AlfonsusGiovanni/Welding-Arm-Manipulator/Dokumen Perancangan/Perancangan Case Teach Pendant.docx

PERANCANGAN CASE TEACH PENDANT

ROBOT WELDING ARM MANIPULATOR 6-DOF


Dirancang Oleh :

Alfonsus Giovanni Mahendra Putra / Teknik Listrik Industri / 40040621650042

DEPARTEMEN TEKNOLOGI INDUSTRI

FAKULTAS SEKOLAH VOKASI

UNIVERSITAS DIPONEGORO

2024

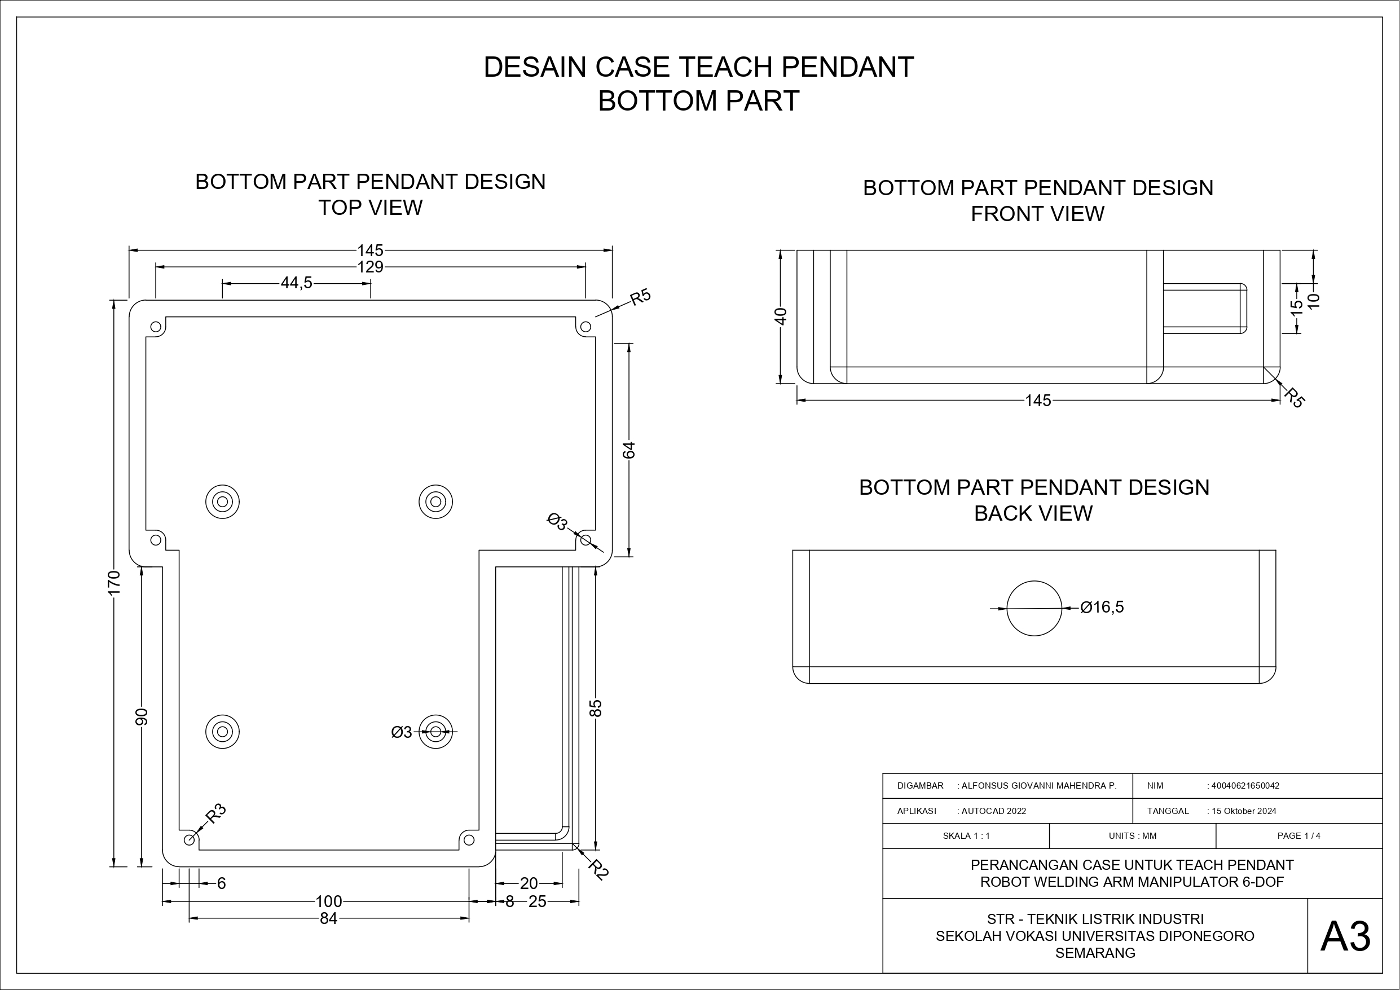
[picture p14: figure]
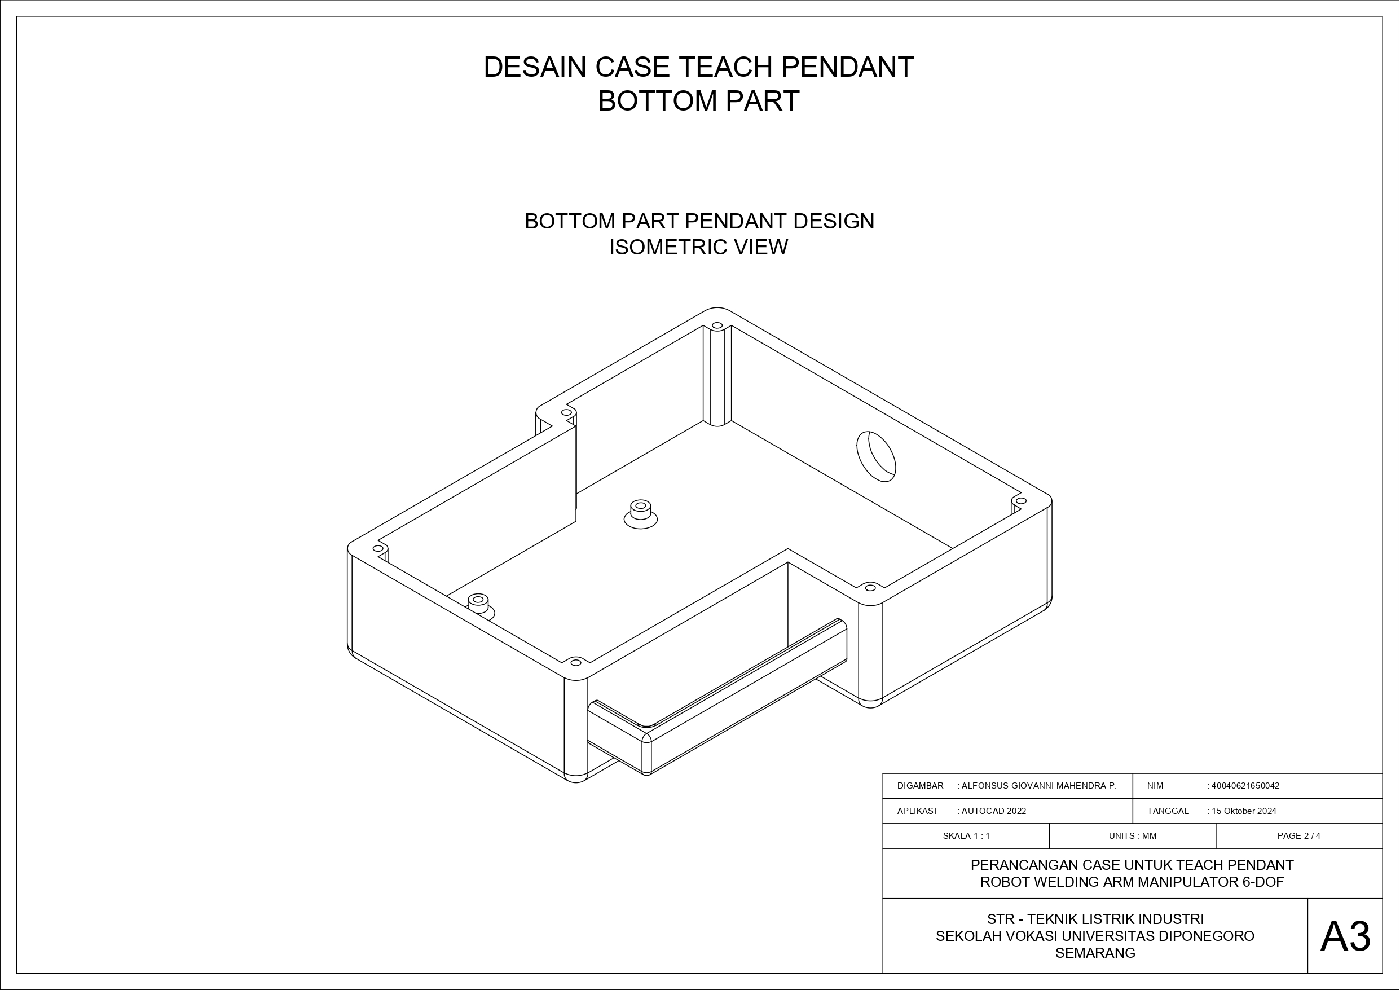
[picture p15: figure]
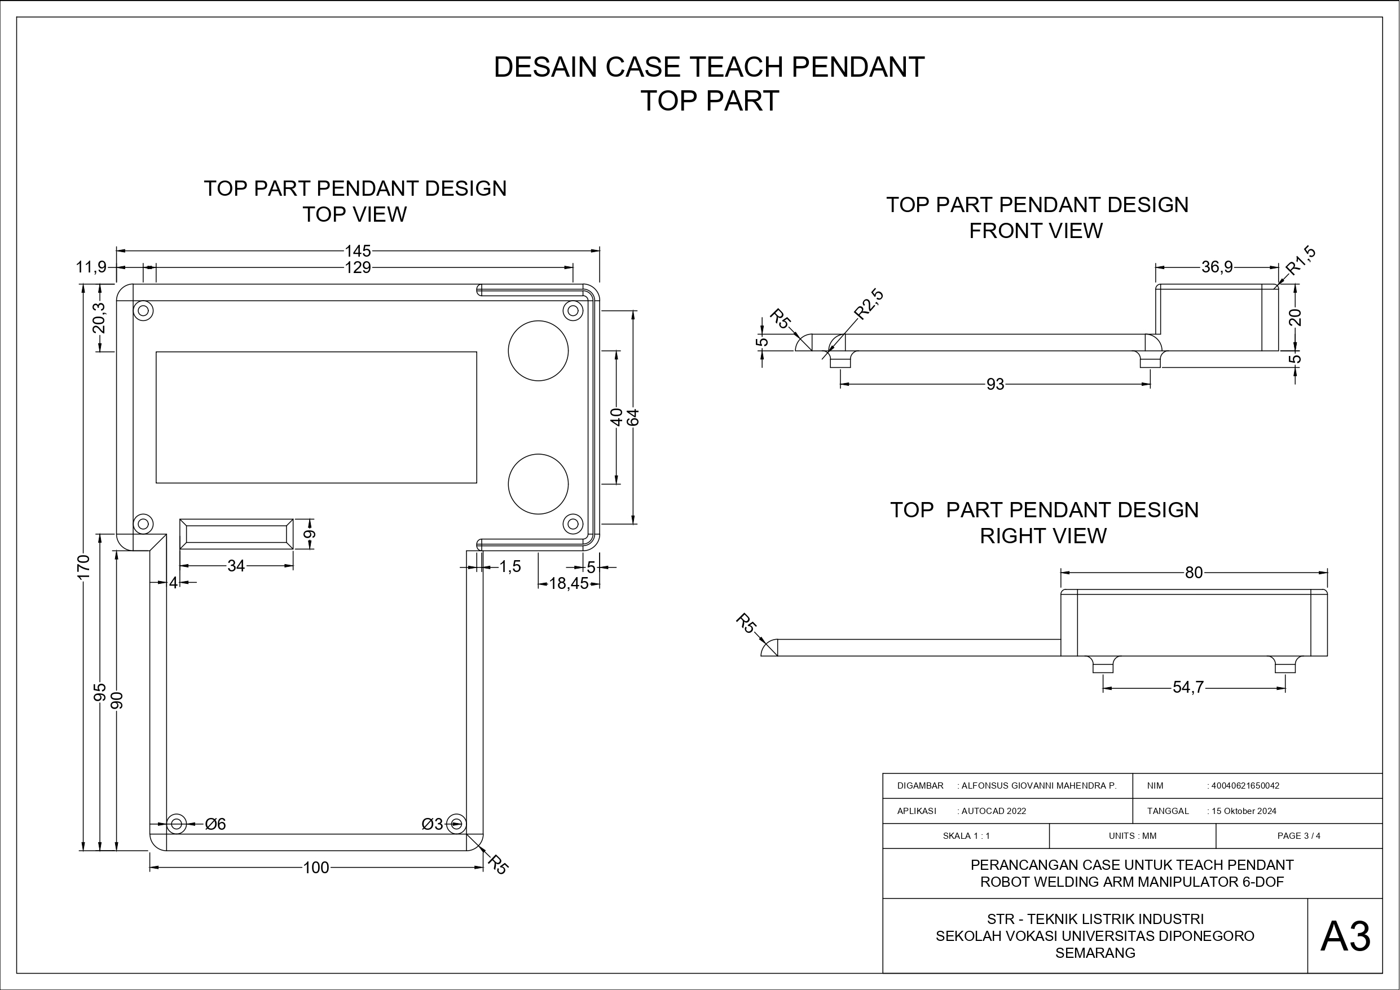
[picture p16: figure]
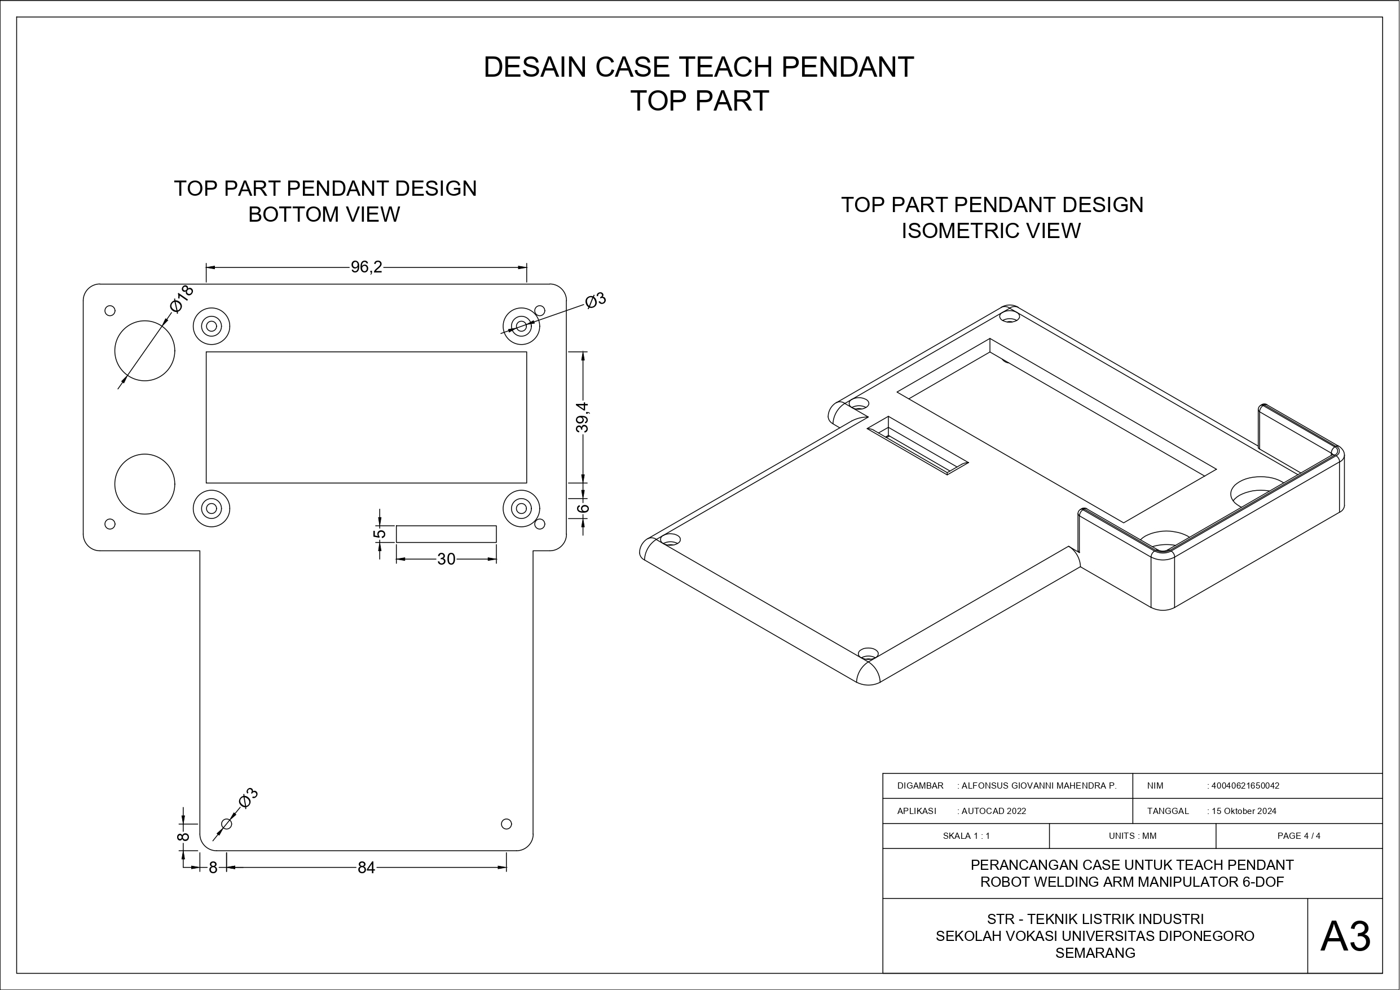
[picture p17: figure]
