AlfonsusGiovanni/Welding-Arm-Manipulator/Dokumen Perancangan/Perancangan PCB.docx

PERANCANGAN PCB

ROBOT WELDING ARM MANIPULATOR 6-DOF


Dirancang Oleh :

Alfonsus Giovanni Mahendra Putra / Teknik Listrik Industri / 40040621650042

DEPARTEMEN TEKNOLOGI INDUSTRI

FAKULTAS SEKOLAH VOKASI

UNIVERSITAS DIPONEGORO

2024

PCB KONTROLER UTAMA

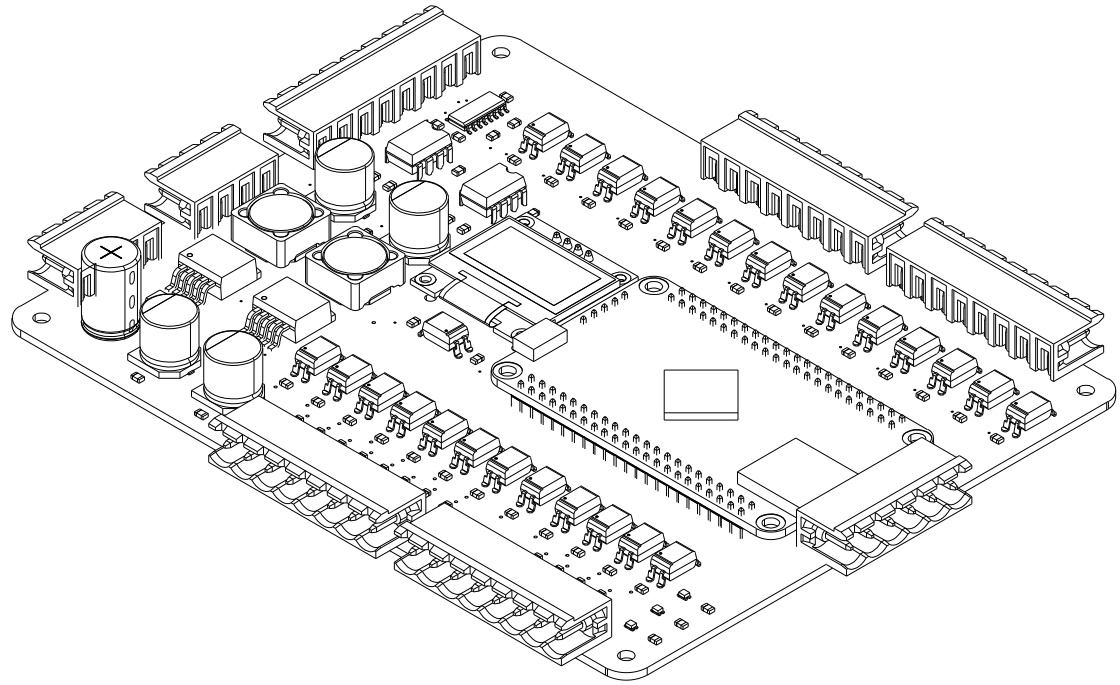
[picture p18: figure]

Spesifikasi:

2. Microcontroller STM32H743VIT6
3. 24VDC Supply
4. 5VDC and 3,3VDC Output
5. Dual Emergency Stop
6. 18 Channels Digital Input
7. 12 Channels Digital Output
8. RS-232 Communication
9. OLED LCD Interface

SCHEMATIC DIAGRAM PCB KONTROLER UTAMA

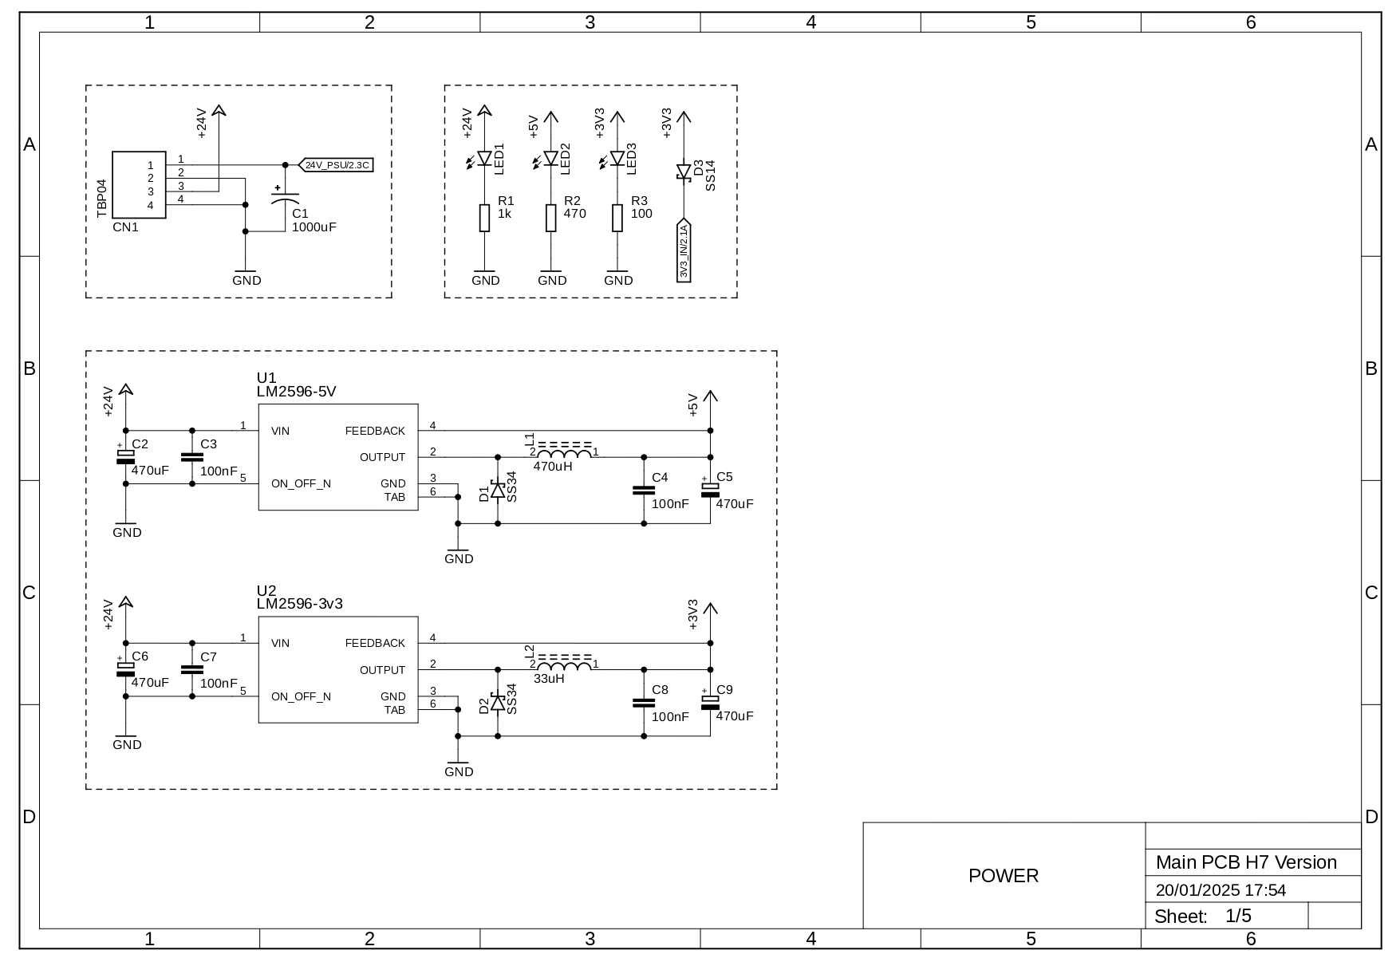
[picture p19: figure]

SCHEMATIC DIAGRAM PCB KONTROLER UTAMA

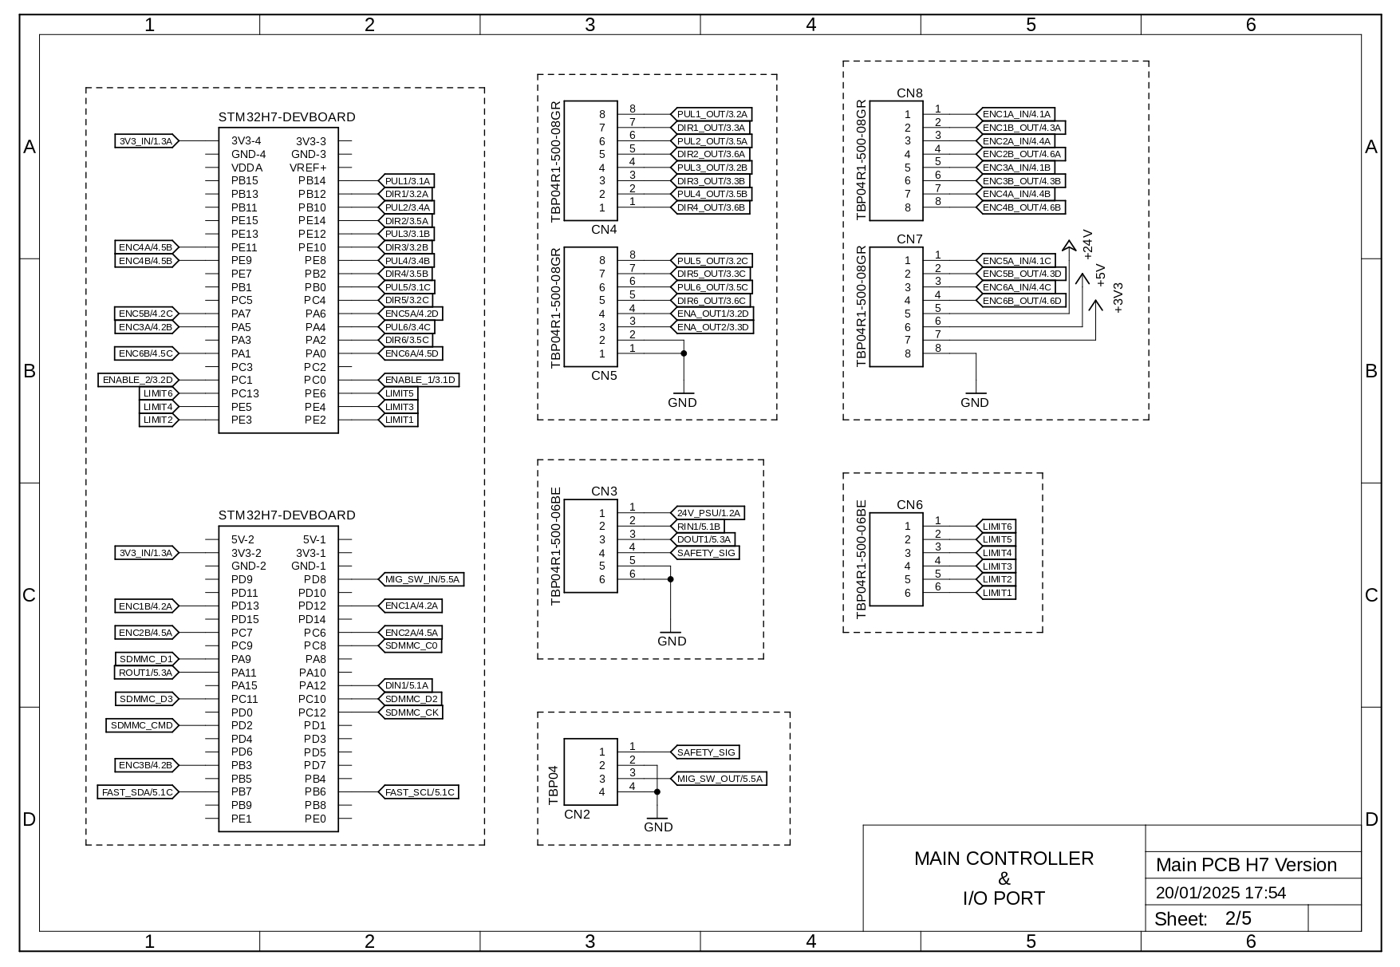
[picture p20: figure]

SCHEMATIC DIAGRAM PCB KONTROLER UTAMA

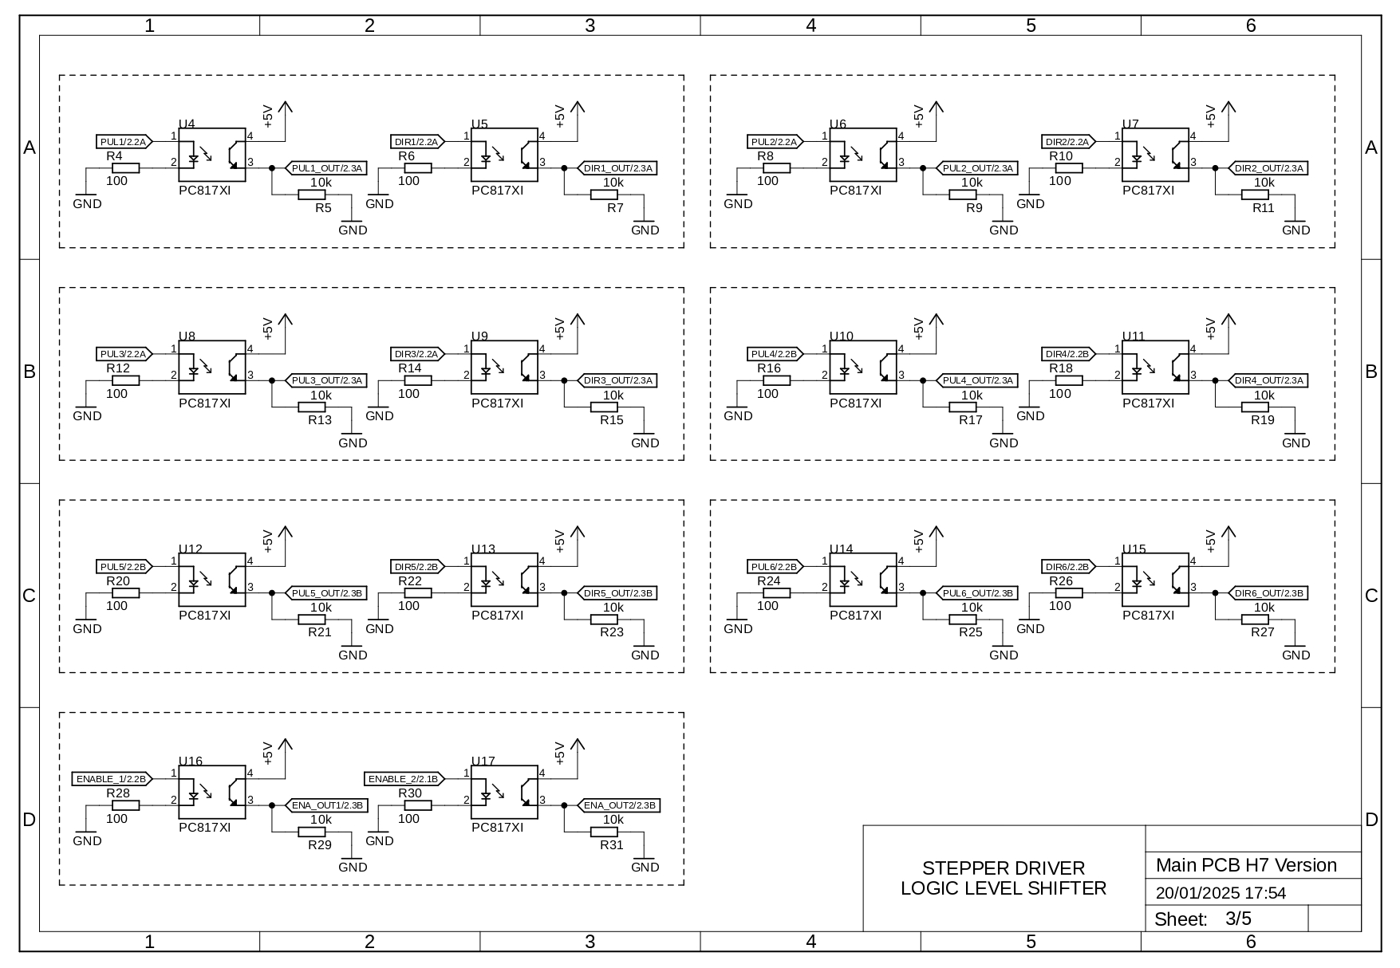
[picture p21: figure]

SCHEMATIC DIAGRAM PCB KONTROLER UTAMA

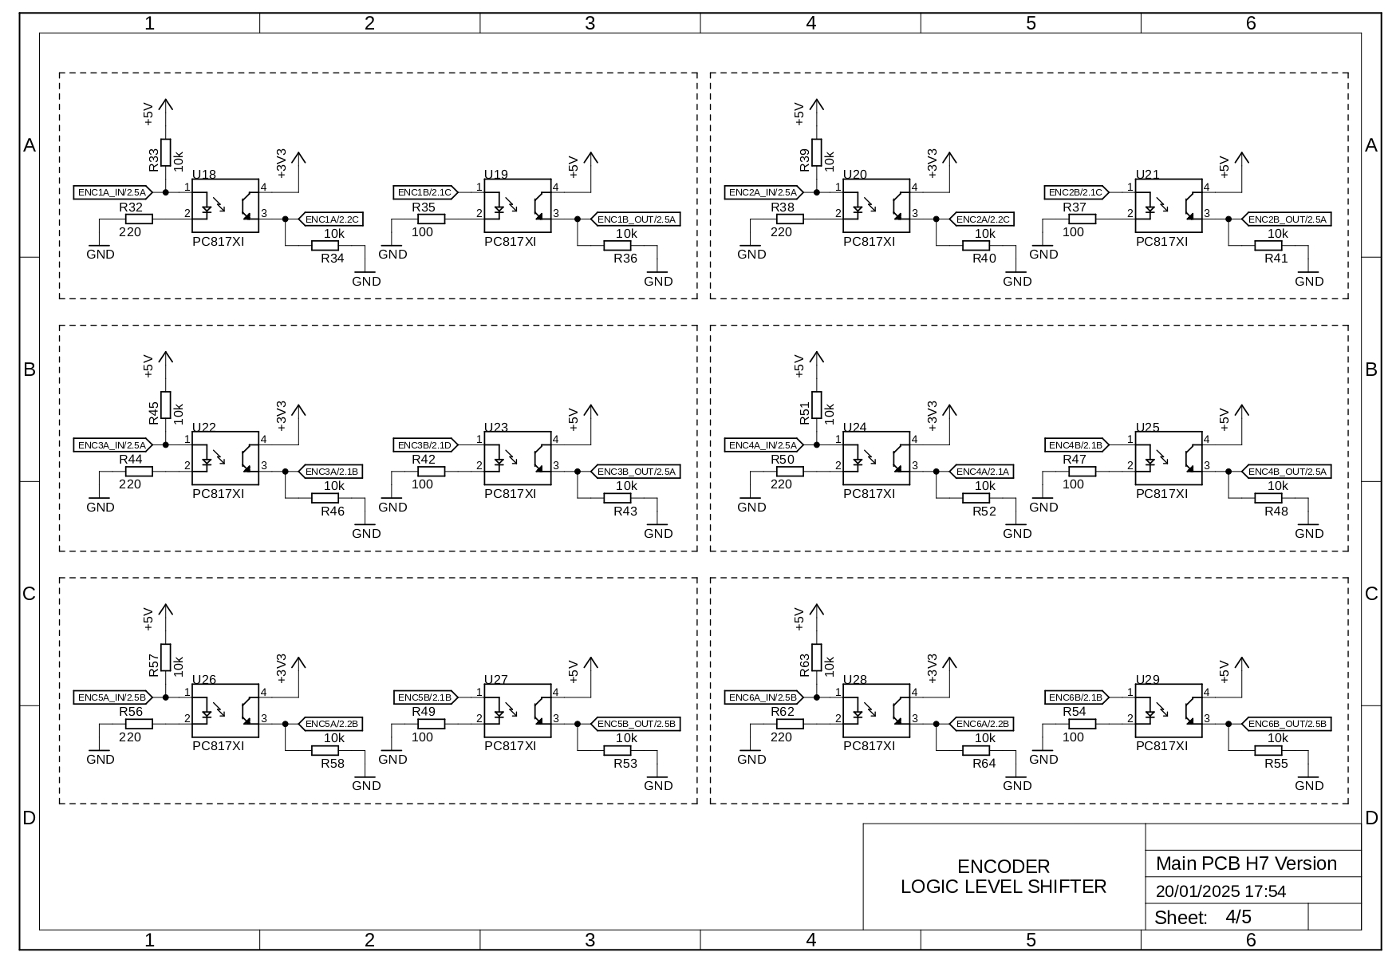
[picture p22: figure]

SCHEMATIC DIAGRAM PCB KONTROLER UTAMA

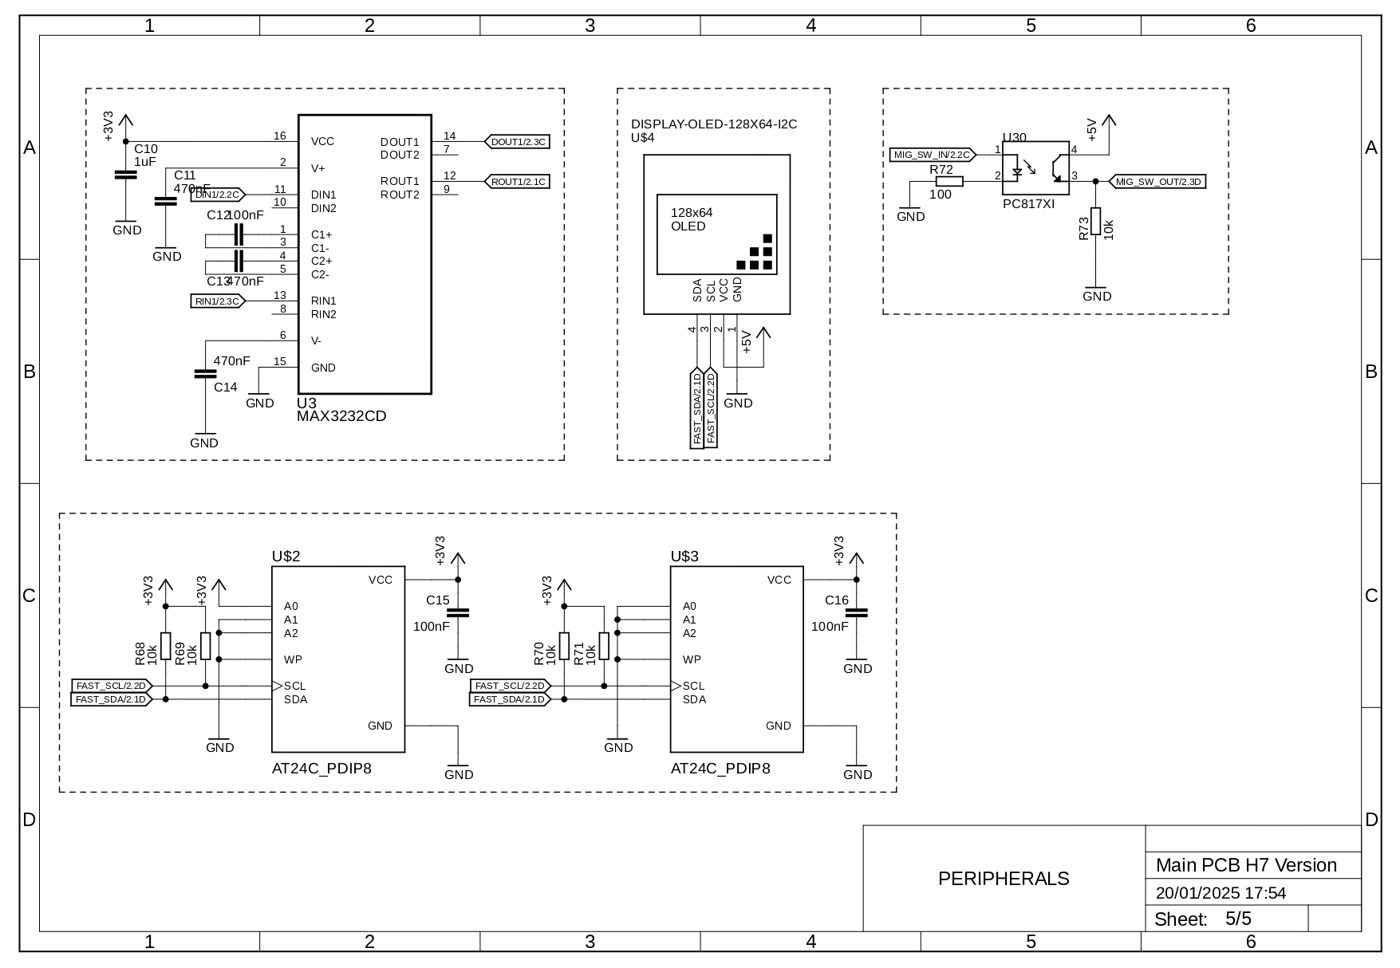
[picture p23: figure]

PCB TEACH PENDANT

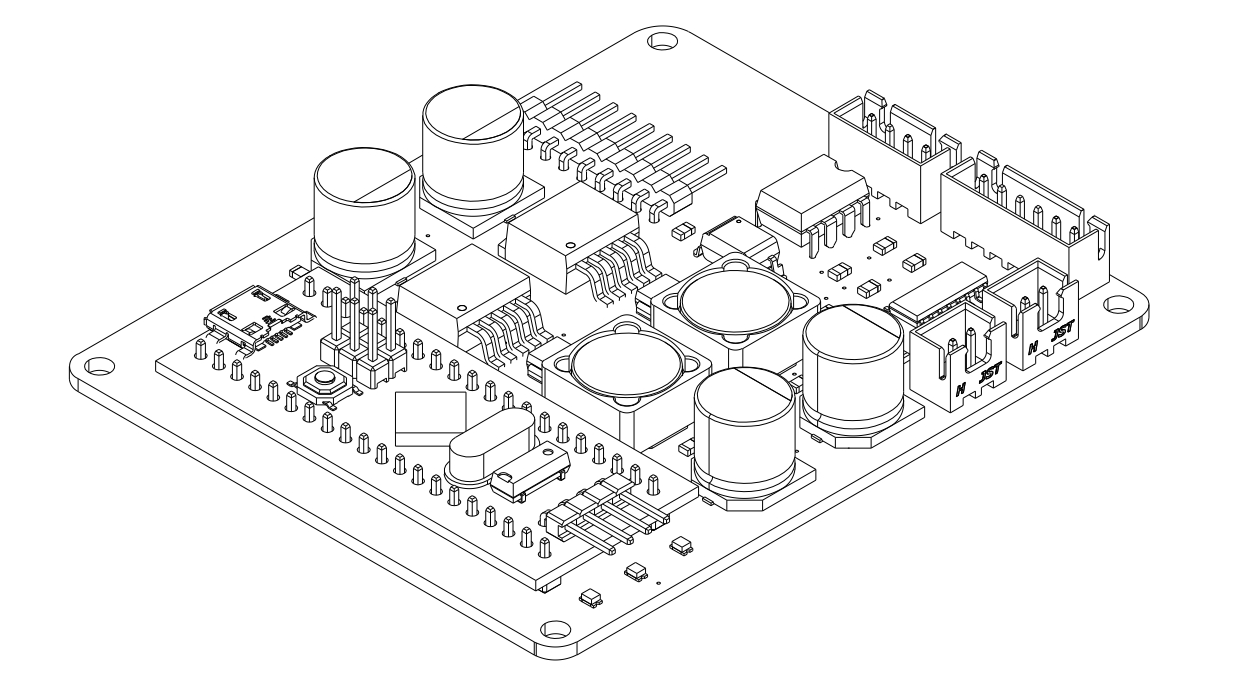
[picture p24: figure]

Spesifikasi:

1. Mikrokontroler STM32F103C8T6
2. 24VDC Supply
3. On/Off Selector Switch
4. Interface LCD 20x4
5. Keypad Matrix 5x4
6. Emergency Stop

SCHEMATIC DIAGRAM PCB TEACH PENDANT

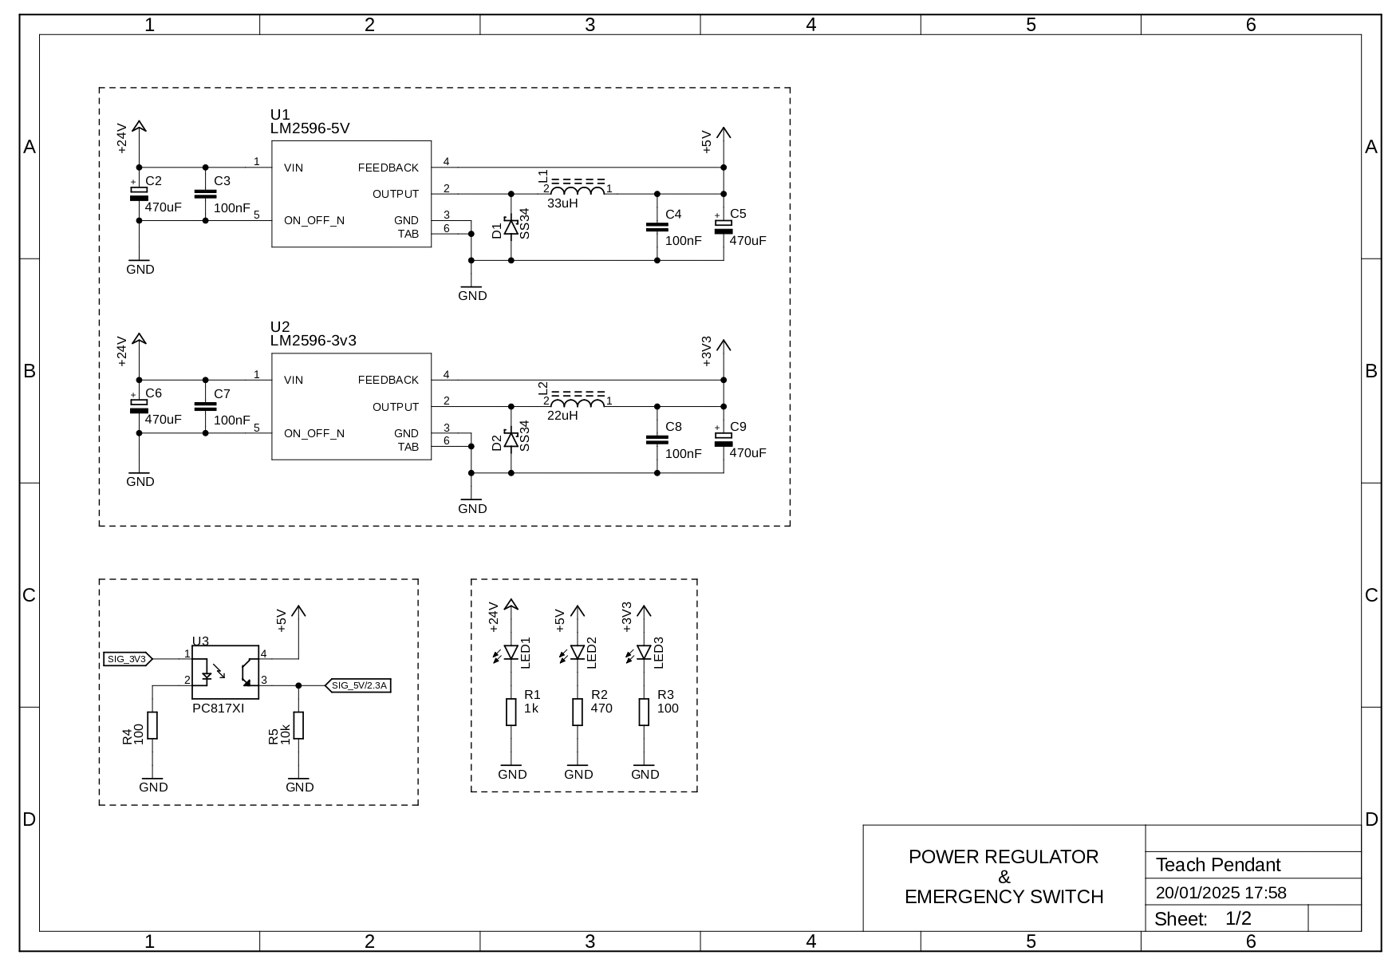
[picture p25: figure]

SCHEMATIC DIAGRAM PCB TEACH PENDANT

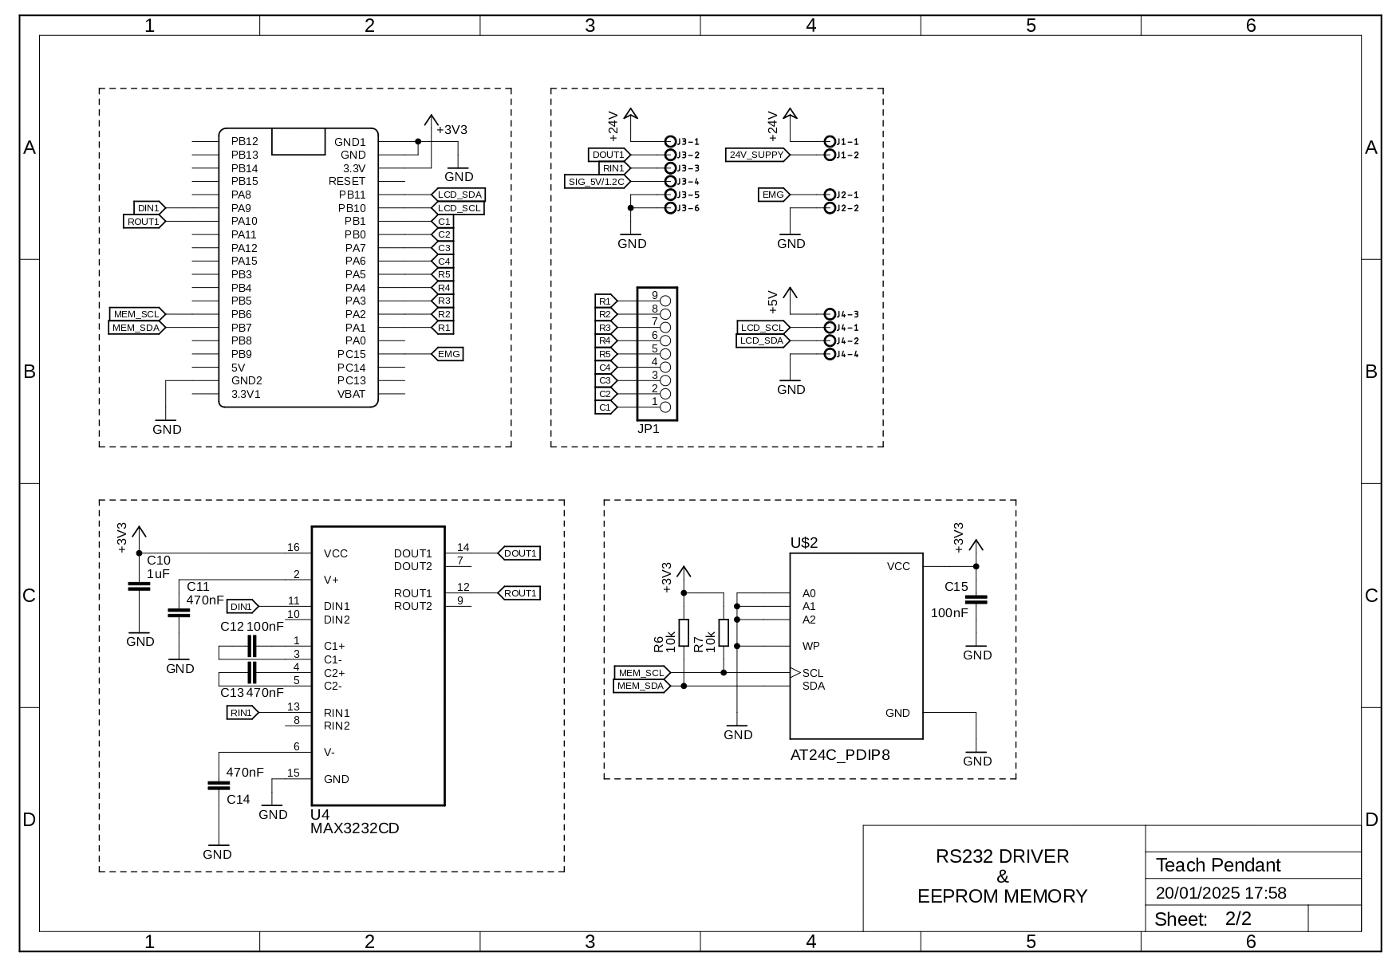
[picture p26: figure]
