AlfonsusGiovanni/Welding-Arm-Manipulator/Breakdown/Draft Perancangan/Draft Breakdown Perancangan Update.docx

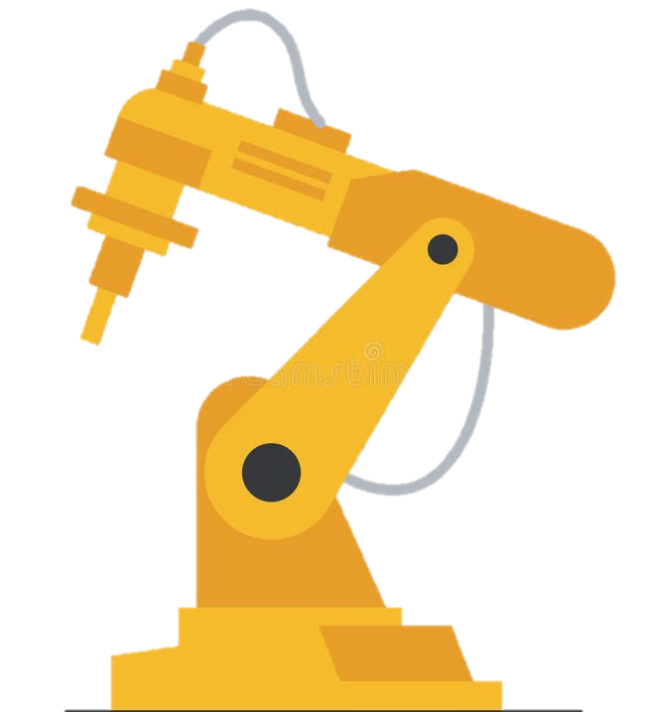
[picture p37: figure]

GENERAL DESIGN

6-DOF WELDING ARM MANIPULATOR

GENERAL DESIGN

A. Sistem Keseluruhan

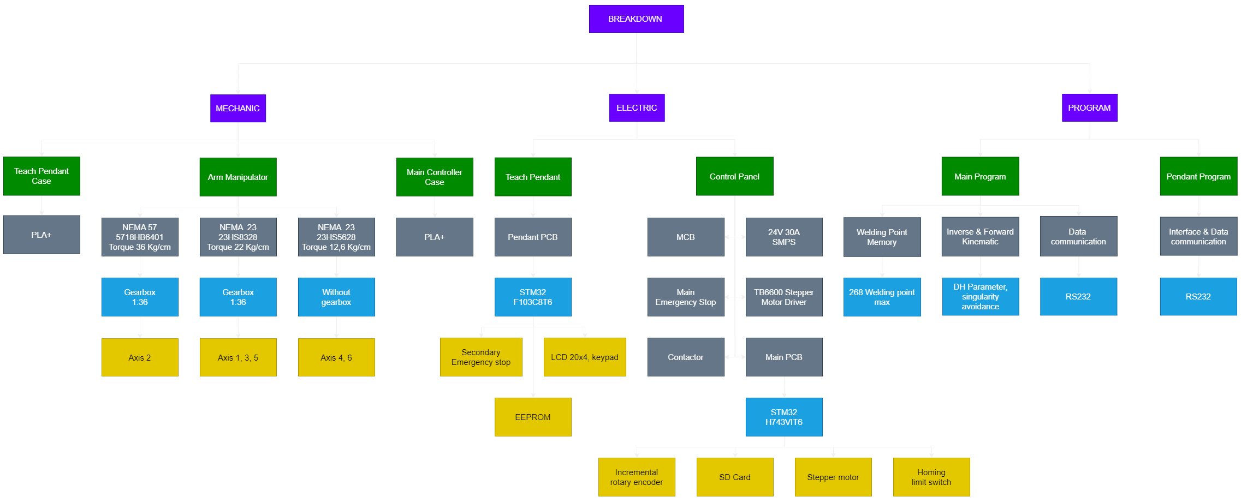
[picture p38: figure]

Welding Arm Manipulator

GENERAL DESIGN

B. Deskripsi

Robot las berbasis manipulator lengan yang memiliki 6 Degree of Freedom (DoF). Menggunakan aktuator jenis motor stepper open loop yang dikendalikan oleh motor driver TB6600. Untuk kontroler utama pada robot ini ditenagai oleh mikrokontroler STM32H743VIT6. Selain itu untuk melakukan proses pengelasan, robot ini menggunakan algoritma Point to Point mapping yang dapat dikendalikan atau dipetakan dengan menggunakan bantuan teach pendant. Robot las ini menggunakan mesin las berjenis MIG atau metal inert gas yang dapat menghasilkan pengelasan yang baik. Memiliki jarak jangkaian pengelasan maksimal hingga 1,2m.

C. Tujuan

Pembuatan robot las berbasis manipulator lengan ini memiliki tujuan antara lain:

1. Melakukan pengelasan pada base plate bak motor viar dengan jumlah titik pengelasan sebanyak 268 titik.
2. Meningkatkan efisiensi pengelasan bak motor viar
D. Spesifikasi
1. Kontroler Utama
  a. Mikrokontroler : STM32H743VIT6
  b. Aktuator : Nema motor stepper
  c. Supply power : @720Watt x 2 robot = 1,44 kW
2. Teach Pendant
  a. Mikrokontroler : STM32F103C8T6
  b. User Interface : LCD 20x4, 4x5 keypad
  c. Mapping point : 268 maks

Welding Arm Manipulator

ELECTRICAL POWER SUPPLY DESIGN

6-DOF WELDING ARM MANIPULATOR

ELECTRICAL POWER SUPPY DESIGN

A. General power supply circuit

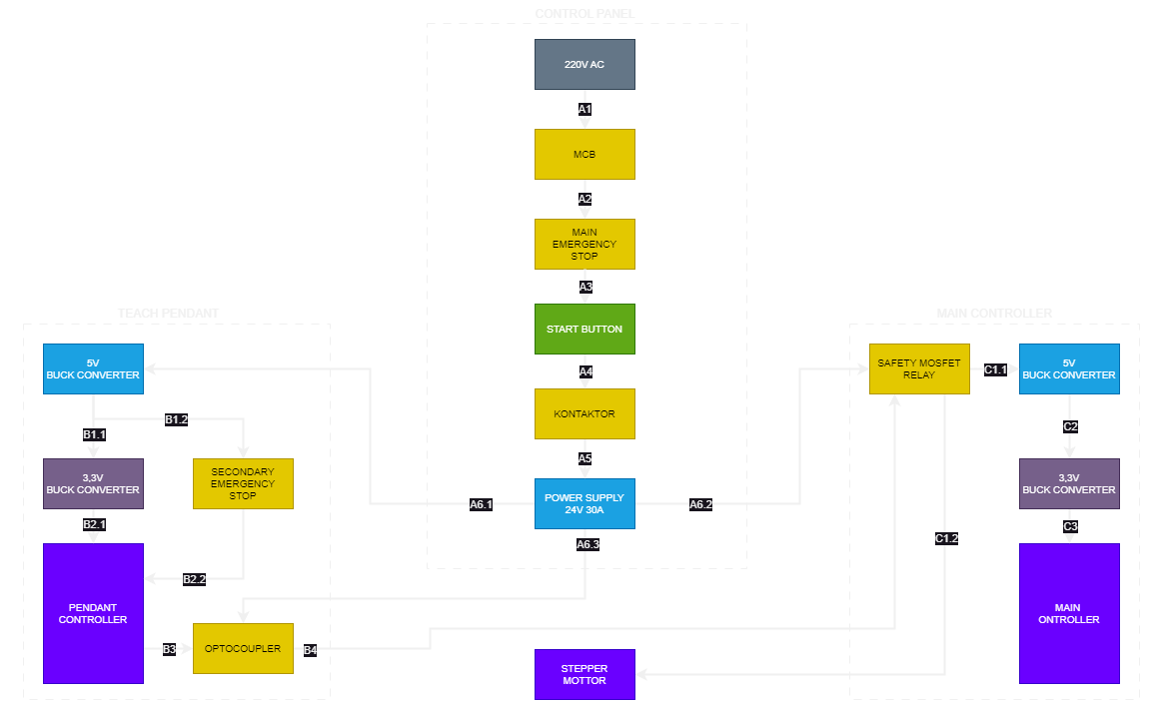
[picture p39: figure]

Welding Arm Manipulator

ELECTRICAL POWER SUPPY DESIGN

B. Control panel power supply circuit

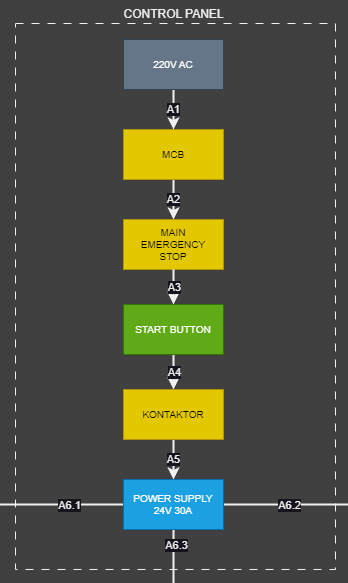
[picture p40: figure]

Keterangan

- A1 : Catu daya utama (fasa dan netral), menghubungkan listrik 220VAC ke MCB 2 Pole
- A2 : Keluaran catu daya dari MCB ke tombol emergency stop
- A3 : Keluaran catu daya dari tombol emergency stop ke tombol start
- A4 : Rangkaian DoL antara tombol mulai dengan kontaktor
- A5 : Catu daya dari kontaktor ke power supply SMPS 24V 30A
- A6.1 : Keluaran power supply 24V ke teach pendant
- A6.2 : Keluaran power supply 24V ke kontroler utama
- A6.3 : Keluaran power supply 24V ke optocoupler teach pendant

Welding Arm Manipulator

ELECTRICAL POWER SUPPY DESIGN

C. Teach pendant power supply circuit

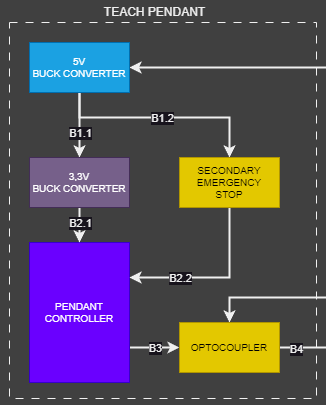
[picture p41: figure]

Keterangan

- B1.1 : Keluaran buck converter 5V ke masukan buck converter 3,3V
- B1.2 : Keluaran buck converter 5V ke tombol emergency stop pada teach pendant
- B2.1 : Keluaran buck converter 3,3V ke Vin controller teach pendant
- B2.2 : Keluaran emergency stop ke controller teach pendant sebagai signal
- B3 : Sinyal 5V ke optocoupler
- B4 : Output 24V dari optocoupler ke kontroler utama

Welding Arm Manipulator

ELECTRICAL POWER SUPPY DESIGN

D. Main controller power supply circuit

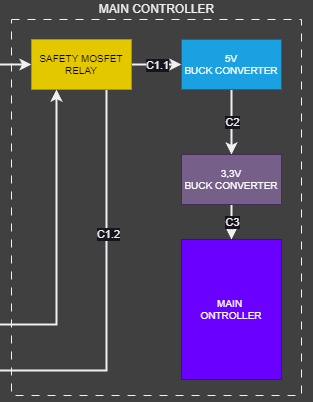
[picture p42: figure]

Keterangan

- C1.1 : Keluaran power supply 24V dari safety mosfet relay ke buck converter 5V
- C1.2 : Keluaran power supply 24V dari safety mosfet relay ke motor stepper
- C2 : Keluaran buck converter 5V ke masukan buck converter 3,3V
- C3 : Keluaran buck converter 3,3V ke Vin kontroler utama

Welding Arm Manipulator

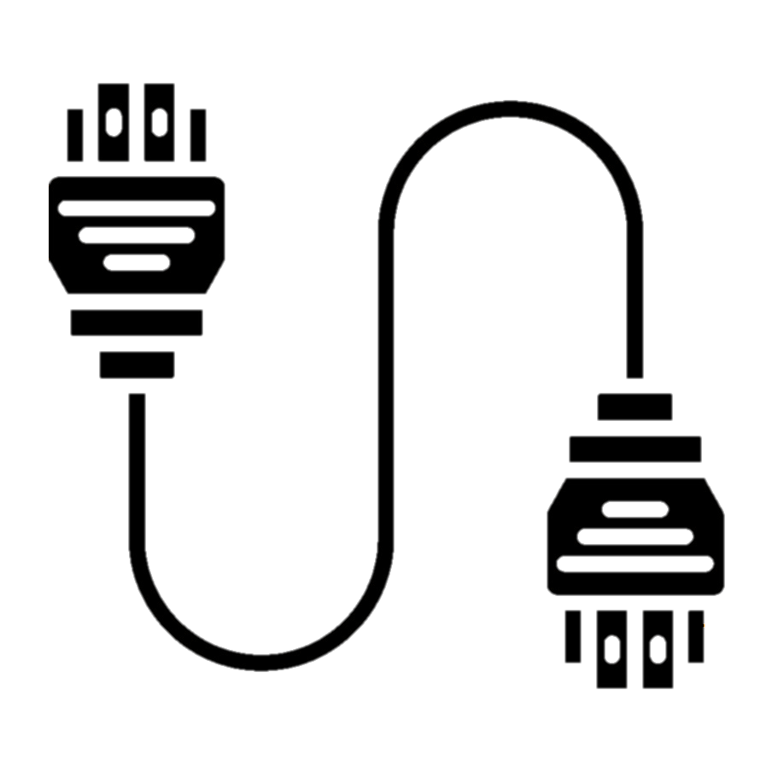
[picture p43: figure]
Cable Connector vector icon 21711818 Vector Art at Vecteezy

CABLE CONNECTOR

6-DOF WELDING ARM MANIPULATOR

CABLE CONNECTOR

A. Teach pendant - kontroler utama

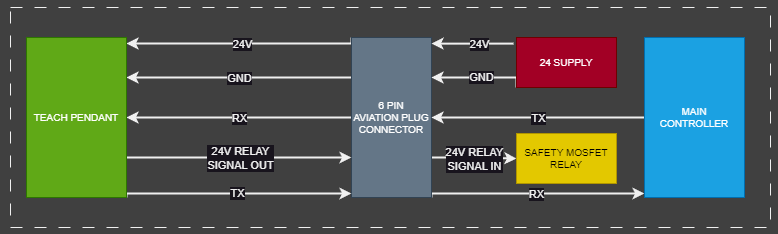
[picture p44: figure]

Keterangan

B. Limit switch – kontroler utama

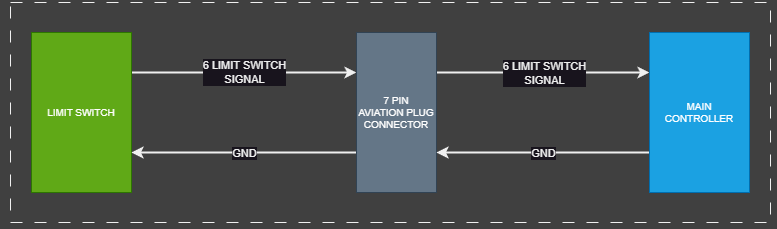
[picture p45: figure]

Keterangan

Welding Arm Manipulator

C. Stepper motor driver – stepper motor

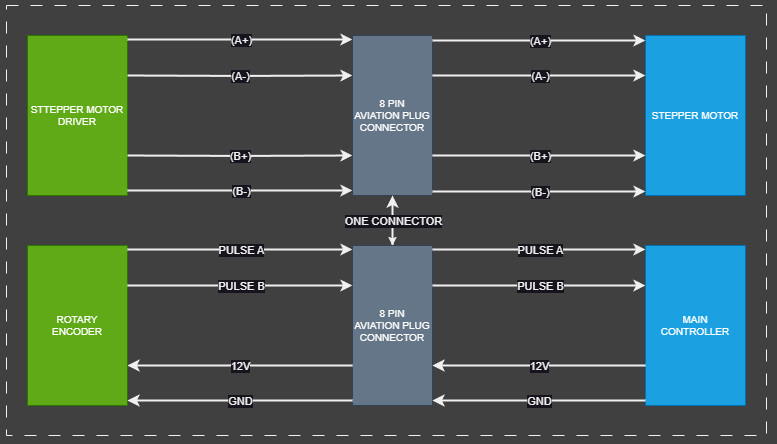
[picture p46: figure]
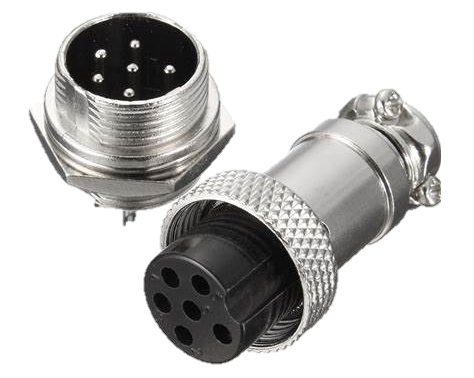
[picture p47: figure]
10 Sets GX16-6 16mm 6 Pin Male & Female Wire Panel Connector Aviation ...

Welding Arm Manipulator
