AlfonsusGiovanni/Welding-Arm-Manipulator/Overview Penelitian SCARA.pdf

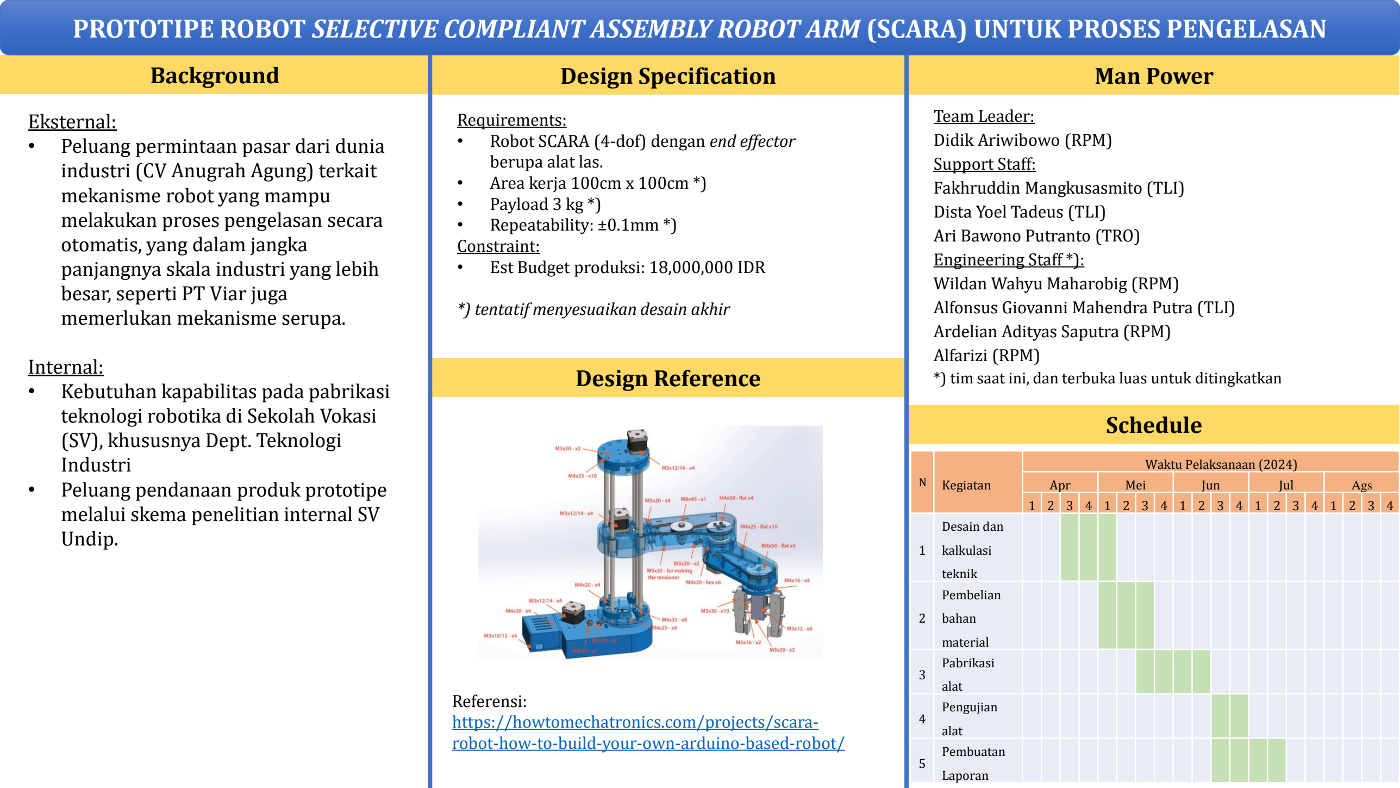
[picture p48: figure]
Design Reference; Background; Design Specification; Eksternal: • Peluang permintaan pasar dari dunia industri (CV Anugrah Agung) terkait mekanisme robot yang mampu melakukan proses pengelasan secara otomatis, yang dalam jangka panjangnya skala industri yang lebih besar, seperti PT Viar juga memerlukan mekanisme serupa.; Internal: • Kebutuhan kapabilitas pada pabrikasi teknologi robotika di Sekolah Vokasi (SV), khususnya Dept. Teknologi Industri • Peluang pendanaan produk prototipe melalui skema penelitian internal SV Undip.; Requirements:; berupa alat las. • Area kerja 100cm x 100cm *) • Payload 3 kg *) • Repeatability: ±0.1mm *) Constraint: • Est Budget produksi: 18,000,000 IDR; *) tentatif menyesuaikan desain akhir; Referensi: https://howtomechatronics.com/projects/scara- robot-how-to-build-your-own-arduino-based-robot/; Man Power; Team Leader: Didik Ariwibowo (RPM) Support Staff: Fakhruddin Mangkusasmito (TLI) Dista Yoel Tadeus (TLI) Ari Bawono Putranto (TRO) Engineering Staff *): Wildan Wahyu Maharobig (RPM) Alfonsus Giovanni Mahendra Putra (TLI) Ardelian Adityas Saputra (RPM) Alfarizi (RPM); Kegiatan; Waktu Pelaksanaan (2024); Apr; Mei; Jun; Jul; Ags; Desain dan kalkulasi teknik; Pembelian bahan material; Pabrikasi alat; Pengujian alat; Pembuatan Laporan; Schedule

## PROTOTIPE ROBOT SELECTIVE COMPLIANT ASSEMBLY ROBOT ARM (SCARA) UNTUK PROSES PENGELASAN

- Robot SCARA (4-dof) dengan end effector

*) tim saat ini, dan terbuka luas untuk ditingkatkan
