AlfonsusGiovanni/Welding-Arm-Manipulator/3D Design/Main PCB/Main Controller 3D - Isometric.pdf

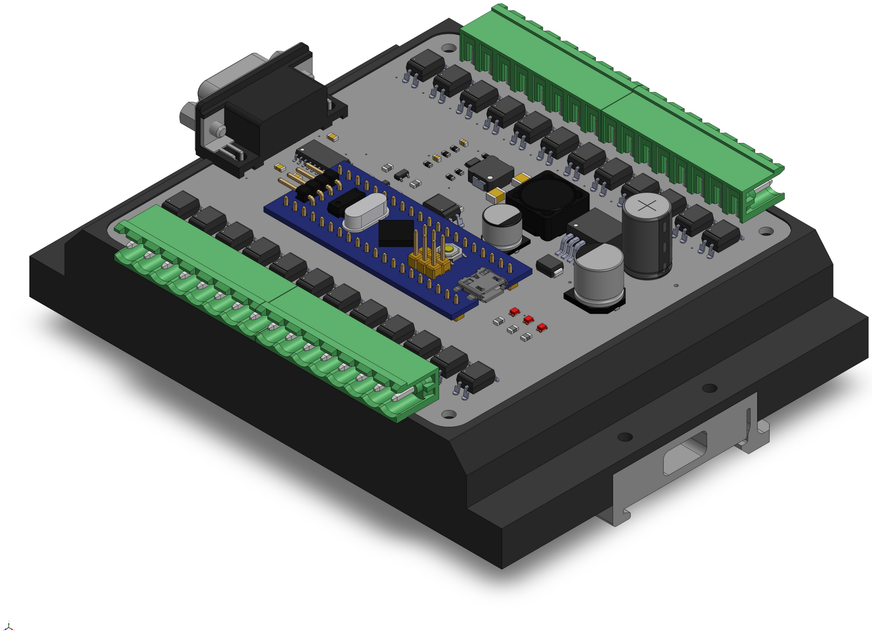
[picture p49: page 1]
