AlfonsusGiovanni/Welding-Arm-Manipulator/3D Design/Secondary PCB/Extender Port 3D - Isometric.pdf

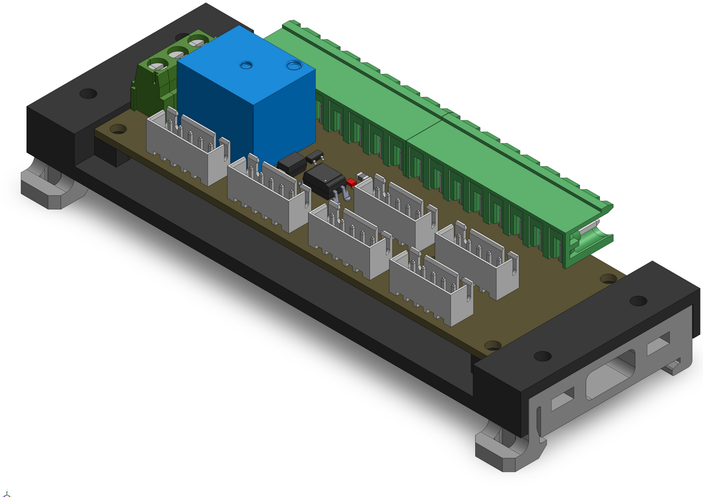
[picture p50: page 1]
