AlfonsusGiovanni/Welding-Arm-Manipulator/Schematic & PCB Design/Secondary PCB/Secondary PCB - Isometric View.pdf

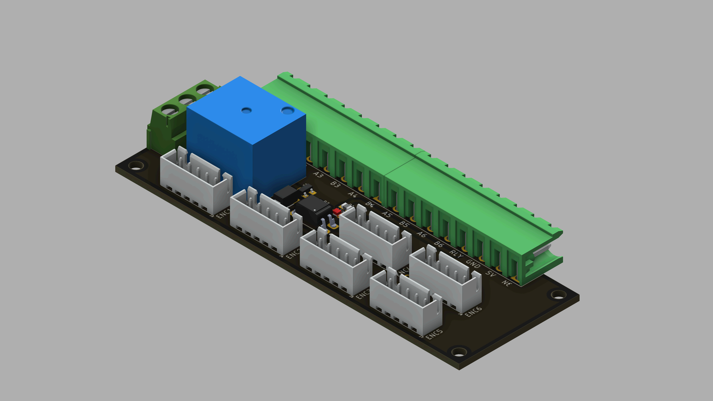
[picture p51: page 1]
