AlfonsusGiovanni/Welding-Arm-Manipulator/Schematic & PCB Design/Secondary PCB/Secondary PCB - Top View.pdf

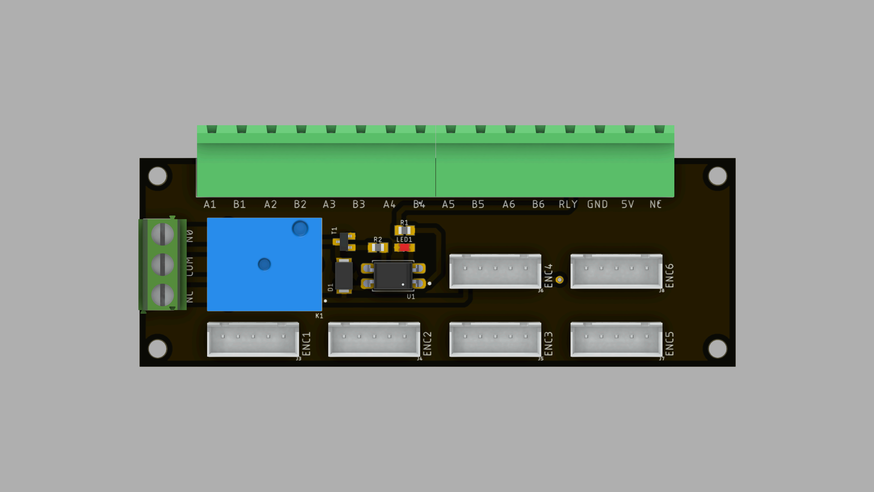
[picture p52: page 1]
