AlfonsusGiovanni/Welding-Arm-Manipulator/Referensi/AR4 6DOF Manipulator/AR4-MK3 kinematic model (standard DH).xlsm

Sheet: Sheet1
FORWARD KINAMATICS |  |  |  |  |  |  |  |  |  | INVERSE KINAMATICS
 | IN |  |  | OUT |  |  |  |  |  |  |  | IN |  | OUT
 | degrees | radians |  | degrees | radians | * excell uses wrong order for atan2 - note the order is (y,x) instead of the correct formula (x.y)
J1 * ( -170 / 170 ) | 0.000 | 0.000 | X | 327.830 |  |  |  |  |  |  | X | 327.830 | J1 | -5.062234991e-16
J2 * ( -42 / 90 ) | 0.000 | 0.000 | Y | -2.534219579e-15 |  |  |  |  |  |  | Y | -2.534219579e-15 | J2 | 1.421085472e-14
J3 * ( -89 / 52 ) | 0.000 | 0.000 | Z | 474.770 |  |  |  |  |  |  | Z | 474.770 | J3 | 0.000
J4 * ( -165 / 165 ) | 0.000 | 0.000 | Rz | 45.000 | 0.785 |  |  |  |  |  | Rz | 45.000 | J4 | 14.405
J5 * ( -105 / 105 ) | 0.000 | 0.000 | Ry | 90.000 | 1.571 |  |  |  |  |  | Ry | 90.000 | J5 | 0.000
J6 * ( -155 / 155 ) | 0.000 | 0.000 | Rx | 45.000 | 0.785 |  |  |  |  |  | Rx | 45.000 | J6 | -14.405
DH params
joint | Θ | α | d | a |  |  |  |  | TOOL FRAME |  | CALC WRIST CENTER - FIND J1 ANGLE |  |  |  | R0-5 @ J1 ZERO |  | USE J1,J2,J3 ANGLES TO FIND J3 ORENTATION
1.000 | 0.000 | -1.571 | 169.770 | 64.200 |  |  |  | X | 0.000 |  | R 0-6(T) reverse kin ZYX |  |  |  | X | Y | J1
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
