AlfonsusGiovanni/Welding-Arm-Manipulator/2D Design/Box Panel Kontrol/JPEG/Box Panel TA-Overview_page-0001.jpg

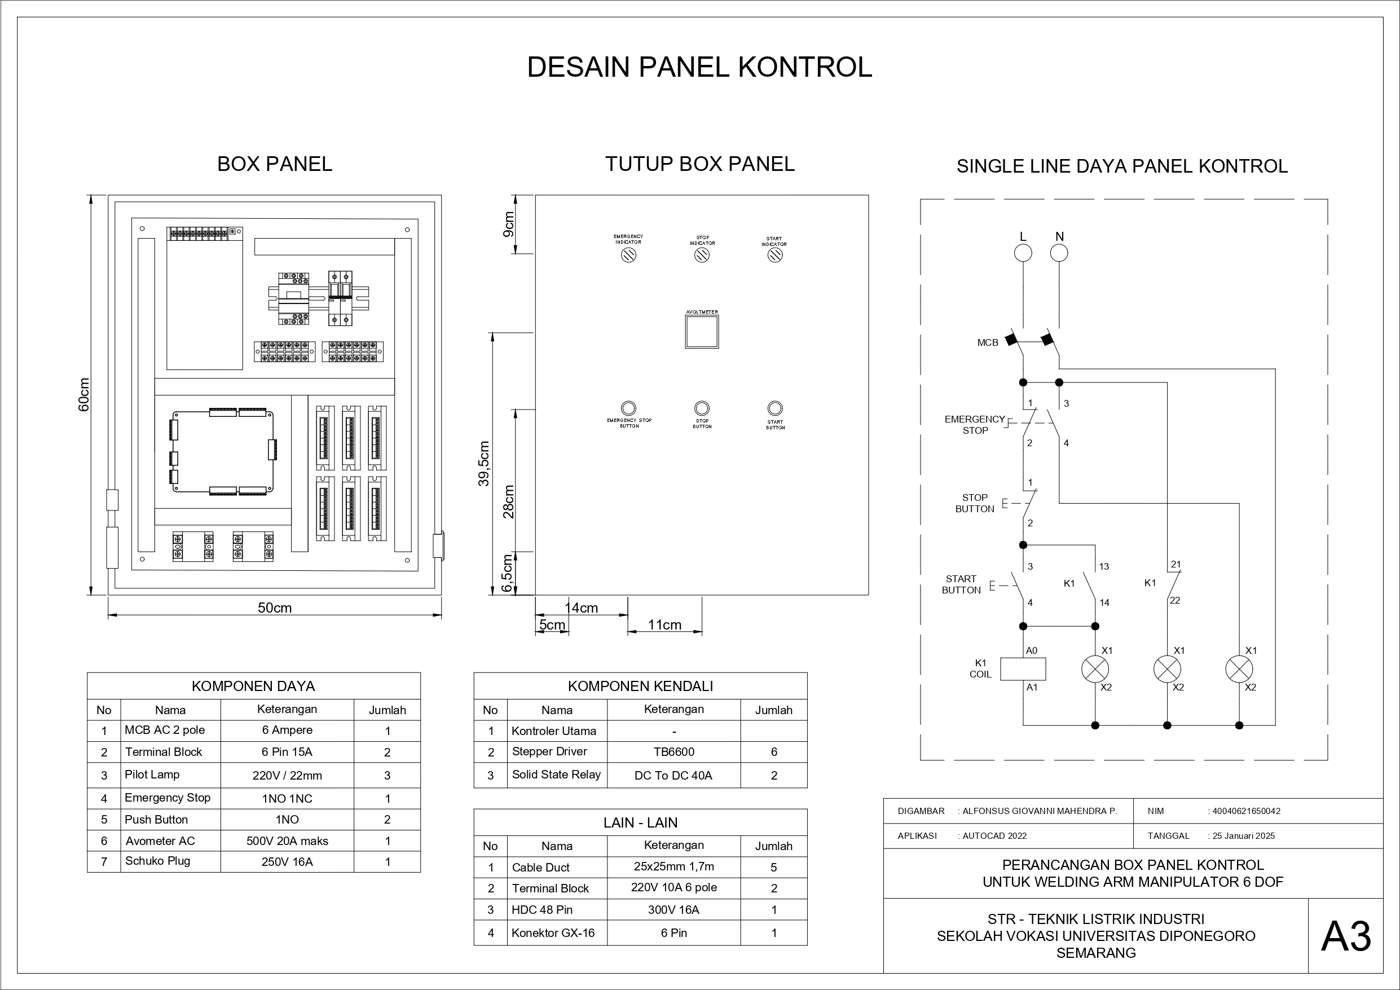
2D Design/Box Panel Kontrol/JPEG/Box Panel TA-Overview_page-0001.jpg
