AlfonsusGiovanni/Welding-Arm-Manipulator/2D Design/Main PCB/JPEG/Main PCB Connectors Names.jpg

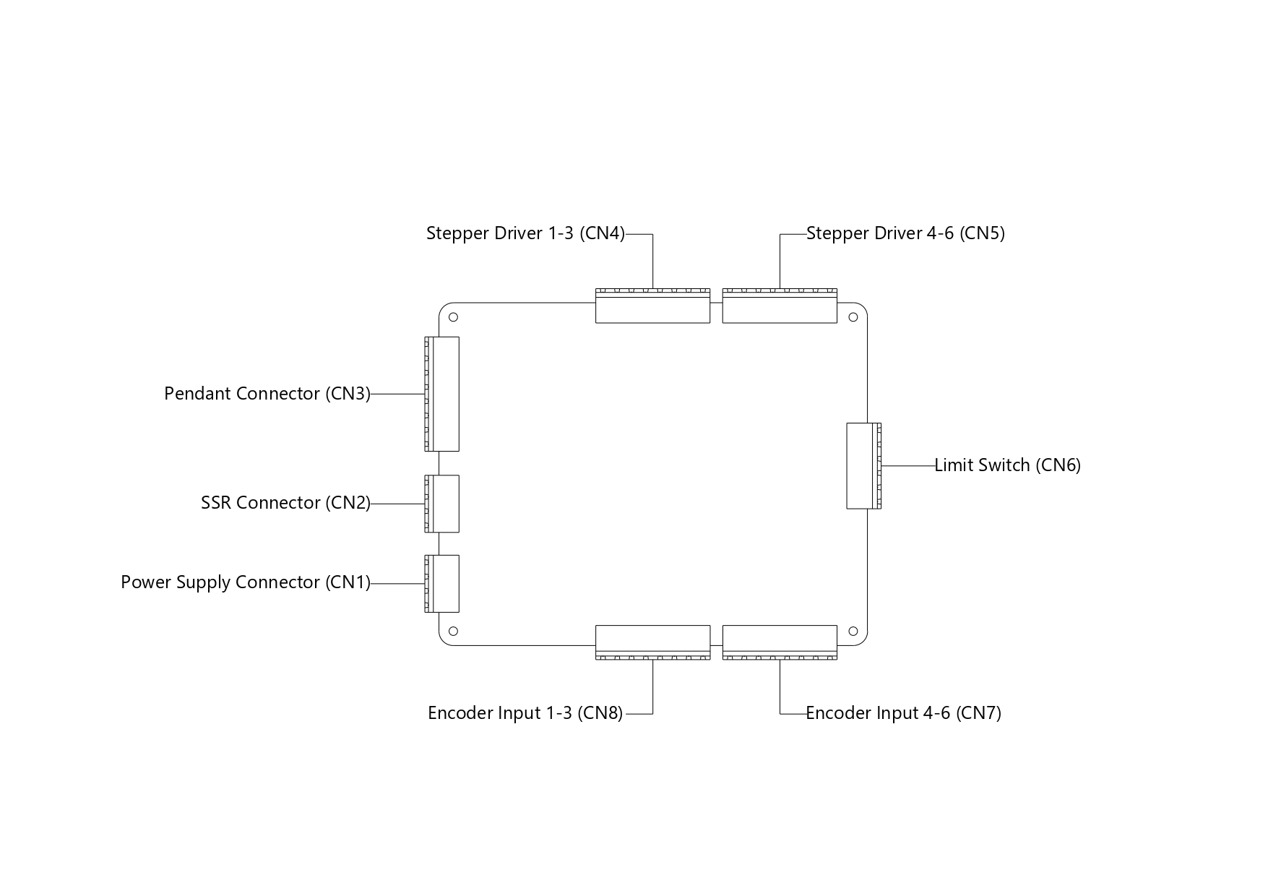
2D Design/Main PCB/JPEG/Main PCB Connectors Names.jpg
