AlfonsusGiovanni/Welding-Arm-Manipulator/2D Design/Main PCB/JPEG/Main PCB Isometric Preview.jpg

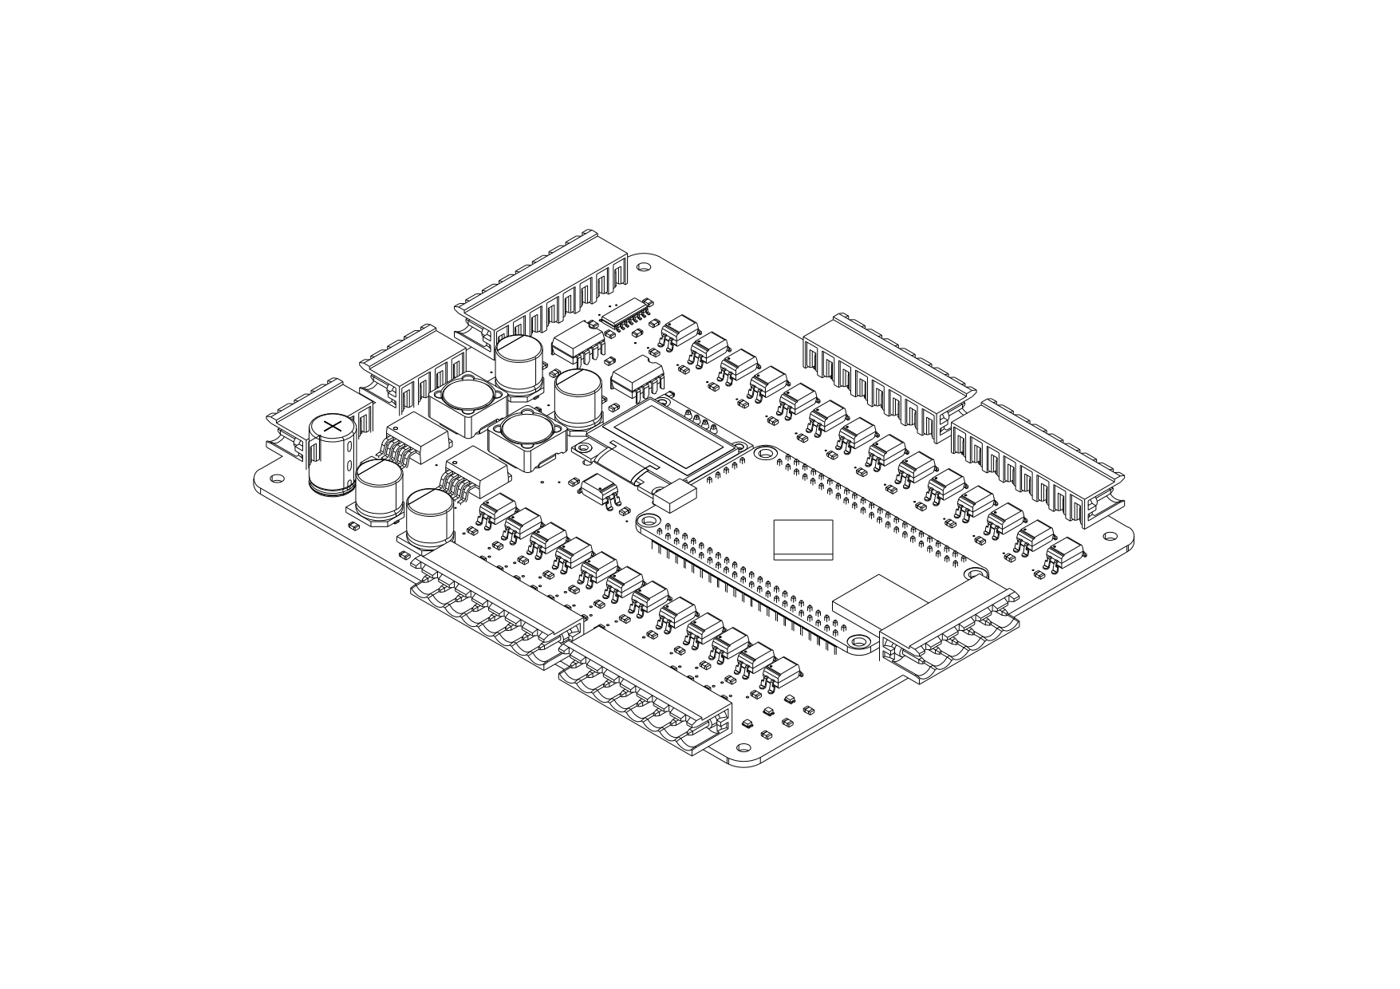
2D Design/Main PCB/JPEG/Main PCB Isometric Preview.jpg
