AlfonsusGiovanni/Welding-Arm-Manipulator/2D Design/Pendant PCB/JPEG/Pendant PCB Connectors Names.jpg

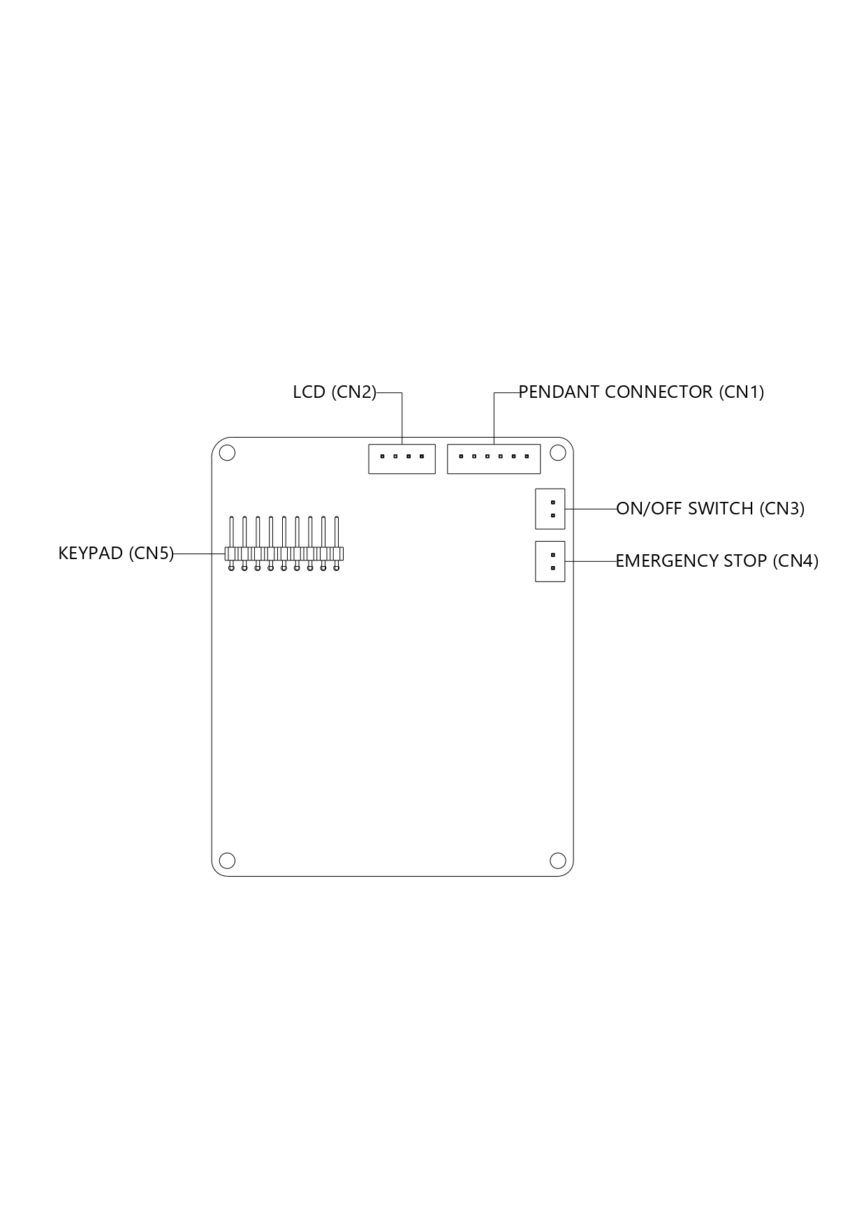
2D Design/Pendant PCB/JPEG/Pendant PCB Connectors Names.jpg
