AlfonsusGiovanni/Welding-Arm-Manipulator/2D Design/Pendant PCB/JPEG/Pendant PCB Isometric Preview.jpg

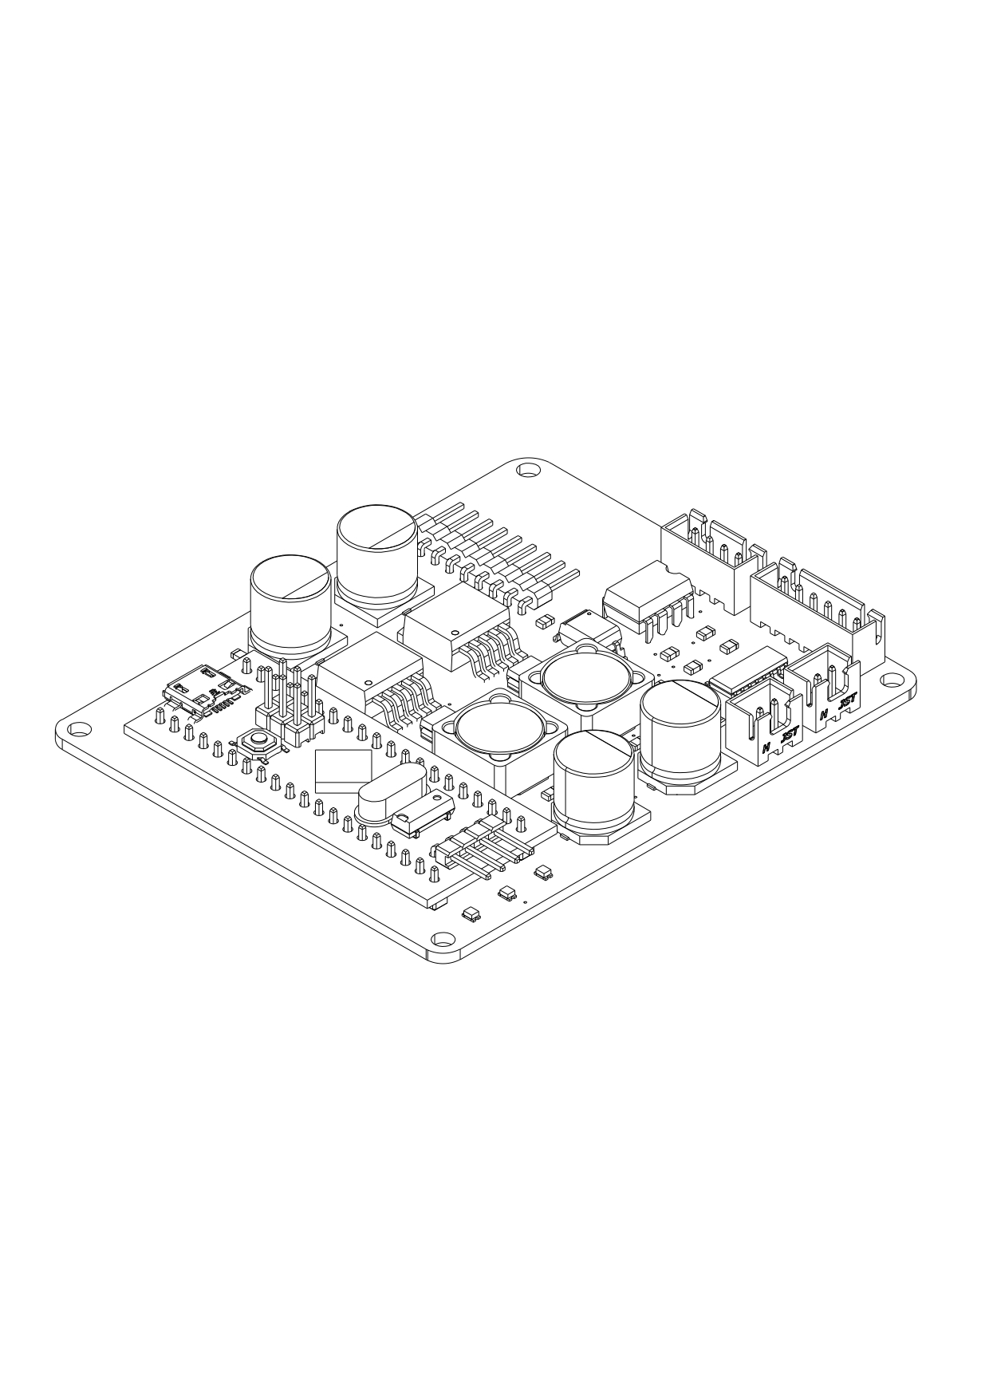
2D Design/Pendant PCB/JPEG/Pendant PCB Isometric Preview.jpg
