AlfonsusGiovanni/Welding-Arm-Manipulator/3D Design/Arm/Part Picture/Part 2.png

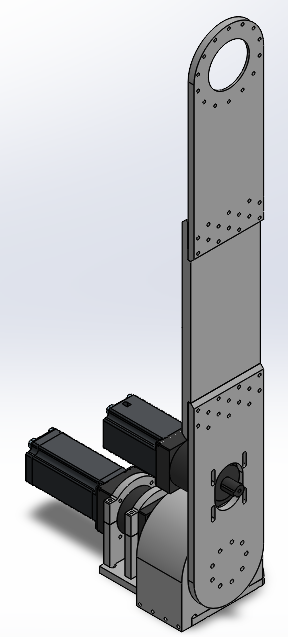
3D Design/Arm/Part Picture/Part 2.png
