AlfonsusGiovanni/Welding-Arm-Manipulator/3D Design/Arm/Part Picture/Part 3.png

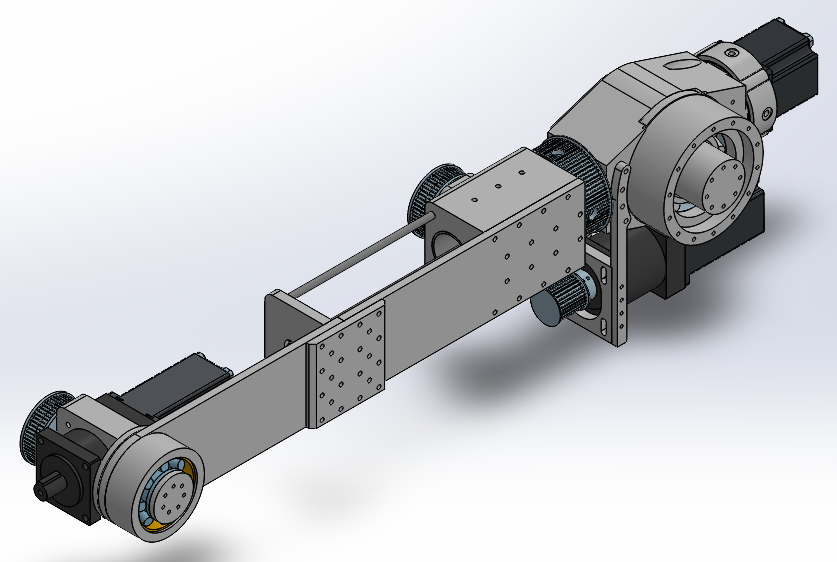
3D Design/Arm/Part Picture/Part 3.png
