AlfonsusGiovanni/Welding-Arm-Manipulator/3D Design/Main PCB/3D Design View/Main PCB Isometric View - PNG.png

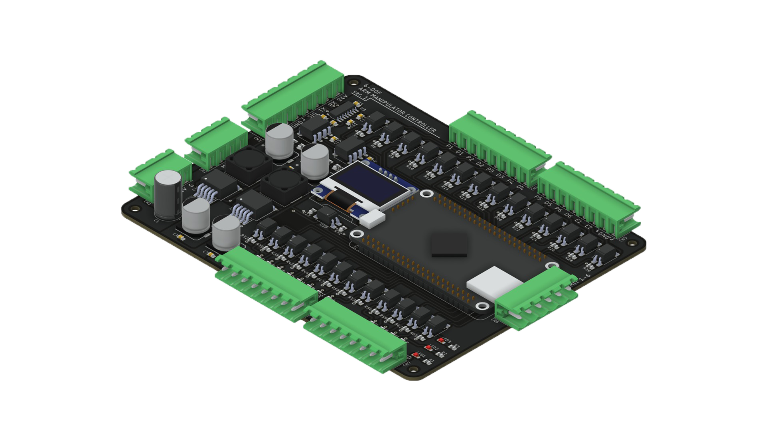
3D Design/Main PCB/3D Design View/Main PCB Isometric View - PNG.png
