AlfonsusGiovanni/Welding-Arm-Manipulator/3D Design/Main PCB/Main Controller 3D - Isometric_page-0001.jpg

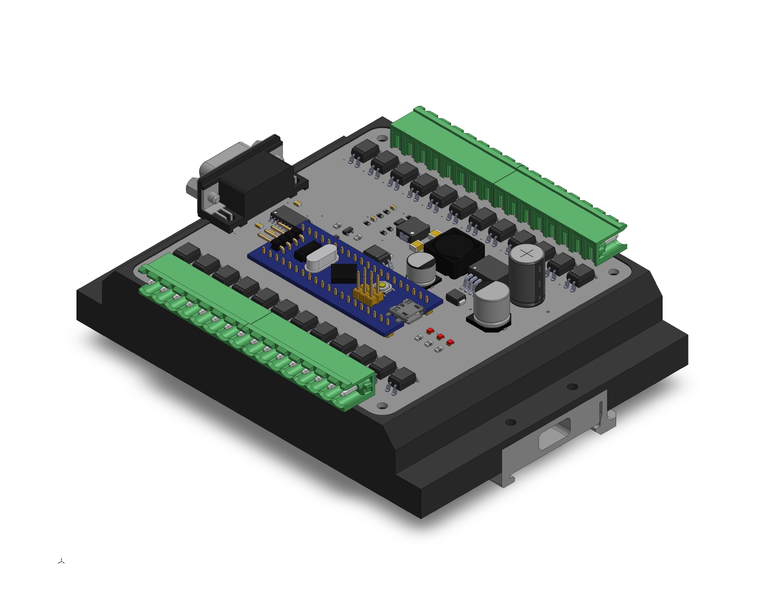
3D Design/Main PCB/Main Controller 3D - Isometric_page-0001.jpg
