AlfonsusGiovanni/Welding-Arm-Manipulator/3D Design/Pendant PCB/3D Design View/Teach Pendant Isometric View - PNG.png

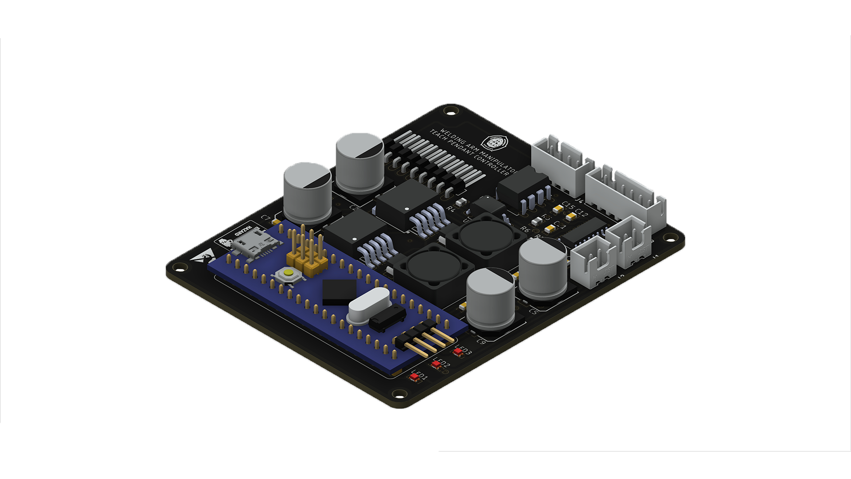
3D Design/Pendant PCB/3D Design View/Teach Pendant Isometric View - PNG.png
