AlfonsusGiovanni/Welding-Arm-Manipulator/3D Design/Pendant PCB/3D Design View/Teach Pendant Top View - PNG.png

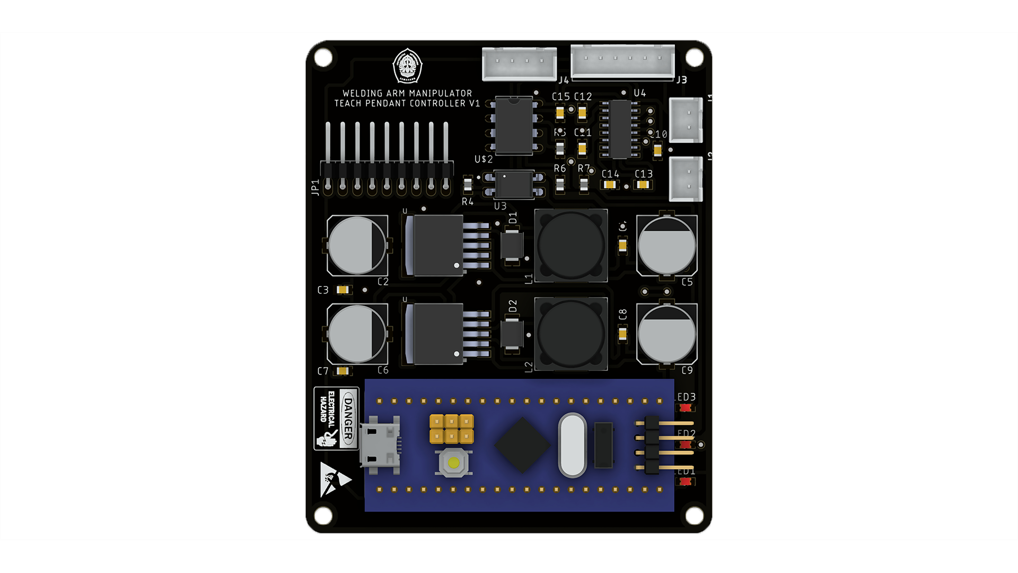
3D Design/Pendant PCB/3D Design View/Teach Pendant Top View - PNG.png
