AlfonsusGiovanni/Welding-Arm-Manipulator/3D Design/Secondary PCB/Extender Port 3D - Isometric_page-0001.jpg

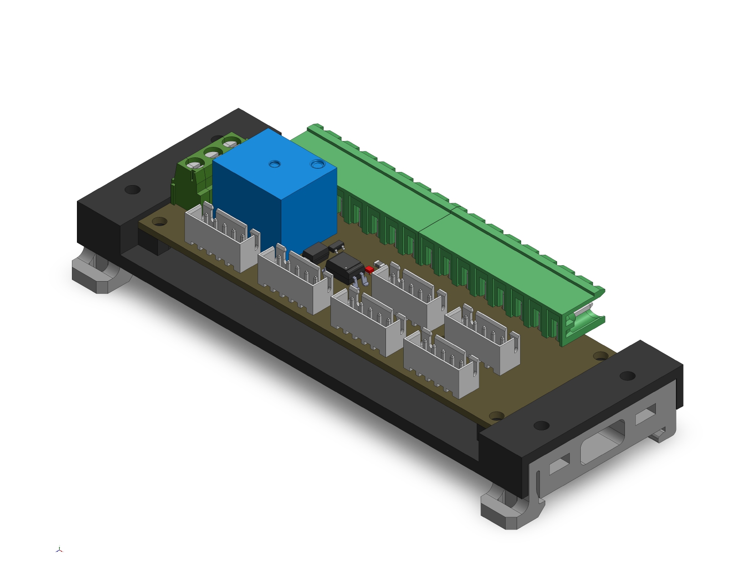
3D Design/Secondary PCB/Extender Port 3D - Isometric_page-0001.jpg
