AlfonsusGiovanni/Welding-Arm-Manipulator/Breakdown/Exported/Algorithm Flowchart-RS-232 Receive.png

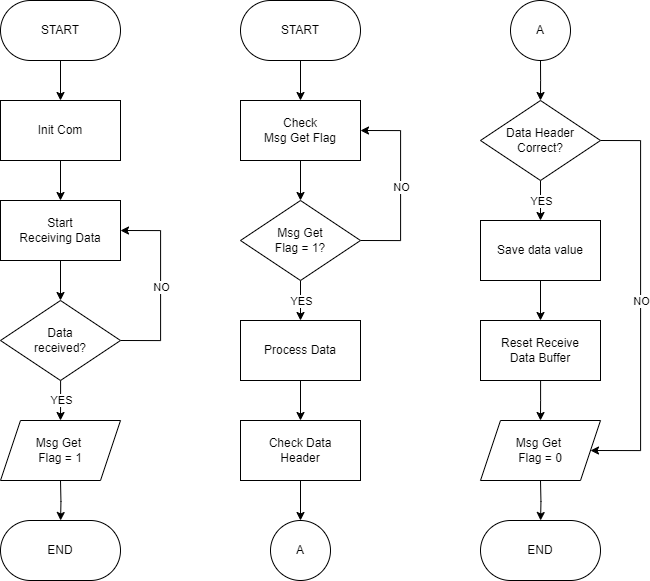
Breakdown/Exported/Algorithm Flowchart-RS-232 Receive.png
