AlfonsusGiovanni/Welding-Arm-Manipulator/Breakdown/Exported/Algorithm Flowchart-RS-232 Transmit.png

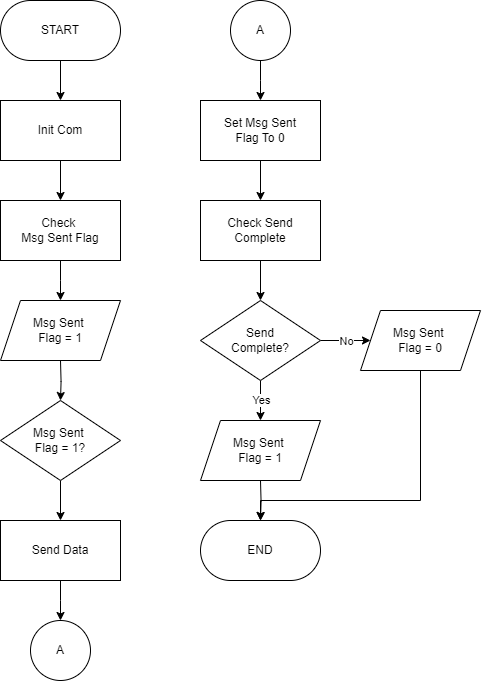
Breakdown/Exported/Algorithm Flowchart-RS-232 Transmit.png
