AlfonsusGiovanni/Welding-Arm-Manipulator/Breakdown/Exported/Arm Manipulator Electrical Supply Circuit (White BG).png

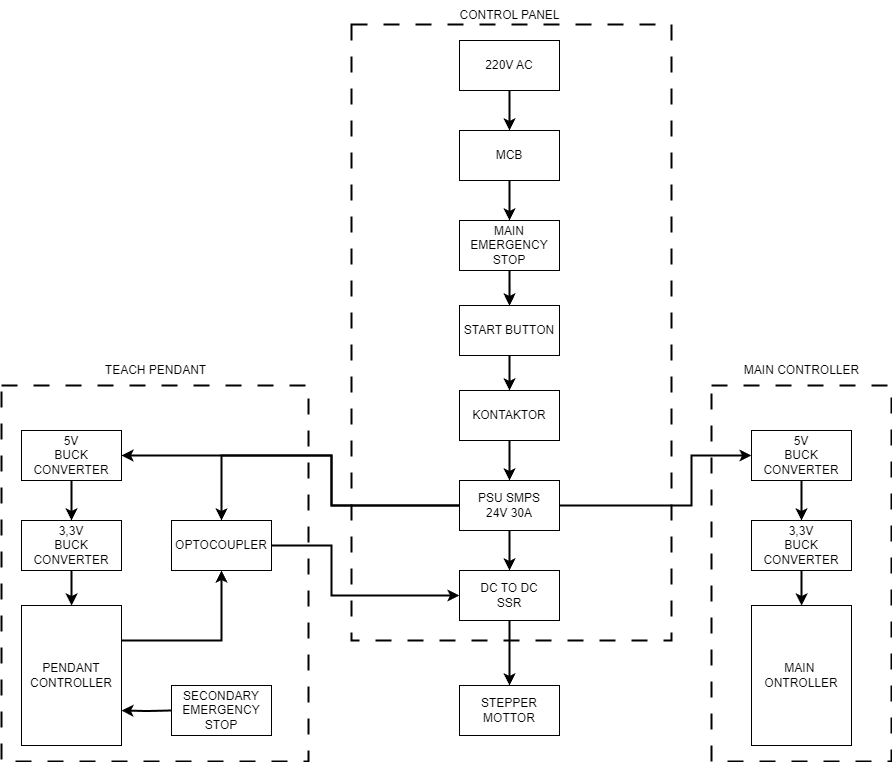
Breakdown/Exported/Arm Manipulator Electrical Supply Circuit (White BG).png
