AlfonsusGiovanni/Welding-Arm-Manipulator/Breakdown/Exported/Flow Control-Teach Pendant.png

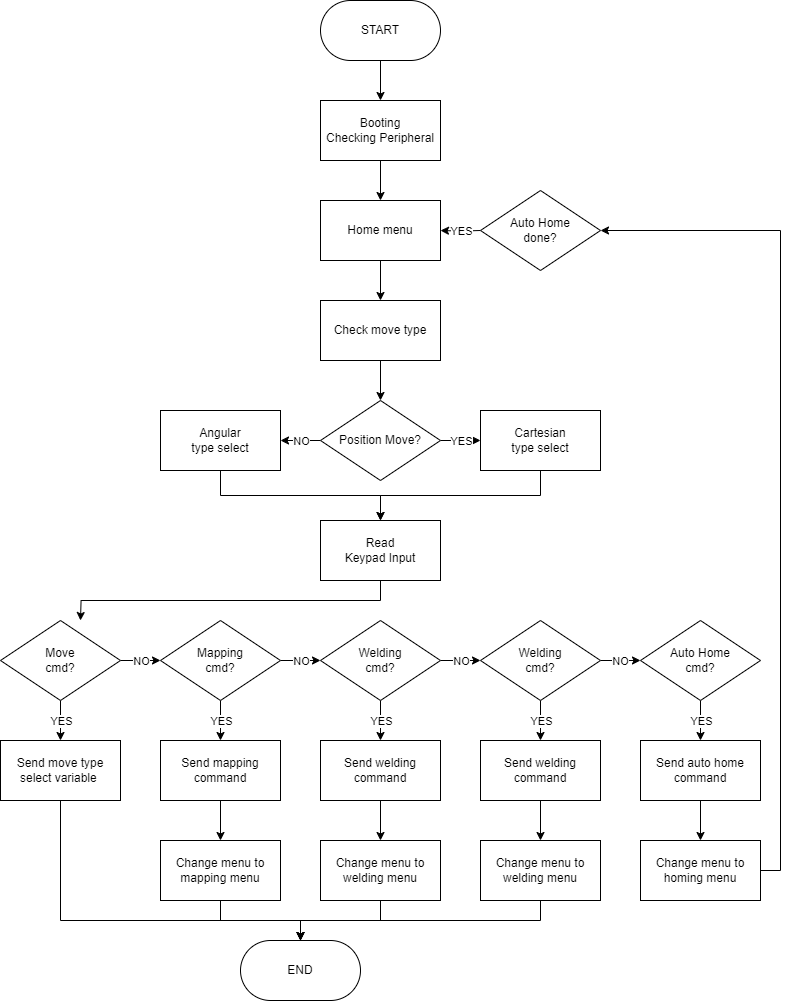
Breakdown/Exported/Flow Control-Teach Pendant.png
