AlfonsusGiovanni/Welding-Arm-Manipulator/Breakdown/Exported/System Diagram-Main PCB.png

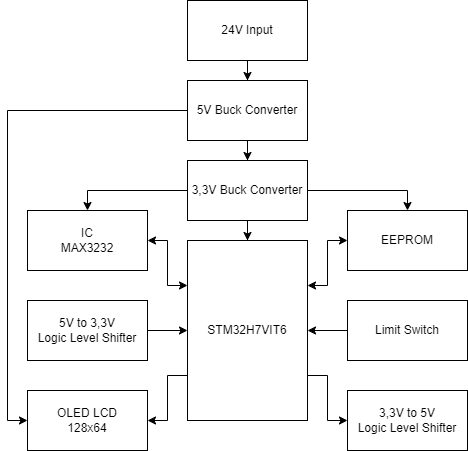
Breakdown/Exported/System Diagram-Main PCB.png
