AlfonsusGiovanni/Welding-Arm-Manipulator/Invoice/1. Rabu, 19 Juni 2024/Nota 1.jpg

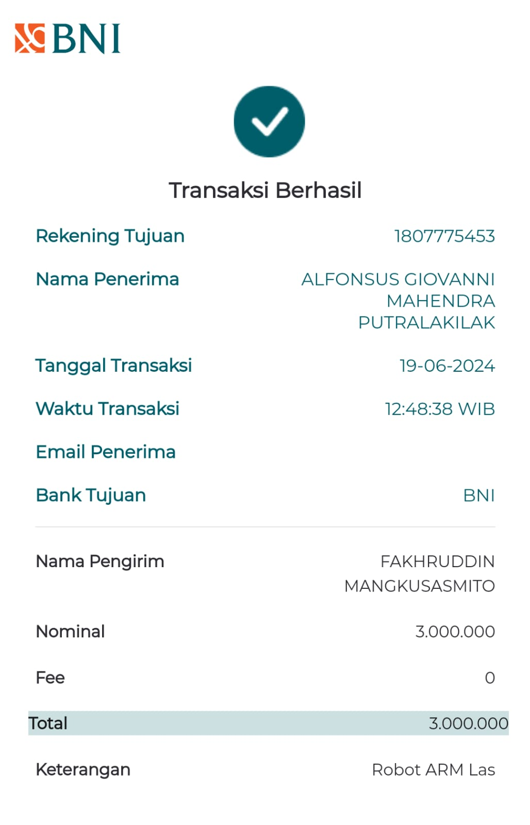
Invoice/1. Rabu, 19 Juni 2024/Nota 1.jpg
