AlfonsusGiovanni/Welding-Arm-Manipulator/Invoice/7. Minggu, 22 September 2024/Nota 8.jpg

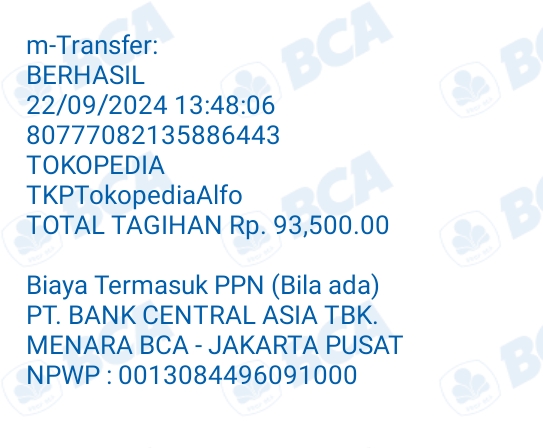
Invoice/7. Minggu, 22 September 2024/Nota 8.jpg
