AlfonsusGiovanni/Welding-Arm-Manipulator/Invoice/12. Sabtu, 28 Desember 2024/Nota 16.jpg

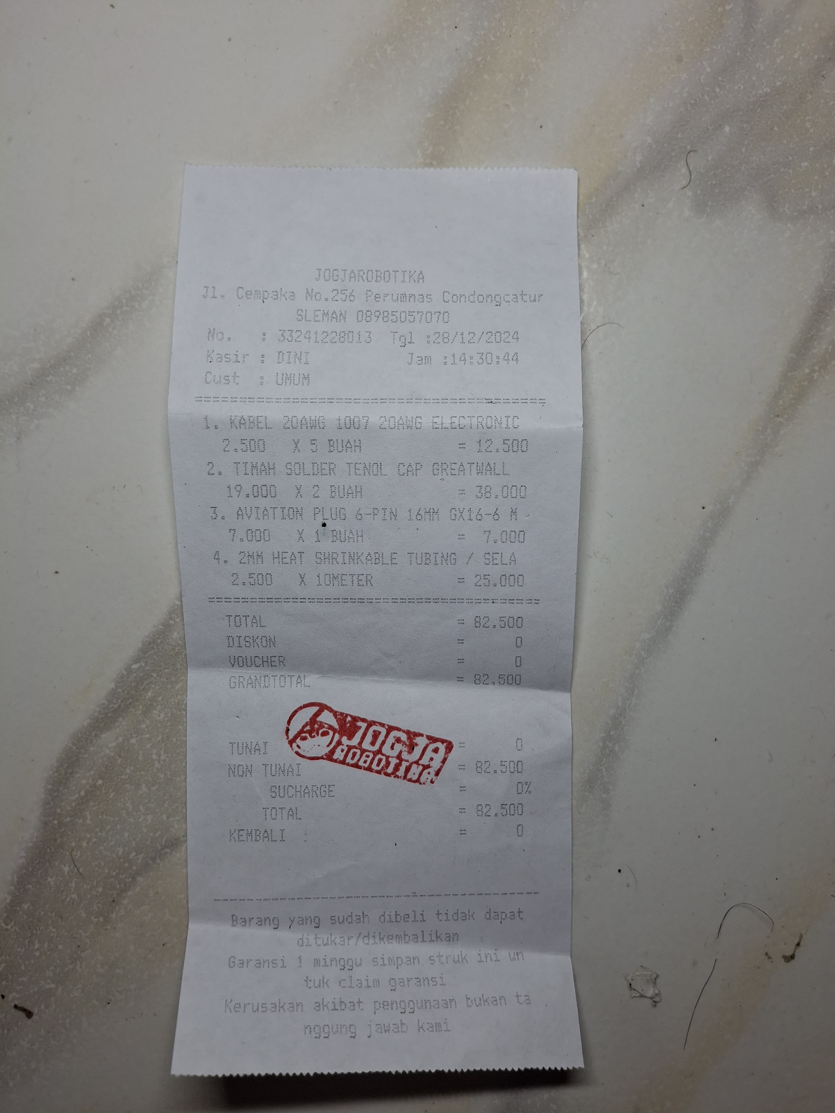
Invoice/12. Sabtu, 28 Desember 2024/Nota 16.jpg
