AlfonsusGiovanni/Welding-Arm-Manipulator/Invoice/17. Jumat, 24 Januari 2025/Nota 35.jpg

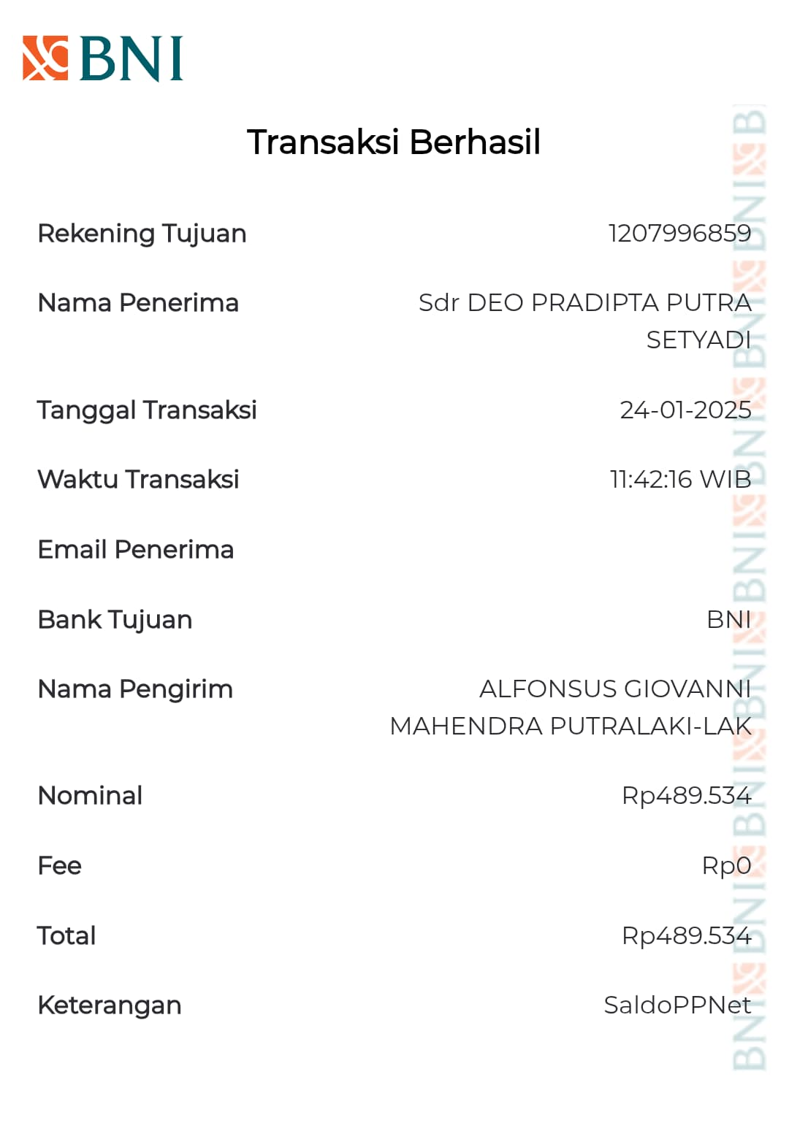
Invoice/17. Jumat, 24 Januari 2025/Nota 35.jpg
