AlfonsusGiovanni/Welding-Arm-Manipulator/Invoice/18. Jumat, 31 Januari 2025/Nota 36.jpg

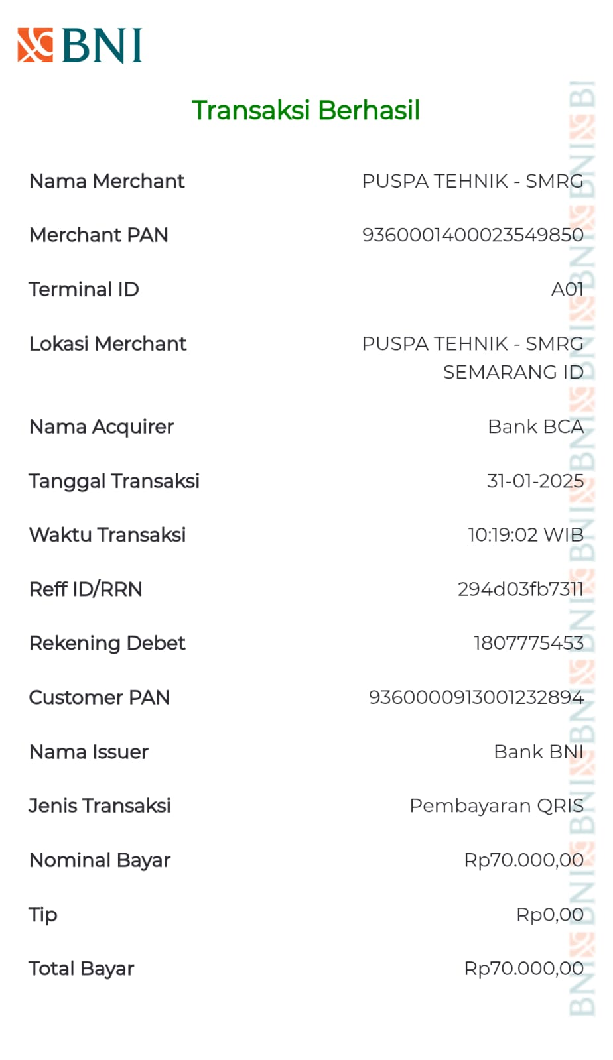
Invoice/18. Jumat, 31 Januari 2025/Nota 36.jpg
