AlfonsusGiovanni/Welding-Arm-Manipulator/Invoice/19. Sabtu, 1 Februari 2025/Nota 37.jpg

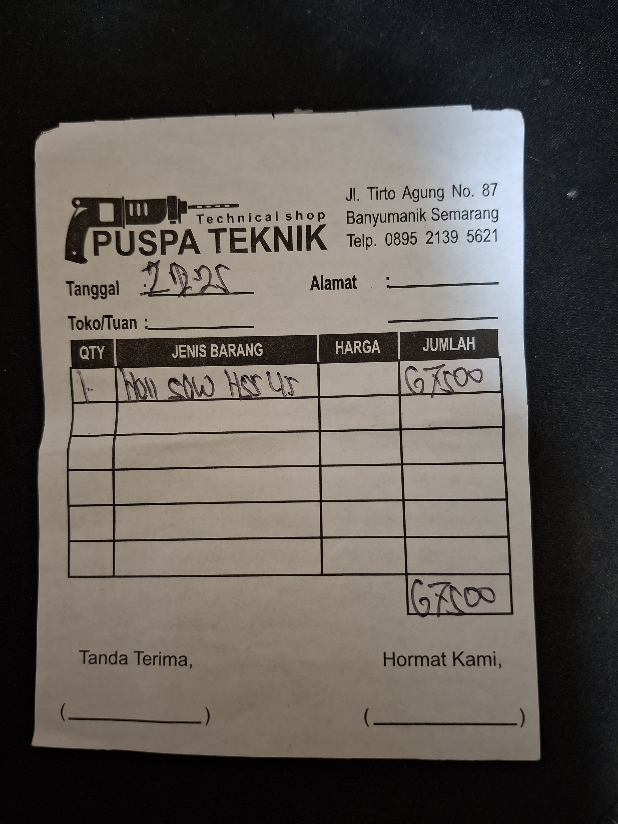
Invoice/19. Sabtu, 1 Februari 2025/Nota 37.jpg
