AlfonsusGiovanni/Welding-Arm-Manipulator/Invoice/20. Senin, 3 Februari 2025/Nota 41.jpg

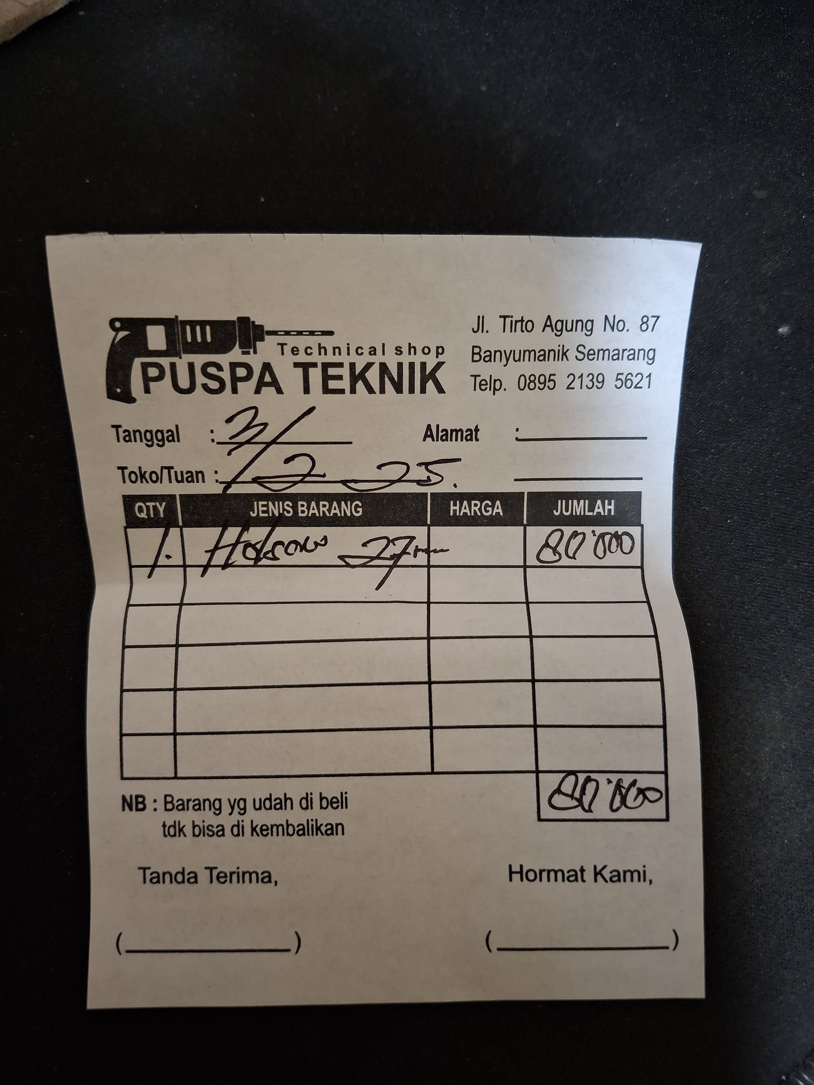
Invoice/20. Senin, 3 Februari 2025/Nota 41.jpg
