AlfonsusGiovanni/Welding-Arm-Manipulator/Invoice/21. Selasa, 4 Februari 2025/Nota 42.jpg

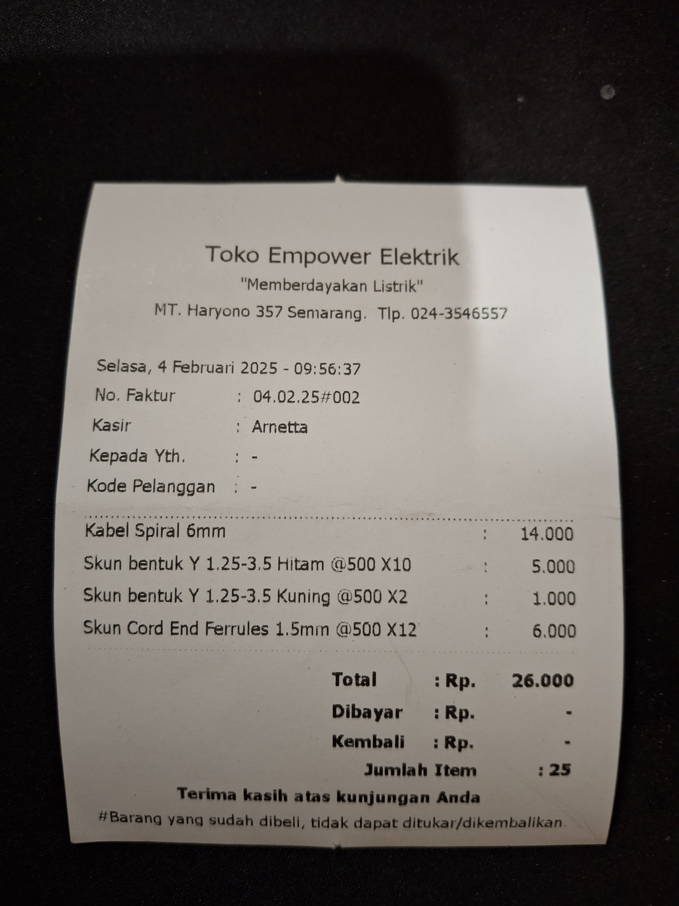
Invoice/21. Selasa, 4 Februari 2025/Nota 42.jpg
