AlfonsusGiovanni/Welding-Arm-Manipulator/Schematic & PCB Design/Box Panel/Schematic Box Panel/Power Schematic/Single Line Power.bmp

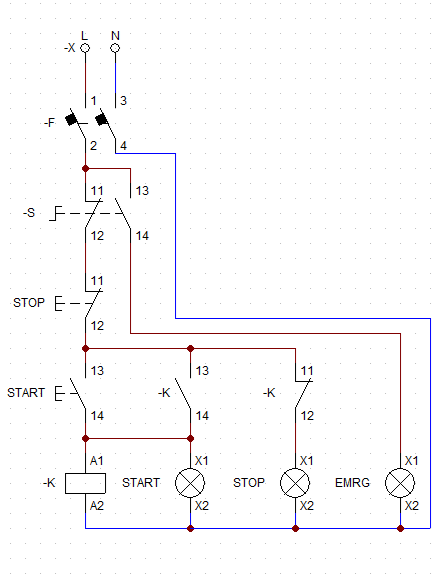
Schematic & PCB Design/Box Panel/Schematic Box Panel/Power Schematic/Single Line Power.bmp
