AlfonsusGiovanni/Welding-Arm-Manipulator/Schematic & PCB Design/Main PCB/JPEG Schematic/Main PCB Manipulator H7 Version_page-0002.jpg

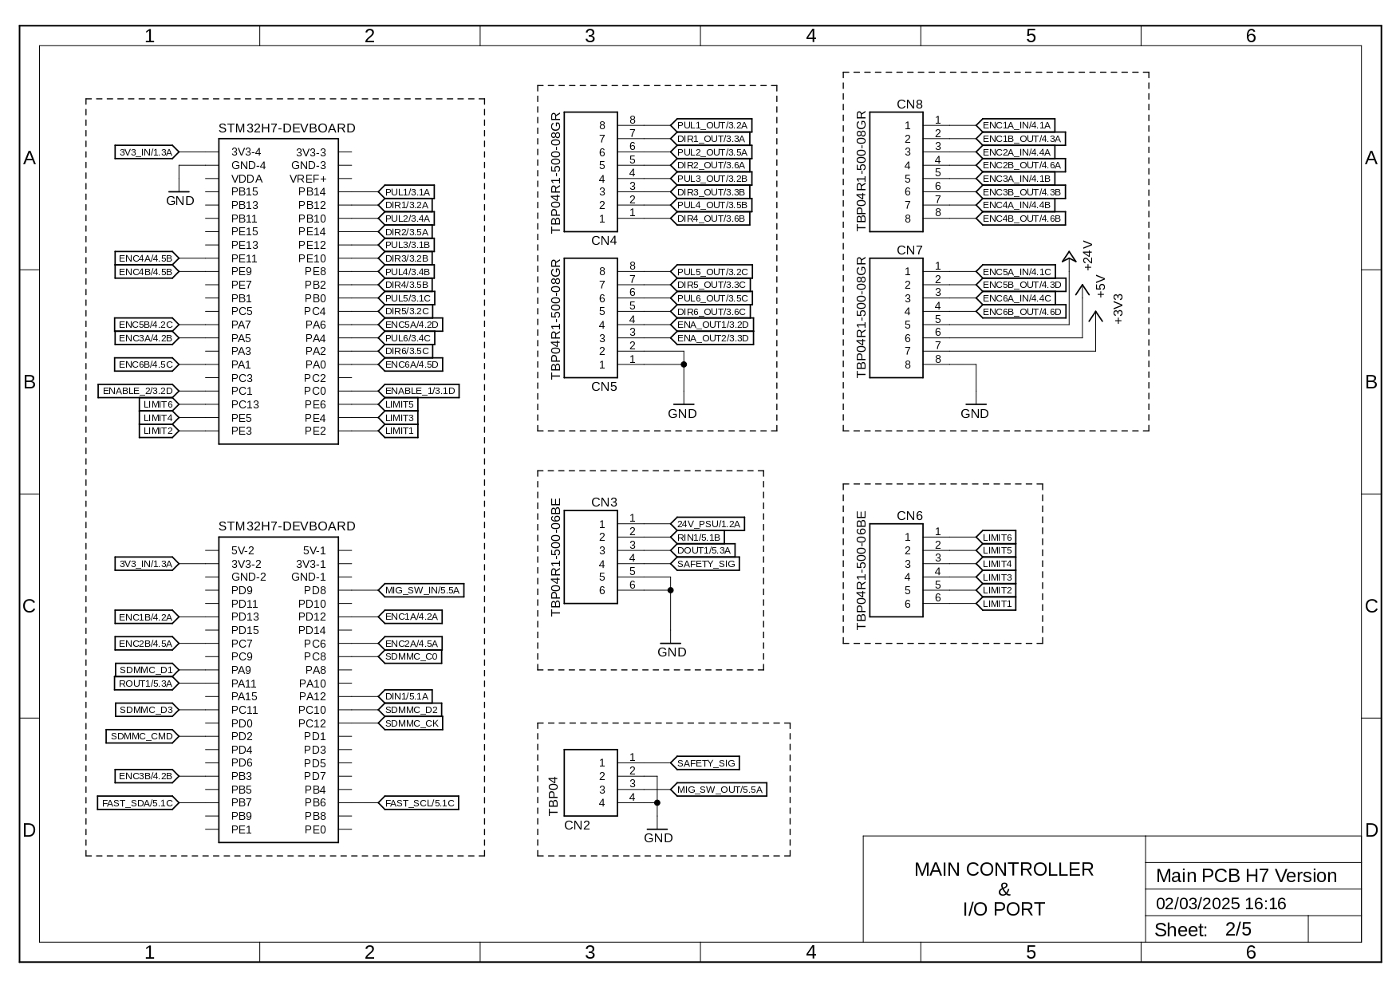
Schematic & PCB Design/Main PCB/JPEG Schematic/Main PCB Manipulator H7 Version_page-0002.jpg
