AlfonsusGiovanni/Welding-Arm-Manipulator/Schematic & PCB Design/Main PCB/PDF Schematic/PCB Dimension H7 Version_page.jpg

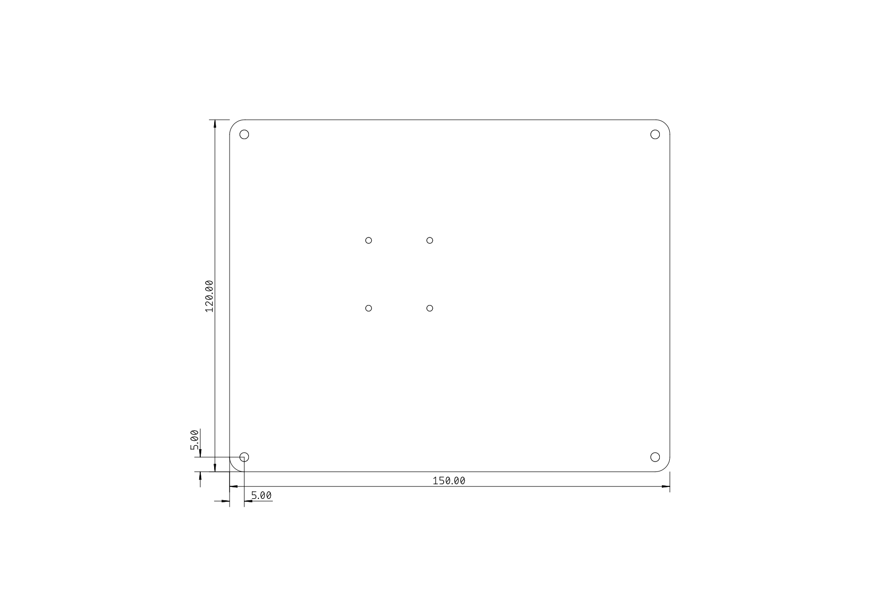
Schematic & PCB Design/Main PCB/PDF Schematic/PCB Dimension H7 Version_page.jpg
