AlfonsusGiovanni/Welding-Arm-Manipulator/Schematic & PCB Design/Pendant PCB/JPEG Schematic/RS-232 Pendant_page-0002.jpg

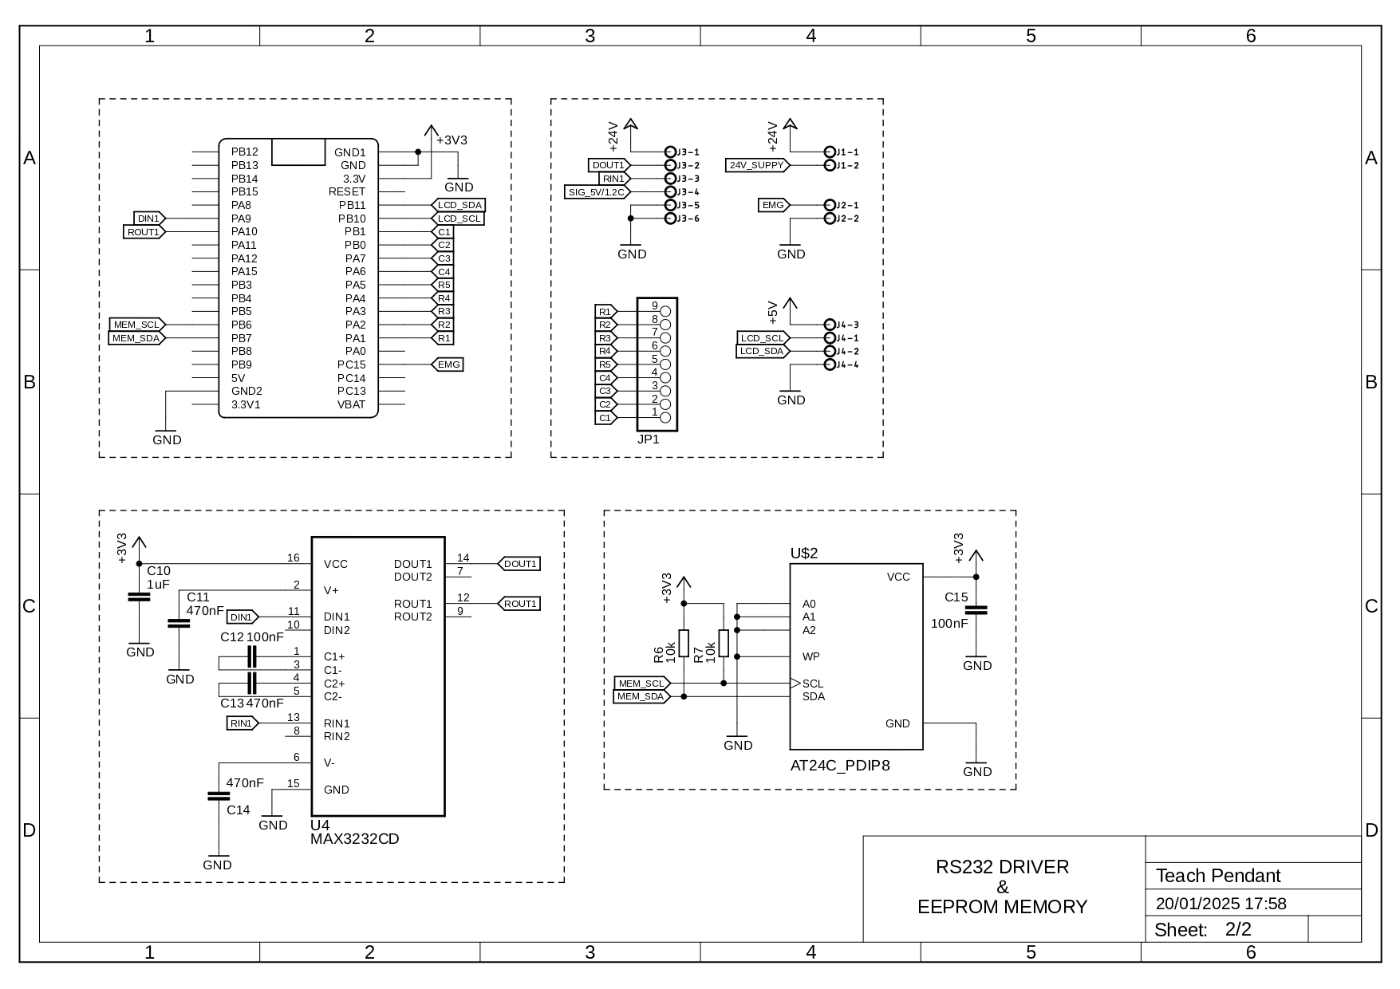
Schematic & PCB Design/Pendant PCB/JPEG Schematic/RS-232 Pendant_page-0002.jpg
