AlfonsusGiovanni/Welding-Arm-Manipulator/Schematic & PCB Design/Secondary PCB/Schematic PCB Secondary - Arm Manipulator_page-0001.jpg

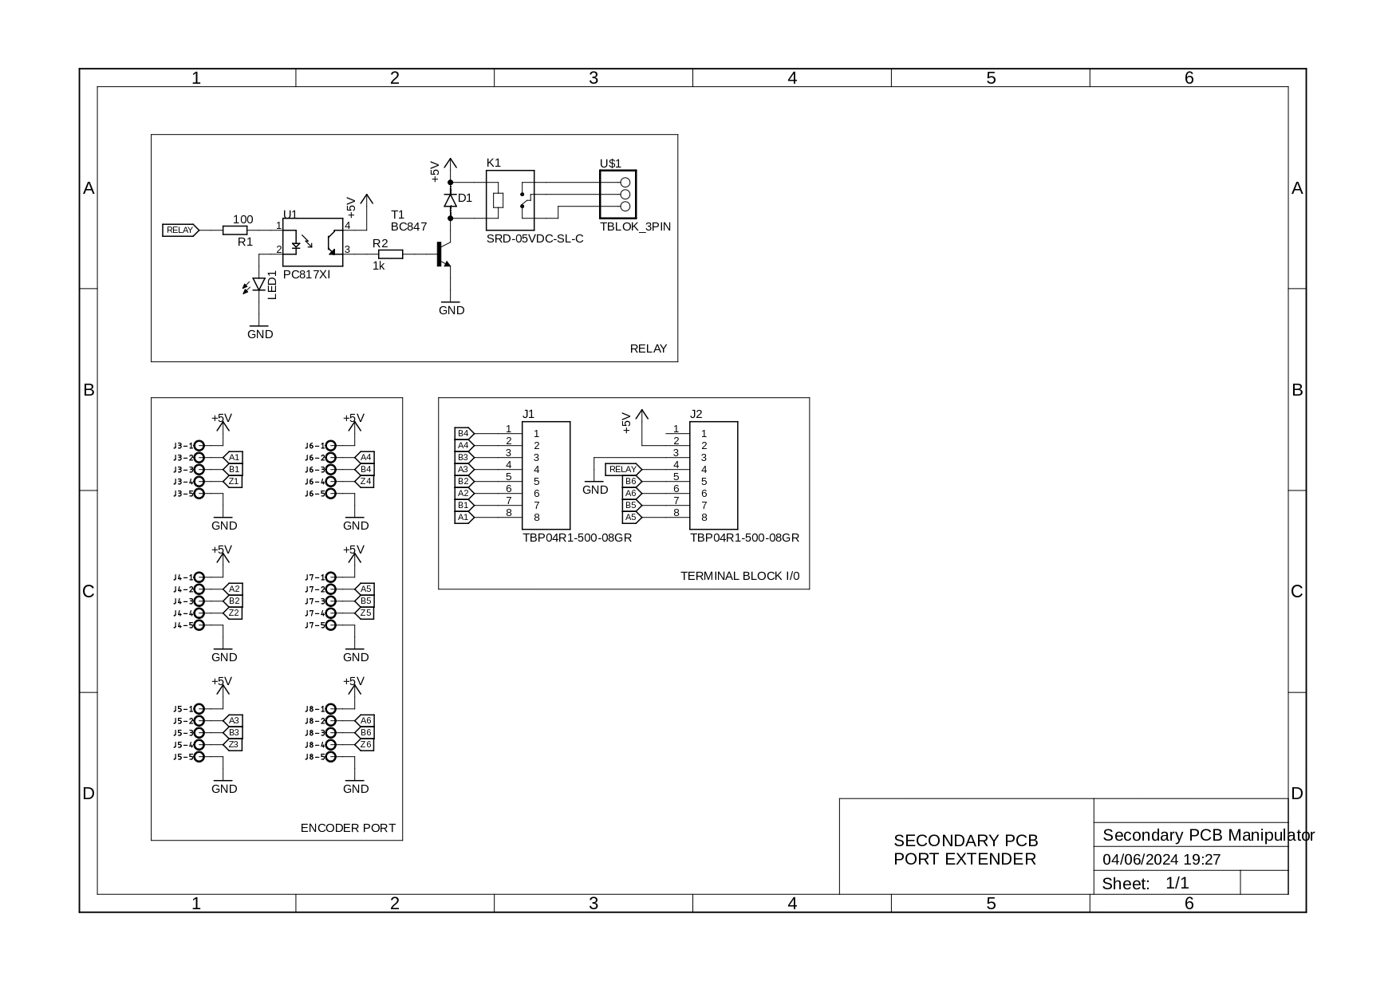
Schematic & PCB Design/Secondary PCB/Schematic PCB Secondary - Arm Manipulator_page-0001.jpg
