AlfonsusGiovanni/Welding-Arm-Manipulator/Referensi/AR4 6DOF Manipulator/AR4-MK3 motor step calculations.xlsx

J1 | motor gear box ratio | pulley ratio | total reduction | steps per motor revolution | steps per degree
 | 10 | 4 | 40 | 400 | 44.44444444
J2 | motor gear box ratio | total reduction | steps per motor revolution | steps per degree
 | 50 | 50 | 400 | 55.55555556
J3 | motor gear box ratio | total reduction | steps per motor revolution | steps per degree
 | 50 | 50 | 400 | 55.55555556
J4 | motor gear box ratio | pulley ratio | total reduction | steps per motor revolution | steps per degree
 | 16 | 2.8 | 44.8 | 400 | 49.77777778
J5 | screw lead | pulley radius | belt width | total drive radius | drive circumference | circumference per degree | drive degrees per motor revolution | total reduction | steps per motor revolution | steps per degree
 | 8 | 11.9 | 2.5 | 12.525 | 78.69689597 | 0.2186024888 | 0.0273253111 | 9.837111997 | 800 | 21.86024888
J6 | motor gear box ratio | total reduction | steps per motor revolution | steps per degree
 | 20 | 20 | 400 | 22.22222222
J7 | screw lead | steps per motor revolution | steps per mm
 | 4 | 400 | 100
