AlfonsusGiovanni/Welding-Arm-Manipulator/Breakdown/Excel/Arm Info.xlsx

Sheet: Stepper Information
STEPPER CONFIGURATION |  |  |  |  |  |  |  | STEPPER CONTROL |  |  |  | STEPPER REDUCED RPM
No | Joint | Stepper Type | Driver Step Config | Min Rev/min Config | Max Rev/min Config | Gear Ratio | Total Step Per Rev | No | Joint | Min Pulse f (kHz) | Max Pulse f (kHz) | No | Joint | Min Joint Rev/min | Max Joint Rev/min | Min Joint Rev/sec | Max Joint Rev/sec | Max 1 Rev Time (s) | Max 1/6 Rev Time (s)
1 | J1 | 23HS7628 | 800 | 180 | 360 | 90 | 72000 | 1 | J1 | 2400 | 4800 | 1 | J1 | 2.00 | 4.00 | 0.03 | 0.07 | 15.00 | 2.50
2 | J2 | 23HS10028S | 800 | 180 | 315 | 36 | 28800 | 2 | J2 | 2400 | 4200 | 2 | J2 | 5.00 | 8.75 | 0.08 | 0.15 | 6.86 | 1.14
3 | J3 | 23HS7628 | 800 | 180 | 360 | 36 | 28800 | 3 | J3 | 2400 | 4800 | 3 | J3 | 5.00 | 10.00 | 0.08 | 0.17 | 6.00 | 1.00
4 | J4 | 23HS5628 | 800 | 180 | 360 | 9 | 7200 | 4 | J4 | 2400 | 4800 | 4 | J4 | 20.00 | 40.00 | 0.33 | 0.67 | 1.50 | 0.25
5 | J5 | 23HS7628 | 800 | 180 | 360 | 90 | 72000 | 5 | J5 | 2400 | 4800 | 5 | J5 | 2.00 | 4.00 | 0.03 | 0.07 | 15.00 | 2.50
6 | J6 | 23HS5628 | 800 | 180 | 360 | 9 | 7200 | 6 | J6 | 2400 | 4800 | 6 | J6 | 20.00 | 40.00 | 0.33 | 0.67 | 1.50 | 0.25

Sheet: Kinematics Overview
FORWARD KINEMATICS |  |  |  |  |  |  |  |  |  |  |  |  |  |  |  |  | INVERSE KINEMATICS
INPUTS |  |  |  |  |  |  |  | DH PARAMETER |  |  |  |  |  | OUTPUTS |  |  | INPUTS |  |  |  | OUTPUTS
JOINTS | Angles |  |  | Toolframe |  |  |  | JOINTS | Θ | α | d | a |  | PARAMETERS | Value | Radians | PARAMETERS | Value | Radians |  | JOINTS | Angles
 | Limit | Degrees | Radians | Param | Value | Radians |  |  |  |  |  |  |  |  |  |  |  |  |  |  |  | Degrees | Radians
J1 | (-170 / 170) | 0.000 | 0.000 | Xpos | 0.000 | - |  | 1 | 0.000 | -1.571 | 191.000 | 23.500 |  | Xpos | 598.500 | - | Xpos | 598.500 | - |  | J1 | -7.623607892e-16 | -1.330570586e-17
J2 | (-60 / 90) | 0.000 | 0.000 | Ypos | 0.000 |  |  | 2 | -1.571 | 0.000 | 0.000 | 650.000 |  | Ypos | 3.369158251e-15 |  | Ypos | 0.000 |  |  | J2 | 0.000 | 0.000
J3 | (-90 / 60) | 0.000 | 0.000 | Zpos | 0.000 |  |  | 3 | 3.142 | 1.571 | 0.000 | 0.000 |  | Zpos | 776.000 |  | Zpos | 776.000 |  |  | J3 | 0.000 | 0.000
J4 | (-165 / 165) | 0.000 | 0.000 | Rz | 0.000 | 0.000 |  | 4 | 0.000 | -1.571 | 575.000 | 0.000 |  | Rz | 180.000 | 3.142 | Rz | 180.000 | 3.142 |  | J4 | 3.509791787e-15 | 6.125742275e-17
J5 | (-105 / 105) | 90.000 | 1.571 | Ry | 0.000 | 0.000 |  | 5 | 1.571 | 1.571 | 0.000 | 0.000 |  | Ry | 7.019583574e-15 | 1.225148455e-16 | Ry | 7.019583574e-15 | 1.225148455e-16 |  | J5 | 90.000 | 1.571
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
 | -3.981732478e-14 |  | -4.594306706e-15 |  | J6 | 0.000 | 0.000 | 1.225148455e-16
 | 841.000 |  | 841.000 |  |  | 0.000 | 0.000 | 1.225148455e-16
T0-3 | 23.500 | T0-6 | 598.500 |  |  | 0.000 | 0.000 | -1.000
 | -3.981732478e-14 |  | 3.369158251e-15
 | 841.000 |  | 776.000
