AlfonsusGiovanni/Welding-Arm-Manipulator/3D Design/Arm/Assembly of Manipulator SV.step

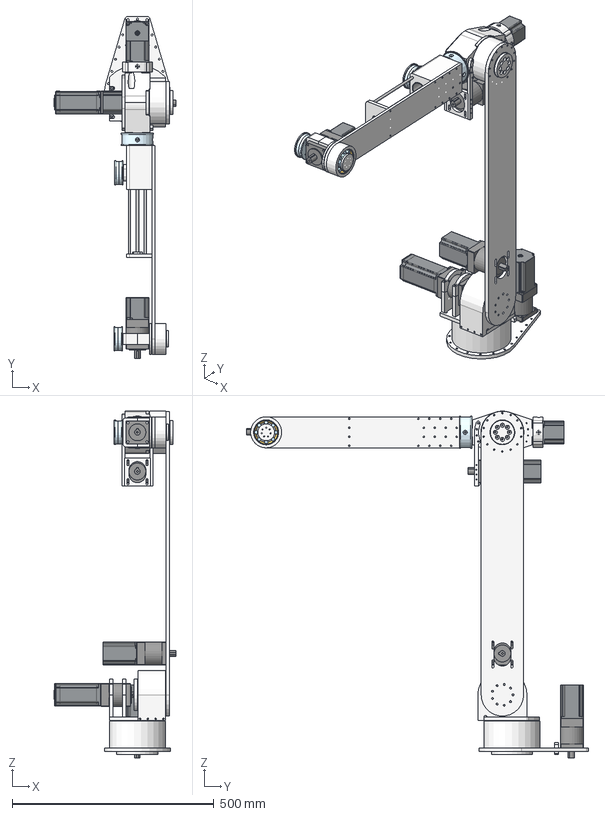
[picture p96: CAD file, 2025-02-18]
3D Design/Arm/Assembly of Manipulator SV.step
302.0 x 846.6 x 858.5 mm
DIN 618 - HK4020 - 40 x 47 x 20 x 46
J5 Lead Screw 8mm
DIN 5405 T2 - AXK4565 - 45 x 65 x 3 x 50
J2 Bottom Arm
DIN 5405 T3 - AS3552 - 35 x 52 x 1 x 2
DIN 5405 T2 - AXK3552 - 35 x 52 x 2 x 28
JIS B 1521 - 688 8x16x4x1.61 x 11
J5 Spindle Turret
J1 Turret Platform
DIN 618 - HK1612 - 16 x 22 x 12 x 24
J5 Pipe Housing
Nema 23 23HS5628 x 2
J5 Idler Tension
Planetary Gearbox NEMA 23 - PX57004 - SKU030 x 5
J4 Front Housing
J5 Timing Hub B x 2
J5 Bearing Arm
Nema 23 23HS8328 x 3
DIN 720 - 32013X - 65 x 100 x 23 x 4
J2 Motor Support Bottom
Nema 23 5718HB6401
J3 Spindle Housing
J3 Spindle Bracket
J5 Spindle Bracket
J5 Bearing Post x 2
J6 Motor Mount B
DIN 720 - 30206 - 30 x 62 x 17.25 x 2
J5 Motor Mount
J5 Spindle Housing
J4 Mount Center
J2 Spindle Housing
J1 Base Plate
J5 Rod 6mm x 2
J2 Spindle Turret
J4 Mount Right
J5 Timing Hub A x 2
J2 Motor Bracket Top
J2 Motor Support Top
DIN 720 - 30209 - 45 x 85 x 20.75 x 4
J1 Spindle Bracket
J5 Lead Screw Housing
DIN 5405 T3 - AS4565 - 45 x 65 x 1 x 4
J1 Spindle Turret
Bottom Bracket Part
J5 Bearing Stopper
J1 Spindle Housing
AS5600 v1
J4 Timing Hub
J4 Mount Left
J4 Rear Housing
J3 Turret Platform
J5 Turret Platform
J3 Spindle Turret
J1 Tension Bracket
J2 Motor Bracket Bottom
J4 Main Shaft
DIN 720 SKF - SKF 32016 X_Q x 4
J6 Motor Mount A
J2 Spindle Bracket
