AlfonsusGiovanni/Welding-Arm-Manipulator/3D Design/Main PCB/Main+PCB+Manipulator+H7+Version_TOP.DXF

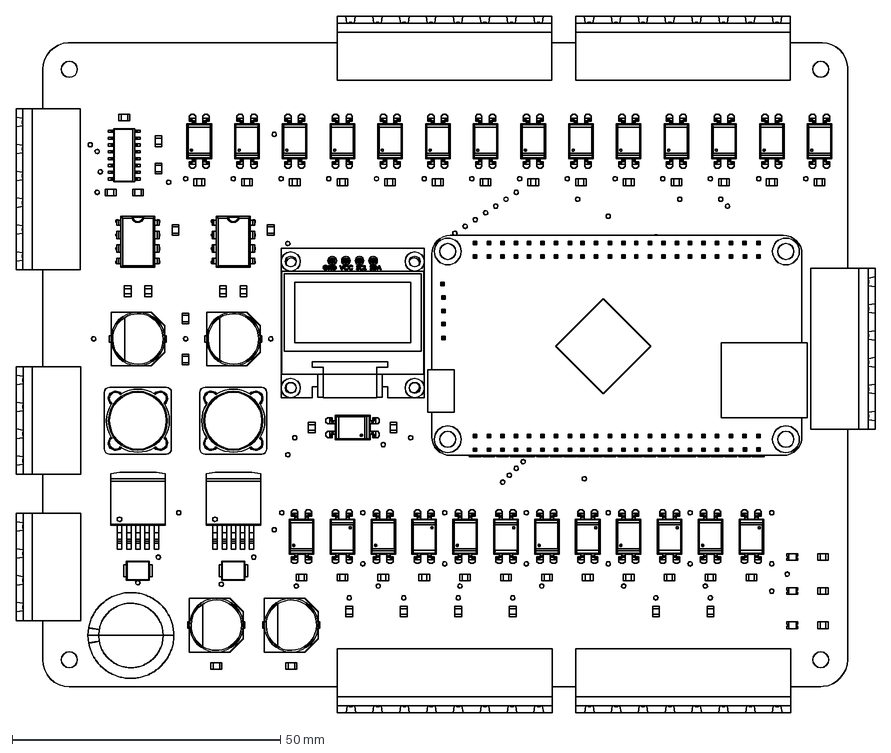
[picture p97: CAD file, 2025-02-18]
3D Design/Main PCB/Main+PCB+Manipulator+H7+Version_TOP.DXF
160.1 x 129.9 mm
