AlfonsusGiovanni/Welding-Arm-Manipulator/3D Design/PCB Bracket/Main PCB Case/DXF/MAIN CASE TOP.dxf

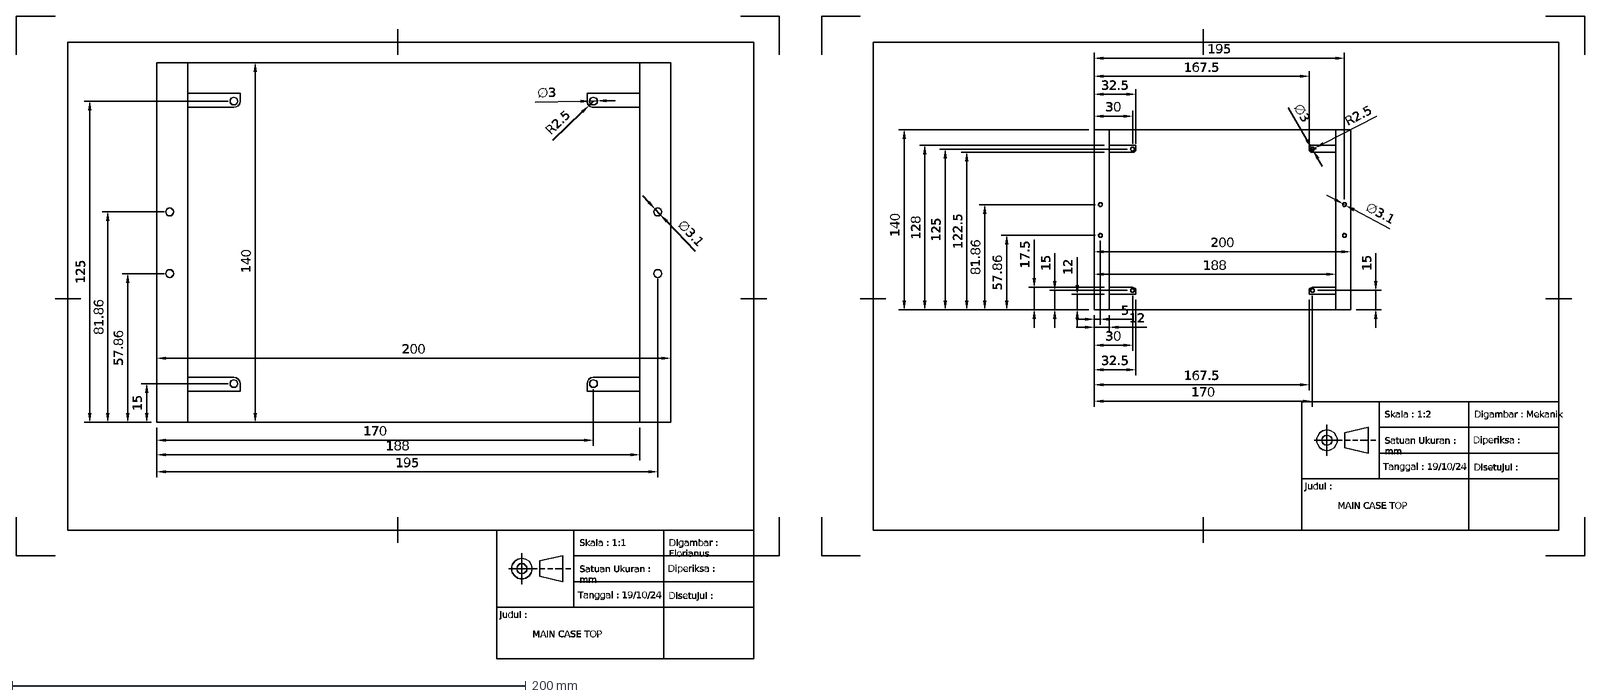
[picture p98: CAD file, 2024-10-28]
3D Design/PCB Bracket/Main PCB Case/DXF/MAIN CASE TOP.dxf
200
140
∅3.1
∅3
R2.5
195
170
125
81.86
57.86
15
188
Skala : 1:2
Satuan Ukuran : mm
Tanggal : 19/10/24
Digambar : Mekanik
Diperiksa :
Disetujui :
Judul :
MAIN CASE TOP
30
12
5
128
122.5
17.5
167.5
32.5
Skala : 1:1
Digambar : Florianus
