AlfonsusGiovanni/Welding-Arm-Manipulator/3D Design/Robot Dummy/Dummy Assem.SLDASM

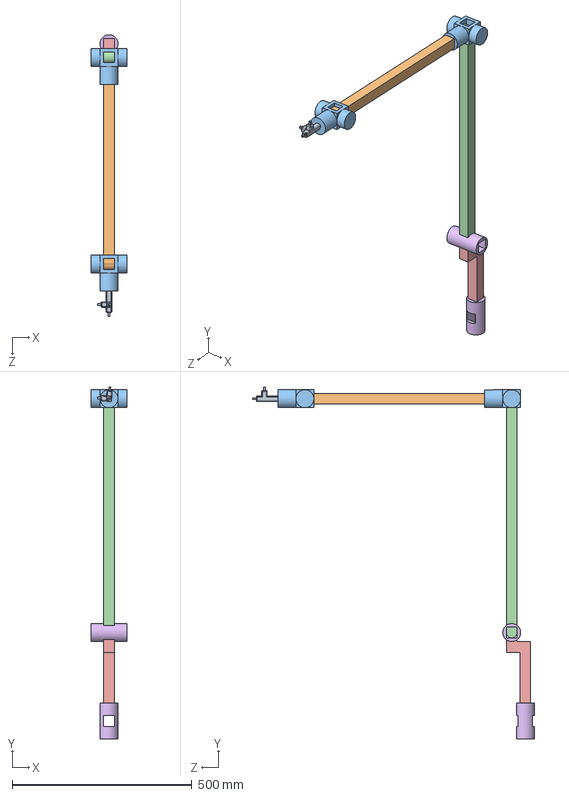
[picture p99: CAD file, 2025-03-10]
3D Design/Robot Dummy/Dummy Assem.SLDASM
100.0 x 978.6 x 782.7 mm
Joint x 2
Arm1
Arm2
Joint T x 2
Arm3
End Effector
