AlfonsusGiovanni/Welding-Arm-Manipulator/2D Design/Arm/Assembly of Arm Manipulator SV UNDIP - Front View.DXF

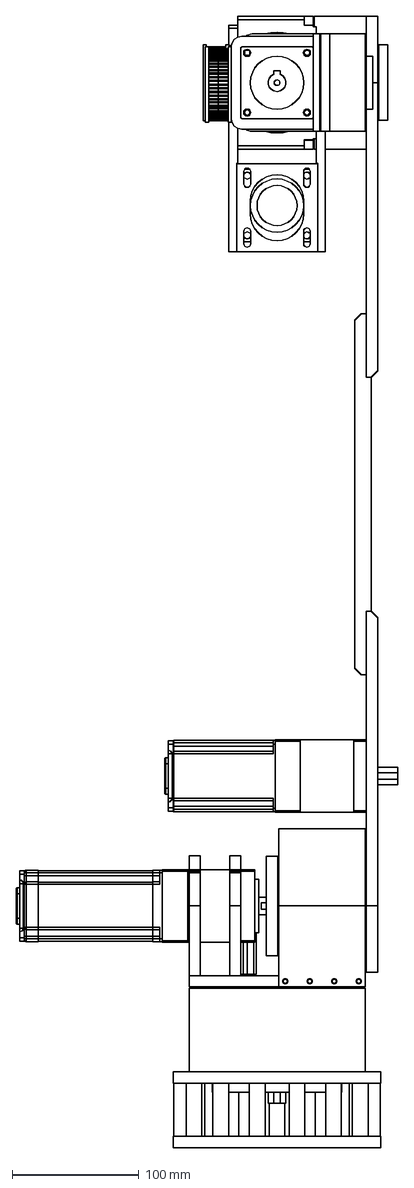
[picture p100: CAD file, 2025-03-10]
2D Design/Arm/Assembly of Arm Manipulator SV UNDIP - Front View.DXF
301.6 x 893.5 mm
