AlfonsusGiovanni/Welding-Arm-Manipulator/3D Design/PCB Bracket/Main PCB Case/DXF/Main PCB Case Assem V2.DXF

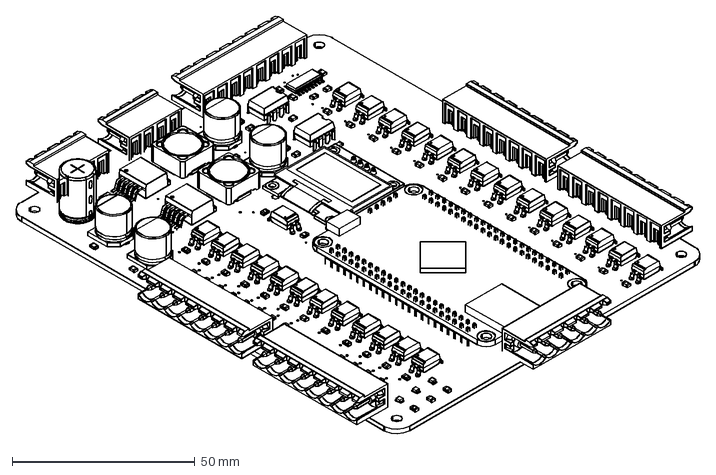
[picture p101: CAD file, 2024-10-28]
3D Design/PCB Bracket/Main PCB Case/DXF/Main PCB Case Assem V2.DXF
186.8 x 114.5 mm
