AlfonsusGiovanni/Welding-Arm-Manipulator/3D Design/PCB Bracket/Main PCB Case/Main PCB Case V2 - Revisi.SLDPRT

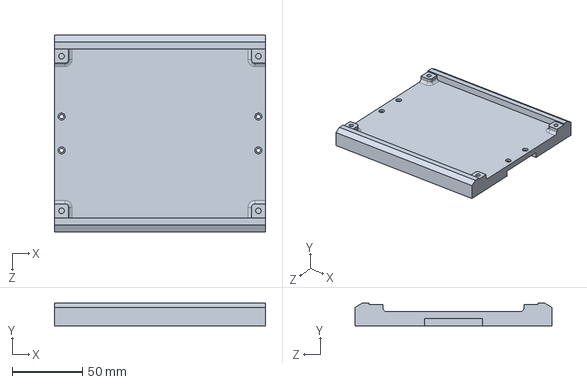
[picture p102: CAD file, 2025-02-18]
3D Design/PCB Bracket/Main PCB Case/Main PCB Case V2 - Revisi.SLDPRT
150.0 x 16.0 x 140.0 mm
