AlfonsusGiovanni/Welding-Arm-Manipulator/2D Design/Arm/Assembly of Arm Manipulator SV UNDIP - Left View.DXF

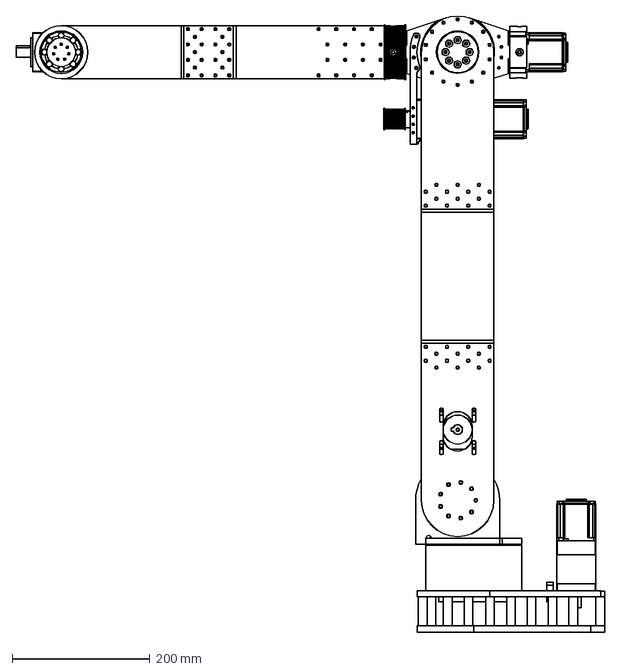
[picture p103: CAD file, 2025-03-10]
2D Design/Arm/Assembly of Arm Manipulator SV UNDIP - Left View.DXF
853.1 x 893.5 mm
