AlfonsusGiovanni/Welding-Arm-Manipulator/3D Design/PCB Bracket/Main PCB Case/Main PCB Case V2.SLDPRT

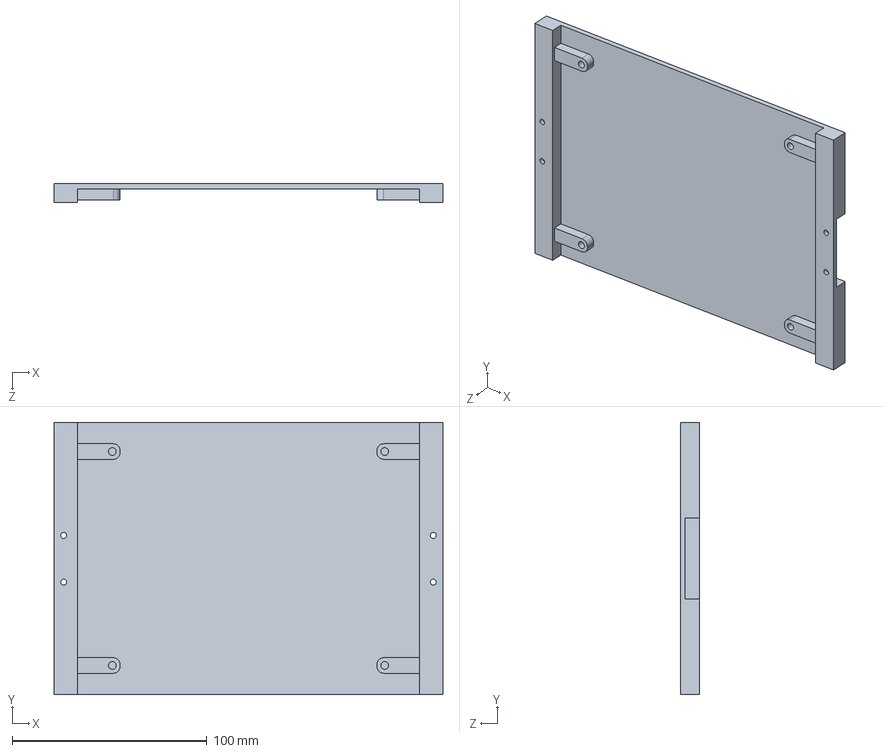
[picture p104: CAD file, 2025-02-18]
3D Design/PCB Bracket/Main PCB Case/Main PCB Case V2.SLDPRT
200.0 x 140.0 x 10.0 mm
