AlfonsusGiovanni/Welding-Arm-Manipulator/2D Design/Arm/Assembly of Arm Manipulator SV UNDIP - Isometric View.DXF

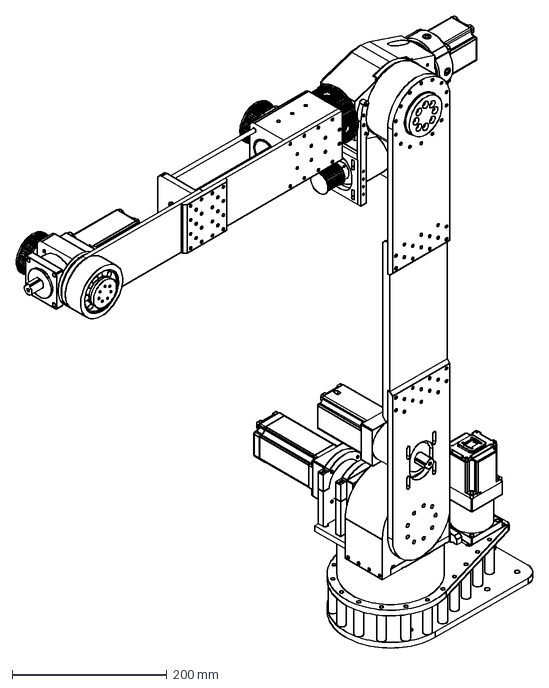
[picture p105: CAD file, 2025-03-10]
2D Design/Arm/Assembly of Arm Manipulator SV UNDIP - Isometric View.DXF
668.3 x 818.0 mm
