AlfonsusGiovanni/Welding-Arm-Manipulator/3D Design/PCB Bracket/Main PCB Case/MAINCASE_.step

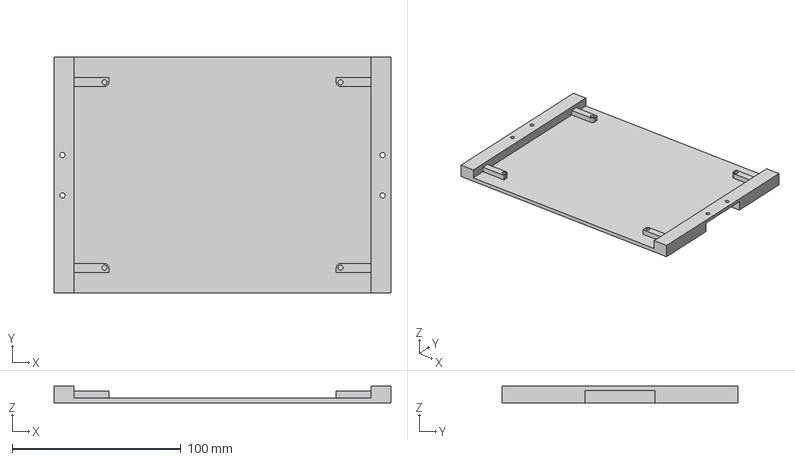
[picture p106: CAD file, 2024-10-28]
3D Design/PCB Bracket/Main PCB Case/MAINCASE_.step
200.0 x 140.0 x 10.0 mm
