AlfonsusGiovanni/Welding-Arm-Manipulator/2D Design/Arm/Assembly of Arm Manipulator SV UNDIP - Top View.DXF

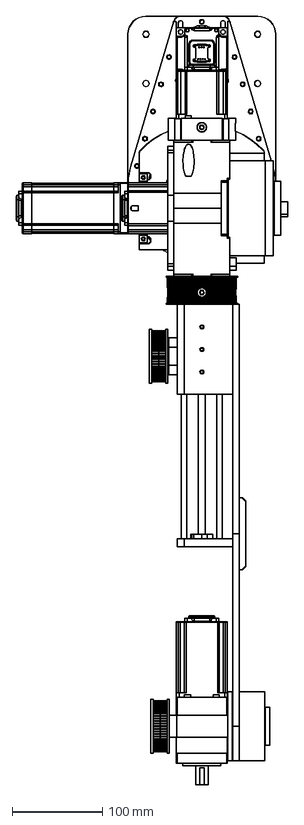
[picture p107: CAD file, 2025-03-10]
2D Design/Arm/Assembly of Arm Manipulator SV UNDIP - Top View.DXF
301.6 x 853.1 mm
