AlfonsusGiovanni/Welding-Arm-Manipulator/3D Design/Base Part/Base Manipulator.SLDPRT

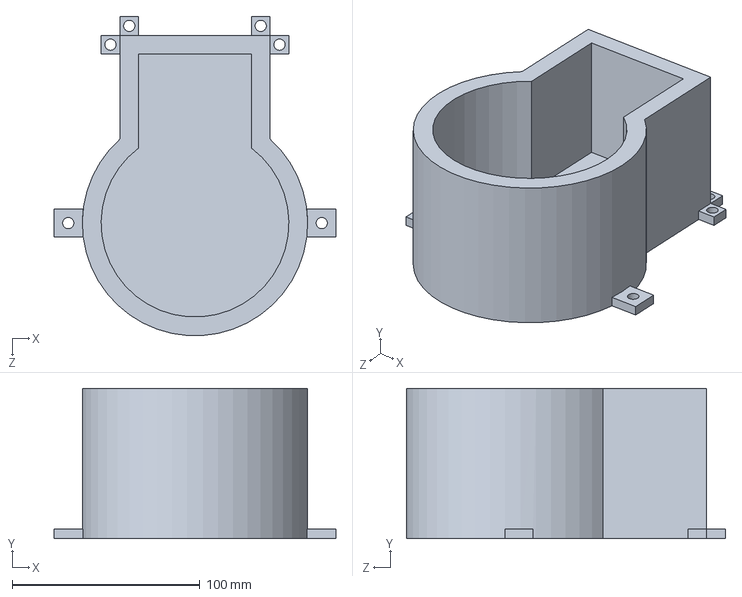
[picture p108: CAD file, 2024-07-30]
3D Design/Base Part/Base Manipulator.SLDPRT
150.0 x 80.0 x 169.9 mm
