AlfonsusGiovanni/Welding-Arm-Manipulator/3D Design/Main PCB/3D Design View/Din Rail-TOL.DXF

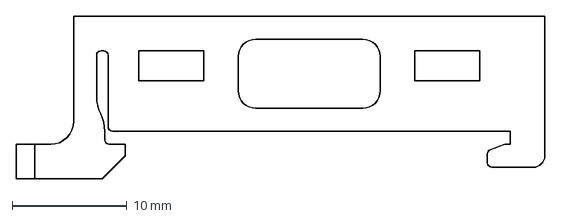
[picture p109: CAD file, 2024-10-28]
3D Design/Main PCB/3D Design View/Din Rail-TOL.DXF
46.0 x 14.2 mm
