AlfonsusGiovanni/Welding-Arm-Manipulator/3D Design/PCB Bracket/Main PCB Case/DIn Rail Bracket.SLDPRT

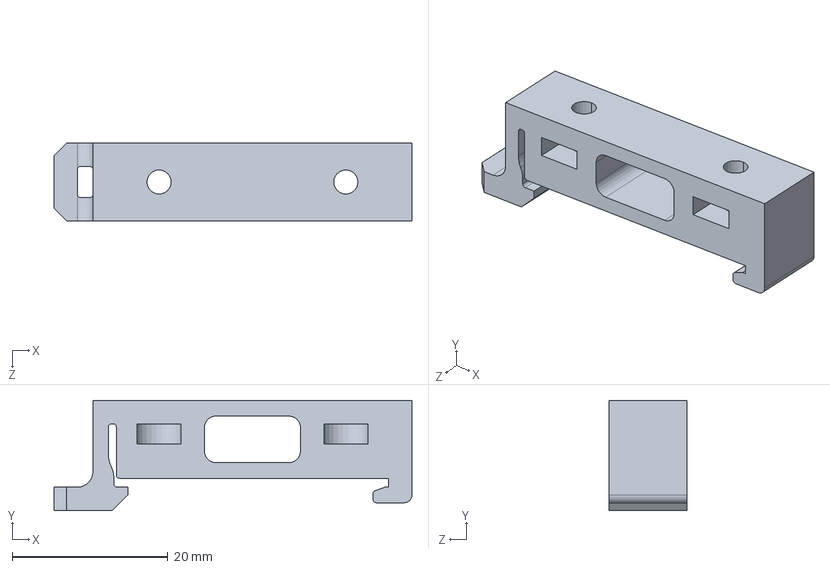
[picture p110: CAD file, 2025-02-18]
3D Design/PCB Bracket/Main PCB Case/DIn Rail Bracket.SLDPRT
46.0 x 14.1 x 10.0 mm
