AlfonsusGiovanni/Welding-Arm-Manipulator/3D Design/PCB Bracket/Pendant Case/Top Part Pendant V2.SLDPRT

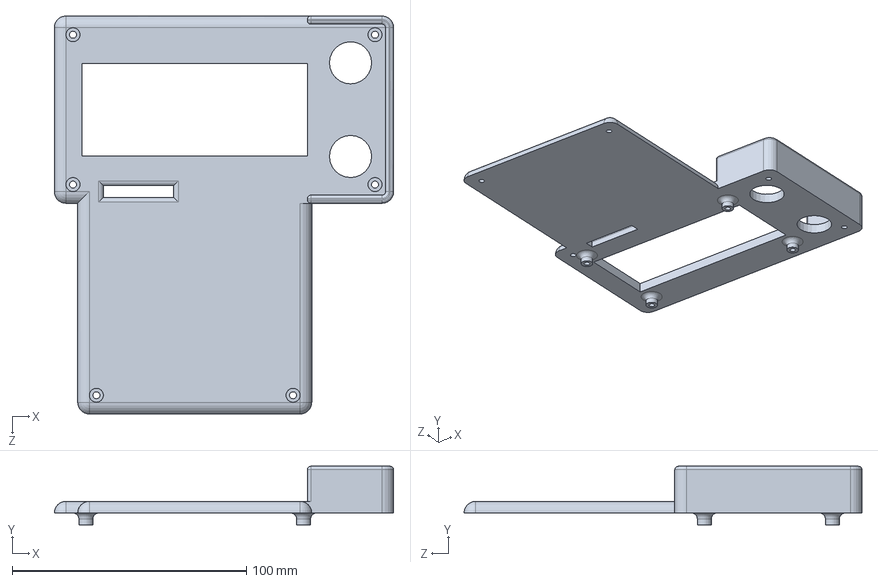
[picture p112: CAD file, 2024-11-13]
3D Design/PCB Bracket/Pendant Case/Top Part Pendant V2.SLDPRT
145.0 x 25.0 x 170.0 mm
