AlfonsusGiovanni/Welding-Arm-Manipulator/Schematic & PCB Design/Box Panel/Schematic Box Panel/Power Schematic/Single-Line-Power.dxf

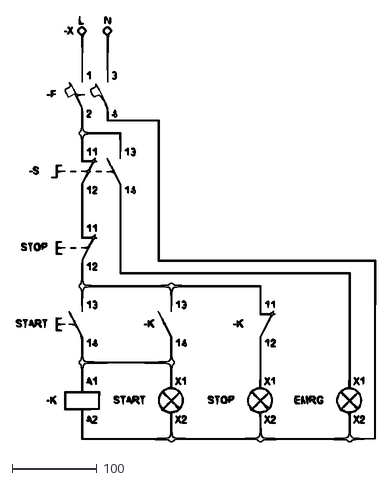
[picture p113: CAD file, 2024-06-12]
Schematic & PCB Design/Box Panel/Schematic Box Panel/Power Schematic/Single-Line-Power.dxf
423.1 x 501.4
