AlfonsusGiovanni/Welding-Arm-Manipulator/3D Design/PCB Bracket/Pendant Case/DXF/Top Part Pendant V2 - Front.DXF

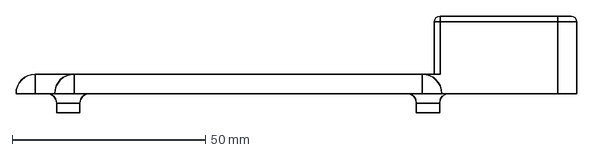
[picture p114: CAD file, 2024-10-28]
3D Design/PCB Bracket/Pendant Case/DXF/Top Part Pendant V2 - Front.DXF
145.0 x 25.0 mm
