AlfonsusGiovanni/Welding-Arm-Manipulator/3D Design/Robot Dummy/End Effector.SLDPRT

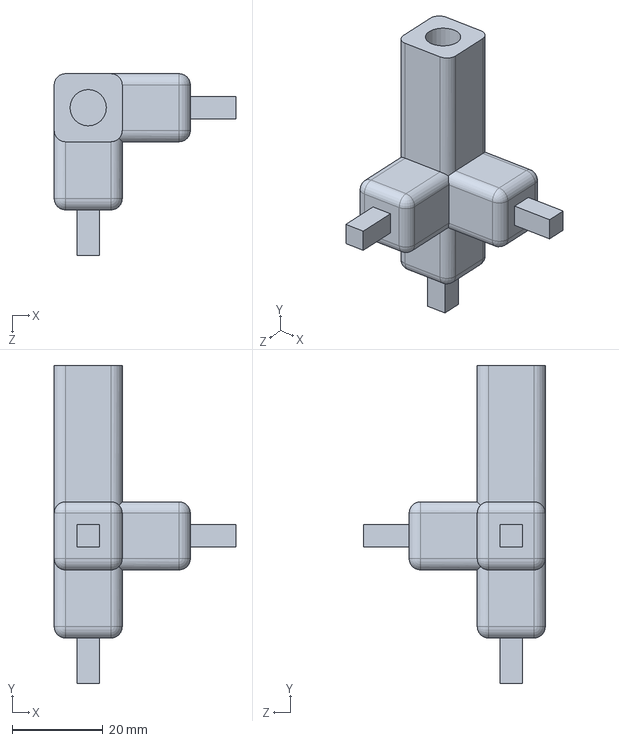
[picture p115: CAD file, 2024-12-29]
3D Design/Robot Dummy/End Effector.SLDPRT
40.0 x 70.0 x 40.0 mm
