AlfonsusGiovanni/Welding-Arm-Manipulator/3D Design/Base Part/Base Manipulator New.SLDPRT

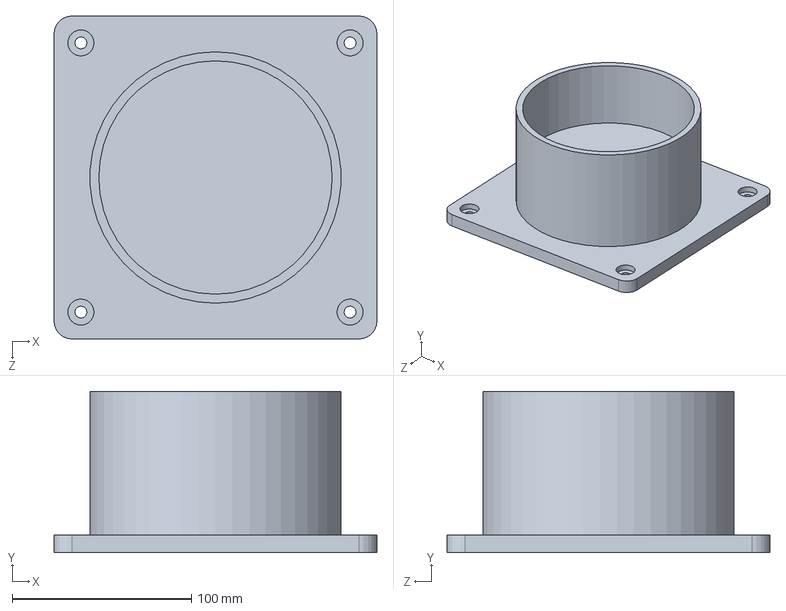
[picture p116: CAD file, 2024-07-30]
3D Design/Base Part/Base Manipulator New.SLDPRT
180.0 x 90.0 x 180.0 mm
