AlfonsusGiovanni/Welding-Arm-Manipulator/3D Design/PCB Bracket/Pendant Case/DXF/Top Part Pendant V2 - Bottom.DXF

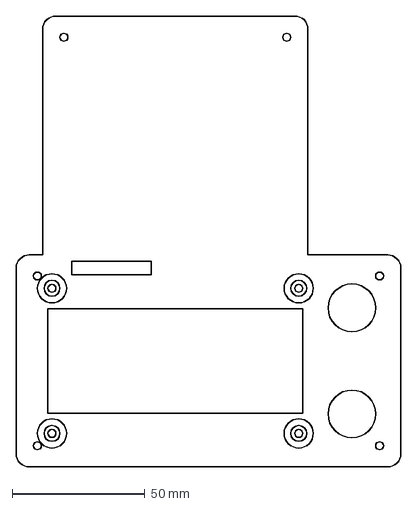
[picture p117: CAD file, 2024-10-28]
3D Design/PCB Bracket/Pendant Case/DXF/Top Part Pendant V2 - Bottom.DXF
145.0 x 170.0 mm
