AlfonsusGiovanni/Welding-Arm-Manipulator/3D Design/Robot Dummy/Arm3.SLDPRT

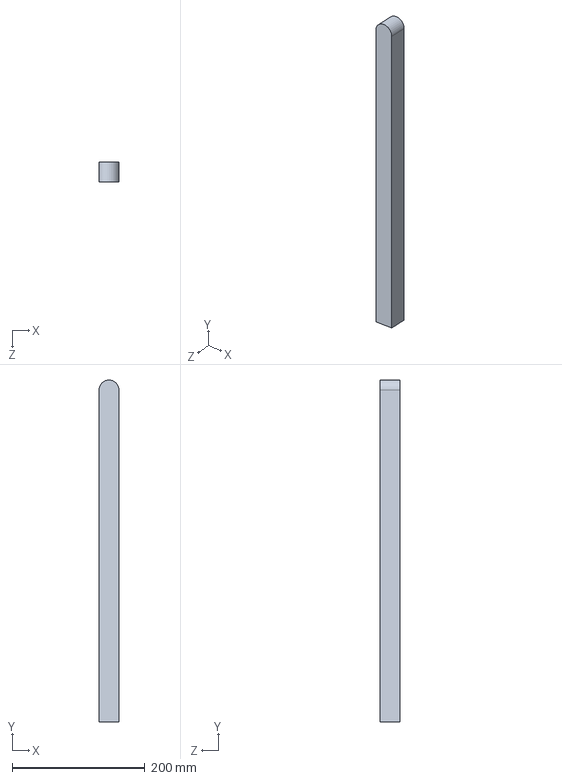
[picture p118: CAD file, 2024-12-29]
3D Design/Robot Dummy/Arm3.SLDPRT
30.0 x 515.0 x 30.0 mm
