AlfonsusGiovanni/Welding-Arm-Manipulator/3D Design/PCB Bracket/Pendant Case/Bottom Part Pendant V2.SLDPRT

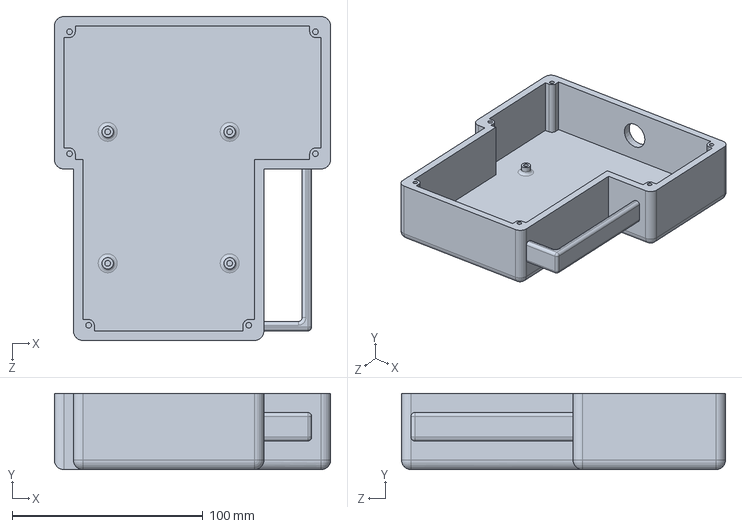
[picture p119: CAD file, 2024-10-28]
3D Design/PCB Bracket/Pendant Case/Bottom Part Pendant V2.SLDPRT
145.0 x 40.0 x 170.0 mm
