AlfonsusGiovanni/Welding-Arm-Manipulator/3D Design/PCB Bracket/Pendant Case/DXF/Pendant Case Assem V2 - Top.DXF

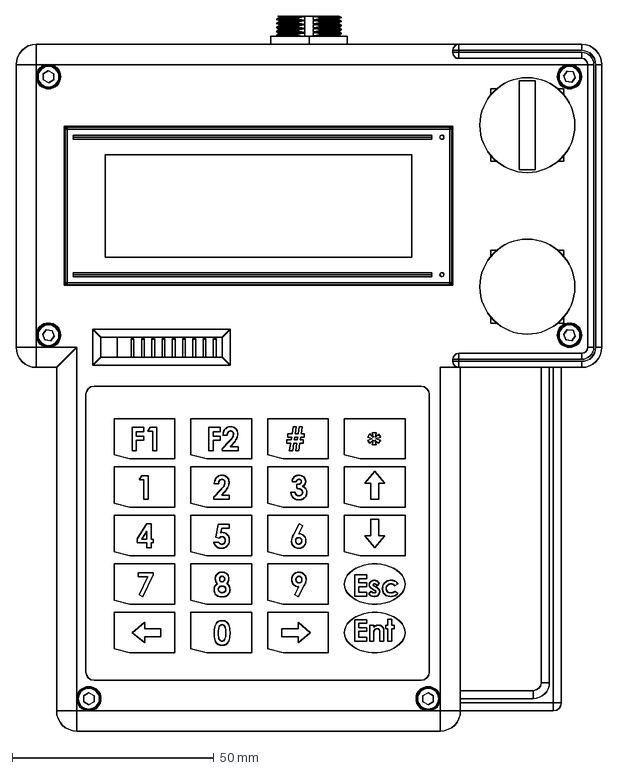
[picture p120: CAD file, 2024-10-28]
3D Design/PCB Bracket/Pendant Case/DXF/Pendant Case Assem V2 - Top.DXF
145.0 x 177.0 mm
