AlfonsusGiovanni/Welding-Arm-Manipulator/3D Design/Robot Dummy/Joint.SLDPRT

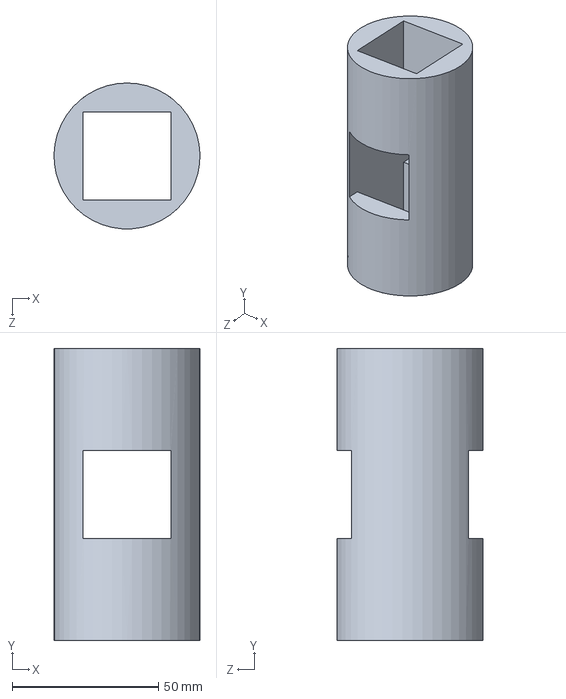
[picture p121: CAD file, 2024-12-29]
3D Design/Robot Dummy/Joint.SLDPRT
50.0 x 100.0 x 50.0 mm
