AlfonsusGiovanni/Welding-Arm-Manipulator/3D Design/PCB Bracket/Pendant Case/DXF/RS-232+Pendant - Top.DXF

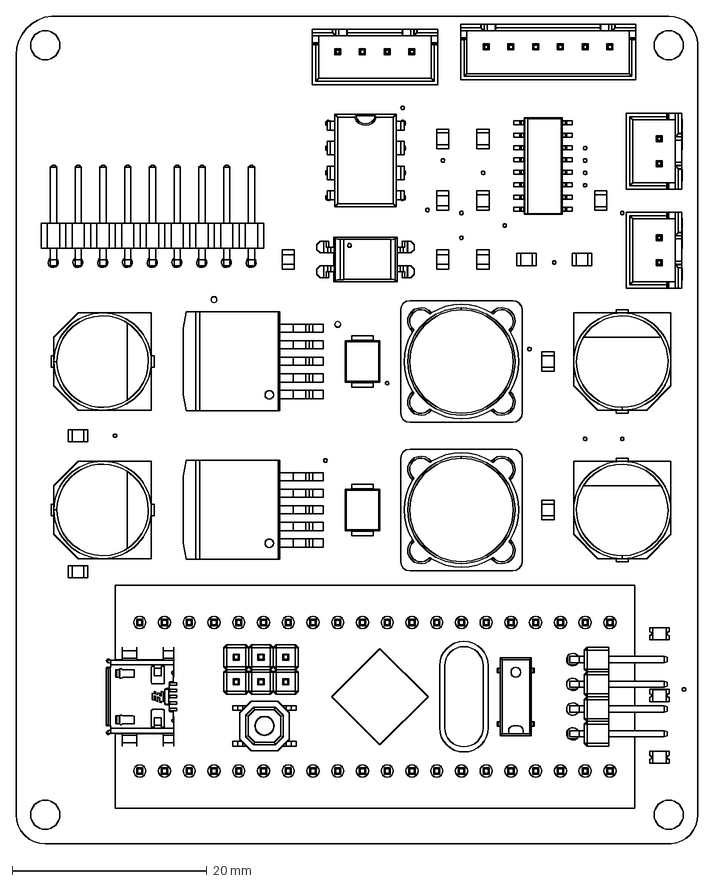
[picture p122: CAD file, 2024-10-28]
3D Design/PCB Bracket/Pendant Case/DXF/RS-232+Pendant - Top.DXF
70.0 x 85.0 mm
