AlfonsusGiovanni/Welding-Arm-Manipulator/3D Design/Robot Dummy/Arm2.SLDPRT

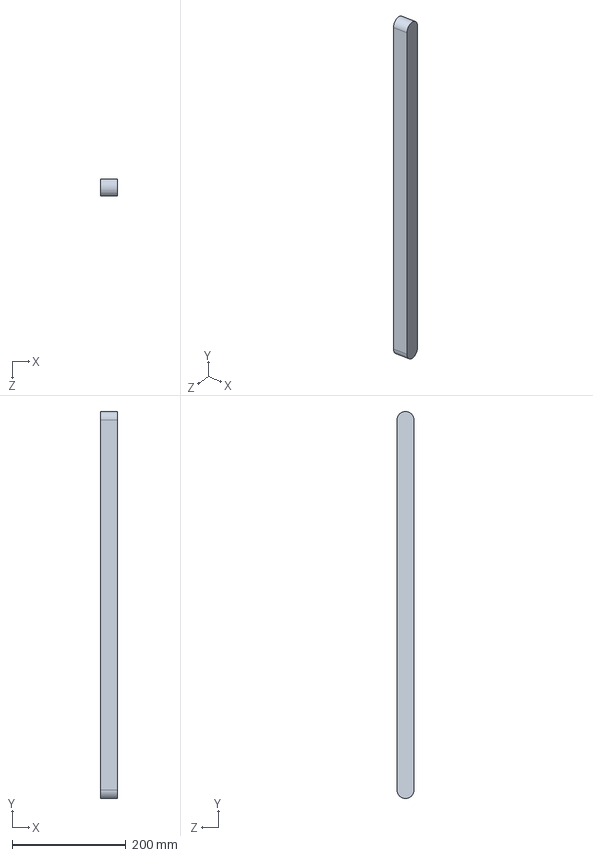
[picture p123: CAD file, 2024-12-29]
3D Design/Robot Dummy/Arm2.SLDPRT
30.0 x 679.8 x 30.0 mm
