AlfonsusGiovanni/Welding-Arm-Manipulator/3D Design/Robot Dummy/Joint T.SLDPRT

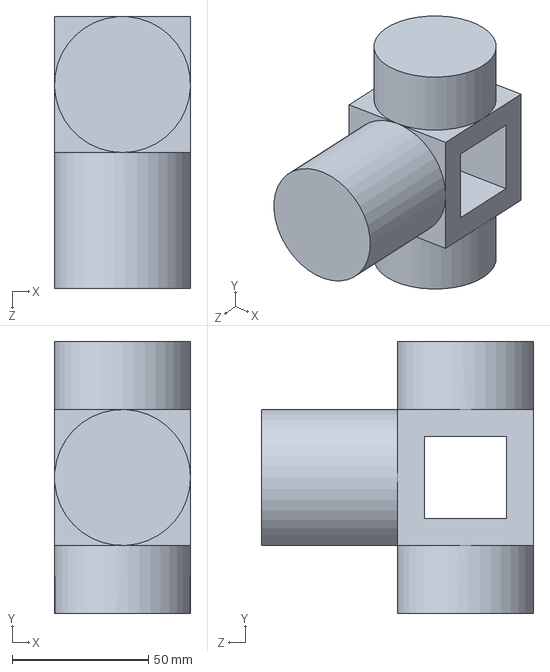
[picture p125: CAD file, 2024-12-29]
3D Design/Robot Dummy/Joint T.SLDPRT
50.0 x 100.0 x 100.0 mm
