AlfonsusGiovanni/Welding-Arm-Manipulator/3D Design/PCB Bracket/Encoder Bracket/Bottom Bracket Part.STEP

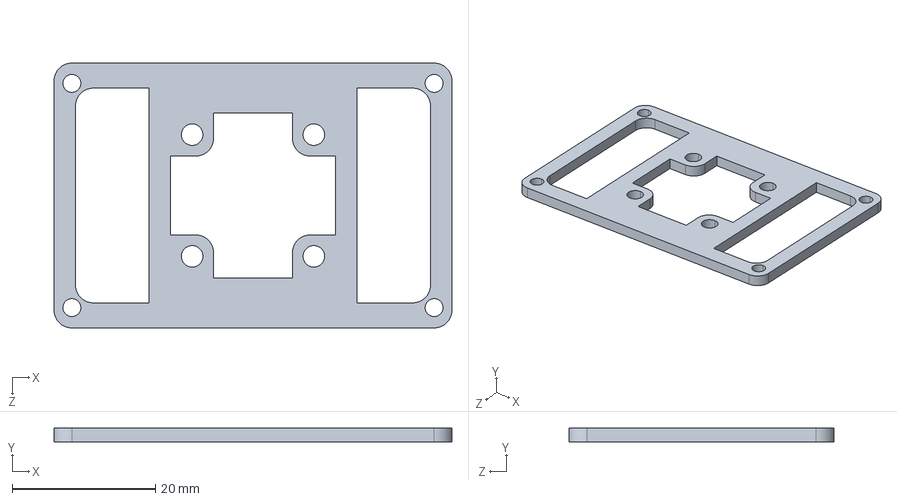
[picture p126: CAD file, 2025-02-18]
3D Design/PCB Bracket/Encoder Bracket/Bottom Bracket Part.STEP
55.6 x 2.00 x 37.0 mm
