AlfonsusGiovanni/Welding-Arm-Manipulator/3D Design/PCB Bracket/Pendant Case/DXF/Top Part Pendant V2 - Right.DXF

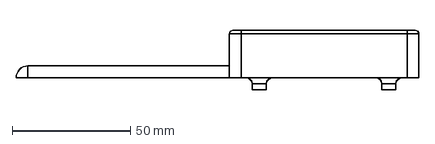
[picture p127: CAD file, 2024-10-28]
3D Design/PCB Bracket/Pendant Case/DXF/Top Part Pendant V2 - Right.DXF
170.0 x 25.0 mm
