AlfonsusGiovanni/Welding-Arm-Manipulator/3D Design/Robot Dummy/Arm1.SLDPRT

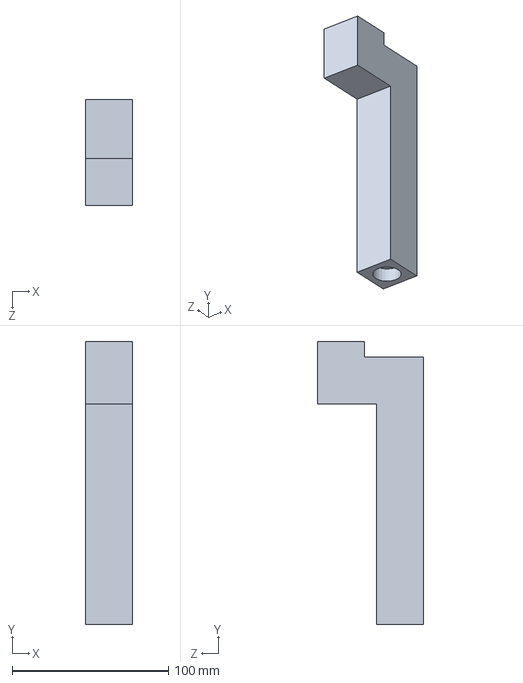
[picture p128: CAD file, 2024-12-29]
3D Design/Robot Dummy/Arm1.SLDPRT
30.0 x 181.0 x 67.7 mm
