AlfonsusGiovanni/Welding-Arm-Manipulator/3D Design/PCB Bracket/Pendant Case/DXF/Bottom Part Pendant V2 -Top.DXF

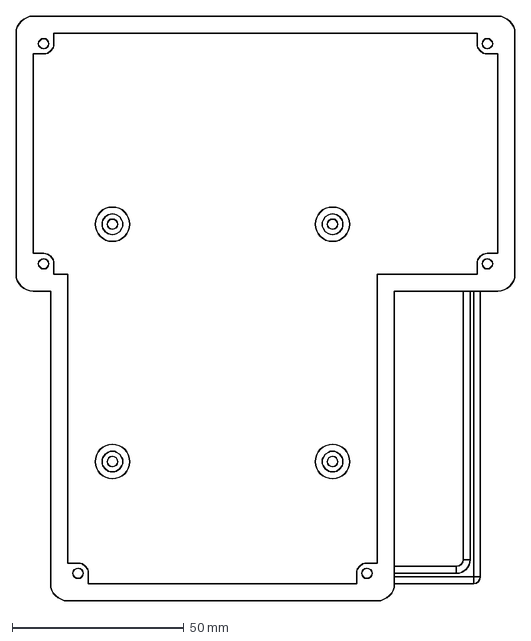
[picture p129: CAD file, 2024-10-28]
3D Design/PCB Bracket/Pendant Case/DXF/Bottom Part Pendant V2 -Top.DXF
145.0 x 170.0 mm
