AlfonsusGiovanni/Welding-Arm-Manipulator/3D Design/PCB Bracket/Pendant Case/DXF/Bottom Part Pendant V2 - Back.DXF

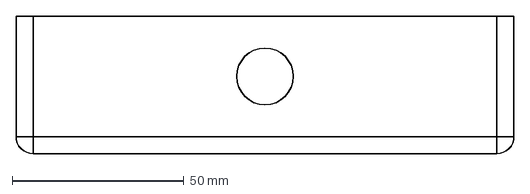
[picture p130: CAD file, 2024-10-28]
3D Design/PCB Bracket/Pendant Case/DXF/Bottom Part Pendant V2 - Back.DXF
145.0 x 40.0 mm
