AlfonsusGiovanni/Welding-Arm-Manipulator/3D Design/PCB Bracket/Pendant Case/DXF/Bottom Part Pendant V2 - Isometric.DXF

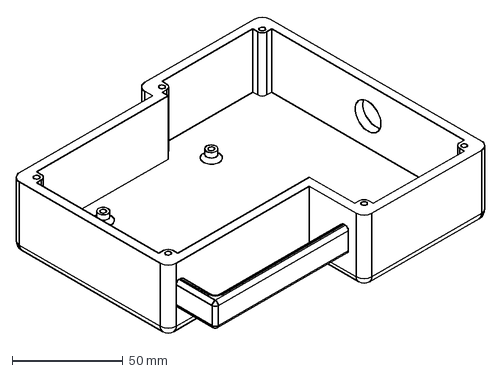
[picture p132: CAD file, 2024-10-28]
3D Design/PCB Bracket/Pendant Case/DXF/Bottom Part Pendant V2 - Isometric.DXF
211.5 x 143.1 mm
