AlfonsusGiovanni/Welding-Arm-Manipulator/3D Design/PCB Bracket/Encoder Bracket/Magnet Cover.SLDPRT

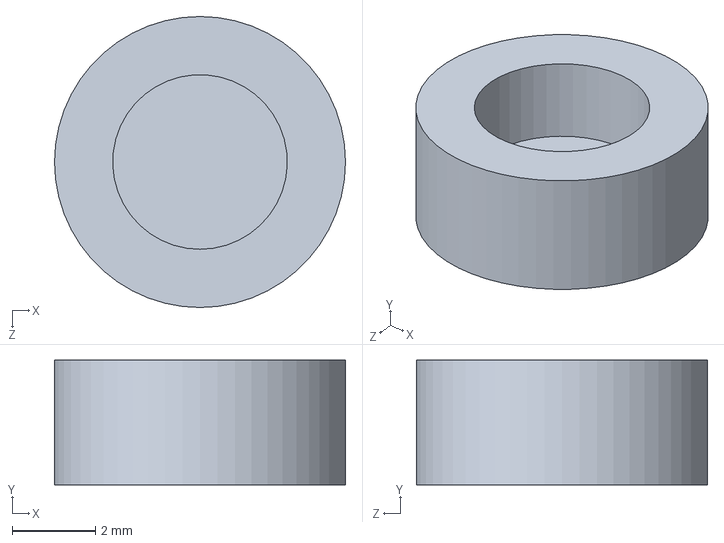
[picture p133: CAD file, 2025-02-18]
3D Design/PCB Bracket/Encoder Bracket/Magnet Cover.SLDPRT
7.00 x 3.00 x 7.00 mm
