AlfonsusGiovanni/Welding-Arm-Manipulator/3D Design/Secondary PCB/Secondary+PCB+Manipulator.SLDASM

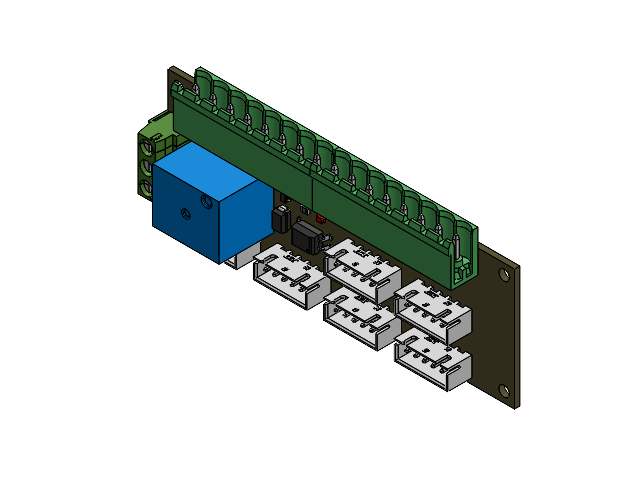
[picture p134: CAD file, 2024-07-10]
3D Design/Secondary PCB/Secondary+PCB+Manipulator.SLDASM
SOIC254P975X460-4N_1.stp
RELAY_SRD-05VDC-SL-C.stp
CUI_TBP04R1-500-08GR_1.stp x 2
B5B-XH-A.stp x 6
DO-214AC.stp
CHIP-LED0805_1.stp
R0805_1.stp x 2
SOT23.stp
TBLOK_3PIN.stp
Board_1.stp
