AlfonsusGiovanni/Welding-Arm-Manipulator/3D Design/Base Part/Arm Manipulator Base Assem.SLDASM

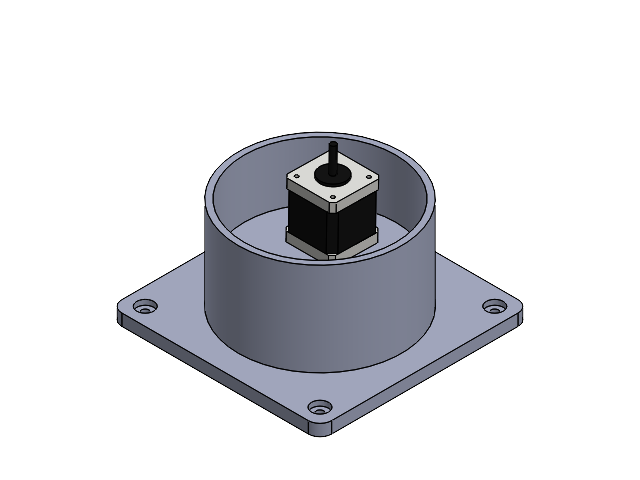
[picture p135: CAD file, 2024-07-30]
3D Design/Base Part/Arm Manipulator Base Assem.SLDASM
Nema 17 Stepper Motor v2.step
Base Manipulator New
