AlfonsusGiovanni/Welding-Arm-Manipulator/3D Design/PCB Bracket/Pendant Case/Pendant Case Assem.SLDASM

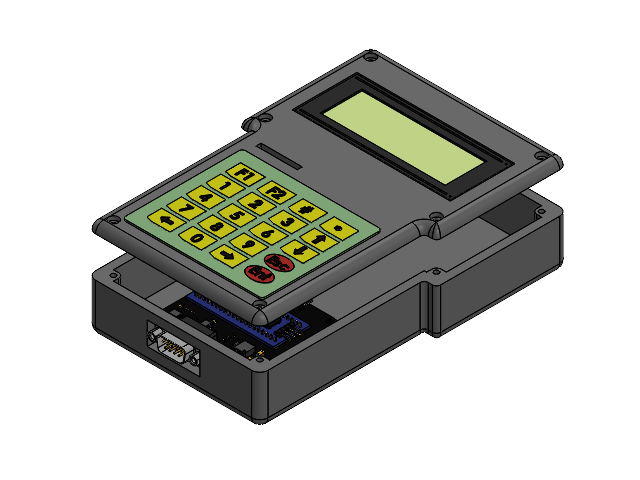
[picture p136: CAD file, 2024-10-28]
3D Design/PCB Bracket/Pendant Case/Pendant Case Assem.SLDASM
Bottom Part Pendant
20X4LCD JHD204A
Oscillator_HC-49_S v1.stp
STM32F103C8T6_BluePill_Board v6.stp
Oscillator_MC-306 v3.stp
STM32_LQFP48 v3.stp
Tactile_SMD_5x5mm v1.stp
micro_usb_socket v1.stp
Header_L4_10x4.8 v6.stp
Header_Male_2x3x11.6 v2.stp
Header_Male_1x20x11.6 v2.stp x 2
Body004.stp x 4
Body005.stp x 5
Body.stp
Body001.stp
Body002 (Mirror #1).stp
Body003 (Mirror #2).stp
Body002.stp
Body003.stp
SOIC127P600X175-8N.stp
10040.stp
SOIC127P600X175-16N.stp
SOT-23-8.stp
1X04_90.stp
1X09_90.stp
C0603.stp x 2
C0805.stp x 6
C1210.stp x 2
R0603.stp x 6
R0805.stp x 2
Board.stp
Matrix_Keypad_4x5
Top Part Pendant
