AlfonsusGiovanni/Welding-Arm-Manipulator/3D Design/PCB Bracket/Main PCB Case/Assem1.SLDASM

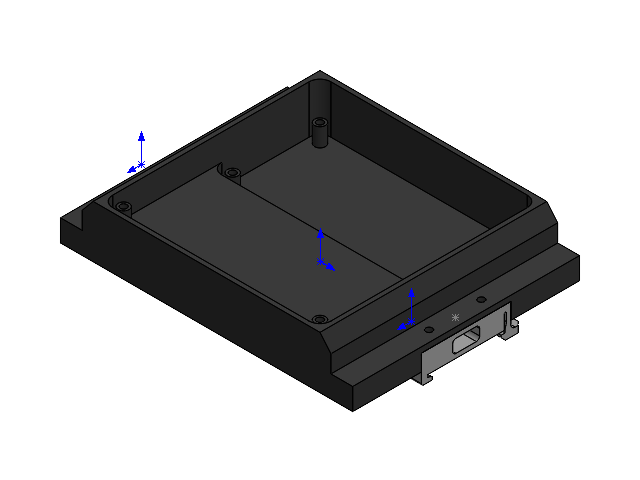
[picture p137: CAD file, 2024-06-12]
3D Design/PCB Bracket/Main PCB Case/Assem1.SLDASM
Frame PLC
All_Parts-Линейный массив1 x 2
