AlfonsusGiovanni/Welding-Arm-Manipulator/3D Design/PCB Bracket/Encoder Bracket/Encoder Bracket Assem.SLDASM

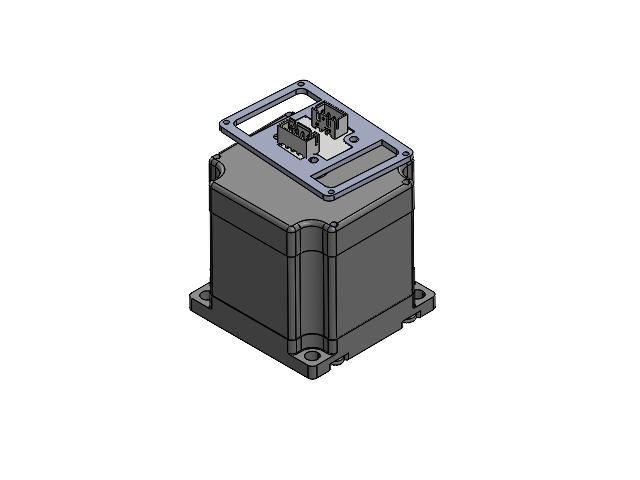
[picture p139: CAD file, 2025-02-18]
3D Design/PCB Bracket/Encoder Bracket/Encoder Bracket Assem.SLDASM
NEMA 23 - 56mm_1.STEP
pan head cross recess screw_iso_ISO 7045 - M3 x 10 - Z - 10N.STEP x 4
Bottom Bracket Part
AS5600 v1
CONNECTOR WHITE JST XH 4 PIN - 2,54 mm.stp
CONNECTOR WHITE JST XH 3 PIN - 2,54 mm.stp
