AlfonsusGiovanni/Welding-Arm-Manipulator/(list of files, cad)

Other CAD files:
2D Design/Main Case/Main Case PCB Overview.dxf
2D Design/Main PCB/Main PCB Overview.dwg
3D Design/PCB Bracket/Encoder Bracket/Packages.stp.SLDASM
2D Design/Analisa IK/6-DOF Inverse Kinematics.dwg
2D Design/Arm/Arm Manipulator.dwg
2D Design/Box Panel Kontrol/Box Panel TA.dwg
2D Design/Pendant Case/Pendant Case Dimension.dwg
2D Design/Pendant PCB/Pendant PCB Overview.dwg
3D Design/PCB Bracket/Encoder Bracket/CUI_TBP04R1-500-08GR (1).stp.SLDPRT
Referensi/IRB1520ID_-_IRC5_rev2_dxfdwg_j/DWG DXF_2D/IRB1520ID_rev02_2.DWG
3D Design/PCB Bracket/Encoder Bracket/CUI_TBP04R1-500-06BE.stp.SLDPRT
3D Design/PCB Bracket/Encoder Bracket/Board.stp.SLDPRT
Referensi/IRB1520ID_-_IRC5_rev2_dxfdwg_j/DWG DXF_2D/IRB1520ID_WorkRange_rev02_1.DWG
3D Design/PCB Bracket/Encoder Bracket/INDP125125X600N.stp.SLDPRT
3D Design/PCB Bracket/Encoder Bracket/C0805.stp.SLDPRT
3D Design/PCB Bracket/Encoder Bracket/R0805.stp.SLDPRT
3D Design/PCB Bracket/Encoder Bracket/KTT0005B.stp.SLDPRT
3D Design/PCB Bracket/Encoder Bracket/CHIP-LED0805.stp.SLDPRT
3D Design/PCB Bracket/Encoder Bracket/SMB.stp.SLDPRT
3D Design/PCB Bracket/Encoder Bracket/PDIP_8.stp.SLDPRT
3D Design/PCB Bracket/Encoder Bracket/STM32H7.stp.SLDPRT
3D Design/PCB Bracket/Encoder Bracket/SOIC127P600X175-16N.stp.SLDPRT
3D Design/PCB Bracket/Encoder Bracket/153CLV-1010.stp.SLDPRT
3D Design/PCB Bracket/Encoder Bracket/SOIC254P975X460-4N.stp.SLDPRT
3D Design/PCB Bracket/Encoder Bracket/CUI_TBP04R1-500-04BE.stp.SLDPRT
3D Design/PCB Bracket/Encoder Bracket/DISPLAY-OLED-128X64-I2C.stp.SLDPRT
3D Design/PCB Bracket/Encoder Bracket/CAPPRD500W60D1000H2500.stp.SLDPRT
3D Design/PCB Bracket/Encoder Bracket/Bottom Bracket Part.SLDPRT
3D Design/PCB Bracket/Encoder Bracket/Print/Bottom Bracket Part.STL
3D Design/PCB Bracket/Encoder Bracket/Print/Magnet Cover.STL
3D Design/PCB Bracket/Main PCB Case/Main PCB Case V1.SLDPRT
3D Design/PCB Bracket/Main PCB Case/Print/Main PCB Case V2 - Revisi.STL
3D Design/PCB Bracket/Pendant Case/Bottom Part Pendant.SLDPRT
3D Design/PCB Bracket/Pendant Case/Print/Bottom Part Pendant V2.STL
3D Design/PCB Bracket/Pendant Case/Print/Top Part Pendant V2.STL
3D Design/PCB Bracket/Pendant Case/Top Part Pendant.DXF
3D Design/PCB Bracket/Pendant Case/Top Part Pendant.SLDPRT
3D Design/PCB Bracket/Pendant Case/Top Part Pendant.dwg
Referensi/IRB1520ID_-_IRC5_rev2_dxfdwg_j/DWG DXF_2D/IRB1520ID_rev02_1.DWG
