AlfonsusGiovanni/Welding-Arm-Manipulator/Dokumen Perancangan/Analisa Step Terhadap RPM Maksimal.xlsx

Tanpa Gearbox
Step | 1 Rev Time (s) | RPM | Pulse Width (us) | f (kHz) | Voltage
200 | 0.2 | 300 | 1000 | 1 | 24V
800 | 0.144 | 416.6666667 | 180 | 5.555555556 | 24V
1600 | 0.144 | 416.6666667 | 90 | 11.11111111 | 30V
3200 | 0.16 | 375 | 50 | 20 | 30V
6400
Dengan Gearbox 1:36
Step | 1 Rev Time (s) | RPM | Pulse Width
200
800
1600
3200
6400
