AlfonsusGiovanni/Welding-Arm-Manipulator/Program/STM32 Arm Manipulator Testing/MDK-ARM/STM32 Arm Manipulator Testing/STM32 Arm Manipulator Testing.htm

# Static Call Graph for image STM32 Arm Manipulator Testing\STM32 Arm Manipulator Testing.axf

#<CALLGRAPH># ARM Linker, 5060960: Last Updated: Fri Jan 10 00:26:53 2025

### Maximum Stack Usage = 152 bytes + Unknown(Functions without stacksize, Cycles, Untraceable Function Pointers)

### Call chain for Maximum Stack Depth:

__rt_entry_main ⇒ main ⇒ MX_TIM1_Init ⇒ HAL_TIM_Encoder_Init ⇒ HAL_TIM_Encoder_MspInit ⇒ HAL_GPIO_Init

### Functions with no stack information

- __user_initial_stackheap

### Mutually Recursive functions

- ADC1_2_IRQHandler ⇒ ADC1_2_IRQHandler
- BusFault_Handler ⇒ BusFault_Handler
- HardFault_Handler ⇒ HardFault_Handler
- MemManage_Handler ⇒ MemManage_Handler
- UsageFault_Handler ⇒ UsageFault_Handler

### Function Pointers

- ADC1_2_IRQHandler from startup_stm32f103xb.o(.text) referenced from startup_stm32f103xb.o(RESET)
- BusFault_Handler from stm32f1xx_it.o(i.BusFault_Handler) referenced from startup_stm32f103xb.o(RESET)
- CAN1_RX1_IRQHandler from startup_stm32f103xb.o(.text) referenced from startup_stm32f103xb.o(RESET)
- CAN1_SCE_IRQHandler from startup_stm32f103xb.o(.text) referenced from startup_stm32f103xb.o(RESET)
- DMA1_Channel1_IRQHandler from startup_stm32f103xb.o(.text) referenced from startup_stm32f103xb.o(RESET)
- DMA1_Channel2_IRQHandler from startup_stm32f103xb.o(.text) referenced from startup_stm32f103xb.o(RESET)
- DMA1_Channel3_IRQHandler from startup_stm32f103xb.o(.text) referenced from startup_stm32f103xb.o(RESET)
- DMA1_Channel4_IRQHandler from stm32f1xx_it.o(i.DMA1_Channel4_IRQHandler) referenced from startup_stm32f103xb.o(RESET)
- DMA1_Channel5_IRQHandler from stm32f1xx_it.o(i.DMA1_Channel5_IRQHandler) referenced from startup_stm32f103xb.o(RESET)
- DMA1_Channel6_IRQHandler from stm32f1xx_it.o(i.DMA1_Channel6_IRQHandler) referenced from startup_stm32f103xb.o(RESET)
- DMA1_Channel7_IRQHandler from stm32f1xx_it.o(i.DMA1_Channel7_IRQHandler) referenced from startup_stm32f103xb.o(RESET)
- DebugMon_Handler from stm32f1xx_it.o(i.DebugMon_Handler) referenced from startup_stm32f103xb.o(RESET)
- EXTI0_IRQHandler from startup_stm32f103xb.o(.text) referenced from startup_stm32f103xb.o(RESET)
- EXTI15_10_IRQHandler from startup_stm32f103xb.o(.text) referenced from startup_stm32f103xb.o(RESET)
- EXTI1_IRQHandler from startup_stm32f103xb.o(.text) referenced from startup_stm32f103xb.o(RESET)
- EXTI2_IRQHandler from startup_stm32f103xb.o(.text) referenced from startup_stm32f103xb.o(RESET)
- EXTI3_IRQHandler from startup_stm32f103xb.o(.text) referenced from startup_stm32f103xb.o(RESET)
- EXTI4_IRQHandler from startup_stm32f103xb.o(.text) referenced from startup_stm32f103xb.o(RESET)
- EXTI9_5_IRQHandler from startup_stm32f103xb.o(.text) referenced from startup_stm32f103xb.o(RESET)
- FLASH_IRQHandler from startup_stm32f103xb.o(.text) referenced from startup_stm32f103xb.o(RESET)
- HardFault_Handler from stm32f1xx_it.o(i.HardFault_Handler) referenced from startup_stm32f103xb.o(RESET)
- I2C1_ER_IRQHandler from startup_stm32f103xb.o(.text) referenced from startup_stm32f103xb.o(RESET)
- I2C1_EV_IRQHandler from startup_stm32f103xb.o(.text) referenced from startup_stm32f103xb.o(RESET)
- I2C2_ER_IRQHandler from startup_stm32f103xb.o(.text) referenced from startup_stm32f103xb.o(RESET)
- I2C2_EV_IRQHandler from startup_stm32f103xb.o(.text) referenced from startup_stm32f103xb.o(RESET)
- MemManage_Handler from stm32f1xx_it.o(i.MemManage_Handler) referenced from startup_stm32f103xb.o(RESET)
- NMI_Handler from stm32f1xx_it.o(i.NMI_Handler) referenced from startup_stm32f103xb.o(RESET)
- PVD_IRQHandler from startup_stm32f103xb.o(.text) referenced from startup_stm32f103xb.o(RESET)
- PendSV_Handler from stm32f1xx_it.o(i.PendSV_Handler) referenced from startup_stm32f103xb.o(RESET)
- RCC_IRQHandler from startup_stm32f103xb.o(.text) referenced from startup_stm32f103xb.o(RESET)
- RTC_Alarm_IRQHandler from startup_stm32f103xb.o(.text) referenced from startup_stm32f103xb.o(RESET)
- RTC_IRQHandler from startup_stm32f103xb.o(.text) referenced from startup_stm32f103xb.o(RESET)
- Reset_Handler from startup_stm32f103xb.o(.text) referenced from startup_stm32f103xb.o(RESET)
- SPI1_IRQHandler from startup_stm32f103xb.o(.text) referenced from startup_stm32f103xb.o(RESET)
- SPI2_IRQHandler from startup_stm32f103xb.o(.text) referenced from startup_stm32f103xb.o(RESET)
- SVC_Handler from stm32f1xx_it.o(i.SVC_Handler) referenced from startup_stm32f103xb.o(RESET)
- SysTick_Handler from stm32f1xx_it.o(i.SysTick_Handler) referenced from startup_stm32f103xb.o(RESET)
- SystemInit from system_stm32f1xx.o(i.SystemInit) referenced from startup_stm32f103xb.o(.text)
- TAMPER_IRQHandler from startup_stm32f103xb.o(.text) referenced from startup_stm32f103xb.o(RESET)
- TIM1_BRK_IRQHandler from startup_stm32f103xb.o(.text) referenced from startup_stm32f103xb.o(RESET)
- TIM1_CC_IRQHandler from stm32f1xx_it.o(i.TIM1_CC_IRQHandler) referenced from startup_stm32f103xb.o(RESET)
- TIM1_TRG_COM_IRQHandler from startup_stm32f103xb.o(.text) referenced from startup_stm32f103xb.o(RESET)
- TIM1_UP_IRQHandler from startup_stm32f103xb.o(.text) referenced from startup_stm32f103xb.o(RESET)
- TIM2_IRQHandler from startup_stm32f103xb.o(.text) referenced from startup_stm32f103xb.o(RESET)
- TIM3_IRQHandler from startup_stm32f103xb.o(.text) referenced from startup_stm32f103xb.o(RESET)
- TIM4_IRQHandler from startup_stm32f103xb.o(.text) referenced from startup_stm32f103xb.o(RESET)
- USART1_IRQHandler from startup_stm32f103xb.o(.text) referenced from startup_stm32f103xb.o(RESET)
- USART2_IRQHandler from startup_stm32f103xb.o(.text) referenced from startup_stm32f103xb.o(RESET)
- USART3_IRQHandler from startup_stm32f103xb.o(.text) referenced from startup_stm32f103xb.o(RESET)
- USBWakeUp_IRQHandler from startup_stm32f103xb.o(.text) referenced from startup_stm32f103xb.o(RESET)
- USB_HP_CAN1_TX_IRQHandler from startup_stm32f103xb.o(.text) referenced from startup_stm32f103xb.o(RESET)
- USB_LP_CAN1_RX0_IRQHandler from startup_stm32f103xb.o(.text) referenced from startup_stm32f103xb.o(RESET)
- UsageFault_Handler from stm32f1xx_it.o(i.UsageFault_Handler) referenced from startup_stm32f103xb.o(RESET)
- WWDG_IRQHandler from startup_stm32f103xb.o(.text) referenced from startup_stm32f103xb.o(RESET)
- __main from __main.o(!!!main) referenced from startup_stm32f103xb.o(.text)

### Global Symbols

__main (Thumb, 8 bytes, Stack size 0 bytes, __main.o(!!!main))

[Calls]

- >> __rt_entry
- >> __scatterload

__scatterload (Thumb, 0 bytes, Stack size unknown bytes, __scatter.o(!!!scatter))

[Called By]

- >> __main

__scatterload_rt2 (Thumb, 44 bytes, Stack size unknown bytes, __scatter.o(!!!scatter), UNUSED)

[Calls]

- >> __rt_entry

__scatterload_rt2_thumb_only (Thumb, 0 bytes, Stack size unknown bytes, __scatter.o(!!!scatter), UNUSED)

__scatterload_null (Thumb, 0 bytes, Stack size unknown bytes, __scatter.o(!!!scatter), UNUSED)

__scatterload_copy (Thumb, 26 bytes, Stack size unknown bytes, __scatter_copy.o(!!handler_copy), UNUSED)

[Calls]

- >> __scatterload_copy

[Called By]

- >> __scatterload_copy

__scatterload_zeroinit (Thumb, 28 bytes, Stack size unknown bytes, __scatter_zi.o(!!handler_zi), UNUSED)

__rt_lib_init (Thumb, 0 bytes, Stack size unknown bytes, libinit.o(.ARM.Collect$$libinit$$00000000))

[Called By]

- >> __rt_entry_li

__rt_lib_init_alloca_1 (Thumb, 0 bytes, Stack size unknown bytes, libinit2.o(.ARM.Collect$$libinit$$0000002E))

__rt_lib_init_argv_1 (Thumb, 0 bytes, Stack size unknown bytes, libinit2.o(.ARM.Collect$$libinit$$0000002C))

__rt_lib_init_atexit_1 (Thumb, 0 bytes, Stack size unknown bytes, libinit2.o(.ARM.Collect$$libinit$$0000001B))

__rt_lib_init_clock_1 (Thumb, 0 bytes, Stack size unknown bytes, libinit2.o(.ARM.Collect$$libinit$$00000021))

__rt_lib_init_cpp_1 (Thumb, 0 bytes, Stack size unknown bytes, libinit2.o(.ARM.Collect$$libinit$$00000032))

__rt_lib_init_exceptions_1 (Thumb, 0 bytes, Stack size unknown bytes, libinit2.o(.ARM.Collect$$libinit$$00000030))

__rt_lib_init_fp_1 (Thumb, 0 bytes, Stack size unknown bytes, libinit2.o(.ARM.Collect$$libinit$$00000002))

__rt_lib_init_fp_trap_1 (Thumb, 0 bytes, Stack size unknown bytes, libinit2.o(.ARM.Collect$$libinit$$0000001F))

__rt_lib_init_getenv_1 (Thumb, 0 bytes, Stack size unknown bytes, libinit2.o(.ARM.Collect$$libinit$$00000023))

__rt_lib_init_heap_1 (Thumb, 0 bytes, Stack size unknown bytes, libinit2.o(.ARM.Collect$$libinit$$0000000A))

__rt_lib_init_lc_collate_1 (Thumb, 0 bytes, Stack size unknown bytes, libinit2.o(.ARM.Collect$$libinit$$00000011))

__rt_lib_init_lc_ctype_1 (Thumb, 0 bytes, Stack size unknown bytes, libinit2.o(.ARM.Collect$$libinit$$00000013))

__rt_lib_init_lc_monetary_1 (Thumb, 0 bytes, Stack size unknown bytes, libinit2.o(.ARM.Collect$$libinit$$00000015))

__rt_lib_init_lc_numeric_1 (Thumb, 0 bytes, Stack size unknown bytes, libinit2.o(.ARM.Collect$$libinit$$00000017))

__rt_lib_init_lc_time_1 (Thumb, 0 bytes, Stack size unknown bytes, libinit2.o(.ARM.Collect$$libinit$$00000019))

__rt_lib_init_preinit_1 (Thumb, 0 bytes, Stack size unknown bytes, libinit2.o(.ARM.Collect$$libinit$$00000004))

__rt_lib_init_rand_1 (Thumb, 0 bytes, Stack size unknown bytes, libinit2.o(.ARM.Collect$$libinit$$0000000E))

__rt_lib_init_return (Thumb, 0 bytes, Stack size unknown bytes, libinit2.o(.ARM.Collect$$libinit$$00000033))

__rt_lib_init_signal_1 (Thumb, 0 bytes, Stack size unknown bytes, libinit2.o(.ARM.Collect$$libinit$$0000001D))

__rt_lib_init_stdio_1 (Thumb, 0 bytes, Stack size unknown bytes, libinit2.o(.ARM.Collect$$libinit$$00000025))

__rt_lib_init_user_alloc_1 (Thumb, 0 bytes, Stack size unknown bytes, libinit2.o(.ARM.Collect$$libinit$$0000000C))

__rt_lib_shutdown (Thumb, 0 bytes, Stack size unknown bytes, libshutdown.o(.ARM.Collect$$libshutdown$$00000000))

[Called By]

- >> __rt_exit_ls

__rt_lib_shutdown_cpp_1 (Thumb, 0 bytes, Stack size unknown bytes, libshutdown2.o(.ARM.Collect$$libshutdown$$00000004))

__rt_lib_shutdown_fini_1 (Thumb, 0 bytes, Stack size unknown bytes, libshutdown2.o(.ARM.Collect$$libshutdown$$00000002))

__rt_lib_shutdown_fp_trap_1 (Thumb, 0 bytes, Stack size unknown bytes, libshutdown2.o(.ARM.Collect$$libshutdown$$00000009))

__rt_lib_shutdown_heap_1 (Thumb, 0 bytes, Stack size unknown bytes, libshutdown2.o(.ARM.Collect$$libshutdown$$00000011))

__rt_lib_shutdown_return (Thumb, 0 bytes, Stack size unknown bytes, libshutdown2.o(.ARM.Collect$$libshutdown$$00000012))

__rt_lib_shutdown_signal_1 (Thumb, 0 bytes, Stack size unknown bytes, libshutdown2.o(.ARM.Collect$$libshutdown$$0000000C))

__rt_lib_shutdown_stdio_1 (Thumb, 0 bytes, Stack size unknown bytes, libshutdown2.o(.ARM.Collect$$libshutdown$$00000006))

__rt_lib_shutdown_user_alloc_1 (Thumb, 0 bytes, Stack size unknown bytes, libshutdown2.o(.ARM.Collect$$libshutdown$$0000000E))

__rt_entry (Thumb, 0 bytes, Stack size unknown bytes, __rtentry.o(.ARM.Collect$$rtentry$$00000000))

[Called By]

- >> __main
- >> __scatterload_rt2

__rt_entry_presh_1 (Thumb, 0 bytes, Stack size unknown bytes, __rtentry2.o(.ARM.Collect$$rtentry$$00000002))

__rt_entry_sh (Thumb, 0 bytes, Stack size unknown bytes, __rtentry4.o(.ARM.Collect$$rtentry$$00000004))

[Stack]

- Max Depth = 8 + Unknown Stack Size
- Call Chain = __rt_entry_sh ⇒ __user_setup_stackheap

[Calls]

- >> __user_setup_stackheap

__rt_entry_li (Thumb, 0 bytes, Stack size unknown bytes, __rtentry2.o(.ARM.Collect$$rtentry$$0000000A))

[Calls]

- >> __rt_lib_init

__rt_entry_postsh_1 (Thumb, 0 bytes, Stack size unknown bytes, __rtentry2.o(.ARM.Collect$$rtentry$$00000009))

__rt_entry_main (Thumb, 0 bytes, Stack size unknown bytes, __rtentry2.o(.ARM.Collect$$rtentry$$0000000D))

[Stack]

- Max Depth = 152 + Unknown Stack Size
- Call Chain = __rt_entry_main ⇒ main ⇒ MX_TIM1_Init ⇒ HAL_TIM_Encoder_Init ⇒ HAL_TIM_Encoder_MspInit ⇒ HAL_GPIO_Init

[Calls]

- >> main
- >> exit

__rt_entry_postli_1 (Thumb, 0 bytes, Stack size unknown bytes, __rtentry2.o(.ARM.Collect$$rtentry$$0000000C))

__rt_exit (Thumb, 0 bytes, Stack size unknown bytes, rtexit.o(.ARM.Collect$$rtexit$$00000000))

[Called By]

- >> exit

__rt_exit_ls (Thumb, 0 bytes, Stack size unknown bytes, rtexit2.o(.ARM.Collect$$rtexit$$00000003))

[Calls]

- >> __rt_lib_shutdown

__rt_exit_prels_1 (Thumb, 0 bytes, Stack size unknown bytes, rtexit2.o(.ARM.Collect$$rtexit$$00000002))

__rt_exit_exit (Thumb, 0 bytes, Stack size unknown bytes, rtexit2.o(.ARM.Collect$$rtexit$$00000004))

[Calls]

- >> _sys_exit

Reset_Handler (Thumb, 8 bytes, Stack size 0 bytes, startup_stm32f103xb.o(.text))
[Address Reference Count : 1]

- startup_stm32f103xb.o(RESET)

ADC1_2_IRQHandler (Thumb, 0 bytes, Stack size 0 bytes, startup_stm32f103xb.o(.text))

[Calls]

- >> ADC1_2_IRQHandler

[Called By]

- >> ADC1_2_IRQHandler

[Address Reference Count : 1]

- startup_stm32f103xb.o(RESET)

CAN1_RX1_IRQHandler (Thumb, 0 bytes, Stack size 0 bytes, startup_stm32f103xb.o(.text))
[Address Reference Count : 1]

- startup_stm32f103xb.o(RESET)

CAN1_SCE_IRQHandler (Thumb, 0 bytes, Stack size 0 bytes, startup_stm32f103xb.o(.text))
[Address Reference Count : 1]

- startup_stm32f103xb.o(RESET)

DMA1_Channel1_IRQHandler (Thumb, 0 bytes, Stack size 0 bytes, startup_stm32f103xb.o(.text))
[Address Reference Count : 1]

- startup_stm32f103xb.o(RESET)

DMA1_Channel2_IRQHandler (Thumb, 0 bytes, Stack size 0 bytes, startup_stm32f103xb.o(.text))
[Address Reference Count : 1]

- startup_stm32f103xb.o(RESET)

DMA1_Channel3_IRQHandler (Thumb, 0 bytes, Stack size 0 bytes, startup_stm32f103xb.o(.text))
[Address Reference Count : 1]

- startup_stm32f103xb.o(RESET)

EXTI0_IRQHandler (Thumb, 0 bytes, Stack size 0 bytes, startup_stm32f103xb.o(.text))
[Address Reference Count : 1]

- startup_stm32f103xb.o(RESET)

EXTI15_10_IRQHandler (Thumb, 0 bytes, Stack size 0 bytes, startup_stm32f103xb.o(.text))
[Address Reference Count : 1]

- startup_stm32f103xb.o(RESET)

EXTI1_IRQHandler (Thumb, 0 bytes, Stack size 0 bytes, startup_stm32f103xb.o(.text))
[Address Reference Count : 1]

- startup_stm32f103xb.o(RESET)

EXTI2_IRQHandler (Thumb, 0 bytes, Stack size 0 bytes, startup_stm32f103xb.o(.text))
[Address Reference Count : 1]

- startup_stm32f103xb.o(RESET)

EXTI3_IRQHandler (Thumb, 0 bytes, Stack size 0 bytes, startup_stm32f103xb.o(.text))
[Address Reference Count : 1]

- startup_stm32f103xb.o(RESET)

EXTI4_IRQHandler (Thumb, 0 bytes, Stack size 0 bytes, startup_stm32f103xb.o(.text))
[Address Reference Count : 1]

- startup_stm32f103xb.o(RESET)

EXTI9_5_IRQHandler (Thumb, 0 bytes, Stack size 0 bytes, startup_stm32f103xb.o(.text))
[Address Reference Count : 1]

- startup_stm32f103xb.o(RESET)

FLASH_IRQHandler (Thumb, 0 bytes, Stack size 0 bytes, startup_stm32f103xb.o(.text))
[Address Reference Count : 1]

- startup_stm32f103xb.o(RESET)

I2C1_ER_IRQHandler (Thumb, 0 bytes, Stack size 0 bytes, startup_stm32f103xb.o(.text))
[Address Reference Count : 1]

- startup_stm32f103xb.o(RESET)

I2C1_EV_IRQHandler (Thumb, 0 bytes, Stack size 0 bytes, startup_stm32f103xb.o(.text))
[Address Reference Count : 1]

- startup_stm32f103xb.o(RESET)

I2C2_ER_IRQHandler (Thumb, 0 bytes, Stack size 0 bytes, startup_stm32f103xb.o(.text))
[Address Reference Count : 1]

- startup_stm32f103xb.o(RESET)

I2C2_EV_IRQHandler (Thumb, 0 bytes, Stack size 0 bytes, startup_stm32f103xb.o(.text))
[Address Reference Count : 1]

- startup_stm32f103xb.o(RESET)

PVD_IRQHandler (Thumb, 0 bytes, Stack size 0 bytes, startup_stm32f103xb.o(.text))
[Address Reference Count : 1]

- startup_stm32f103xb.o(RESET)

RCC_IRQHandler (Thumb, 0 bytes, Stack size 0 bytes, startup_stm32f103xb.o(.text))
[Address Reference Count : 1]

- startup_stm32f103xb.o(RESET)

RTC_Alarm_IRQHandler (Thumb, 0 bytes, Stack size 0 bytes, startup_stm32f103xb.o(.text))
[Address Reference Count : 1]

- startup_stm32f103xb.o(RESET)

RTC_IRQHandler (Thumb, 0 bytes, Stack size 0 bytes, startup_stm32f103xb.o(.text))
[Address Reference Count : 1]

- startup_stm32f103xb.o(RESET)

SPI1_IRQHandler (Thumb, 0 bytes, Stack size 0 bytes, startup_stm32f103xb.o(.text))
[Address Reference Count : 1]

- startup_stm32f103xb.o(RESET)

SPI2_IRQHandler (Thumb, 0 bytes, Stack size 0 bytes, startup_stm32f103xb.o(.text))
[Address Reference Count : 1]

- startup_stm32f103xb.o(RESET)

TAMPER_IRQHandler (Thumb, 0 bytes, Stack size 0 bytes, startup_stm32f103xb.o(.text))
[Address Reference Count : 1]

- startup_stm32f103xb.o(RESET)

TIM1_BRK_IRQHandler (Thumb, 0 bytes, Stack size 0 bytes, startup_stm32f103xb.o(.text))
[Address Reference Count : 1]

- startup_stm32f103xb.o(RESET)

TIM1_TRG_COM_IRQHandler (Thumb, 0 bytes, Stack size 0 bytes, startup_stm32f103xb.o(.text))
[Address Reference Count : 1]

- startup_stm32f103xb.o(RESET)

TIM1_UP_IRQHandler (Thumb, 0 bytes, Stack size 0 bytes, startup_stm32f103xb.o(.text))
[Address Reference Count : 1]

- startup_stm32f103xb.o(RESET)

TIM2_IRQHandler (Thumb, 0 bytes, Stack size 0 bytes, startup_stm32f103xb.o(.text))
[Address Reference Count : 1]

- startup_stm32f103xb.o(RESET)

TIM3_IRQHandler (Thumb, 0 bytes, Stack size 0 bytes, startup_stm32f103xb.o(.text))
[Address Reference Count : 1]

- startup_stm32f103xb.o(RESET)

TIM4_IRQHandler (Thumb, 0 bytes, Stack size 0 bytes, startup_stm32f103xb.o(.text))
[Address Reference Count : 1]

- startup_stm32f103xb.o(RESET)

USART1_IRQHandler (Thumb, 0 bytes, Stack size 0 bytes, startup_stm32f103xb.o(.text))
[Address Reference Count : 1]

- startup_stm32f103xb.o(RESET)

USART2_IRQHandler (Thumb, 0 bytes, Stack size 0 bytes, startup_stm32f103xb.o(.text))
[Address Reference Count : 1]

- startup_stm32f103xb.o(RESET)

USART3_IRQHandler (Thumb, 0 bytes, Stack size 0 bytes, startup_stm32f103xb.o(.text))
[Address Reference Count : 1]

- startup_stm32f103xb.o(RESET)

USBWakeUp_IRQHandler (Thumb, 0 bytes, Stack size 0 bytes, startup_stm32f103xb.o(.text))
[Address Reference Count : 1]

- startup_stm32f103xb.o(RESET)

USB_HP_CAN1_TX_IRQHandler (Thumb, 0 bytes, Stack size 0 bytes, startup_stm32f103xb.o(.text))
[Address Reference Count : 1]

- startup_stm32f103xb.o(RESET)

USB_LP_CAN1_RX0_IRQHandler (Thumb, 0 bytes, Stack size 0 bytes, startup_stm32f103xb.o(.text))
[Address Reference Count : 1]

- startup_stm32f103xb.o(RESET)

WWDG_IRQHandler (Thumb, 0 bytes, Stack size 0 bytes, startup_stm32f103xb.o(.text))
[Address Reference Count : 1]

- startup_stm32f103xb.o(RESET)

__user_initial_stackheap (Thumb, 0 bytes, Stack size unknown bytes, startup_stm32f103xb.o(.text))

[Called By]

- >> __user_setup_stackheap

__aeabi_memclr4 (Thumb, 0 bytes, Stack size 4 bytes, rt_memclr_w.o(.text))

[Stack]

- Max Depth = 4
- Call Chain = __aeabi_memclr4

[Called By]

- >> SystemClock_Config
- >> MX_TIM1_Init

__aeabi_memclr8 (Thumb, 0 bytes, Stack size 4 bytes, rt_memclr_w.o(.text), UNUSED)

__rt_memclr_w (Thumb, 78 bytes, Stack size 4 bytes, rt_memclr_w.o(.text), UNUSED)

_memset_w (Thumb, 0 bytes, Stack size unknown bytes, rt_memclr_w.o(.text), UNUSED)

__use_two_region_memory (Thumb, 2 bytes, Stack size 0 bytes, heapauxi.o(.text), UNUSED)

__rt_heap_escrow (Thumb, 2 bytes, Stack size 0 bytes, heapauxi.o(.text), UNUSED)

__rt_heap_expand (Thumb, 2 bytes, Stack size 0 bytes, heapauxi.o(.text), UNUSED)

__user_libspace (Thumb, 8 bytes, Stack size 0 bytes, libspace.o(.text), UNUSED)

__user_perproc_libspace (Thumb, 0 bytes, Stack size 0 bytes, libspace.o(.text))

[Called By]

- >> __user_setup_stackheap

__user_perthread_libspace (Thumb, 0 bytes, Stack size 0 bytes, libspace.o(.text), UNUSED)

__I$use$semihosting (Thumb, 0 bytes, Stack size 0 bytes, use_no_semi.o(.text), UNUSED)

__use_no_semihosting_swi (Thumb, 2 bytes, Stack size 0 bytes, use_no_semi.o(.text), UNUSED)

__semihosting_library_function (Thumb, 0 bytes, Stack size 8 bytes, indicate_semi.o(.text), UNUSED)

__user_setup_stackheap (Thumb, 74 bytes, Stack size 8 bytes, sys_stackheap_outer.o(.text))

[Stack]

- Max Depth = 8 + Unknown Stack Size
- Call Chain = __user_setup_stackheap

[Calls]

- >> __user_initial_stackheap
- >> __user_perproc_libspace

[Called By]

- >> __rt_entry_sh

exit (Thumb, 18 bytes, Stack size 8 bytes, exit.o(.text))

[Stack]

- Max Depth = 8 + Unknown Stack Size
- Call Chain = exit

[Calls]

- >> __rt_exit

[Called By]

- >> __rt_entry_main

_sys_exit (Thumb, 8 bytes, Stack size 0 bytes, sys_exit.o(.text))

[Called By]

- >> __rt_exit_exit

BusFault_Handler (Thumb, 2 bytes, Stack size 0 bytes, stm32f1xx_it.o(i.BusFault_Handler))

[Calls]

- >> BusFault_Handler

[Called By]

- >> BusFault_Handler

[Address Reference Count : 1]

- startup_stm32f103xb.o(RESET)

DMA1_Channel4_IRQHandler (Thumb, 6 bytes, Stack size 0 bytes, stm32f1xx_it.o(i.DMA1_Channel4_IRQHandler))

[Stack]

- Max Depth = 40
- Call Chain = DMA1_Channel4_IRQHandler ⇒ HAL_DMA_IRQHandler

[Calls]

- >> HAL_DMA_IRQHandler

[Address Reference Count : 1]

- startup_stm32f103xb.o(RESET)

DMA1_Channel5_IRQHandler (Thumb, 6 bytes, Stack size 0 bytes, stm32f1xx_it.o(i.DMA1_Channel5_IRQHandler))

[Stack]

- Max Depth = 40
- Call Chain = DMA1_Channel5_IRQHandler ⇒ HAL_DMA_IRQHandler

[Calls]

- >> HAL_DMA_IRQHandler

[Address Reference Count : 1]

- startup_stm32f103xb.o(RESET)

DMA1_Channel6_IRQHandler (Thumb, 6 bytes, Stack size 0 bytes, stm32f1xx_it.o(i.DMA1_Channel6_IRQHandler))

[Stack]

- Max Depth = 40
- Call Chain = DMA1_Channel6_IRQHandler ⇒ HAL_DMA_IRQHandler

[Calls]

- >> HAL_DMA_IRQHandler

[Address Reference Count : 1]

- startup_stm32f103xb.o(RESET)

DMA1_Channel7_IRQHandler (Thumb, 6 bytes, Stack size 0 bytes, stm32f1xx_it.o(i.DMA1_Channel7_IRQHandler))

[Stack]

- Max Depth = 40
- Call Chain = DMA1_Channel7_IRQHandler ⇒ HAL_DMA_IRQHandler

[Calls]

- >> HAL_DMA_IRQHandler

[Address Reference Count : 1]

- startup_stm32f103xb.o(RESET)

DebugMon_Handler (Thumb, 2 bytes, Stack size 0 bytes, stm32f1xx_it.o(i.DebugMon_Handler))
[Address Reference Count : 1]

- startup_stm32f103xb.o(RESET)

Error_Handler (Thumb, 4 bytes, Stack size 0 bytes, main.o(i.Error_Handler))

[Called By]

- >> HAL_UART_MspInit

HAL_DMA_IRQHandler (Thumb, 316 bytes, Stack size 40 bytes, stm32f1xx_hal_dma.o(i.HAL_DMA_IRQHandler))

[Stack]

- Max Depth = 40
- Call Chain = HAL_DMA_IRQHandler

[Called By]

- >> DMA1_Channel7_IRQHandler
- >> DMA1_Channel6_IRQHandler
- >> DMA1_Channel5_IRQHandler
- >> DMA1_Channel4_IRQHandler

HAL_DMA_Init (Thumb, 84 bytes, Stack size 12 bytes, stm32f1xx_hal_dma.o(i.HAL_DMA_Init))

[Stack]

- Max Depth = 12
- Call Chain = HAL_DMA_Init

[Called By]

- >> HAL_UART_MspInit

HAL_Delay (Thumb, 32 bytes, Stack size 16 bytes, stm32f1xx_hal.o(i.HAL_Delay))

[Stack]

- Max Depth = 16
- Call Chain = HAL_Delay

[Calls]

- >> HAL_GetTick

[Called By]

- >> lcd_init

HAL_GPIO_Init (Thumb, 446 bytes, Stack size 40 bytes, stm32f1xx_hal_gpio.o(i.HAL_GPIO_Init))

[Stack]

- Max Depth = 40
- Call Chain = HAL_GPIO_Init

[Called By]

- >> HAL_UART_MspInit
- >> HAL_TIM_Encoder_MspInit
- >> HAL_I2C_MspInit
- >> MX_GPIO_Init

HAL_GPIO_WritePin (Thumb, 10 bytes, Stack size 0 bytes, stm32f1xx_hal_gpio.o(i.HAL_GPIO_WritePin))

[Called By]

- >> MX_GPIO_Init

HAL_GetTick (Thumb, 6 bytes, Stack size 0 bytes, stm32f1xx_hal.o(i.HAL_GetTick))

[Called By]

- >> HAL_I2C_Master_Transmit
- >> HAL_Delay
- >> HAL_RCC_OscConfig
- >> HAL_RCC_ClockConfig
- >> I2C_WaitOnTXEFlagUntilTimeout
- >> I2C_WaitOnMasterAddressFlagUntilTimeout
- >> I2C_WaitOnFlagUntilTimeout
- >> I2C_WaitOnBTFFlagUntilTimeout

HAL_I2C_Init (Thumb, 376 bytes, Stack size 16 bytes, stm32f1xx_hal_i2c.o(i.HAL_I2C_Init))

[Stack]

- Max Depth = 88
- Call Chain = HAL_I2C_Init ⇒ HAL_I2C_MspInit ⇒ HAL_GPIO_Init

[Calls]

- >> HAL_I2C_MspInit
- >> HAL_RCC_GetPCLK1Freq

[Called By]

- >> main

HAL_I2C_Master_Transmit (Thumb, 290 bytes, Stack size 40 bytes, stm32f1xx_hal_i2c.o(i.HAL_I2C_Master_Transmit))

[Stack]

- Max Depth = 96
- Call Chain = HAL_I2C_Master_Transmit ⇒ I2C_MasterRequestWrite ⇒ I2C_WaitOnMasterAddressFlagUntilTimeout

[Calls]

- >> I2C_MasterRequestWrite
- >> HAL_GetTick
- >> I2C_WaitOnTXEFlagUntilTimeout
- >> I2C_WaitOnFlagUntilTimeout
- >> I2C_WaitOnBTFFlagUntilTimeout

[Called By]

- >> send_data
- >> send_cmd

HAL_I2C_MspInit (Thumb, 148 bytes, Stack size 32 bytes, stm32f1xx_hal_msp.o(i.HAL_I2C_MspInit))

[Stack]

- Max Depth = 72
- Call Chain = HAL_I2C_MspInit ⇒ HAL_GPIO_Init

[Calls]

- >> HAL_GPIO_Init

[Called By]

- >> HAL_I2C_Init

HAL_IncTick (Thumb, 12 bytes, Stack size 0 bytes, stm32f1xx_hal.o(i.HAL_IncTick))

[Called By]

- >> SysTick_Handler

HAL_Init (Thumb, 32 bytes, Stack size 8 bytes, stm32f1xx_hal.o(i.HAL_Init))

[Stack]

- Max Depth = 40
- Call Chain = HAL_Init ⇒ HAL_InitTick ⇒ HAL_NVIC_SetPriority

[Calls]

- >> HAL_MspInit
- >> HAL_InitTick
- >> HAL_NVIC_SetPriorityGrouping

[Called By]

- >> main

HAL_InitTick (Thumb, 54 bytes, Stack size 16 bytes, stm32f1xx_hal.o(i.HAL_InitTick))

[Stack]

- Max Depth = 32
- Call Chain = HAL_InitTick ⇒ HAL_NVIC_SetPriority

[Calls]

- >> HAL_NVIC_SetPriority
- >> HAL_SYSTICK_Config

[Called By]

- >> HAL_RCC_ClockConfig
- >> HAL_Init

HAL_MspInit (Thumb, 38 bytes, Stack size 8 bytes, stm32f1xx_hal_msp.o(i.HAL_MspInit))

[Stack]

- Max Depth = 8
- Call Chain = HAL_MspInit

[Called By]

- >> HAL_Init

HAL_NVIC_EnableIRQ (Thumb, 26 bytes, Stack size 0 bytes, stm32f1xx_hal_cortex.o(i.HAL_NVIC_EnableIRQ))

[Called By]

- >> HAL_TIM_Encoder_MspInit
- >> main

HAL_NVIC_SetPriority (Thumb, 60 bytes, Stack size 16 bytes, stm32f1xx_hal_cortex.o(i.HAL_NVIC_SetPriority))

[Stack]

- Max Depth = 16
- Call Chain = HAL_NVIC_SetPriority

[Calls]

- >> __NVIC_SetPriority

[Called By]

- >> HAL_TIM_Encoder_MspInit
- >> main
- >> HAL_InitTick

HAL_NVIC_SetPriorityGrouping (Thumb, 26 bytes, Stack size 0 bytes, stm32f1xx_hal_cortex.o(i.HAL_NVIC_SetPriorityGrouping))

[Called By]

- >> HAL_Init

HAL_RCC_CSSCallback (Thumb, 2 bytes, Stack size 0 bytes, stm32f1xx_hal_rcc.o(i.HAL_RCC_CSSCallback))

[Called By]

- >> HAL_RCC_NMI_IRQHandler

HAL_RCC_ClockConfig (Thumb, 280 bytes, Stack size 32 bytes, stm32f1xx_hal_rcc.o(i.HAL_RCC_ClockConfig))

[Stack]

- Max Depth = 64
- Call Chain = HAL_RCC_ClockConfig ⇒ HAL_InitTick ⇒ HAL_NVIC_SetPriority

[Calls]

- >> HAL_RCC_GetSysClockFreq
- >> HAL_InitTick
- >> HAL_GetTick

[Called By]

- >> SystemClock_Config

HAL_RCC_EnableCSS (Thumb, 8 bytes, Stack size 0 bytes, stm32f1xx_hal_rcc.o(i.HAL_RCC_EnableCSS))

[Called By]

- >> SystemClock_Config

HAL_RCC_GetPCLK1Freq (Thumb, 20 bytes, Stack size 0 bytes, stm32f1xx_hal_rcc.o(i.HAL_RCC_GetPCLK1Freq))

[Called By]

- >> HAL_I2C_Init
- >> UART_SetConfig

HAL_RCC_GetPCLK2Freq (Thumb, 20 bytes, Stack size 0 bytes, stm32f1xx_hal_rcc.o(i.HAL_RCC_GetPCLK2Freq))

[Called By]

- >> UART_SetConfig

HAL_RCC_GetSysClockFreq (Thumb, 58 bytes, Stack size 0 bytes, stm32f1xx_hal_rcc.o(i.HAL_RCC_GetSysClockFreq))

[Called By]

- >> HAL_RCC_ClockConfig

HAL_RCC_NMI_IRQHandler (Thumb, 20 bytes, Stack size 8 bytes, stm32f1xx_hal_rcc.o(i.HAL_RCC_NMI_IRQHandler))

[Stack]

- Max Depth = 8
- Call Chain = HAL_RCC_NMI_IRQHandler

[Calls]

- >> HAL_RCC_CSSCallback

[Called By]

- >> NMI_Handler

HAL_RCC_OscConfig (Thumb, 778 bytes, Stack size 40 bytes, stm32f1xx_hal_rcc.o(i.HAL_RCC_OscConfig))

[Stack]

- Max Depth = 40
- Call Chain = HAL_RCC_OscConfig

[Calls]

- >> HAL_GetTick

[Called By]

- >> SystemClock_Config

HAL_SYSTICK_Config (Thumb, 40 bytes, Stack size 8 bytes, stm32f1xx_hal_cortex.o(i.HAL_SYSTICK_Config))

[Stack]

- Max Depth = 8
- Call Chain = HAL_SYSTICK_Config

[Calls]

- >> __NVIC_SetPriority

[Called By]

- >> HAL_InitTick

HAL_TIMEx_BreakCallback (Thumb, 2 bytes, Stack size 0 bytes, stm32f1xx_hal_tim_ex.o(i.HAL_TIMEx_BreakCallback))

[Called By]

- >> HAL_TIM_IRQHandler

HAL_TIMEx_CommutCallback (Thumb, 2 bytes, Stack size 0 bytes, stm32f1xx_hal_tim_ex.o(i.HAL_TIMEx_CommutCallback))

[Called By]

- >> HAL_TIM_IRQHandler

HAL_TIMEx_MasterConfigSynchronization (Thumb, 92 bytes, Stack size 16 bytes, stm32f1xx_hal_tim_ex.o(i.HAL_TIMEx_MasterConfigSynchronization))

[Stack]

- Max Depth = 16
- Call Chain = HAL_TIMEx_MasterConfigSynchronization

[Called By]

- >> MX_TIM1_Init

HAL_TIM_Encoder_Init (Thumb, 164 bytes, Stack size 24 bytes, stm32f1xx_hal_tim.o(i.HAL_TIM_Encoder_Init))

[Stack]

- Max Depth = 88
- Call Chain = HAL_TIM_Encoder_Init ⇒ HAL_TIM_Encoder_MspInit ⇒ HAL_GPIO_Init

[Calls]

- >> HAL_TIM_Encoder_MspInit
- >> TIM_Base_SetConfig

[Called By]

- >> MX_TIM1_Init

HAL_TIM_Encoder_MspInit (Thumb, 94 bytes, Stack size 24 bytes, stm32f1xx_hal_msp.o(i.HAL_TIM_Encoder_MspInit))

[Stack]

- Max Depth = 64
- Call Chain = HAL_TIM_Encoder_MspInit ⇒ HAL_GPIO_Init

[Calls]

- >> HAL_NVIC_SetPriority
- >> HAL_NVIC_EnableIRQ
- >> HAL_GPIO_Init

[Called By]

- >> HAL_TIM_Encoder_Init

HAL_TIM_IC_CaptureCallback (Thumb, 18 bytes, Stack size 0 bytes, main.o(i.HAL_TIM_IC_CaptureCallback))

[Called By]

- >> HAL_TIM_IRQHandler

HAL_TIM_IRQHandler (Thumb, 358 bytes, Stack size 16 bytes, stm32f1xx_hal_tim.o(i.HAL_TIM_IRQHandler))

[Stack]

- Max Depth = 16
- Call Chain = HAL_TIM_IRQHandler

[Calls]

- >> HAL_TIM_IC_CaptureCallback
- >> HAL_TIM_TriggerCallback
- >> HAL_TIM_PeriodElapsedCallback
- >> HAL_TIM_PWM_PulseFinishedCallback
- >> HAL_TIM_OC_DelayElapsedCallback
- >> HAL_TIMEx_CommutCallback
- >> HAL_TIMEx_BreakCallback

[Called By]

- >> TIM1_CC_IRQHandler

HAL_TIM_OC_DelayElapsedCallback (Thumb, 2 bytes, Stack size 0 bytes, stm32f1xx_hal_tim.o(i.HAL_TIM_OC_DelayElapsedCallback))

[Called By]

- >> HAL_TIM_IRQHandler

HAL_TIM_PWM_PulseFinishedCallback (Thumb, 2 bytes, Stack size 0 bytes, stm32f1xx_hal_tim.o(i.HAL_TIM_PWM_PulseFinishedCallback))

[Called By]

- >> HAL_TIM_IRQHandler

HAL_TIM_PeriodElapsedCallback (Thumb, 2 bytes, Stack size 0 bytes, stm32f1xx_hal_tim.o(i.HAL_TIM_PeriodElapsedCallback))

[Called By]

- >> HAL_TIM_IRQHandler

HAL_TIM_TriggerCallback (Thumb, 2 bytes, Stack size 0 bytes, stm32f1xx_hal_tim.o(i.HAL_TIM_TriggerCallback))

[Called By]

- >> HAL_TIM_IRQHandler

HAL_UART_Init (Thumb, 100 bytes, Stack size 16 bytes, stm32f1xx_hal_uart.o(i.HAL_UART_Init))

[Stack]

- Max Depth = 112
- Call Chain = HAL_UART_Init ⇒ HAL_UART_MspInit ⇒ HAL_GPIO_Init

[Calls]

- >> HAL_UART_MspInit
- >> UART_SetConfig

[Called By]

- >> main

HAL_UART_MspInit (Thumb, 360 bytes, Stack size 56 bytes, stm32f1xx_hal_msp.o(i.HAL_UART_MspInit))

[Stack]

- Max Depth = 96
- Call Chain = HAL_UART_MspInit ⇒ HAL_GPIO_Init

[Calls]

- >> HAL_DMA_Init
- >> HAL_GPIO_Init
- >> Error_Handler

[Called By]

- >> HAL_UART_Init

HardFault_Handler (Thumb, 2 bytes, Stack size 0 bytes, stm32f1xx_it.o(i.HardFault_Handler))

[Calls]

- >> HardFault_Handler

[Called By]

- >> HardFault_Handler

[Address Reference Count : 1]

- startup_stm32f103xb.o(RESET)

MemManage_Handler (Thumb, 2 bytes, Stack size 0 bytes, stm32f1xx_it.o(i.MemManage_Handler))

[Calls]

- >> MemManage_Handler

[Called By]

- >> MemManage_Handler

[Address Reference Count : 1]

- startup_stm32f103xb.o(RESET)

NMI_Handler (Thumb, 6 bytes, Stack size 0 bytes, stm32f1xx_it.o(i.NMI_Handler))

[Stack]

- Max Depth = 8
- Call Chain = NMI_Handler ⇒ HAL_RCC_NMI_IRQHandler

[Calls]

- >> HAL_RCC_NMI_IRQHandler

[Address Reference Count : 1]

- startup_stm32f103xb.o(RESET)

PendSV_Handler (Thumb, 2 bytes, Stack size 0 bytes, stm32f1xx_it.o(i.PendSV_Handler))
[Address Reference Count : 1]

- startup_stm32f103xb.o(RESET)

SVC_Handler (Thumb, 2 bytes, Stack size 0 bytes, stm32f1xx_it.o(i.SVC_Handler))
[Address Reference Count : 1]

- startup_stm32f103xb.o(RESET)

SysTick_Handler (Thumb, 4 bytes, Stack size 0 bytes, stm32f1xx_it.o(i.SysTick_Handler))

[Calls]

- >> HAL_IncTick

[Address Reference Count : 1]

- startup_stm32f103xb.o(RESET)

SystemClock_Config (Thumb, 96 bytes, Stack size 72 bytes, main.o(i.SystemClock_Config))

[Stack]

- Max Depth = 136
- Call Chain = SystemClock_Config ⇒ HAL_RCC_ClockConfig ⇒ HAL_InitTick ⇒ HAL_NVIC_SetPriority

[Calls]

- >> HAL_RCC_OscConfig
- >> HAL_RCC_EnableCSS
- >> HAL_RCC_ClockConfig
- >> __aeabi_memclr4

[Called By]

- >> main

SystemInit (Thumb, 2 bytes, Stack size 0 bytes, system_stm32f1xx.o(i.SystemInit))
[Address Reference Count : 1]

- startup_stm32f103xb.o(.text)

TIM1_CC_IRQHandler (Thumb, 6 bytes, Stack size 0 bytes, stm32f1xx_it.o(i.TIM1_CC_IRQHandler))

[Stack]

- Max Depth = 16
- Call Chain = TIM1_CC_IRQHandler ⇒ HAL_TIM_IRQHandler

[Calls]

- >> HAL_TIM_IRQHandler

[Address Reference Count : 1]

- startup_stm32f103xb.o(RESET)

TIM_Base_SetConfig (Thumb, 94 bytes, Stack size 20 bytes, stm32f1xx_hal_tim.o(i.TIM_Base_SetConfig))

[Stack]

- Max Depth = 20
- Call Chain = TIM_Base_SetConfig

[Called By]

- >> HAL_TIM_Encoder_Init

UsageFault_Handler (Thumb, 2 bytes, Stack size 0 bytes, stm32f1xx_it.o(i.UsageFault_Handler))

[Calls]

- >> UsageFault_Handler

[Called By]

- >> UsageFault_Handler

[Address Reference Count : 1]

- startup_stm32f103xb.o(RESET)

lcd_init (Thumb, 76 bytes, Stack size 8 bytes, lcd_i2c.o(i.lcd_init))

[Stack]

- Max Depth = 112
- Call Chain = lcd_init ⇒ send_cmd ⇒ HAL_I2C_Master_Transmit ⇒ I2C_MasterRequestWrite ⇒ I2C_WaitOnMasterAddressFlagUntilTimeout

[Calls]

- >> HAL_Delay
- >> send_cmd

[Called By]

- >> main

lcd_printstr (Thumb, 20 bytes, Stack size 8 bytes, lcd_i2c.o(i.lcd_printstr))

[Stack]

- Max Depth = 112
- Call Chain = lcd_printstr ⇒ send_data ⇒ HAL_I2C_Master_Transmit ⇒ I2C_MasterRequestWrite ⇒ I2C_WaitOnMasterAddressFlagUntilTimeout

[Calls]

- >> send_data

[Called By]

- >> main

lcd_set_cursor (Thumb, 30 bytes, Stack size 16 bytes, lcd_i2c.o(i.lcd_set_cursor))

[Stack]

- Max Depth = 120
- Call Chain = lcd_set_cursor ⇒ send_cmd ⇒ HAL_I2C_Master_Transmit ⇒ I2C_MasterRequestWrite ⇒ I2C_WaitOnMasterAddressFlagUntilTimeout

[Calls]

- >> send_cmd

[Called By]

- >> main

main (Thumb, 270 bytes, Stack size 8 bytes, main.o(i.main))

[Stack]

- Max Depth = 152
- Call Chain = main ⇒ MX_TIM1_Init ⇒ HAL_TIM_Encoder_Init ⇒ HAL_TIM_Encoder_MspInit ⇒ HAL_GPIO_Init

[Calls]

- >> lcd_set_cursor
- >> lcd_printstr
- >> lcd_init
- >> HAL_UART_Init
- >> HAL_NVIC_SetPriority
- >> HAL_NVIC_EnableIRQ
- >> HAL_Init
- >> HAL_I2C_Init
- >> SystemClock_Config
- >> MX_TIM1_Init
- >> MX_GPIO_Init

[Called By]

- >> __rt_entry_main

send_cmd (Thumb, 62 bytes, Stack size 8 bytes, lcd_i2c.o(i.send_cmd))

[Stack]

- Max Depth = 104
- Call Chain = send_cmd ⇒ HAL_I2C_Master_Transmit ⇒ I2C_MasterRequestWrite ⇒ I2C_WaitOnMasterAddressFlagUntilTimeout

[Calls]

- >> HAL_I2C_Master_Transmit

[Called By]

- >> lcd_set_cursor
- >> lcd_init

send_data (Thumb, 62 bytes, Stack size 8 bytes, lcd_i2c.o(i.send_data))

[Stack]

- Max Depth = 104
- Call Chain = send_data ⇒ HAL_I2C_Master_Transmit ⇒ I2C_MasterRequestWrite ⇒ I2C_WaitOnMasterAddressFlagUntilTimeout

[Calls]

- >> HAL_I2C_Master_Transmit

[Called By]

- >> lcd_printstr

### Local Symbols

MX_GPIO_Init (Thumb, 180 bytes, Stack size 48 bytes, main.o(i.MX_GPIO_Init))

[Stack]

- Max Depth = 88
- Call Chain = MX_GPIO_Init ⇒ HAL_GPIO_Init

[Calls]

- >> HAL_GPIO_WritePin
- >> HAL_GPIO_Init

[Called By]

- >> main

MX_TIM1_Init (Thumb, 104 bytes, Stack size 56 bytes, main.o(i.MX_TIM1_Init))

[Stack]

- Max Depth = 144
- Call Chain = MX_TIM1_Init ⇒ HAL_TIM_Encoder_Init ⇒ HAL_TIM_Encoder_MspInit ⇒ HAL_GPIO_Init

[Calls]

- >> HAL_TIM_Encoder_Init
- >> HAL_TIMEx_MasterConfigSynchronization
- >> __aeabi_memclr4

[Called By]

- >> main

I2C_IsAcknowledgeFailed (Thumb, 46 bytes, Stack size 0 bytes, stm32f1xx_hal_i2c.o(i.I2C_IsAcknowledgeFailed))

[Called By]

- >> I2C_WaitOnTXEFlagUntilTimeout
- >> I2C_WaitOnBTFFlagUntilTimeout

I2C_MasterRequestWrite (Thumb, 150 bytes, Stack size 24 bytes, stm32f1xx_hal_i2c.o(i.I2C_MasterRequestWrite))

[Stack]

- Max Depth = 56
- Call Chain = I2C_MasterRequestWrite ⇒ I2C_WaitOnMasterAddressFlagUntilTimeout

[Calls]

- >> I2C_WaitOnMasterAddressFlagUntilTimeout
- >> I2C_WaitOnFlagUntilTimeout

[Called By]

- >> HAL_I2C_Master_Transmit

I2C_WaitOnBTFFlagUntilTimeout (Thumb, 86 bytes, Stack size 16 bytes, stm32f1xx_hal_i2c.o(i.I2C_WaitOnBTFFlagUntilTimeout))

[Stack]

- Max Depth = 16
- Call Chain = I2C_WaitOnBTFFlagUntilTimeout

[Calls]

- >> I2C_IsAcknowledgeFailed
- >> HAL_GetTick

[Called By]

- >> HAL_I2C_Master_Transmit

I2C_WaitOnFlagUntilTimeout (Thumb, 144 bytes, Stack size 32 bytes, stm32f1xx_hal_i2c.o(i.I2C_WaitOnFlagUntilTimeout))

[Stack]

- Max Depth = 32
- Call Chain = I2C_WaitOnFlagUntilTimeout

[Calls]

- >> HAL_GetTick

[Called By]

- >> I2C_MasterRequestWrite
- >> HAL_I2C_Master_Transmit

I2C_WaitOnMasterAddressFlagUntilTimeout (Thumb, 188 bytes, Stack size 32 bytes, stm32f1xx_hal_i2c.o(i.I2C_WaitOnMasterAddressFlagUntilTimeout))

[Stack]

- Max Depth = 32
- Call Chain = I2C_WaitOnMasterAddressFlagUntilTimeout

[Calls]

- >> HAL_GetTick

[Called By]

- >> I2C_MasterRequestWrite

I2C_WaitOnTXEFlagUntilTimeout (Thumb, 86 bytes, Stack size 16 bytes, stm32f1xx_hal_i2c.o(i.I2C_WaitOnTXEFlagUntilTimeout))

[Stack]

- Max Depth = 16
- Call Chain = I2C_WaitOnTXEFlagUntilTimeout

[Calls]

- >> I2C_IsAcknowledgeFailed
- >> HAL_GetTick

[Called By]

- >> HAL_I2C_Master_Transmit

__NVIC_SetPriority (Thumb, 32 bytes, Stack size 0 bytes, stm32f1xx_hal_cortex.o(i.__NVIC_SetPriority))

[Called By]

- >> HAL_NVIC_SetPriority
- >> HAL_SYSTICK_Config

UART_SetConfig (Thumb, 178 bytes, Stack size 16 bytes, stm32f1xx_hal_uart.o(i.UART_SetConfig))

[Stack]

- Max Depth = 16
- Call Chain = UART_SetConfig

[Calls]

- >> HAL_RCC_GetPCLK2Freq
- >> HAL_RCC_GetPCLK1Freq

[Called By]

- >> HAL_UART_Init

### Undefined Global Symbols
