AlfonsusGiovanni/Welding-Arm-Manipulator/2D Design/Interface Guidance/Pendant Interface Guidance Rev 1 - Page 1.pdf

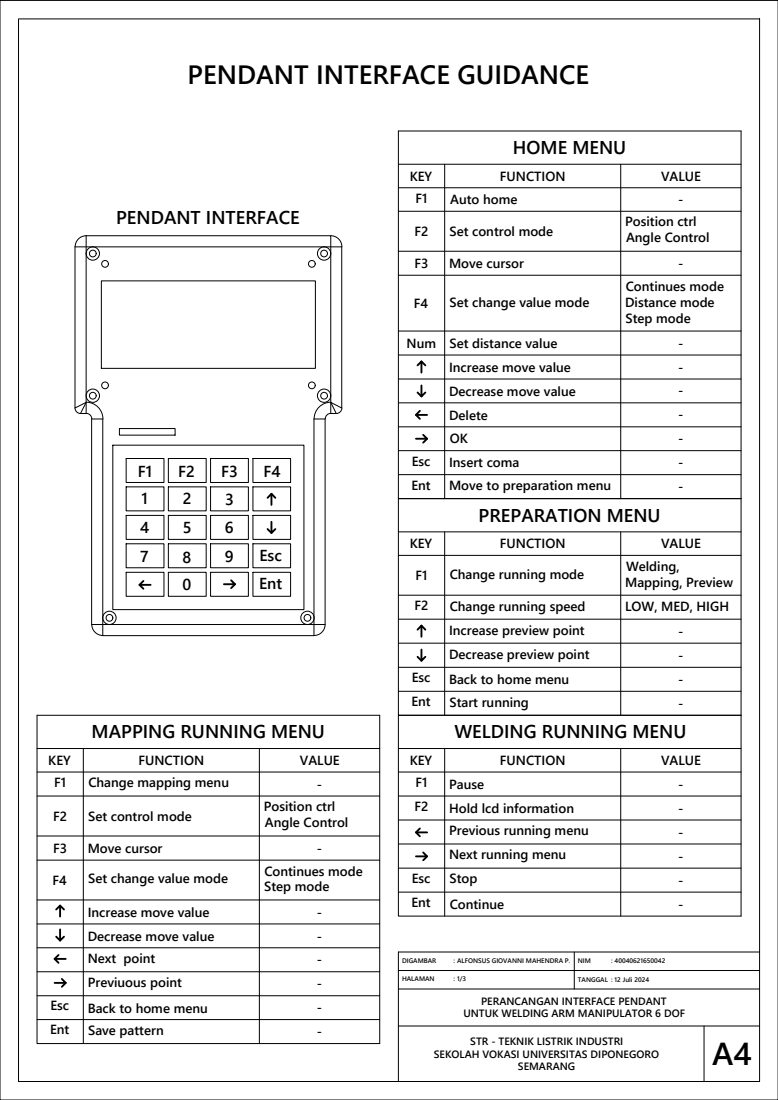
[picture p140: page 1]
0 Ent; HOME MENU; Increase move value; - Decrease move value; - Delete; - Esc; Insert coma; - Ent; Move to preparation menu; - PREPARATION MENU; Increase preview point; - Decrease preview point; Back to home menu; Start running; PENDANT INTERFACE; Pause; Hold lcd information; - Previous running menu; - Next running menu; Stop; Continue; - Next point; - Previuous point; Save pattern

PENDANT INTERFACE GUIDANCE

KEY | FUNCTION | VALUE
F1 | Set control mode Auto home | Position ctrl - F2

Angle Control

F3 | Move cursor Set change value mode | - F4

Continues mode Distance mode Step mode

Num | Set distance value | -

7 | 8 | 9 | Esc

F1 | Change running mode | Welding, Mapping, Preview

F2 | Change running speed | LOW, MED, HIGH

MAPPING RUNNING MENU

WELDING RUNNING MENU

F1 | Set control mode Change mapping menu | Position ctrl - F2

F3 | Move cursor Set change value mode | Continues mode - F4

Step mode

DIGAMBAR : ALFONSUS GIOVANNI MAHENDRA P. | NIM : 40040621650042

HALAMAN : 1/3 | TANGGAL : 12 Juli 2024 PERANCANGAN INTERFACE PENDANT

UNTUK WELDING ARM MANIPULATOR 6 DOF

STR - TEKNIK LISTRIK INDUSTRI

SEKOLAH VOKASI UNIVERSITAS DIPONEGORO
