AlfonsusGiovanni/Welding-Arm-Manipulator/2D Design/Interface Guidance/Pendant Interface Guidance Rev 1 - Page 2.pdf

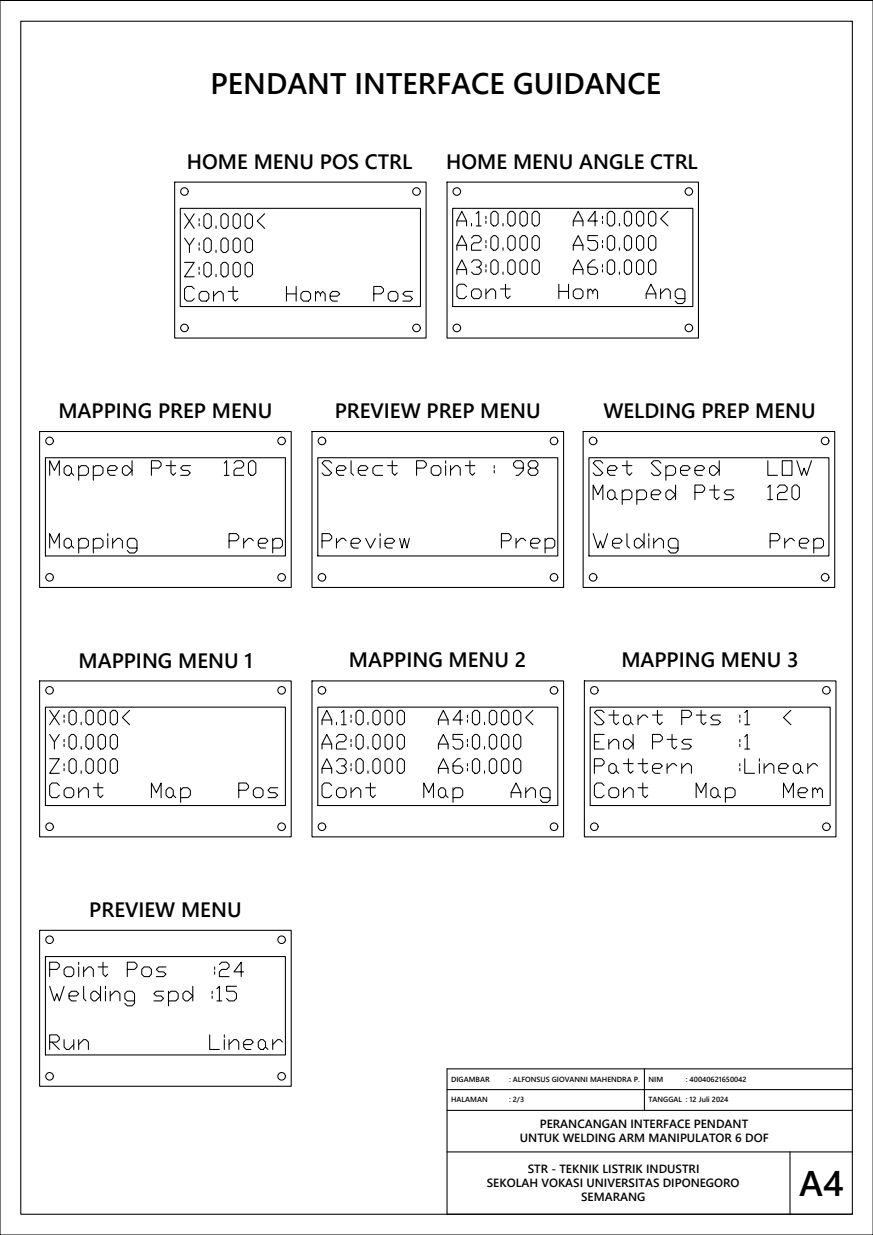
[picture p141: page 1]
HOME MENU POS CTRL; HOME MENU ANGLE CTRL; MAPPING MENU 1; MAPPING MENU 2; MAPPING MENU 3; MAPPING PREP MENU; PREVIEW PREP MENU; PREVIEW MENU

PENDANT INTERFACE GUIDANCE

WELDING PREP MENU

DIGAMBAR : ALFONSUS GIOVANNI MAHENDRA P. | NIM : 40040621650042

HALAMAN : 2/3 | TANGGAL : 12 Juli 2024 PERANCANGAN INTERFACE PENDANT

UNTUK WELDING ARM MANIPULATOR 6 DOF

STR - TEKNIK LISTRIK INDUSTRI

SEKOLAH VOKASI UNIVERSITAS DIPONEGORO
