AlfonsusGiovanni/Welding-Arm-Manipulator/2D Design/Interface Guidance/Pendant Interface Guidance Rev 1 - Page 3.pdf

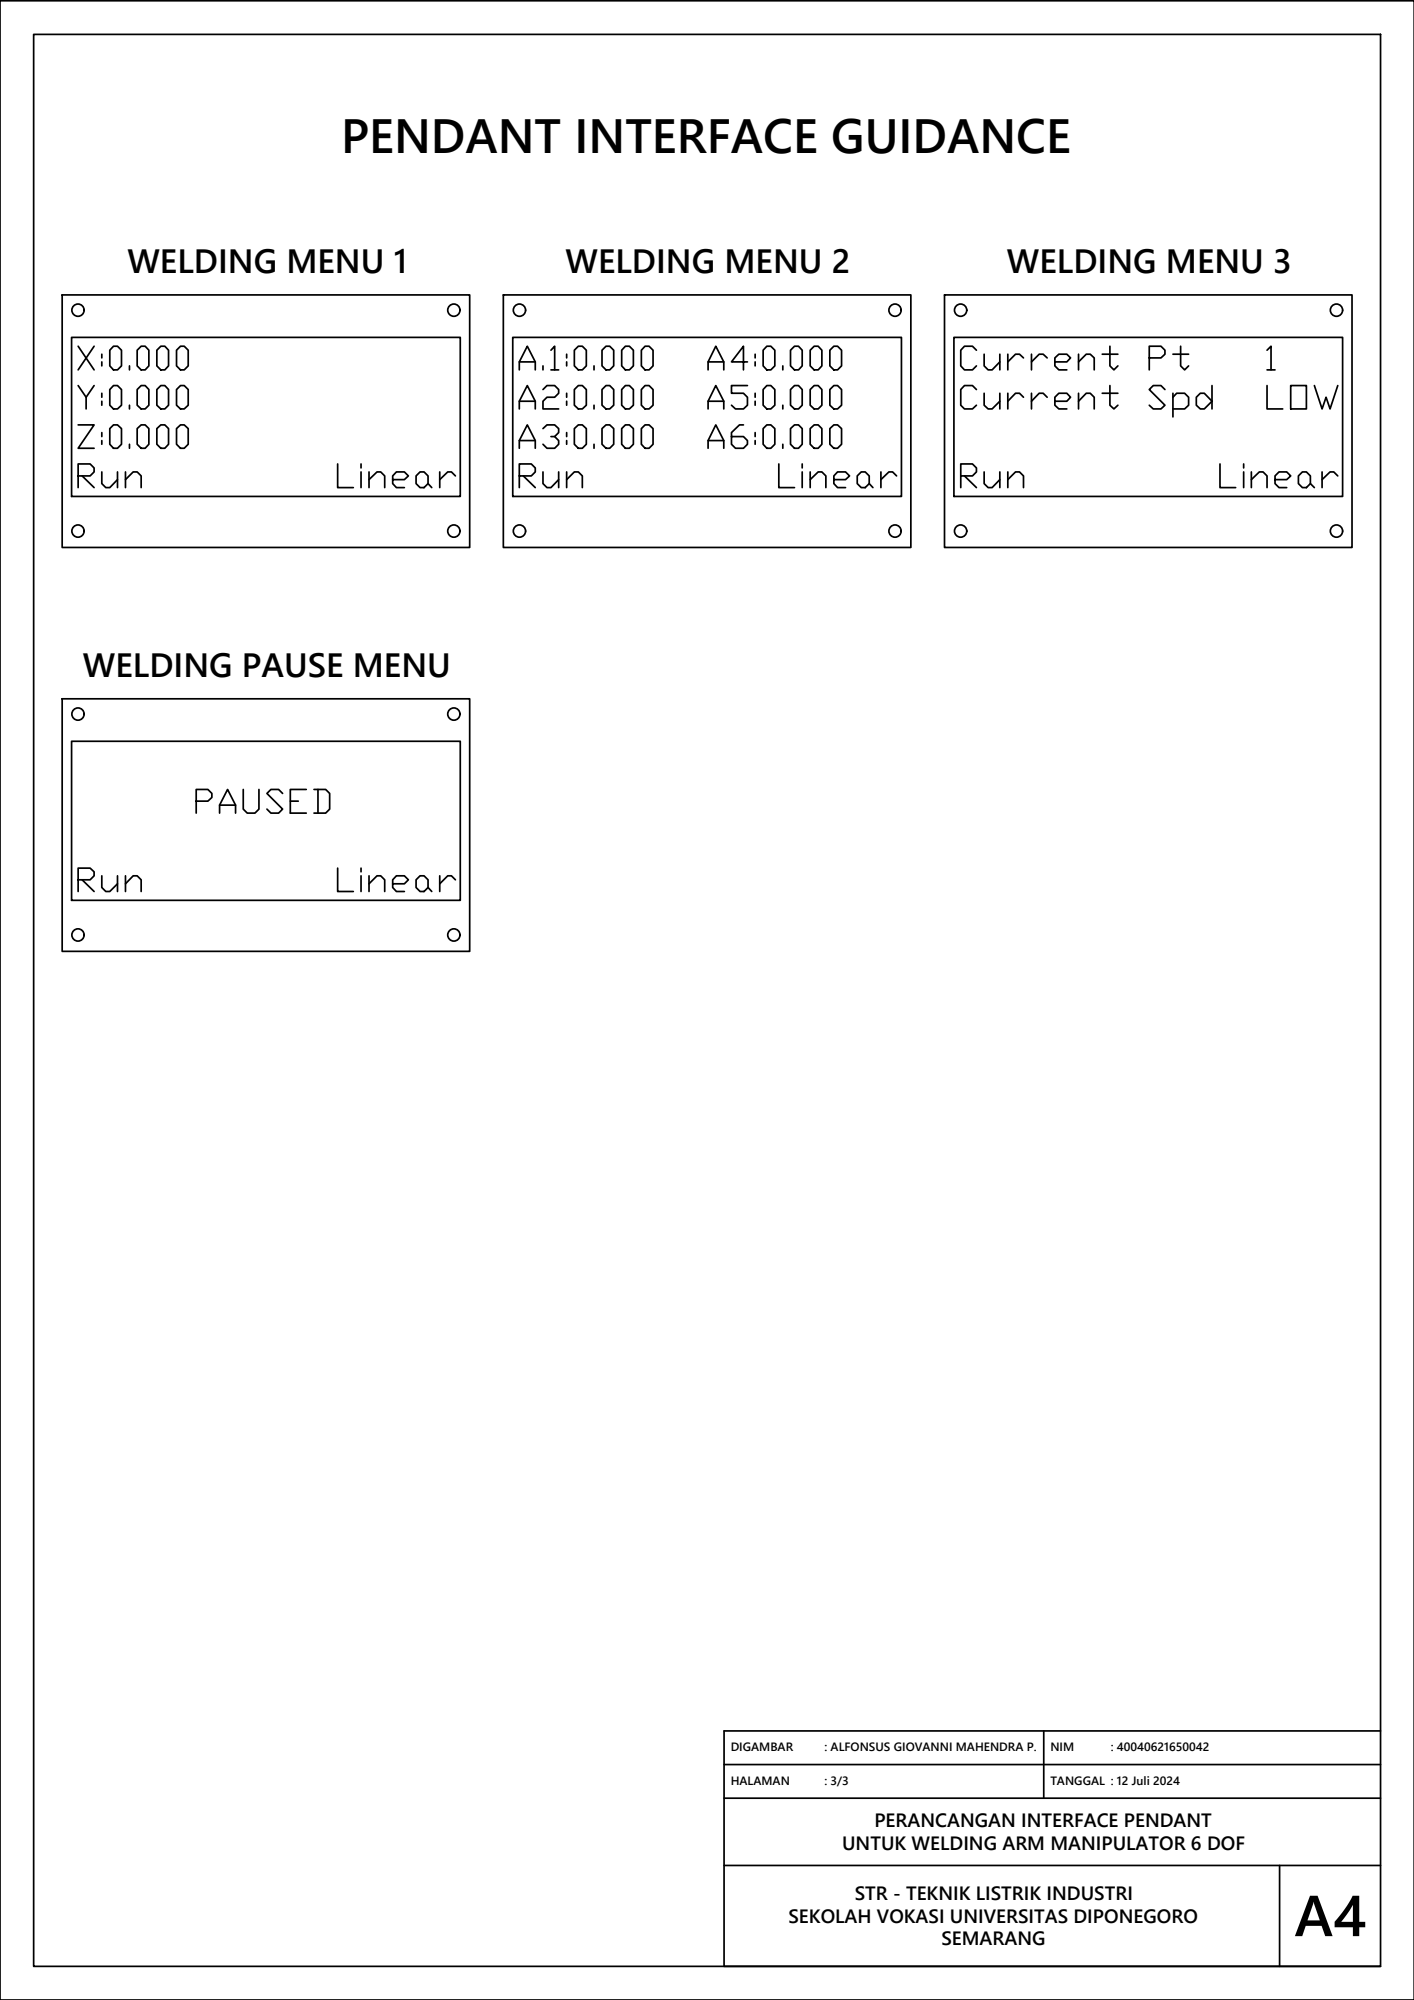
[picture p142: page 1]
WELDING MENU 1; WELDING MENU 2; WELDING MENU 3

PENDANT INTERFACE GUIDANCE

WELDING PAUSE MENU

DIGAMBAR : ALFONSUS GIOVANNI MAHENDRA P. | NIM : 40040621650042

HALAMAN : 3/3 | TANGGAL : 12 Juli 2024 PERANCANGAN INTERFACE PENDANT

UNTUK WELDING ARM MANIPULATOR 6 DOF

STR - TEKNIK LISTRIK INDUSTRI

SEKOLAH VOKASI UNIVERSITAS DIPONEGORO
