AlfonsusGiovanni/Welding-Arm-Manipulator/2D Design/Interface Guidance/Pendant Interface Guidance Rev 1.pdf

F1 | F2 | F3 | F4
1 | 2 | 3
4 | 5 | 6
7 | 8 | 9

### 0 Ent

| | | Esc

## HOME MENU

KEY | FUNCTION | VALUE
F1 | Auto home | - F2 | Set control mode | Position ctrl

Angle Control

F3 | Change move variable | X, Y, Z / A1-A6
F4 | Set change value mode

Continues mode
Distance mode
Step mode
Num | Set distance value | -
Increase move value | - Decrease move value | - Delete | - OK | - Esc | Insert coma | - Ent | Move to preparation menu | - PREPARATION MENU
KEY | FUNCTION | VALUE
F1 | Change running mode | Welding,
Mapping, Preview
F2 | Change running speed | LOW, MED, HIGH
Increase preview point | - Decrease preview point | - Esc | Back to home menu | - Ent | Start running | -

## PENDANT INTERFACE

## WELDING RUNNING MENU

KEY | FUNCTION | VALUE
F1 | Pause | - F2 | Hold lcd information | - Previous running menu | - Next running menu | - Esc | Stop | - Ent | Continue | -

# PENDANT INTERFACE GUIDANCE

DIGAMBAR | : ALFONSUS GIOVANNI MAHENDRA P.
HALAMAN | : 1/3
NIM | : 40040621650042

TANGGAL : 12 Juli 2024 PERANCANGAN INTERFACE PENDANT

UNTUK WELDING ARM MANIPULATOR 6 DOF

STR - TEKNIK LISTRIK INDUSTRI
SEKOLAH VOKASI UNIVERSITAS DIPONEGORO
SEMARANG | A4

## MAPPING RUNNING MENU

KEY | FUNCTION | VALUE
F1 | Change mapping menu | - F2 | Set control mode | Position ctrl

Angle Control

F3 | Change move variable | X, Y, Z / A1-A6
F4 | Set change value mode | Continues mode
Step mode
Increase move value | - Decrease move value | - Next point | - Previuous point | - Esc | Back to home menu | - Ent | Save pattern | -

## HOME MENU POS CTRL HOME MENU ANGLE CTRL

DIGAMBAR; : ALFONSUS GIOVANNI MAHENDRA P.; HALAMAN; NIM; MAPPING MENU 1; MAPPING MENU 2; MAPPING MENU 3; MAPPING PREP MENU; PREVIEW PREP MENU; PREVIEW MENU

WELDING PREP MENU

TANGGAL : 12 Juli 2024 PERANCANGAN INTERFACE PENDANT

WELDING MENU 1 | WELDING MENU 2 | WELDING MENU 3

DIGAMBAR; : ALFONSUS GIOVANNI MAHENDRA P.; HALAMAN; NIM

WELDING PAUSE MENU

TANGGAL : 12 Juli 2024 PERANCANGAN INTERFACE PENDANT
