AlfonsusGiovanni/Welding-Arm-Manipulator/2D Design/Interface Guidance/Pendant Interface Guidance New Update.pdf

## HOME MENU

KEY | FUNCTION | VALUE
F1 | Auto home | - F2 | Set control mode | Position ctrl

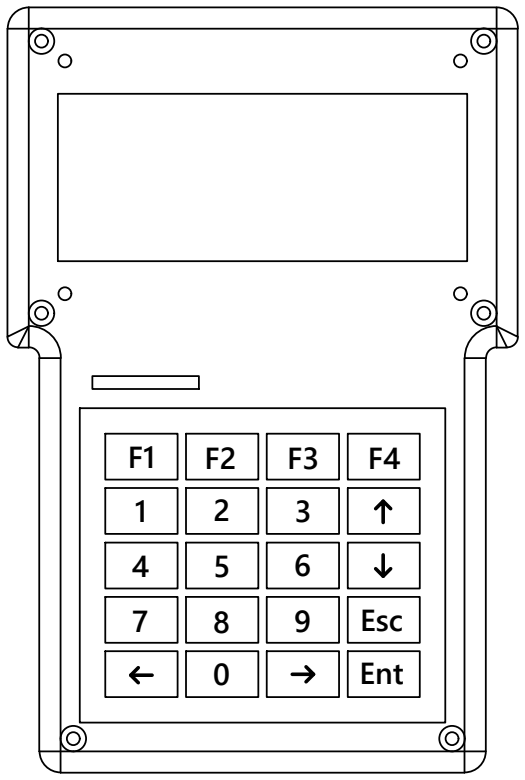
[picture p143: figure]
0 Ent; Esc

Angle Control

F3 | Change move variable | X, Y, Z / A1-A6
F4 | Set change value mode

Continues mode
Distance mode
Step mode
Num | Set distance value | -
Increase move value | - Decrease move value | - Delete | - OK | - Esc | Insert coma | - Ent | Move to preparation menu | - PREPARATION MENU
KEY | FUNCTION | VALUE
F1 | Change running mode | Pattern, Mapping
F2 | Change running memory | 1, 2, 3
F3 | Change running speed | Low, Med, High
Esc | Back to home menu | - Ent | Start running | -

## PENDANT INTERFACE

## PATTERN RUNNING MENU

KEY | FUNCTION | VALUE
F1 | Pause | - F2 | Hold lcd information | - Previous running menu | - Next running menu | - Esc | Stop | - Ent | Continue | -

# PENDANT INTERFACE GUIDANCE

DIGAMBAR | : ALFONSUS GIOVANNI MAHENDRA P.
HALAMAN | : 1/2
NIM | : 40040621650042

TANGGAL : 12 Juli 2024 PERANCANGAN INTERFACE PENDANT

UNTUK WELDING ARM MANIPULATOR 6 DOF

STR - TEKNIK LISTRIK INDUSTRI
SEKOLAH VOKASI UNIVERSITAS DIPONEGORO
SEMARANG | A4

## MAPPING RUNNING MENU

KEY | FUNCTION | VALUE
F1 | Change memory menu | - F2 | Set control mode | Position ctrl

Angle Control

F3 | Change move variable | X, Y, Z / A1-A6
F4 | Set change value mode | Continues mode
Step mode
Increase move value | - Decrease move value | - Delete pattern point | - Save pattern point | - Esc | Insert coma | - Ent | Save pattern | -

POSISITION CONTROL | ANGLE CONTROL | PREPARATION MENU

# PENDANT INTERFACE GUIDANCE

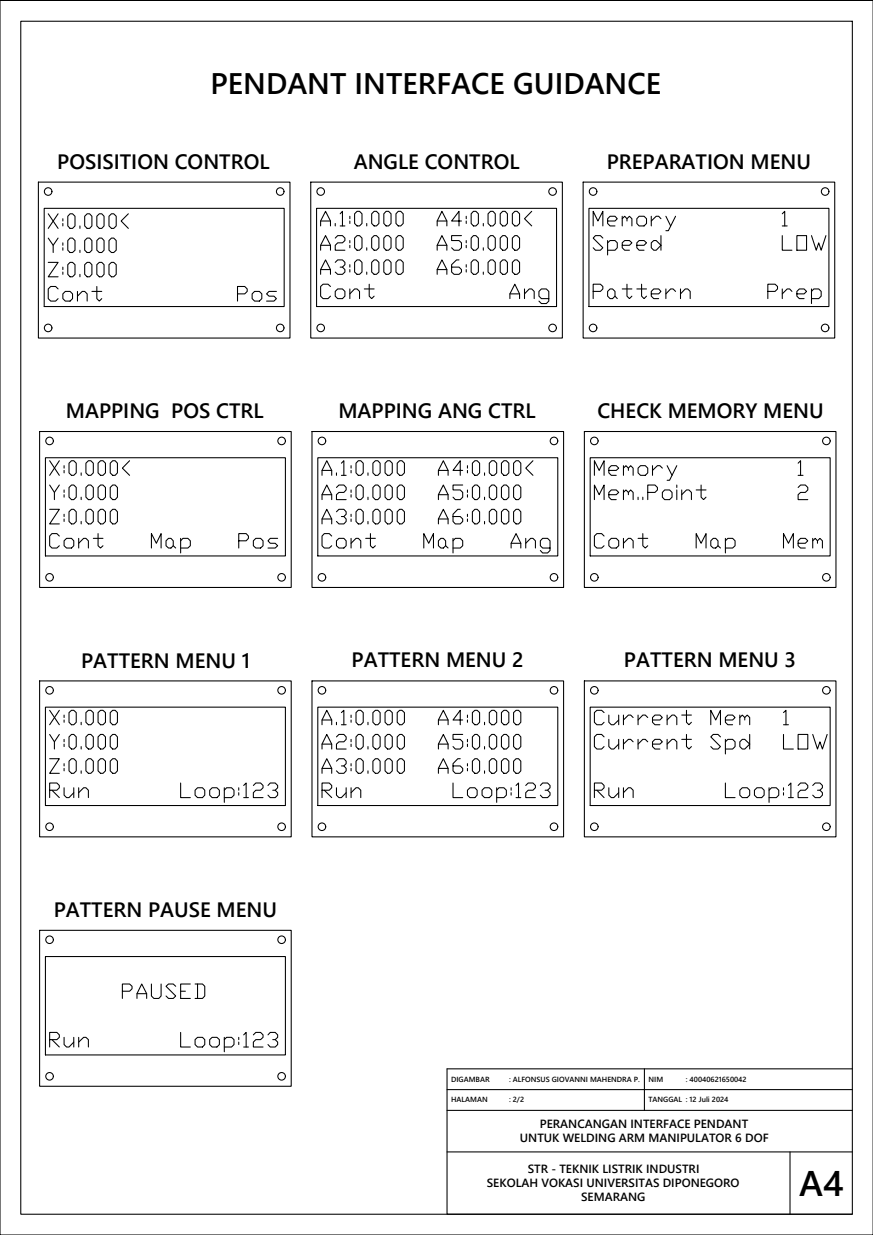
[picture p144: page 2]
PATTERN MENU 1; PATTERN MENU 2; PATTERN MENU 3; DIGAMBAR; : ALFONSUS GIOVANNI MAHENDRA P.; HALAMAN; NIM; SEMARANG; MAPPING POS CTRL; MAPPING ANG CTRL; CHECK MEMORY MENU

PATTERN PAUSE MENU

TANGGAL : 12 Juli 2024 PERANCANGAN INTERFACE PENDANT

UNTUK WELDING ARM MANIPULATOR 6 DOF

STR - TEKNIK LISTRIK INDUSTRI

SEKOLAH VOKASI UNIVERSITAS DIPONEGORO
