AlfonsusGiovanni/Welding-Arm-Manipulator/Schematic & PCB Design/Secondary PCB/Schematic PCB Secondary - Arm Manipulator.pdf

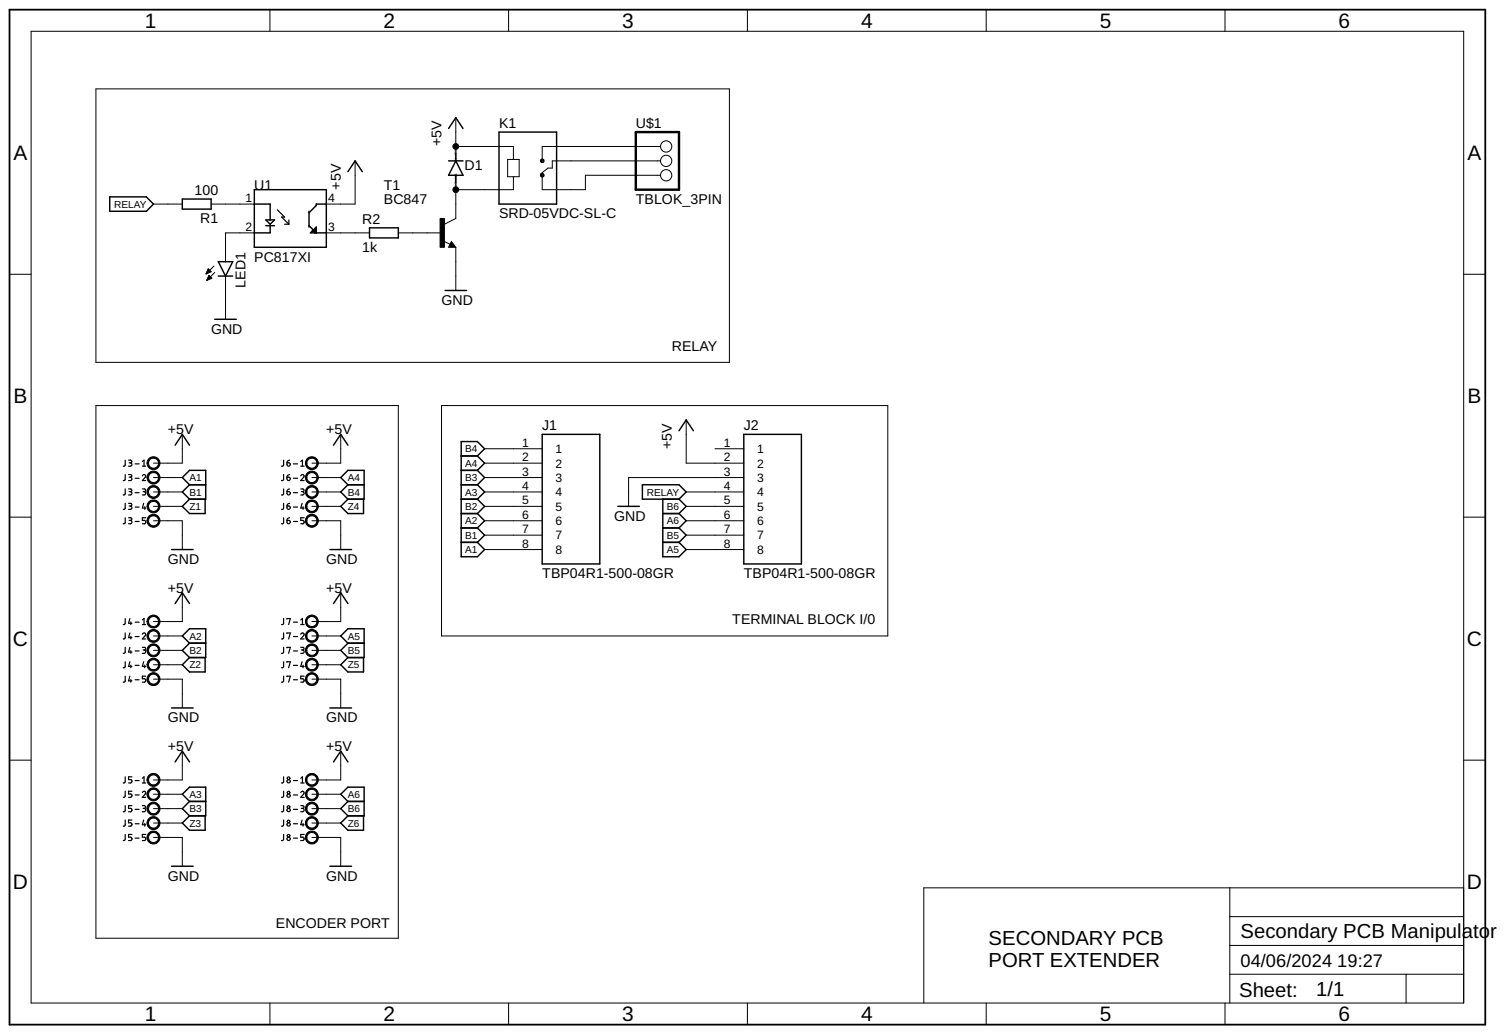
[picture p145: page 1]

SECONDARY PCB PORT EXTENDER

Sheet: 1/1
