AlfonsusGiovanni/Welding-Arm-Manipulator/Schematic & PCB Design/Main PCB/PDF Schematic/Main PCB Manipulator H7 Version.pdf

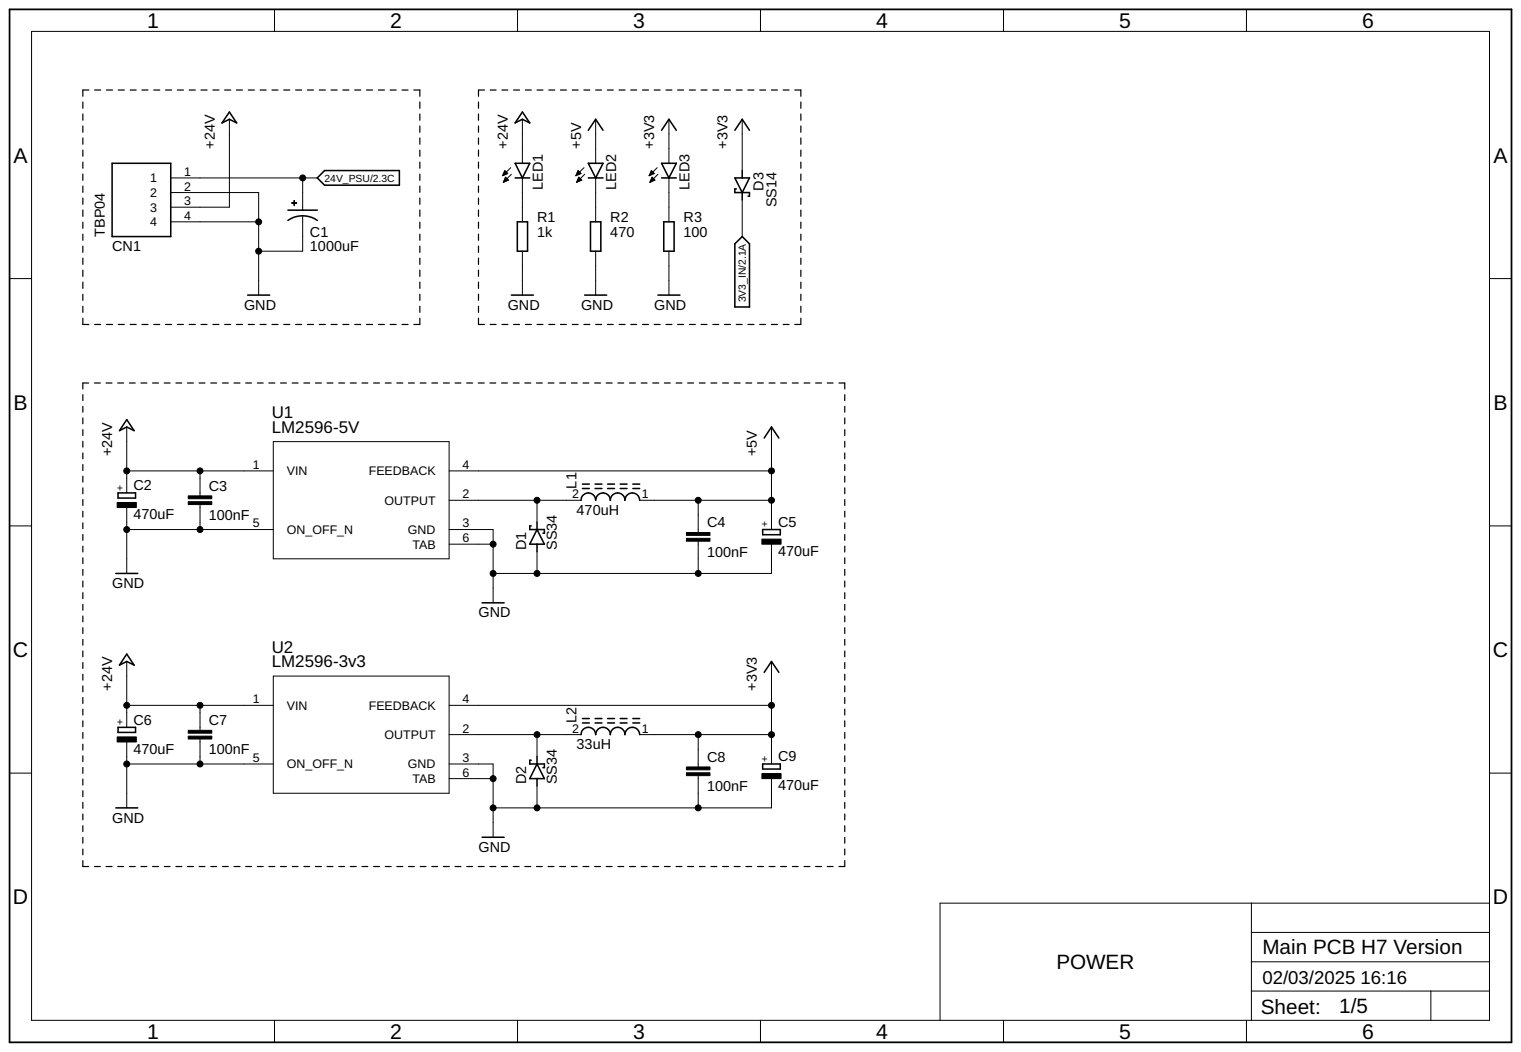
[picture p146: page 1]

POWER

Sheet:

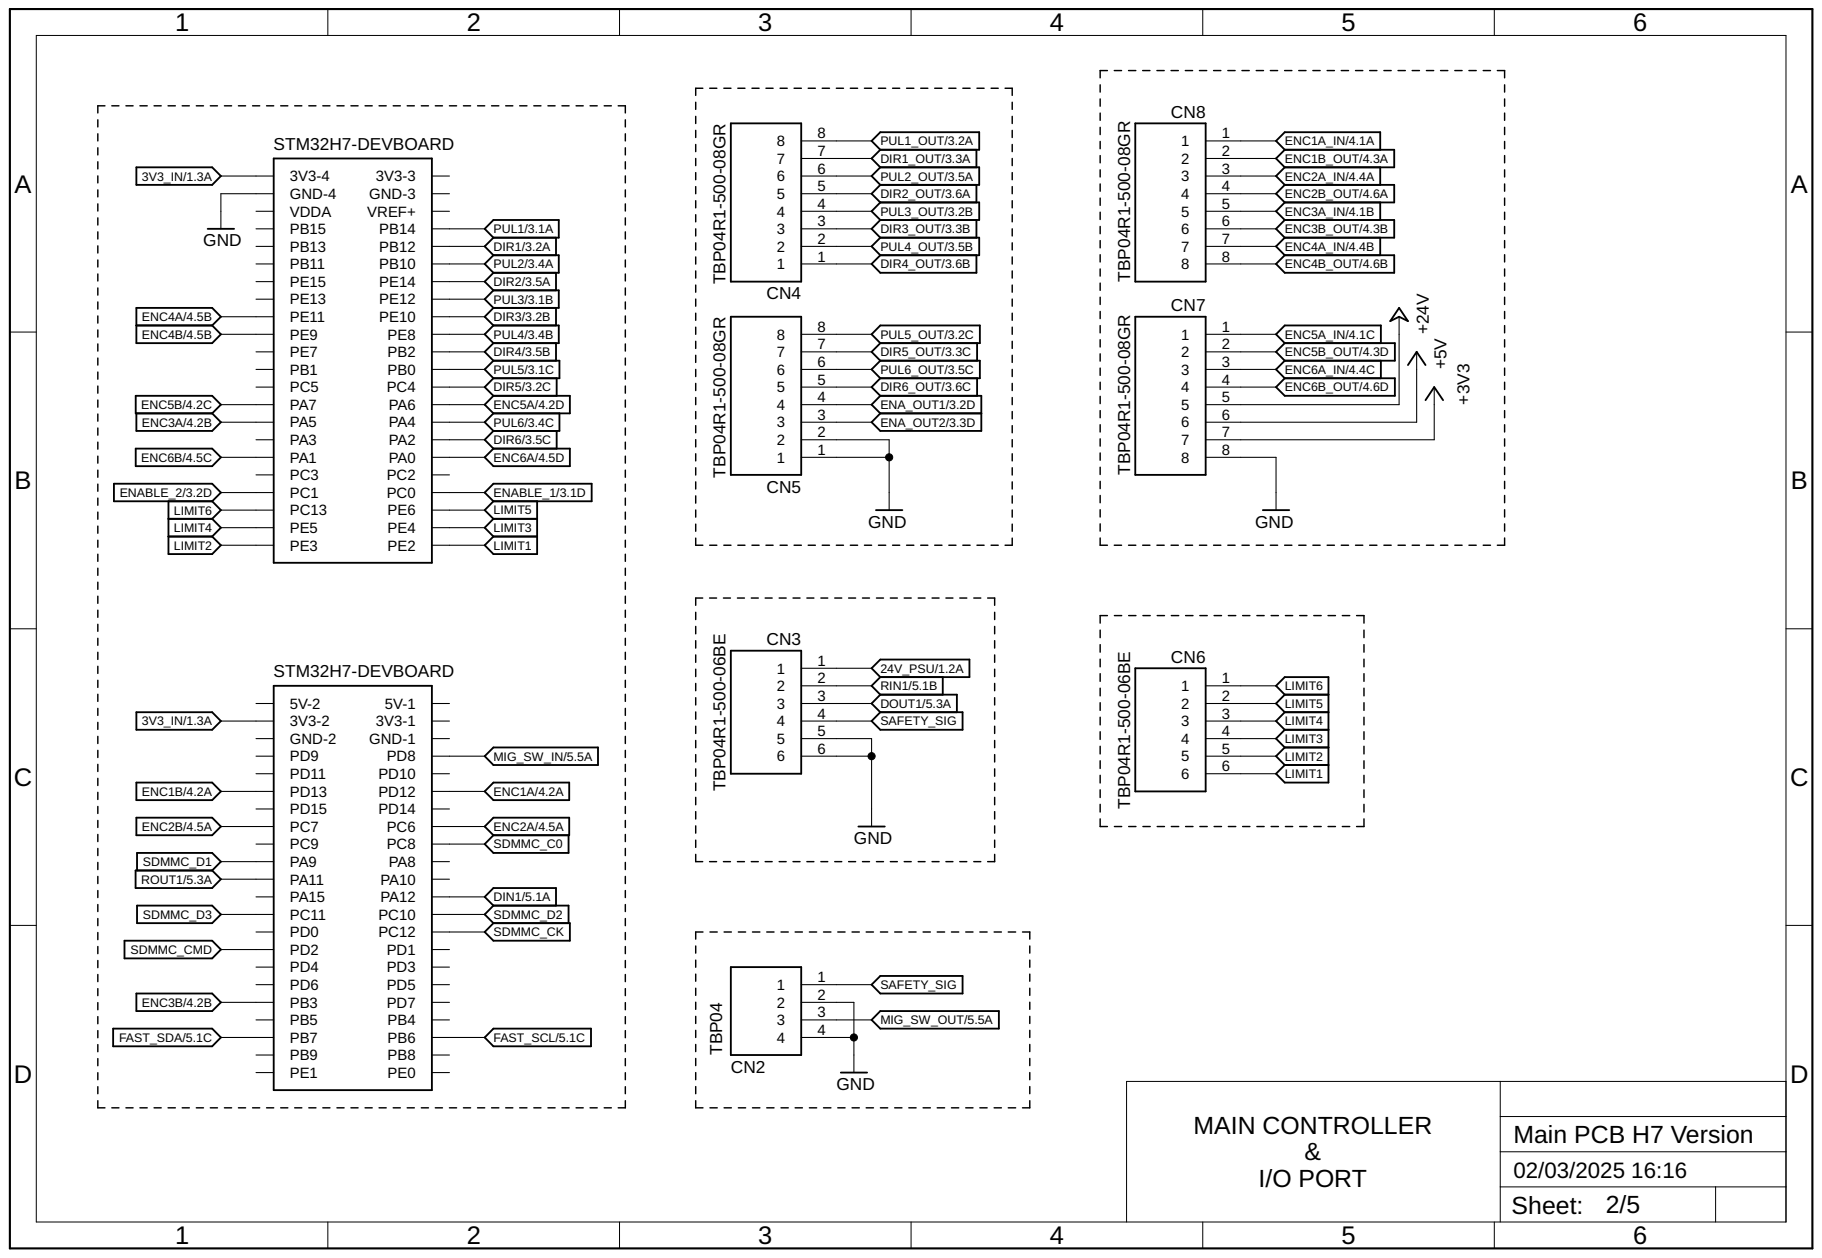
[picture p147: page 2]

+24V +5V GND GND TBP04 GNDGND TBP04R1-500-06BE +3V3 TBP04R1-500-08GR TBP04R1-500-08GR TBP04R1-500-08GR TBP04R1-500-08GR TBP04R1-500-06BE GND 5V-1 3V3-1 GND-1 PD8 PD10 PD12 PD14 PC6 PC8 PA8 PA10 PA12 PC10 PC12 PD1 PD3 PD5 PD7 PB4 PB6 PB8 PE0 5V-2 3V3-2 GND-2 PD9 PD11 PD13 PD15 PC7 PC9 PA9 PA11 PA15 PC11 PD0 PD2 PD4 PD6 PB3 PB5 PB7 PB9 PE1 STM32H7-DEVBOARD 3V3-3 GND-3 VREF+ PB14 PB12 PB10 PE14 PE12 PE10 PE8 PB2 PB0 PC4 PA6 PA4 PA2 PA0 PC2 PC0 PE6 PE4 PE2 3V3-4 GND-4 VDDA PB15 PB13 PB11 PE15 PE13 PE11 PE9 PE7 PB1 PC5 PA7 PA5 PA3 PA1 PC3 PC1 PC13 PE5 PE3 STM32H7-DEVBOARD 1 1 2 2 3 3 4 4 CN2 1 1 2 2 3 3 4 4 5 5 6 6 CN6 1 1 2 2 3 3 4 4 5 5 6 6 7 7 8 8 CN4 1 1 2 2 3 3 4 4 5 5 6 6 7 7 8 8 CN5 1 1 2 2 3 3 4 4 5 5 6 6 7 7 8 8 CN8 1 1 2 2 3 3 4 4 5 5 6 6 7 7 8 8 CN7 1 1 2 2 3 3 4 4 5 5 6 6 CN3 PUL1_OUT/3.2A DIR1_OUT/3.3A PUL2_OUT/3.5A DIR2_OUT/3.6A PUL3_OUT/3.2B DIR3_OUT/3.3B PUL4_OUT/3.5B DIR4_OUT/3.6B PUL5_OUT/3.2C DIR5_OUT/3.3C PUL6_OUT/3.5C DIR6_OUT/3.6C ENA_OUT1/3.2D ENC1A_IN/4.1A ENC1B_OUT/4.3A ENC2A_IN/4.4A ENC2B_OUT/4.6A ENC3A_IN/4.1B ENC3B_OUT/4.3B ENC4A_IN/4.4B ENC4B_OUT/4.6B ENC5A_IN/4.1C ENC5B_OUT/4.3D ENC6A_IN/4.4C ENC6B_OUT/4.6D SDMMC_CMD SDMMC_CK SDMMC_D3 SDMMC_D2 SDMMC_D1 SDMMC_C0 LIMIT1 LIMIT1 LIMIT2 LIMIT2 LIMIT4 LIMIT4 LIMIT6 LIMIT6 LIMIT3 LIMIT3 LIMIT5 LIMIT5 ENA_OUT2/3.3D RIN1/5.1B 24V_PSU/1.2A SAFETY_SIG SAFETY_SIG DOUT1/5.3A PUL1/3.1A DIR1/3.2A PUL2/3.4A DIR2/3.5A PUL3/3.1B DIR3/3.2B PUL4/3.4B DIR4/3.5B PUL5/3.1C DIR5/3.2C PUL6/3.4C DIR6/3.5C ENABLE_2/3.2D ENABLE_1/3.1D FAST_SDA/5.1C FAST_SCL/5.1C ENC1A/4.2A ENC2A/4.5A ENC1B/4.2A ENC2B/4.5A ENC3B/4.2B ENC5B/4.2C ENC3A/4.2B ENC6B/4.5C ENC6A/4.5D ENC5A/4.2D ENC4A/4.5B ENC4B/4.5B DIN1/5.1A ROUT1/5.3A MIG_SW_OUT/5.5A MIG_SW_IN/5.5A 3V3_IN/1.3A 3V3_IN/1.3A MAIN CONTROLLER & I/O PORT Sheet: ABCD 1 2 3 4 5 6 ABCD 1 2 3 4 5 6 Main PCB H7 Version 02/03/2025 16:16 2/5

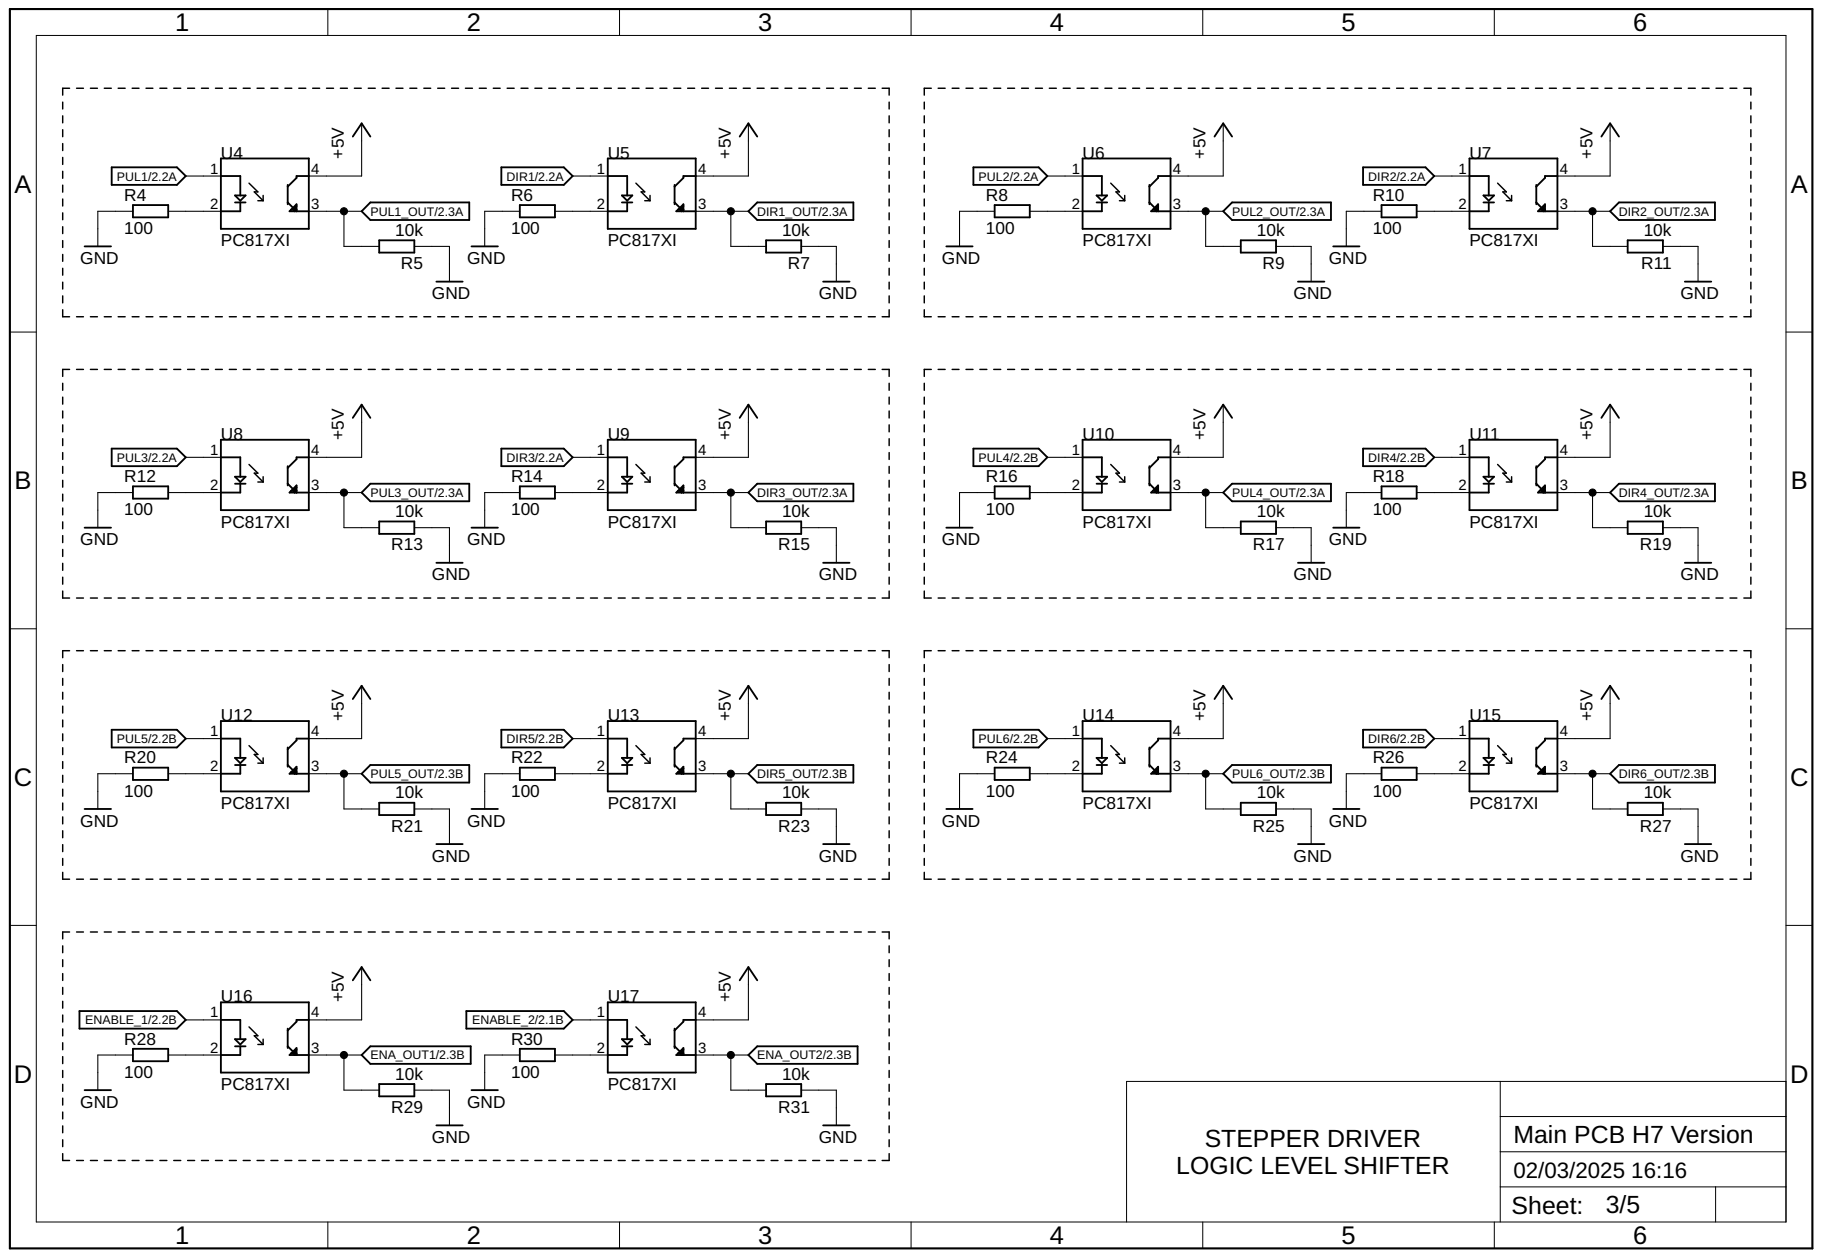
[picture p148: page 3]

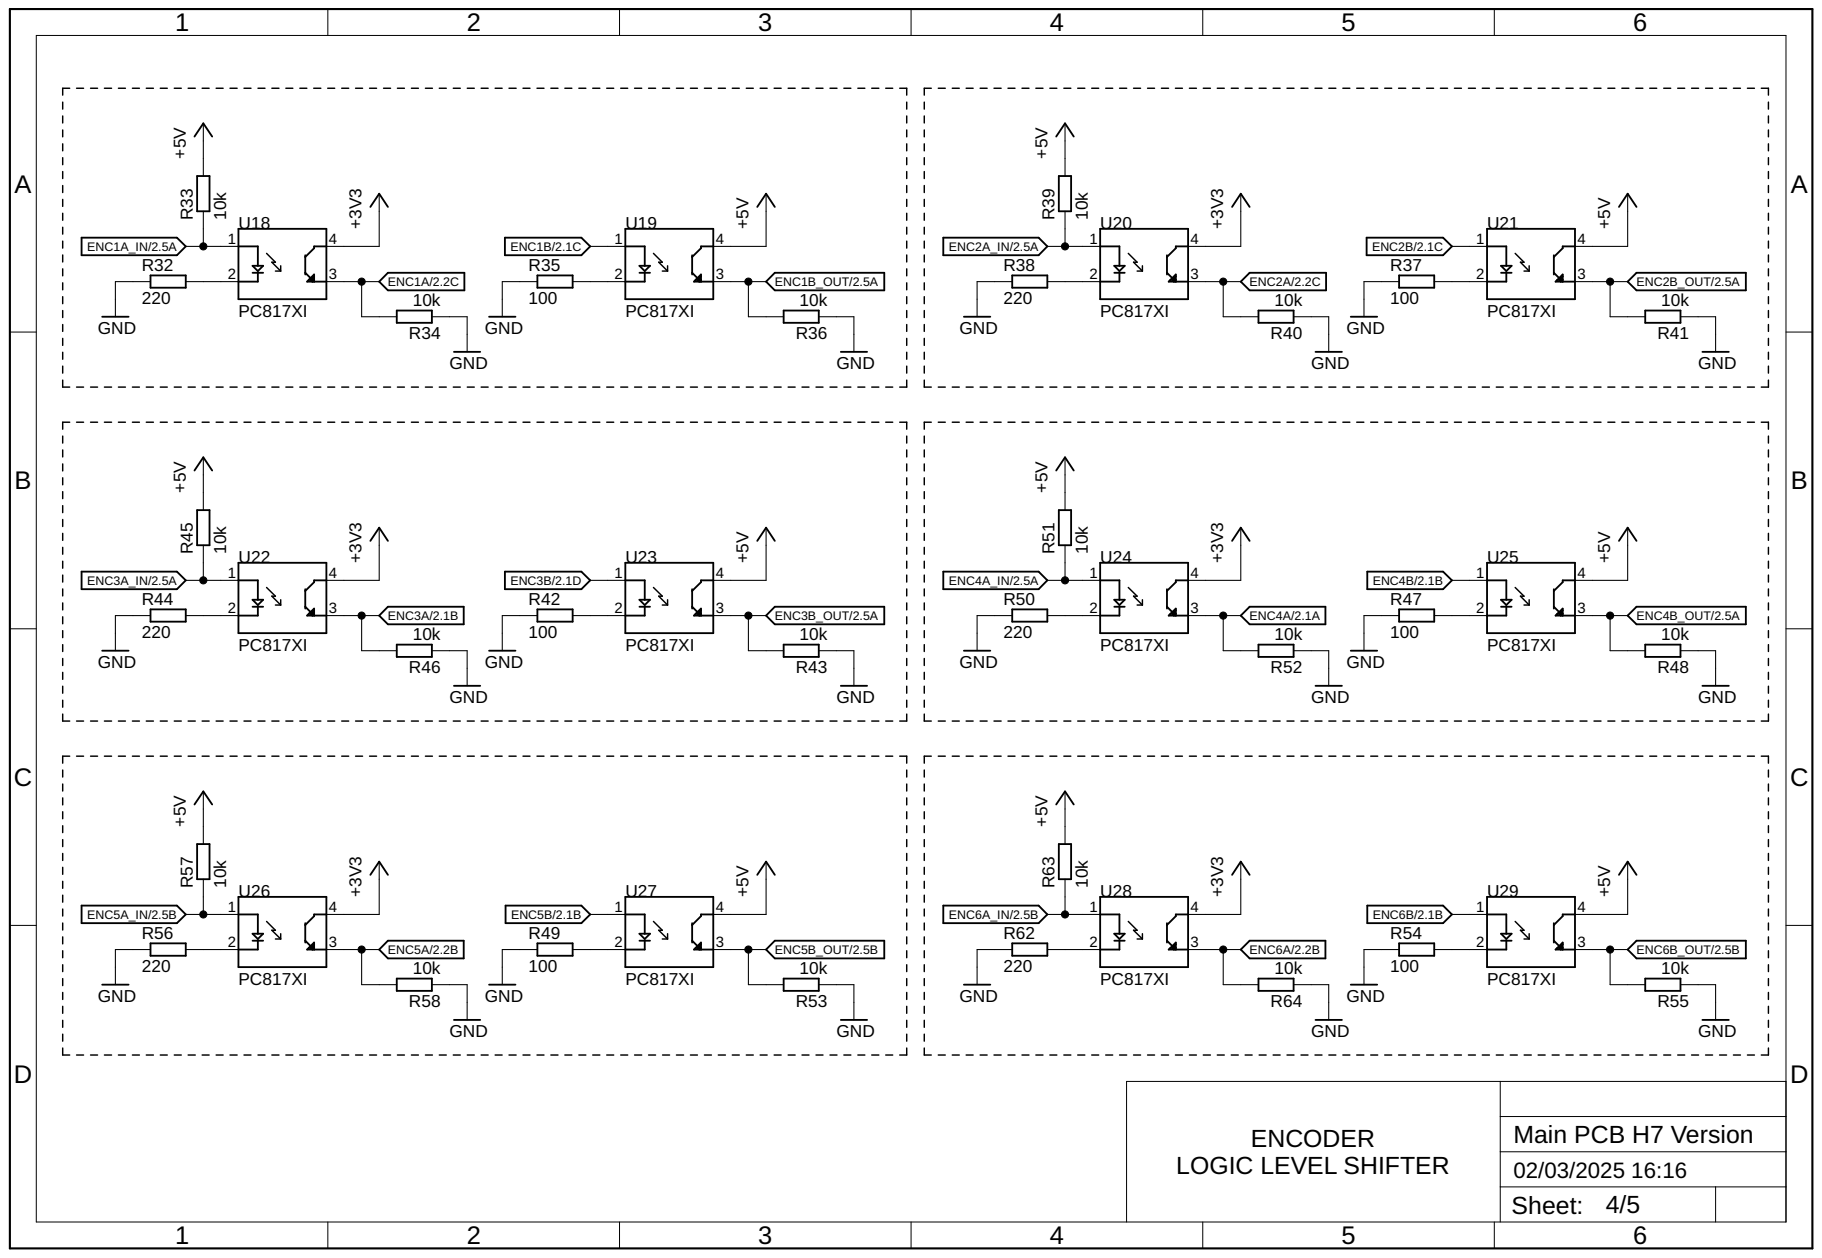
[picture p149: page 4]

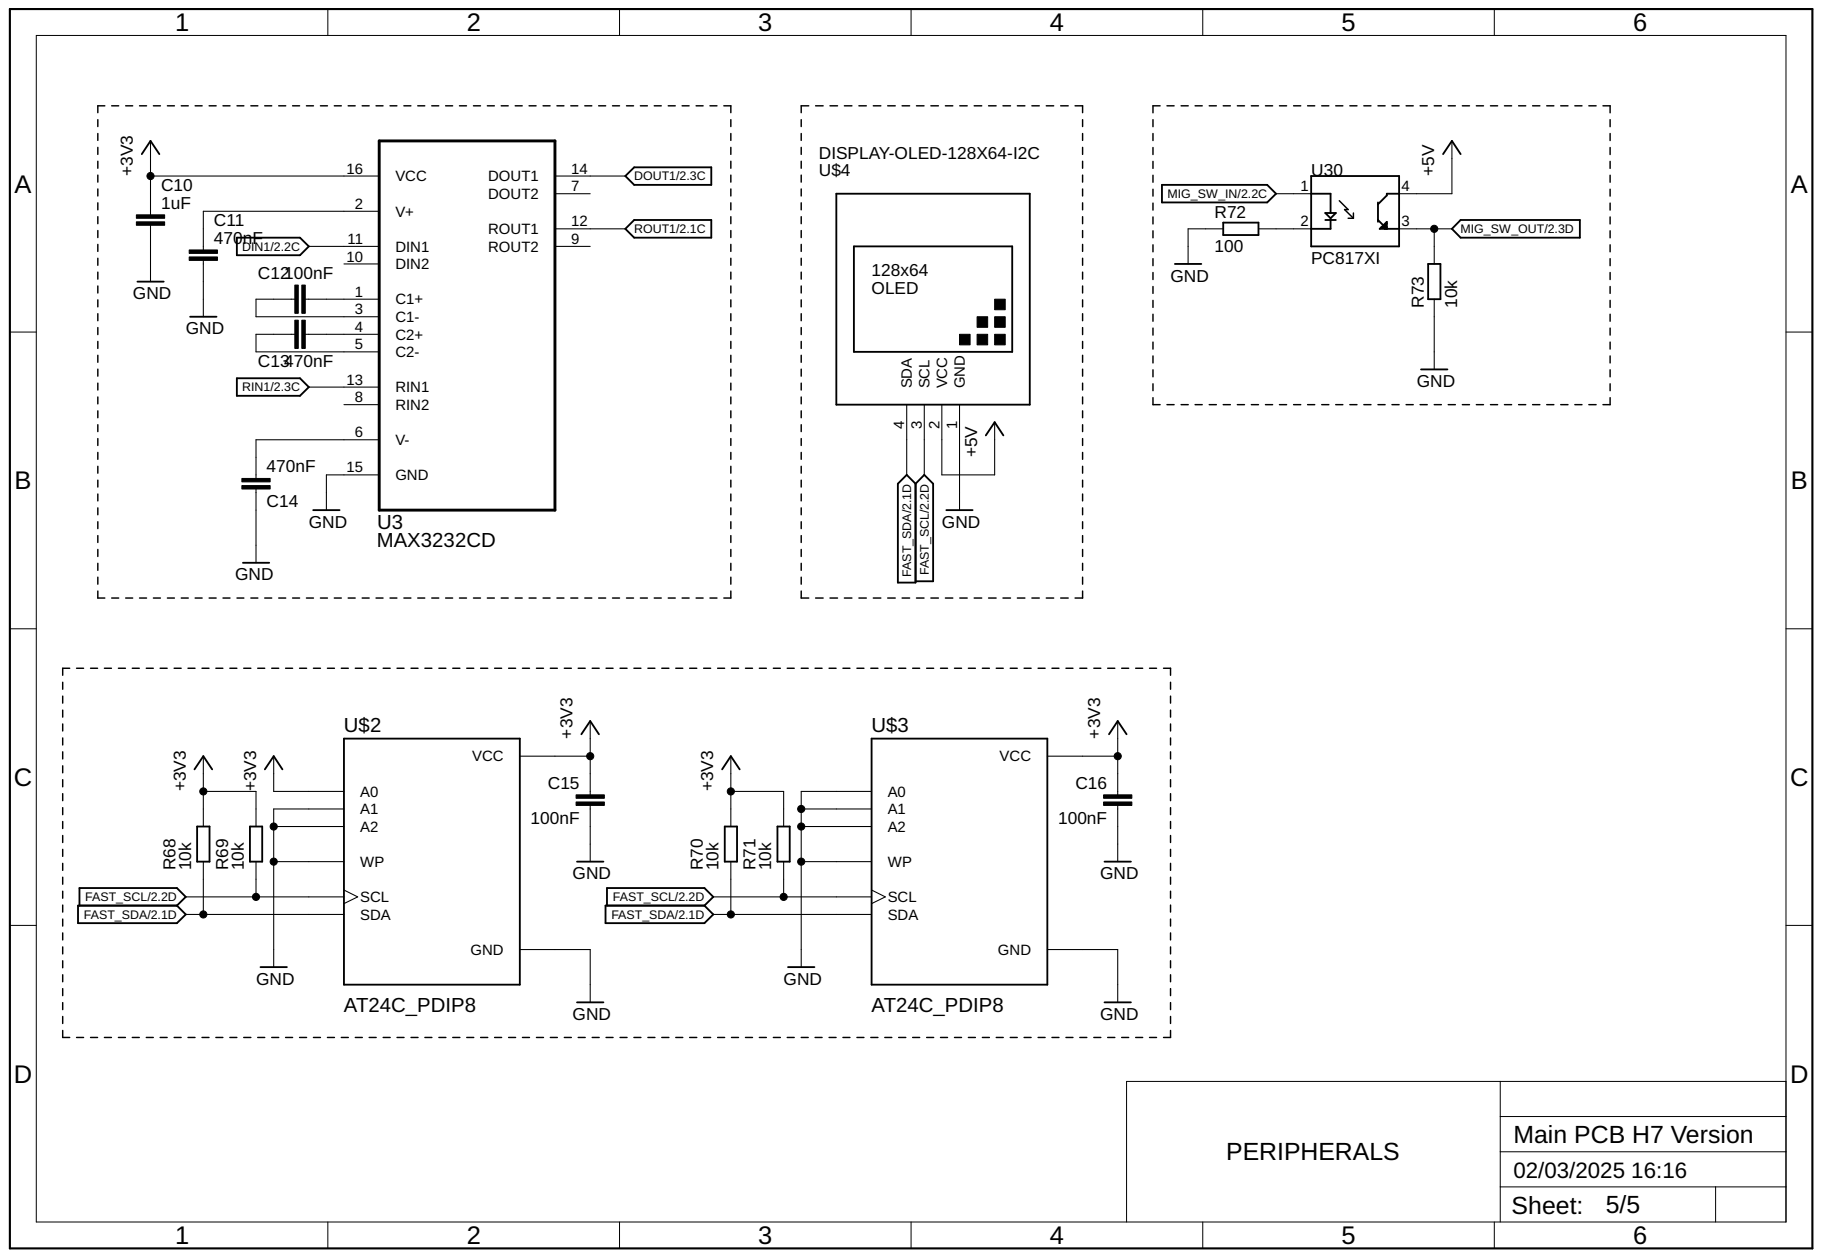
[picture p150: page 5]
