AlfonsusGiovanni/Welding-Arm-Manipulator/2D Design/Box Panel Kontrol/PDF/Box Panel TA-Hole Position.pdf

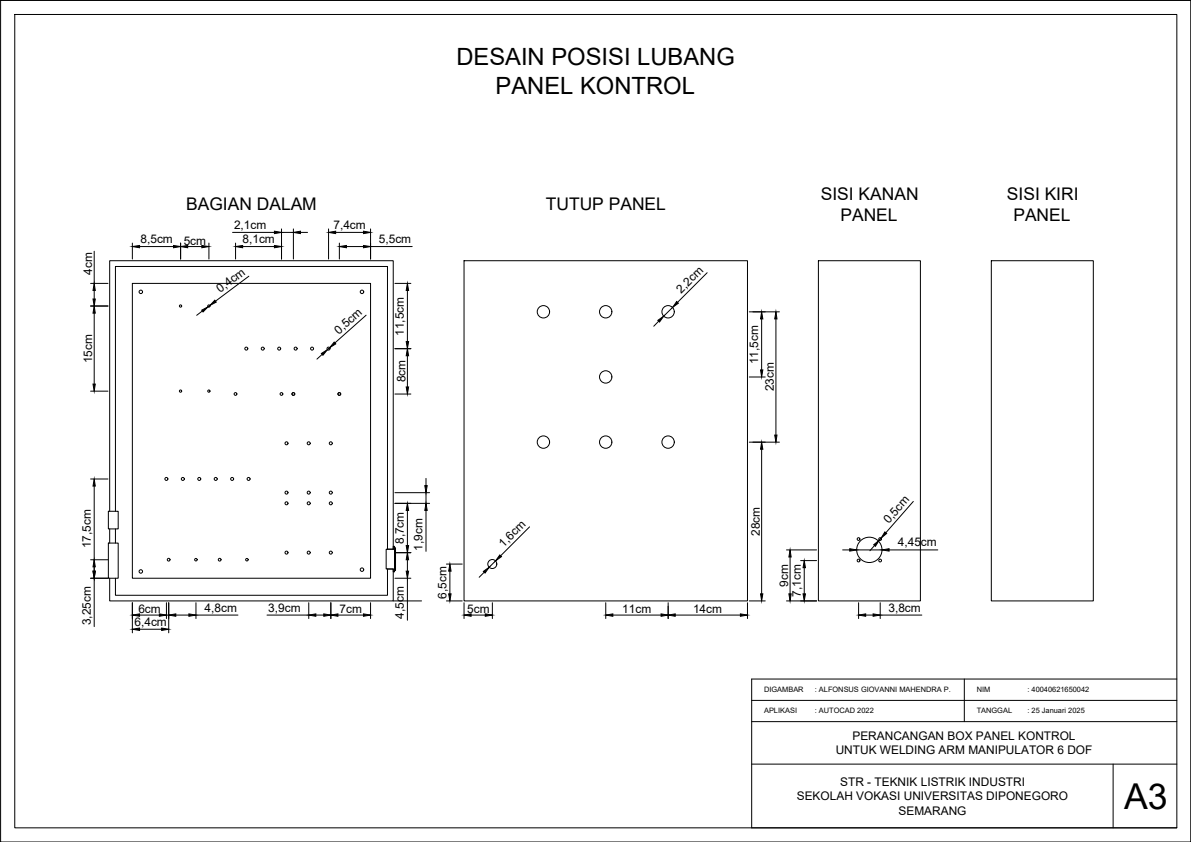
[picture p151: page 1]
DESAIN POSISI LUBANG PANEL KONTROL 6,4cm; DIGAMBAR; : ALFONSUS GIOVANNI MAHENDRA P. APLIKASI; : AUTOCAD 2022; NIM; : 40040621650042 TANGGAL; : 25 Januari 2025 PERANCANGAN BOX PANEL KONTROL UNTUK WELDING ARM MANIPULATOR 6 DOF STR - TEKNIK LISTRIK INDUSTRI SEKOLAH VOKASI UNIVERSITAS DIPONEGORO SEMARANG

0,5cm BAGIAN DALAM TUTUP PANEL SISI KANAN PANEL SISI KIRI PANEL 0,4cm 0,5cm
