AlfonsusGiovanni/Welding-Arm-Manipulator/2D Design/Box Panel Kontrol/PDF/Box Panel TA-Wiring Kontrol 1.pdf

PANEL KONTROL; DIGAMBAR; : ALFONSUS GIOVANNI MAHENDRA P.; APLIKASI; : AUTOCAD 2022; NIM; TANGGAL; : 25 Januari 2025; STEPPER 1-3; STEPPER 4-6

PENGAWATAN KOMPONEN KONTROL 1

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

PERANCANGAN BOX PANEL KONTROL
UNTUK WELDING ARM MANIPULATOR 6 DOF

STR - TEKNIK LISTRIK INDUSTRI

SEKOLAH VOKASI UNIVERSITAS DIPONEGORO
