AlfonsusGiovanni/Welding-Arm-Manipulator/Schematic & PCB Design/Pendant PCB/PDF Schematic/RS-232 Pendant.pdf

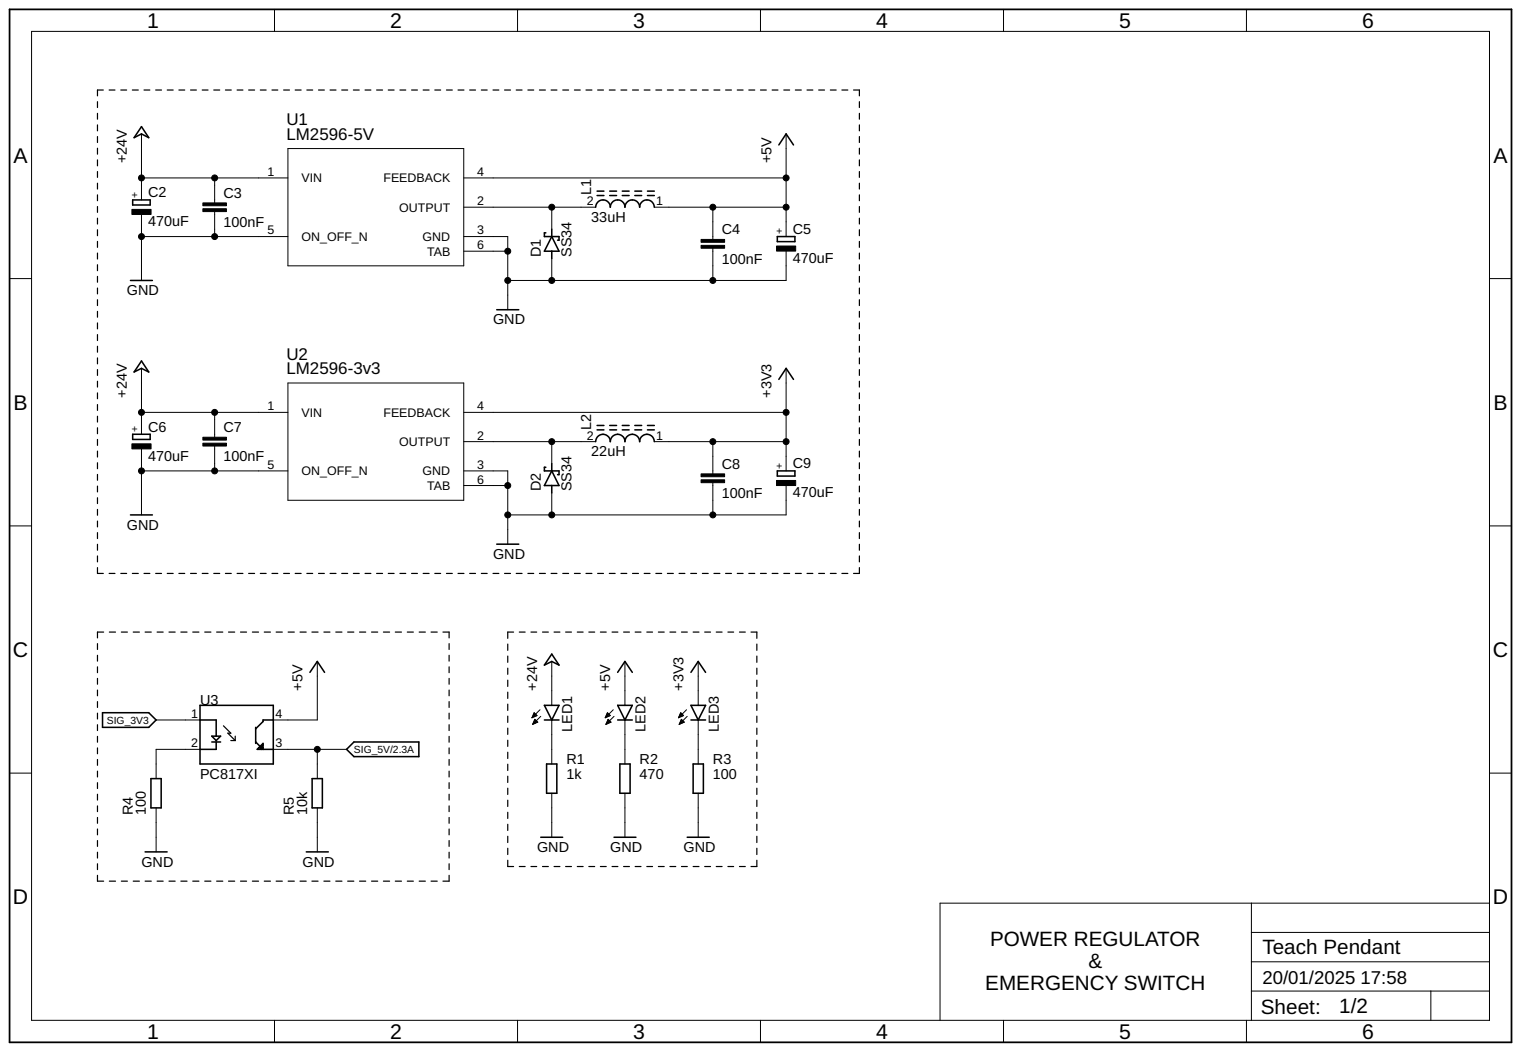
[picture p157: page 1]

POWER REGULATOR & EMERGENCY SWITCH

Sheet: 1/2

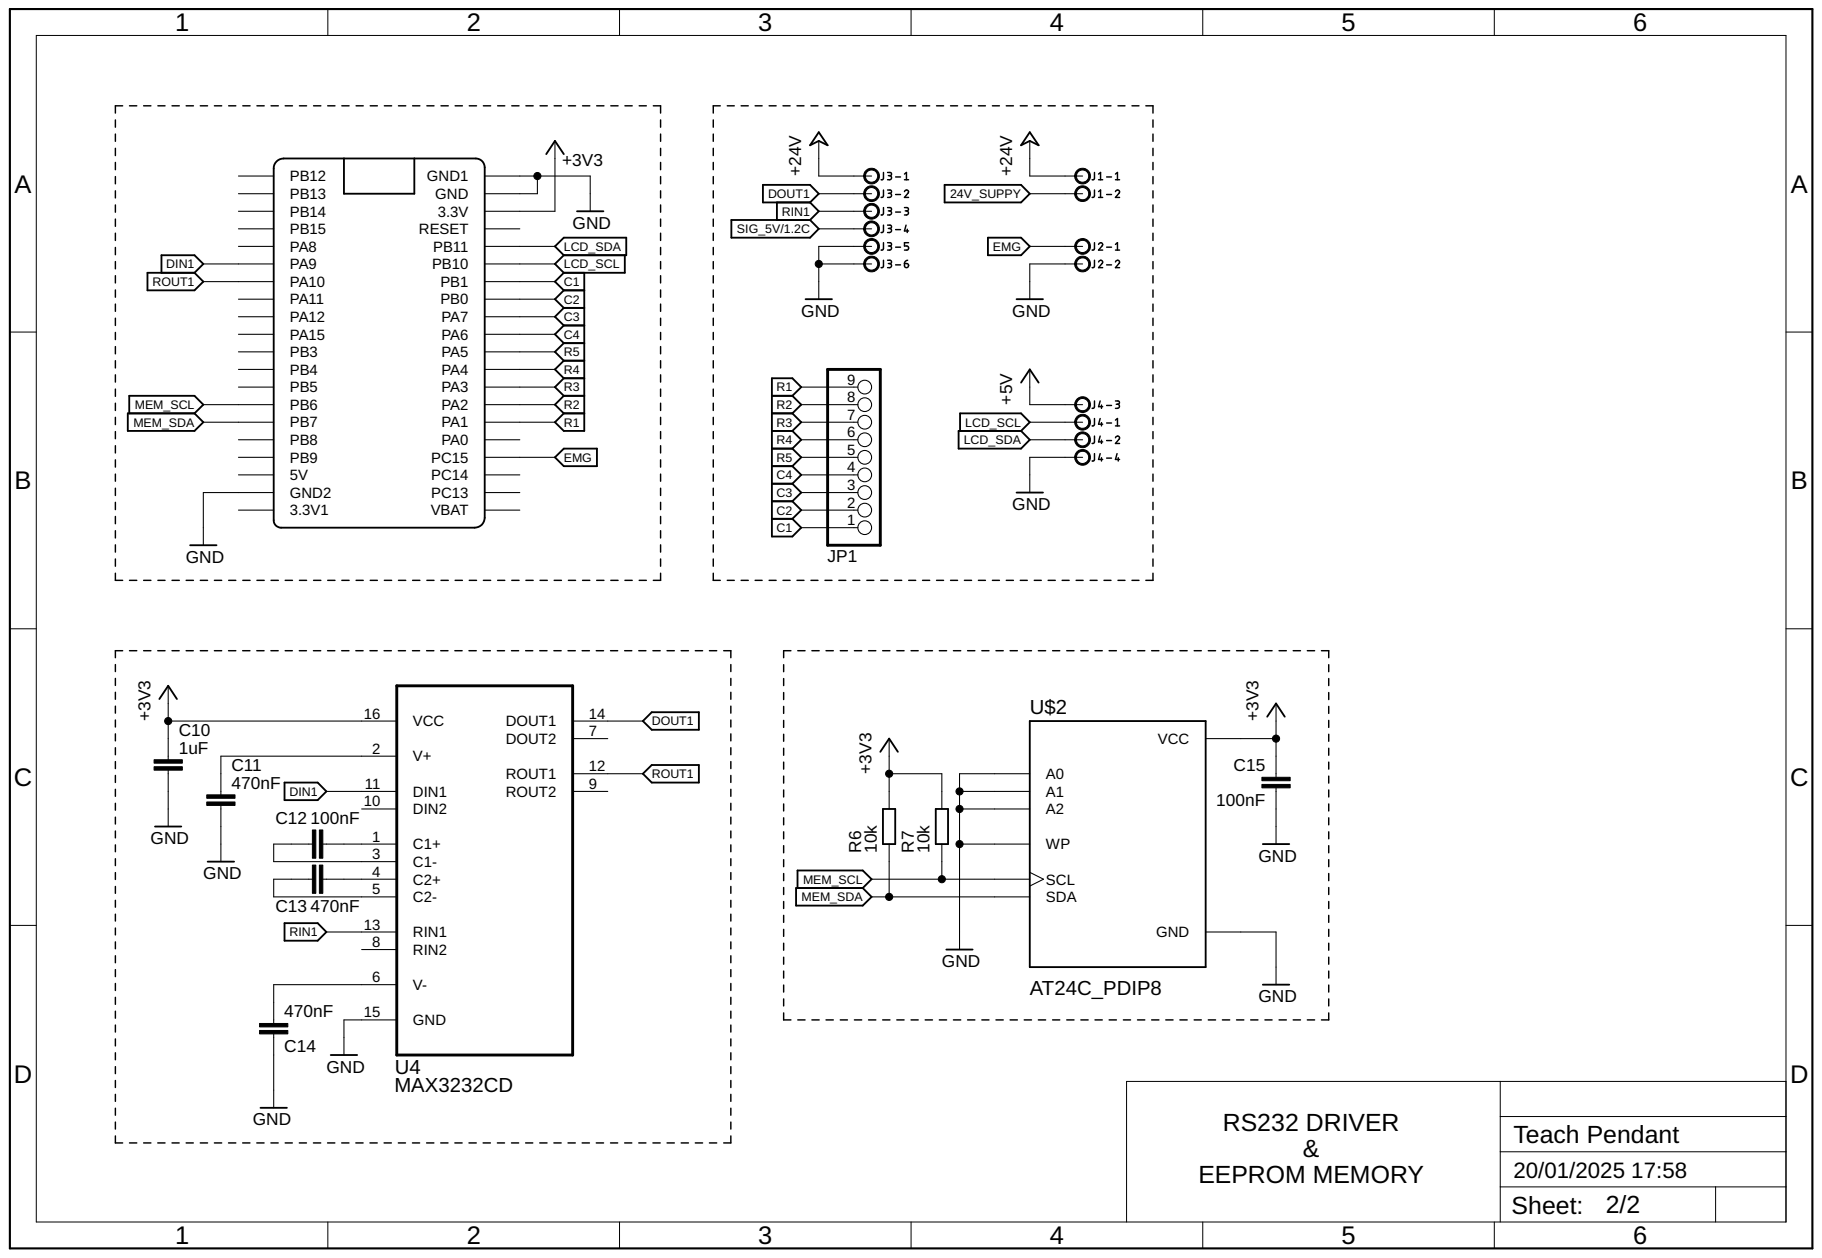
[picture p158: page 2]

RS232 DRIVER & EEPROM MEMORY

Sheet: 2/2
