AlfonsusGiovanni/Welding-Arm-Manipulator/2D Design/Pendant Case/PDF/Pendant Case Dimension Overview-Model.pdf

# DESAIN CASE TEACH PENDANT BOTTOM PART

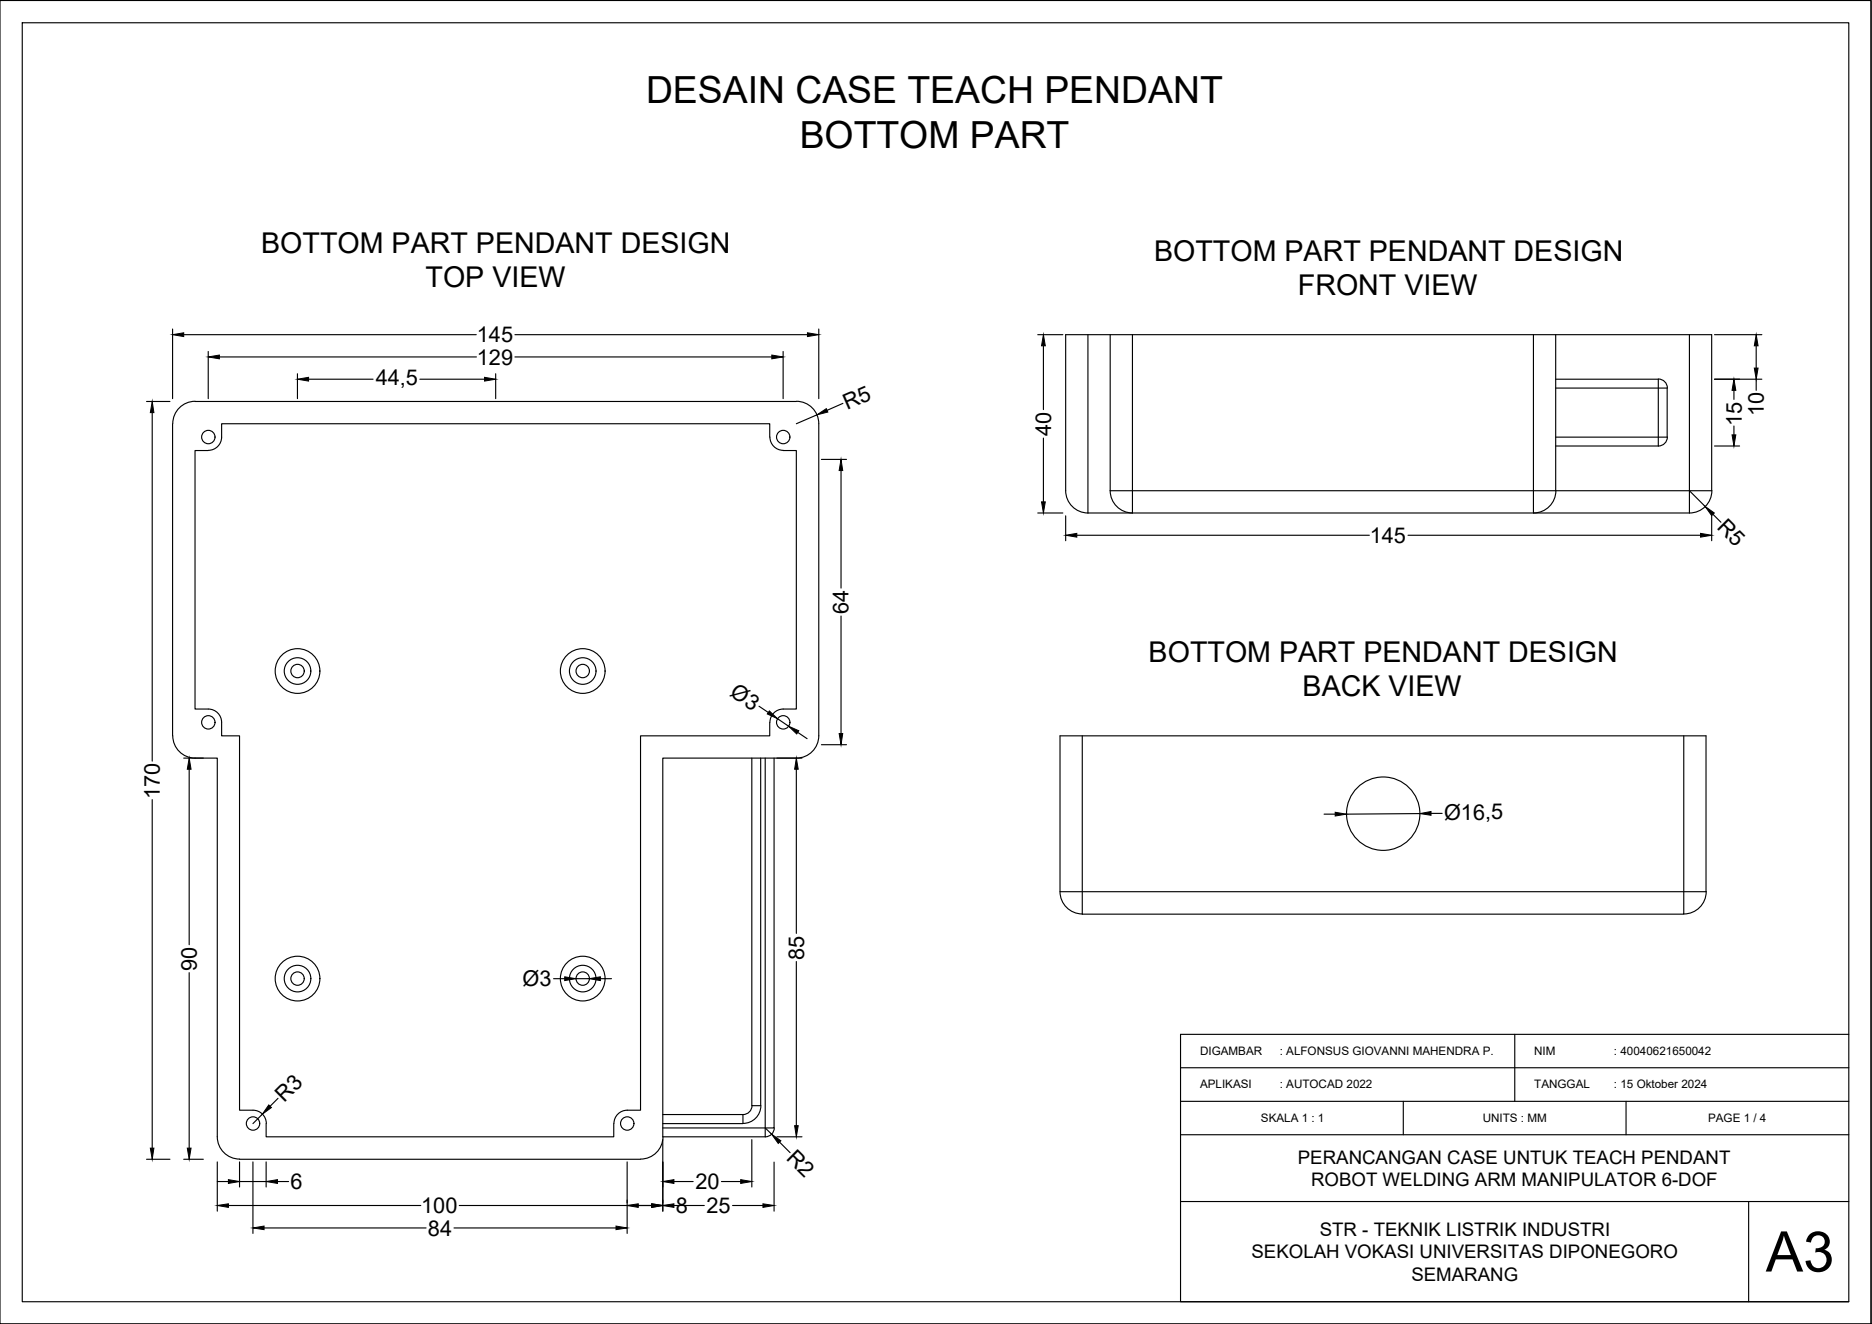
[picture p159: page 1]
DIGAMBAR; : ALFONSUS GIOVANNI MAHENDRA P.; APLIKASI; : AUTOCAD 2022; NIM; TANGGAL; : 15 Oktober 2024; SEMARANG; 100 ¹⁷⁰; SKALA 1 : 1; TOP VIEW; FRONT VIEW; BACK VIEW 85; UNITS : MM; PAGE 1 / 4

BOTTOM PART PENDANT DESIGN

PERANCANGAN CASE UNTUK TEACH PENDANT
ROBOT WELDING ARM MANIPULATOR 6-DOF

STR - TEKNIK LISTRIK INDUSTRI

SEKOLAH VOKASI UNIVERSITAS DIPONEGORO

# BOTTOM PART

## BOTTOM PART PENDANT DESIGN

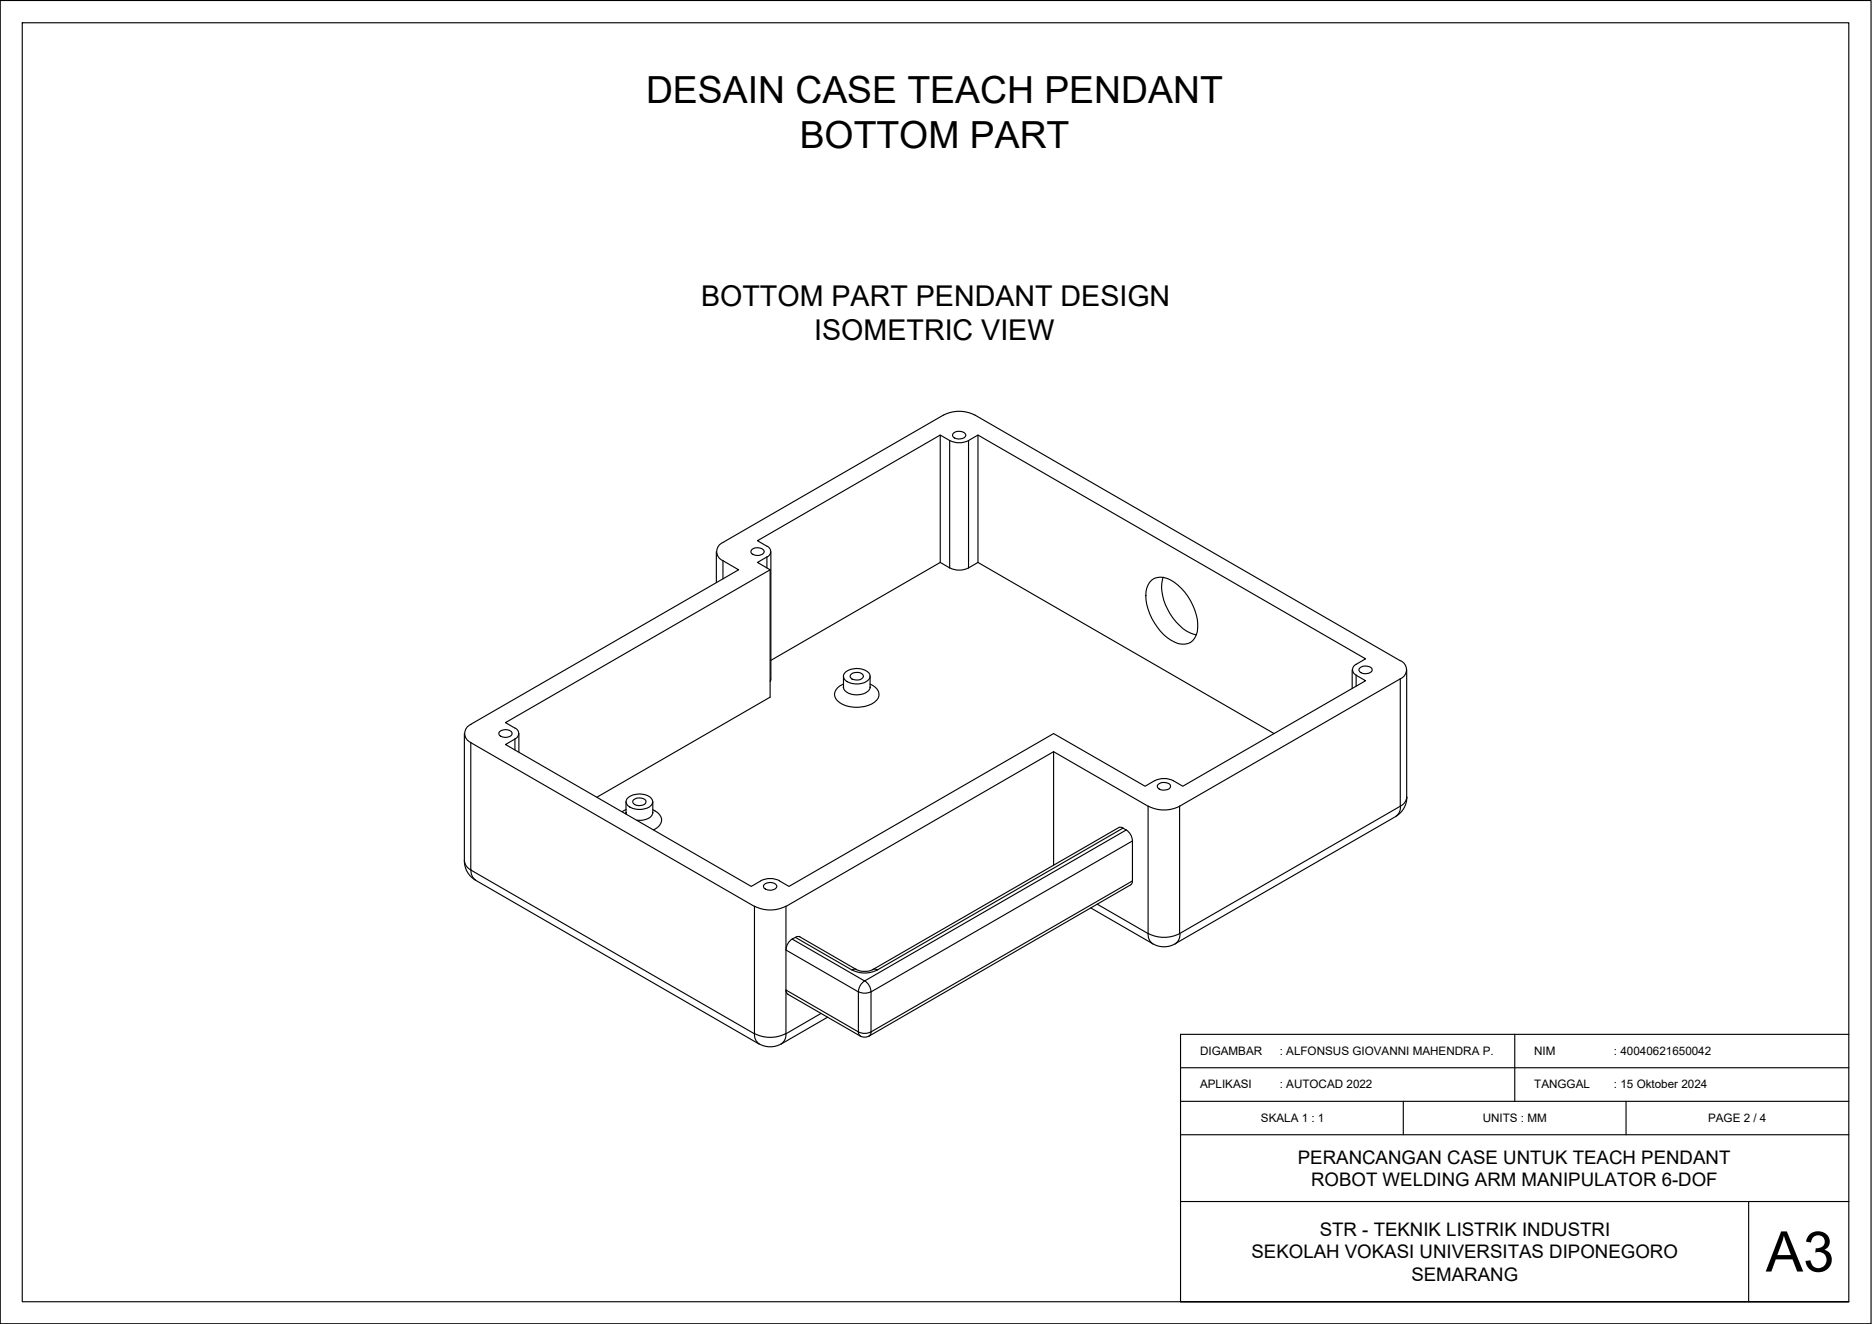
[picture p160: page 2]
ISOMETRIC VIEW; DIGAMBAR; : ALFONSUS GIOVANNI MAHENDRA P.; APLIKASI; : AUTOCAD 2022; NIM; TANGGAL; : 15 Oktober 2024; SKALA 1 : 1; UNITS : MM; PAGE 2 / 4

PERANCANGAN CASE UNTUK TEACH PENDANT
ROBOT WELDING ARM MANIPULATOR 6-DOF

# TOP PART

## TOP PART PENDANT DESIGN

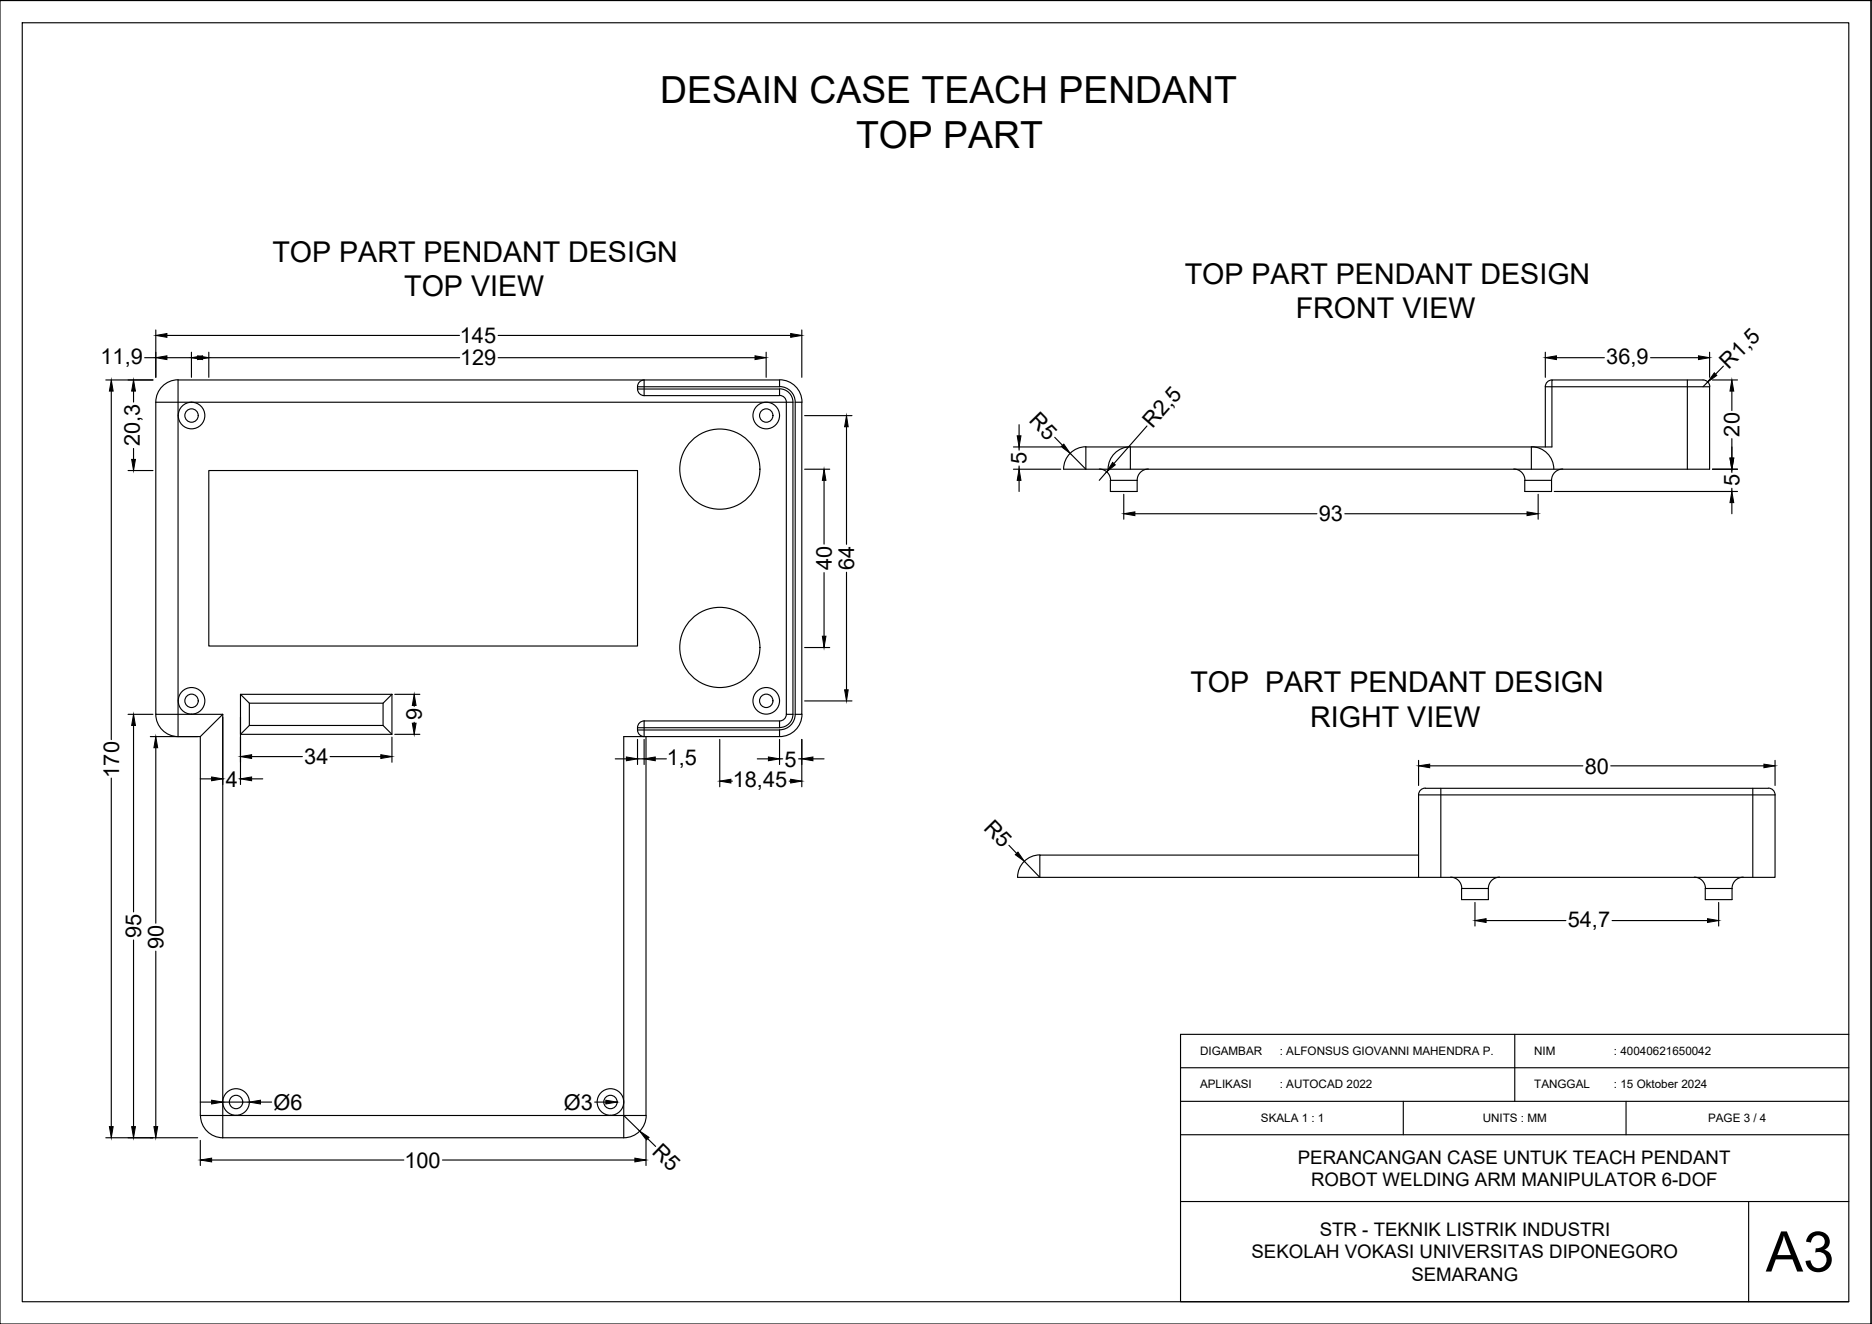
[picture p161: page 3]
DIGAMBAR; : ALFONSUS GIOVANNI MAHENDRA P.; APLIKASI; : AUTOCAD 2022; NIM; TANGGAL; : 15 Oktober 2024; SKALA 1 : 1; UNITS : MM; PAGE 3 / 4; TOP VIEW; TOP PART PENDANT DESIGN; FRONT VIEW; RIGHT VIEW

TOP PART PENDANT DESIGN

PERANCANGAN CASE UNTUK TEACH PENDANT
ROBOT WELDING ARM MANIPULATOR 6-DOF

# TOP PART

## TOP PART PENDANT DESIGN

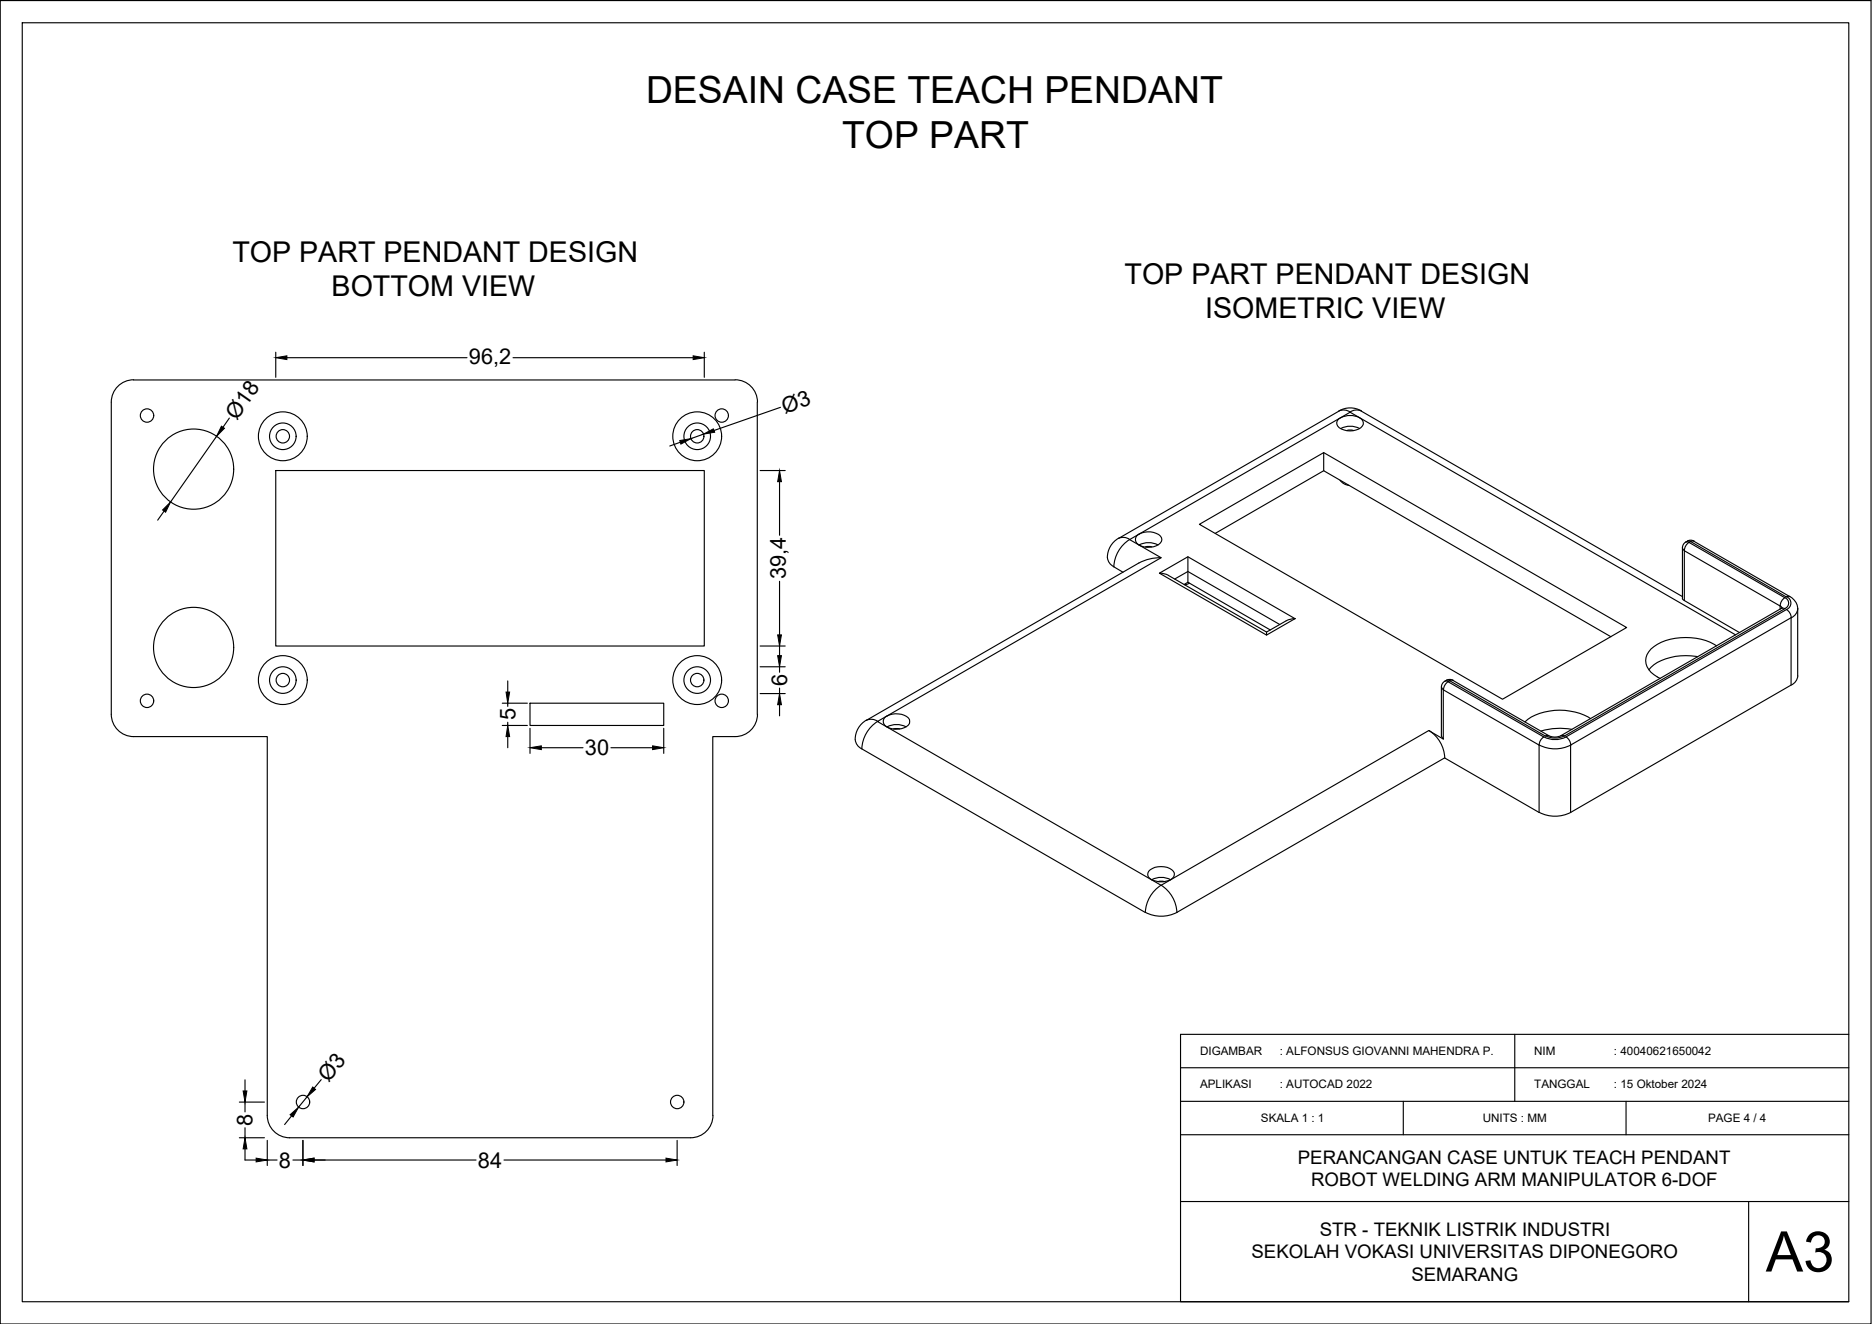
[picture p162: page 4]
DIGAMBAR; : ALFONSUS GIOVANNI MAHENDRA P.; APLIKASI; : AUTOCAD 2022; NIM; TANGGAL; : 15 Oktober 2024; SKALA 1 : 1; UNITS : MM; PAGE 4 / 4; BOTTOM VIEW; TOP PART PENDANT DESIGN; ISOMETRIC VIEW

PERANCANGAN CASE UNTUK TEACH PENDANT
ROBOT WELDING ARM MANIPULATOR 6-DOF
