AlfonsusGiovanni/Welding-Arm-Manipulator/2D Design/Pendant Case/PDF/Pendant Case Dimension Page 1-Model.pdf

BOTTOM PART; TOP VIEW; FRONT VIEW; BACK VIEW 85

DESAIN CASE TEACH PENDANT

BOTTOM PART PENDANT DESIGN

DIGAMBAR : ALFONSUS GIOVANNI MAHENDRA P. | NIM : 40040621650042

APLIKASI : AUTOCAD 2022 | TANGGAL : 15 Oktober 2024

SKALA 1 : 1 | UNITS : MM | PAGE 1 / 4

PERANCANGAN CASE UNTUK TEACH PENDANT
ROBOT WELDING ARM MANIPULATOR 6-DOF

STR - TEKNIK LISTRIK INDUSTRI

SEKOLAH VOKASI UNIVERSITAS DIPONEGORO
