AlfonsusGiovanni/Welding-Arm-Manipulator/Schematic & PCB Design/Box Panel/Desain Box Panel Kontrol/Box Panel TA-Model.pdf

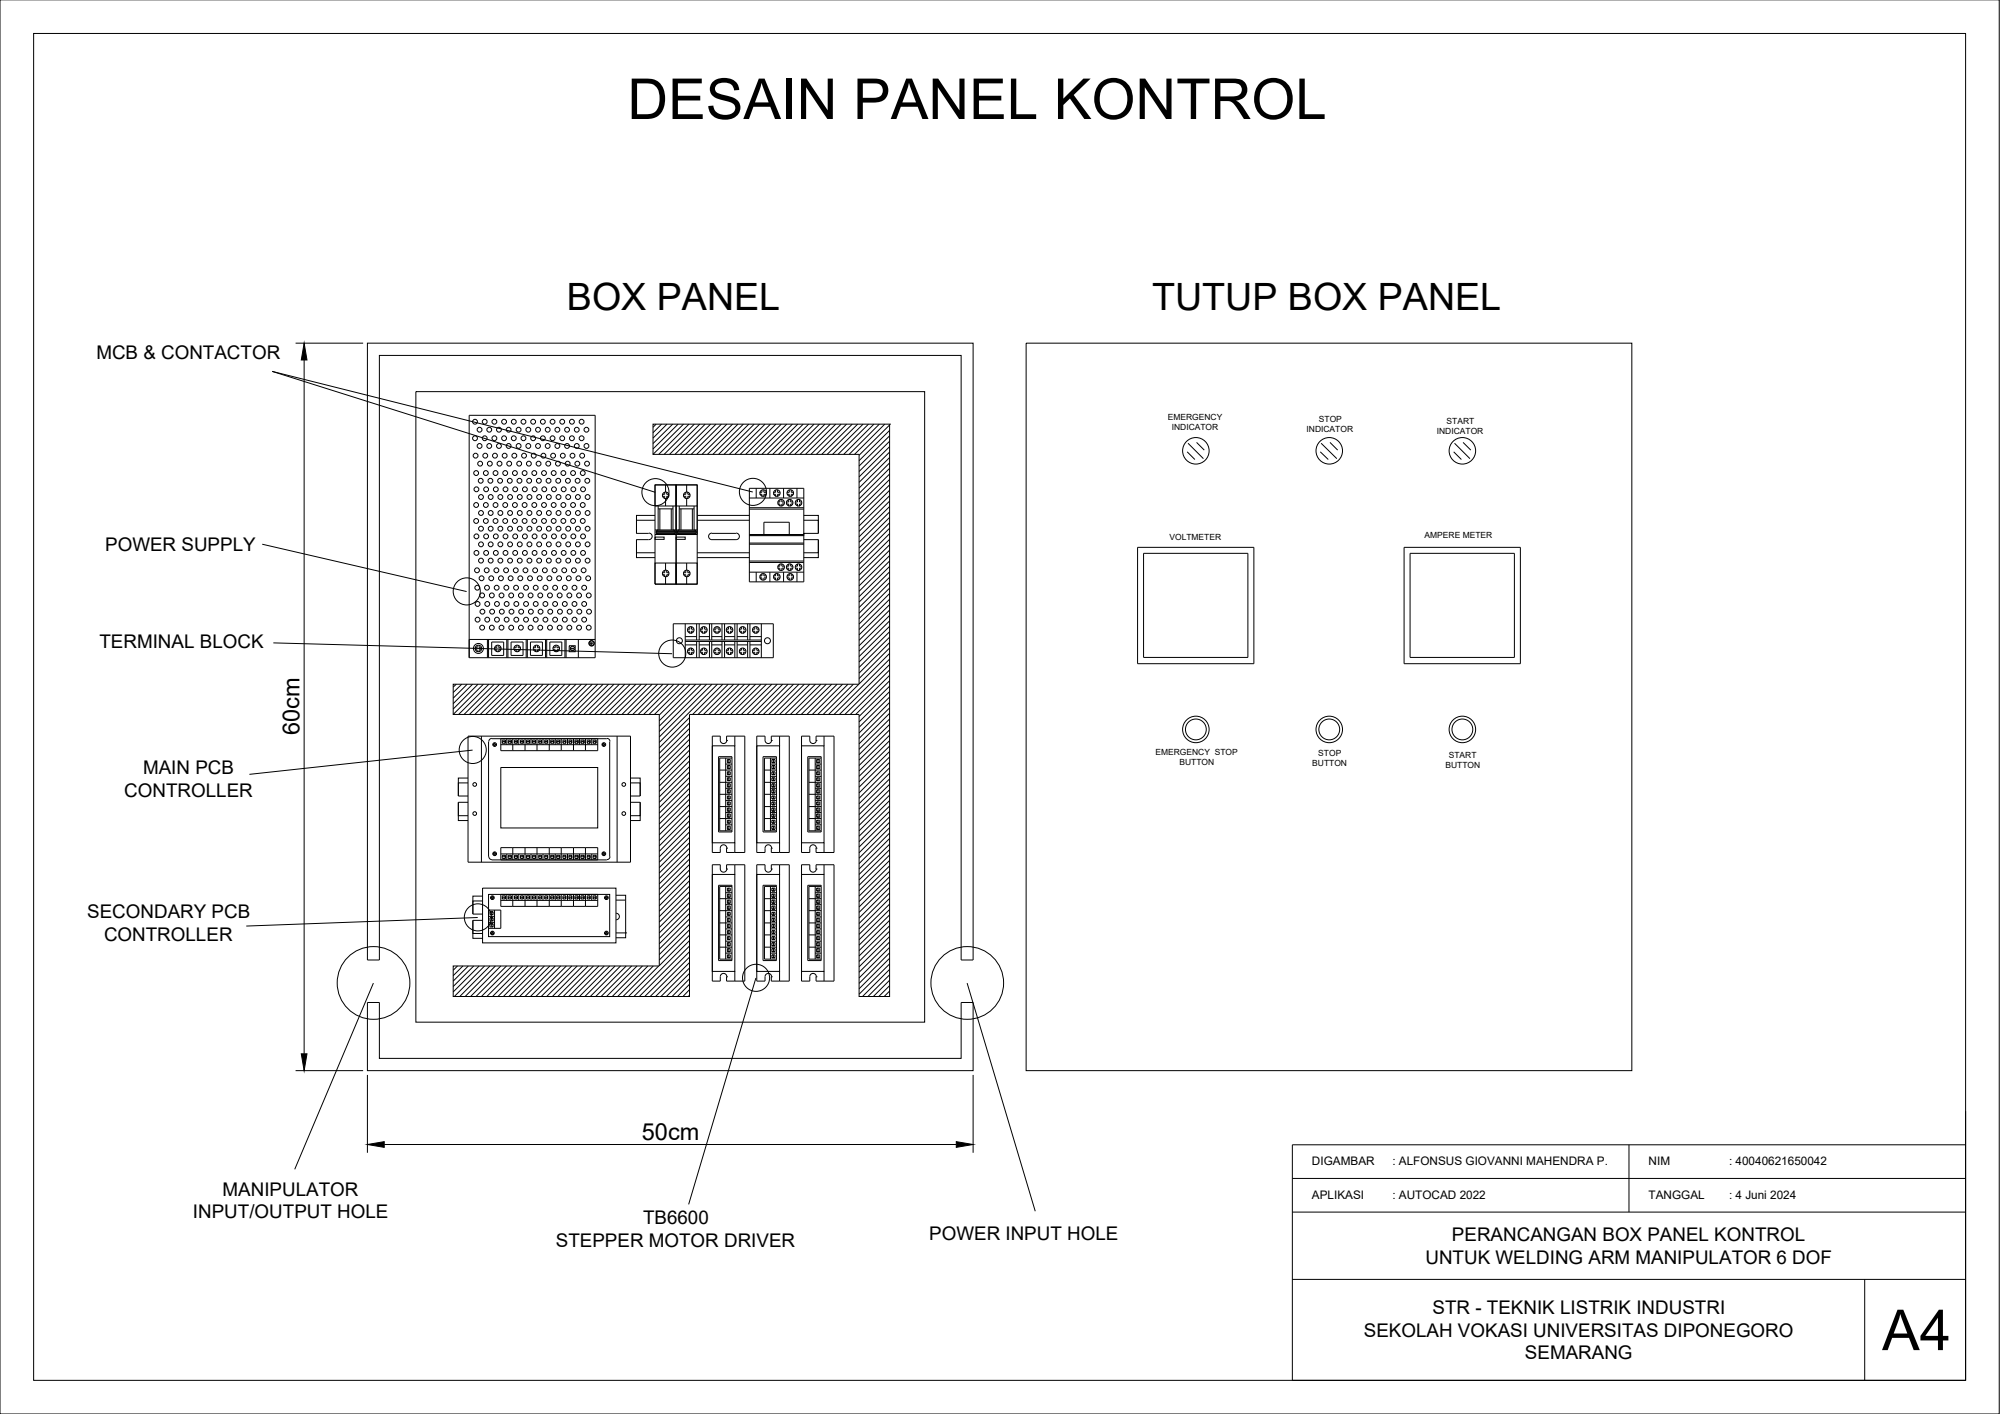
[picture p163: page 1]
VOLTMETER; AMPERE METER; EMERGENCY STOP; START BUTTON; BOX PANEL; TUTUP BOX PANEL; MAIN PCB; SECONDARY PCB; MCB & CONTACTOR; POWER SUPPLY; TERMINAL BLOCK

DESAIN PANEL KONTROL 60cm

DIGAMBAR : ALFONSUS GIOVANNI MAHENDRA P. | NIM : 40040621650042

MANIPULATOR
INPUT/OUTPUT HOLE

APLIKASI : AUTOCAD 2022 | TANGGAL : 4 Juni 2024 PERANCANGAN BOX PANEL KONTROL

POWER INPUT HOLE

STEPPER MOTOR DRIVER

UNTUK WELDING ARM MANIPULATOR 6 DOF

STR - TEKNIK LISTRIK INDUSTRI

SEKOLAH VOKASI UNIVERSITAS DIPONEGORO
