AlfonsusGiovanni/Welding-Arm-Manipulator/Referensi/DRAWING BAK VIAR PDF/Foot Step.pdf

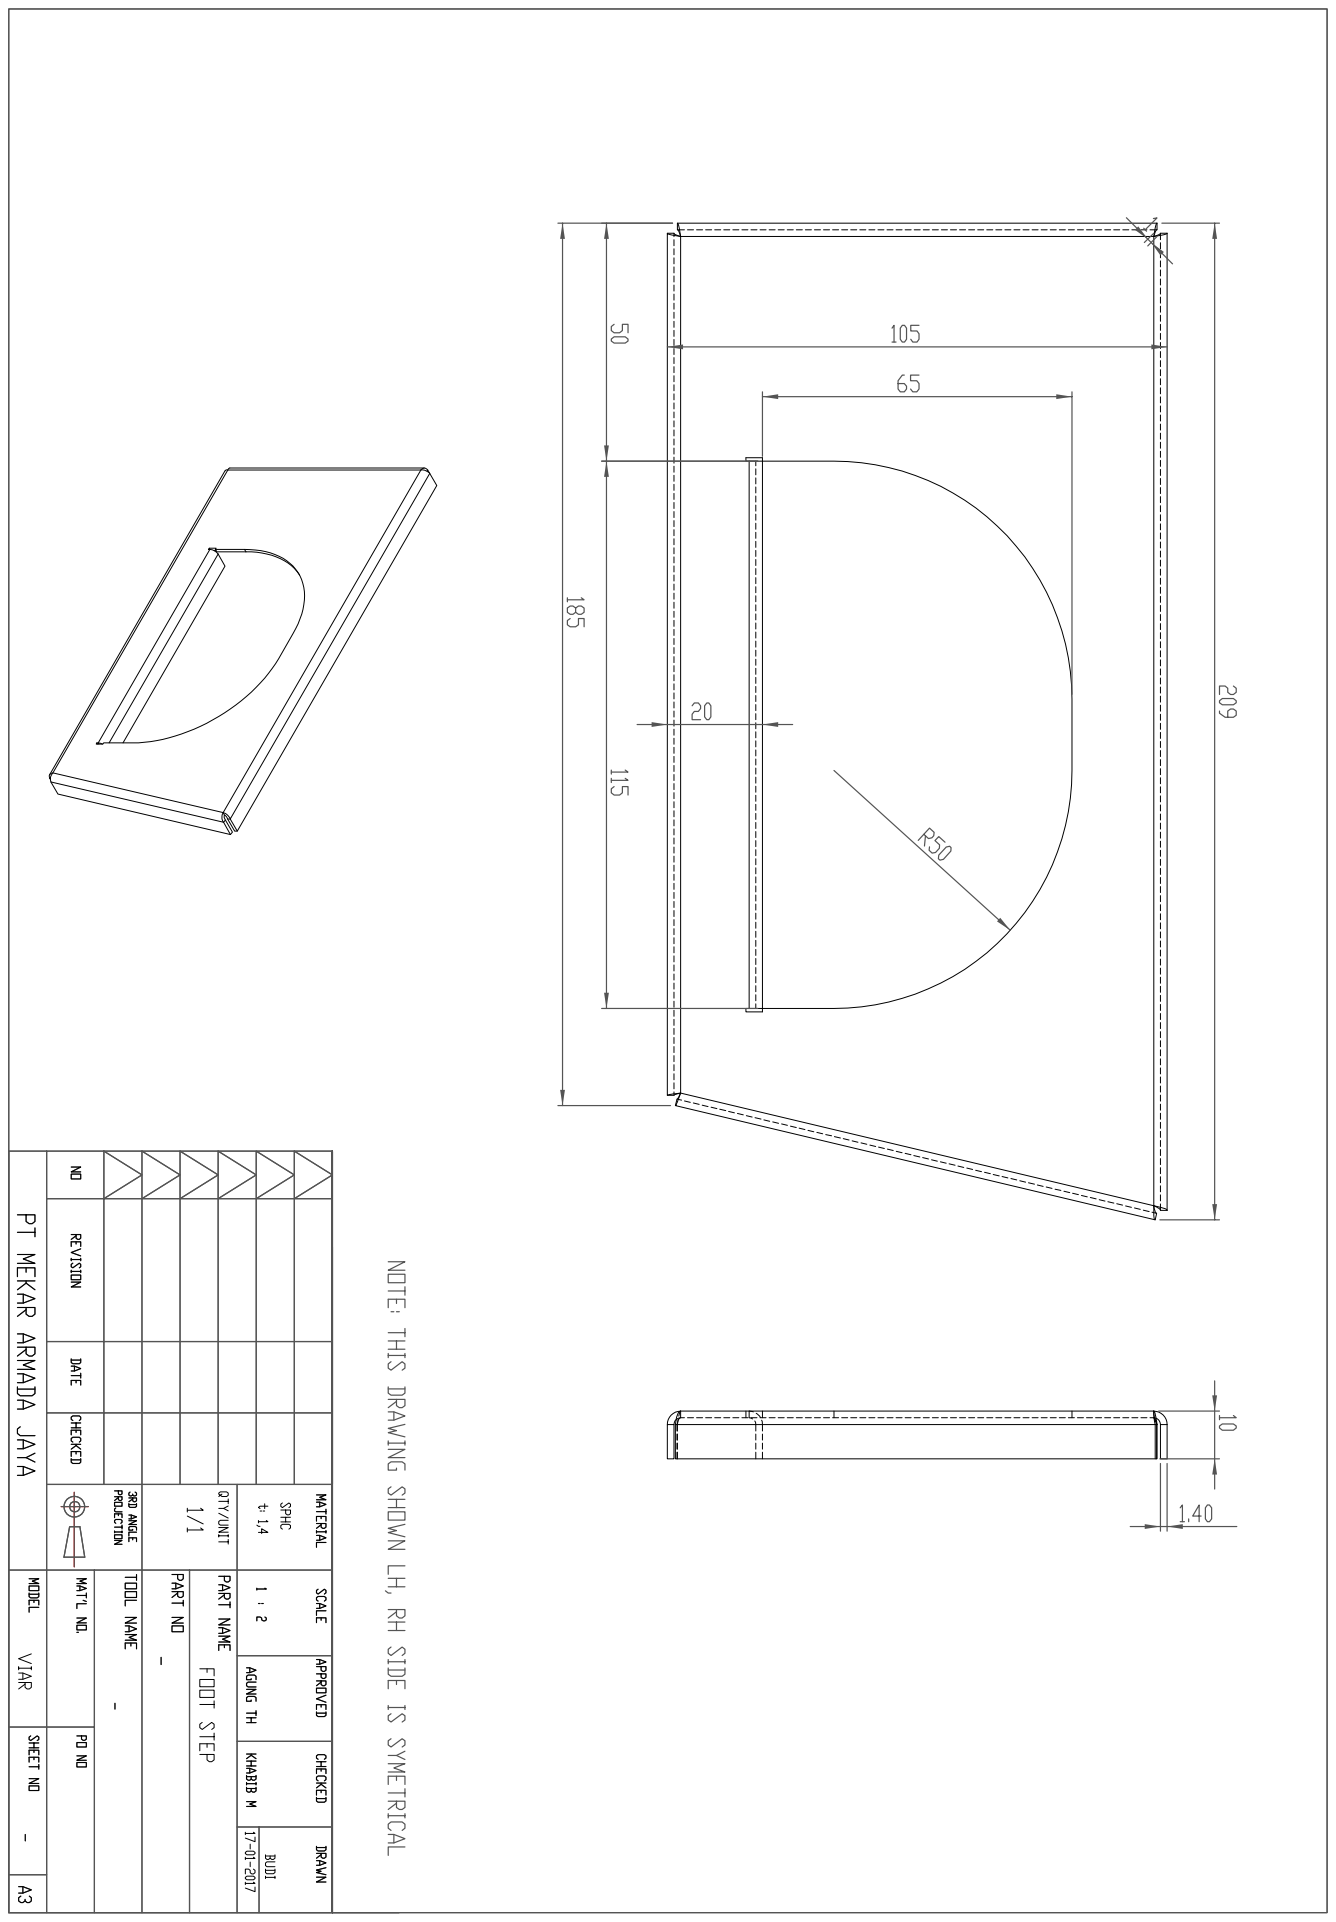
[picture p164: page 1]
