AlfonsusGiovanni/Welding-Arm-Manipulator/2D Design/Box Panel Kontrol/PDF/Drill Hole 1.pdf

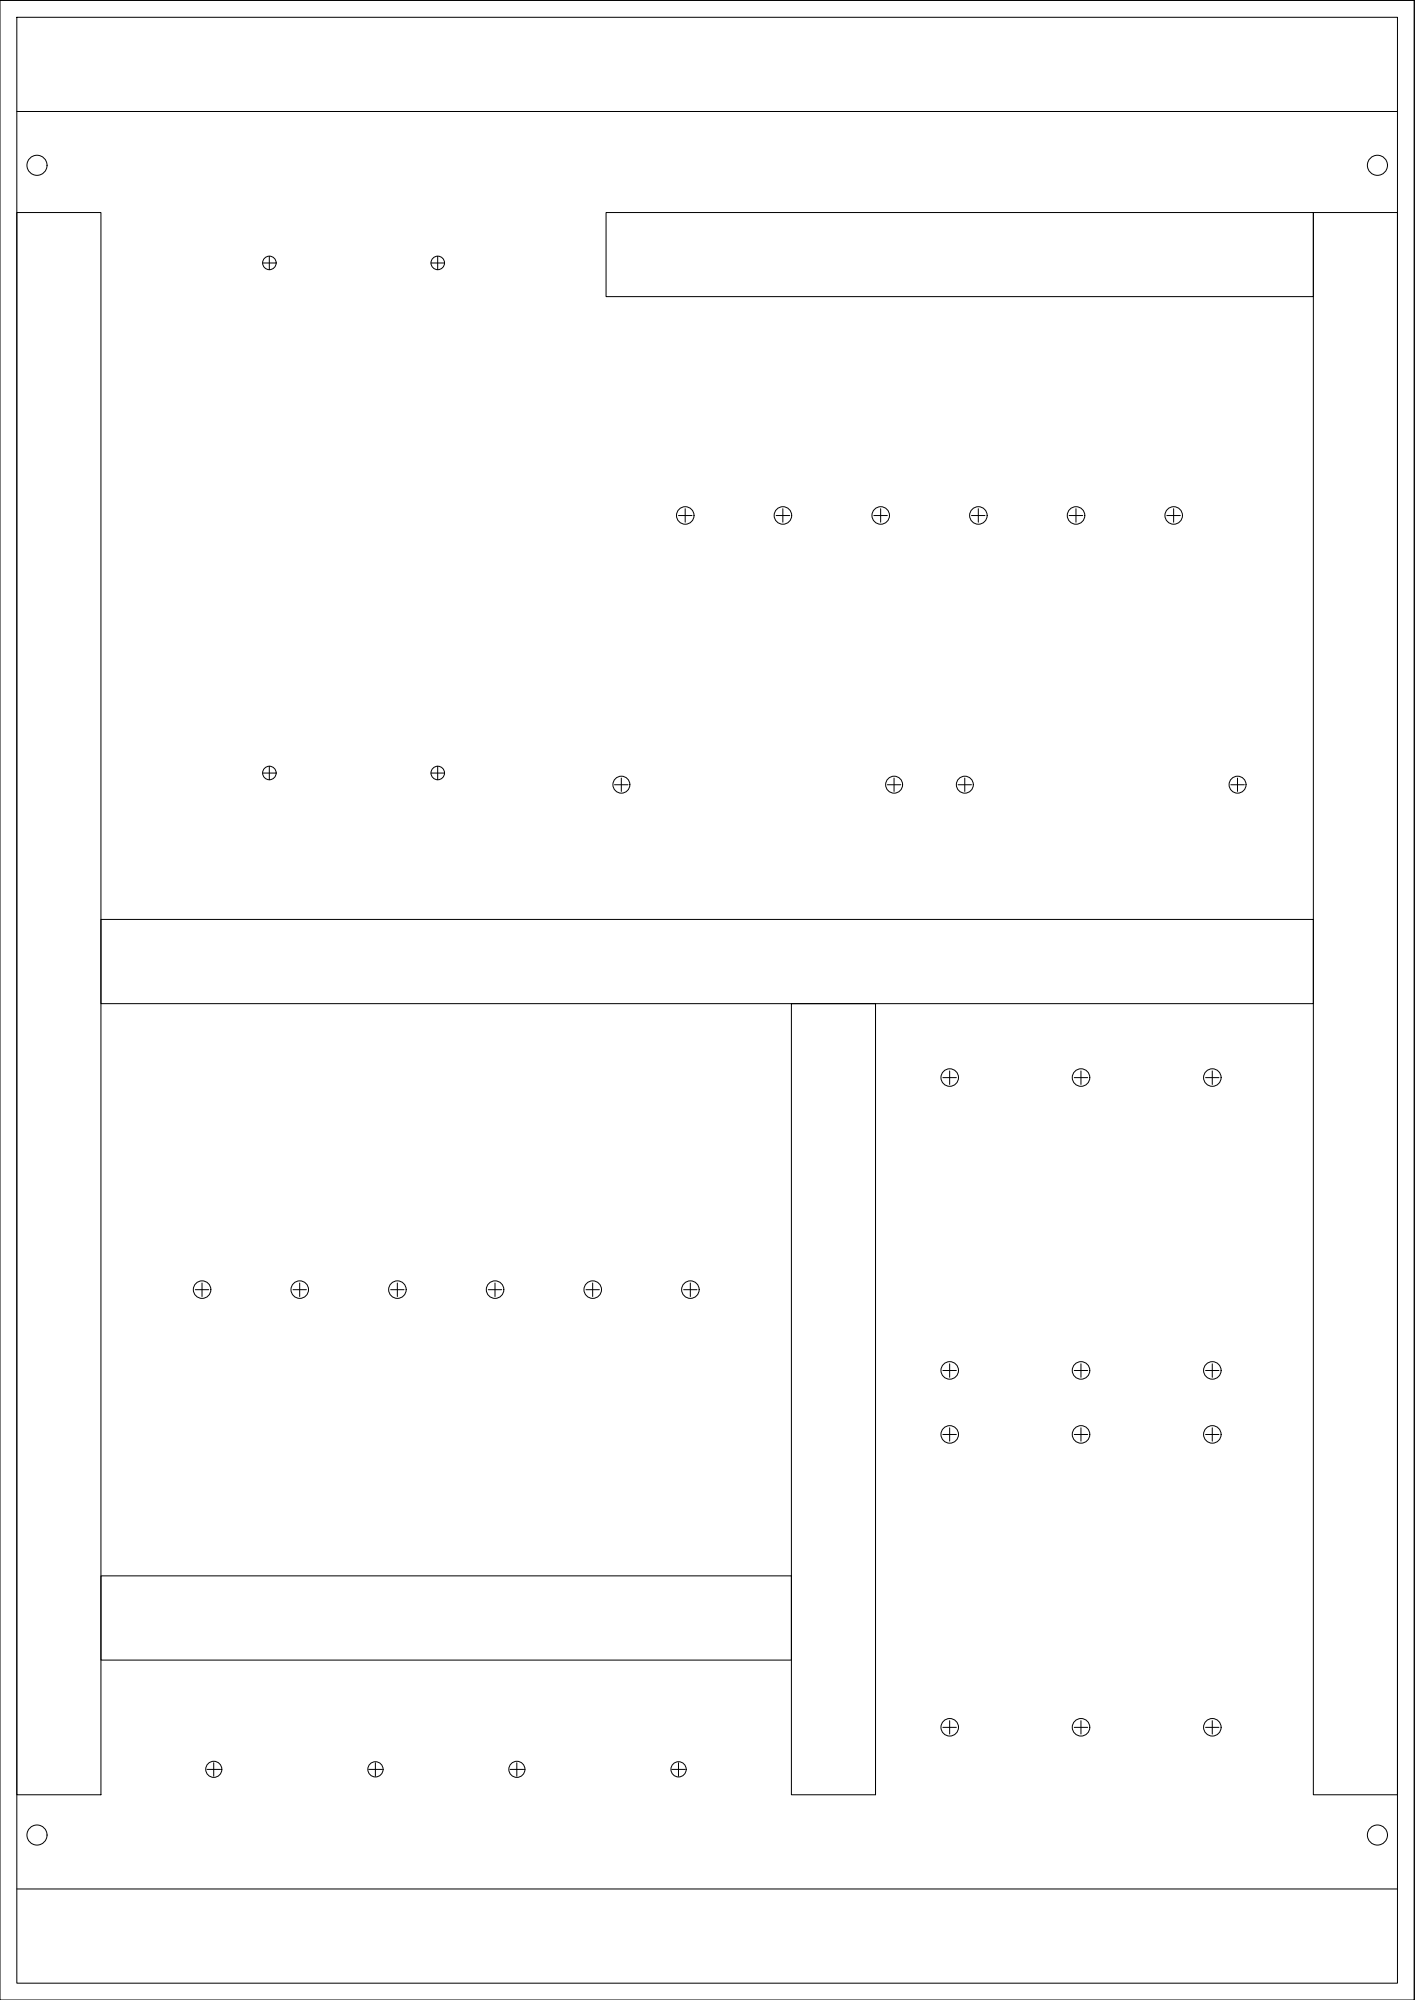
[picture p165: page 1]
