AlfonsusGiovanni/Welding-Arm-Manipulator/2D Design/Box Panel Kontrol/PDF/Drill Hole 2.pdf

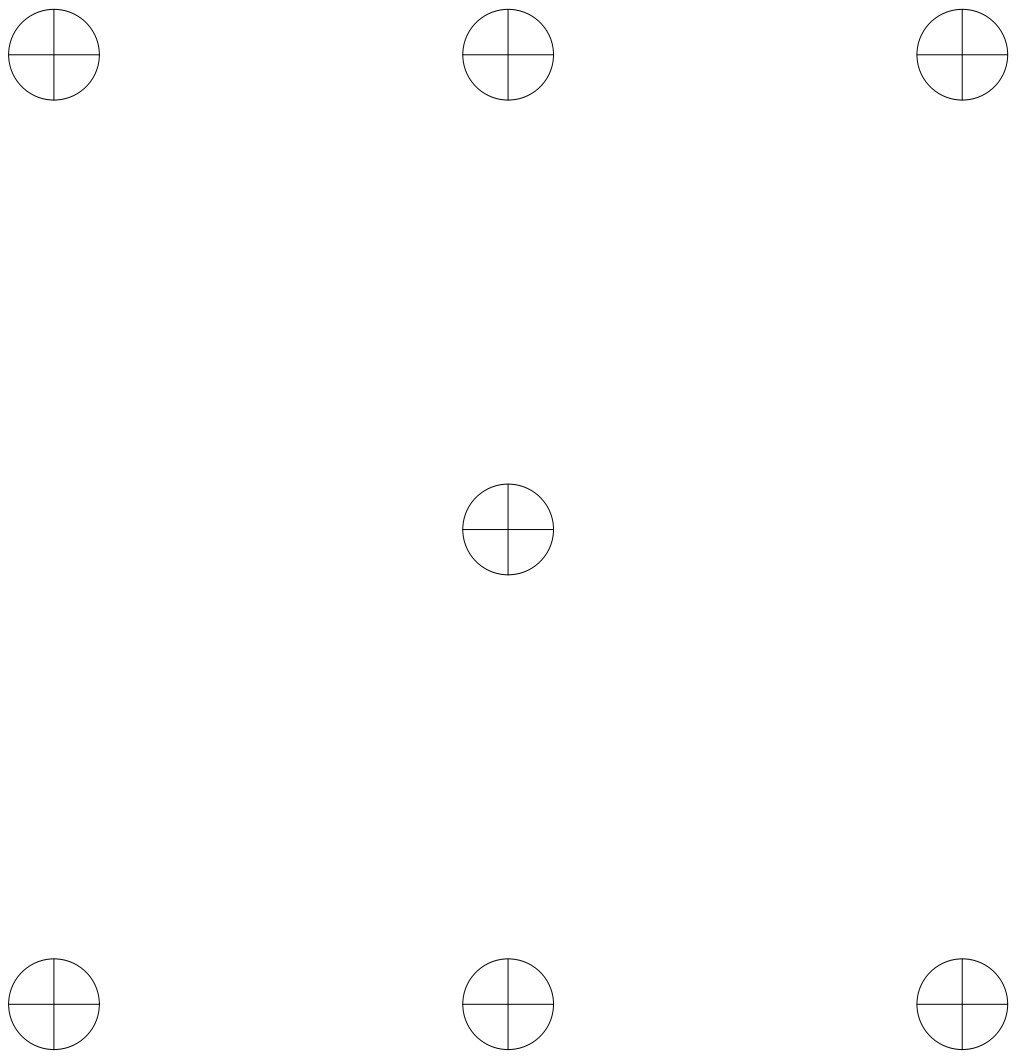
[picture p166: page 1]
