AlfonsusGiovanni/Welding-Arm-Manipulator/Referensi/DRAWING BAK VIAR PDF/3Way Original Model MOdif.pdf

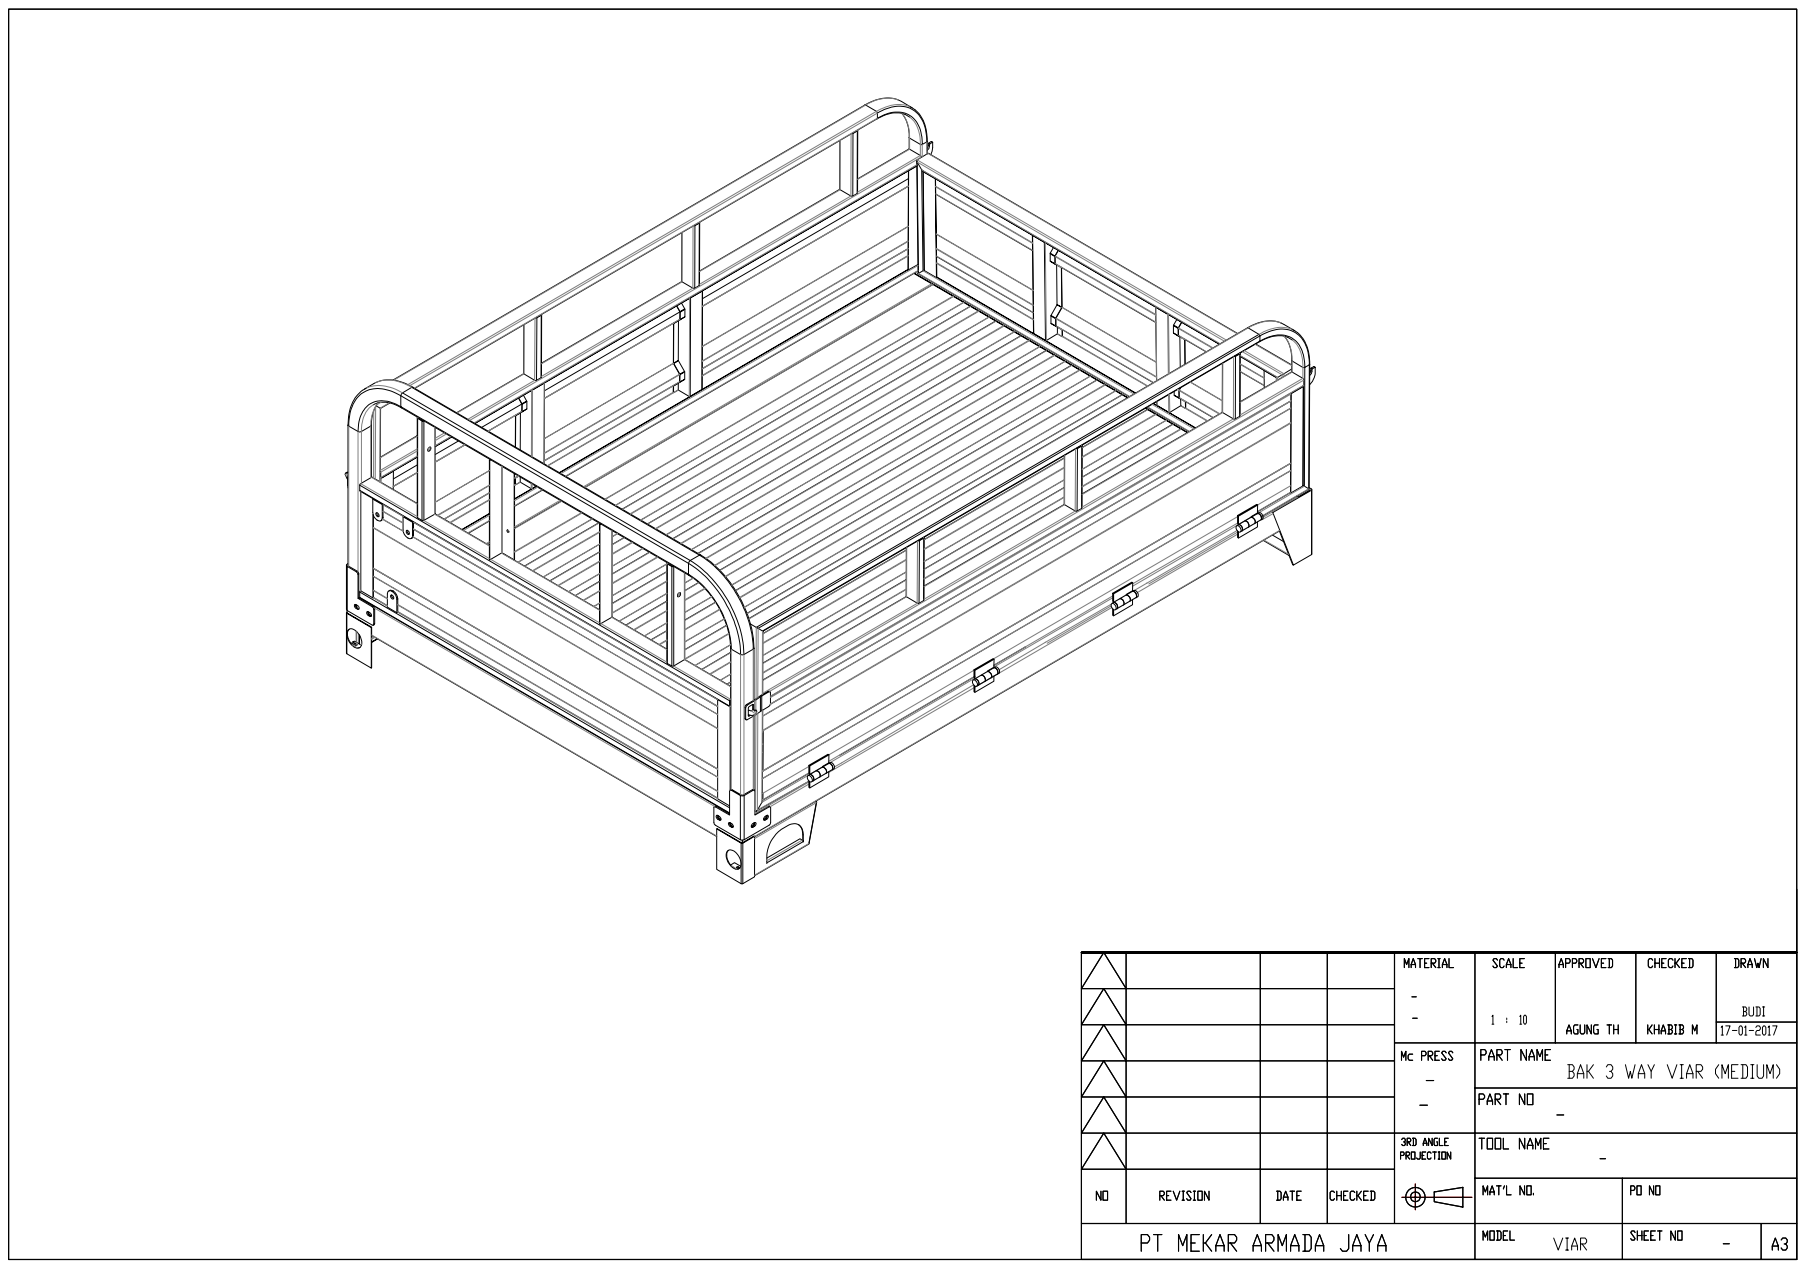
[picture p167: page 1]
