AlfonsusGiovanni/Welding-Arm-Manipulator/Referensi/DRAWING BAK VIAR PDF/Bracket Lampu Belakang.pdf

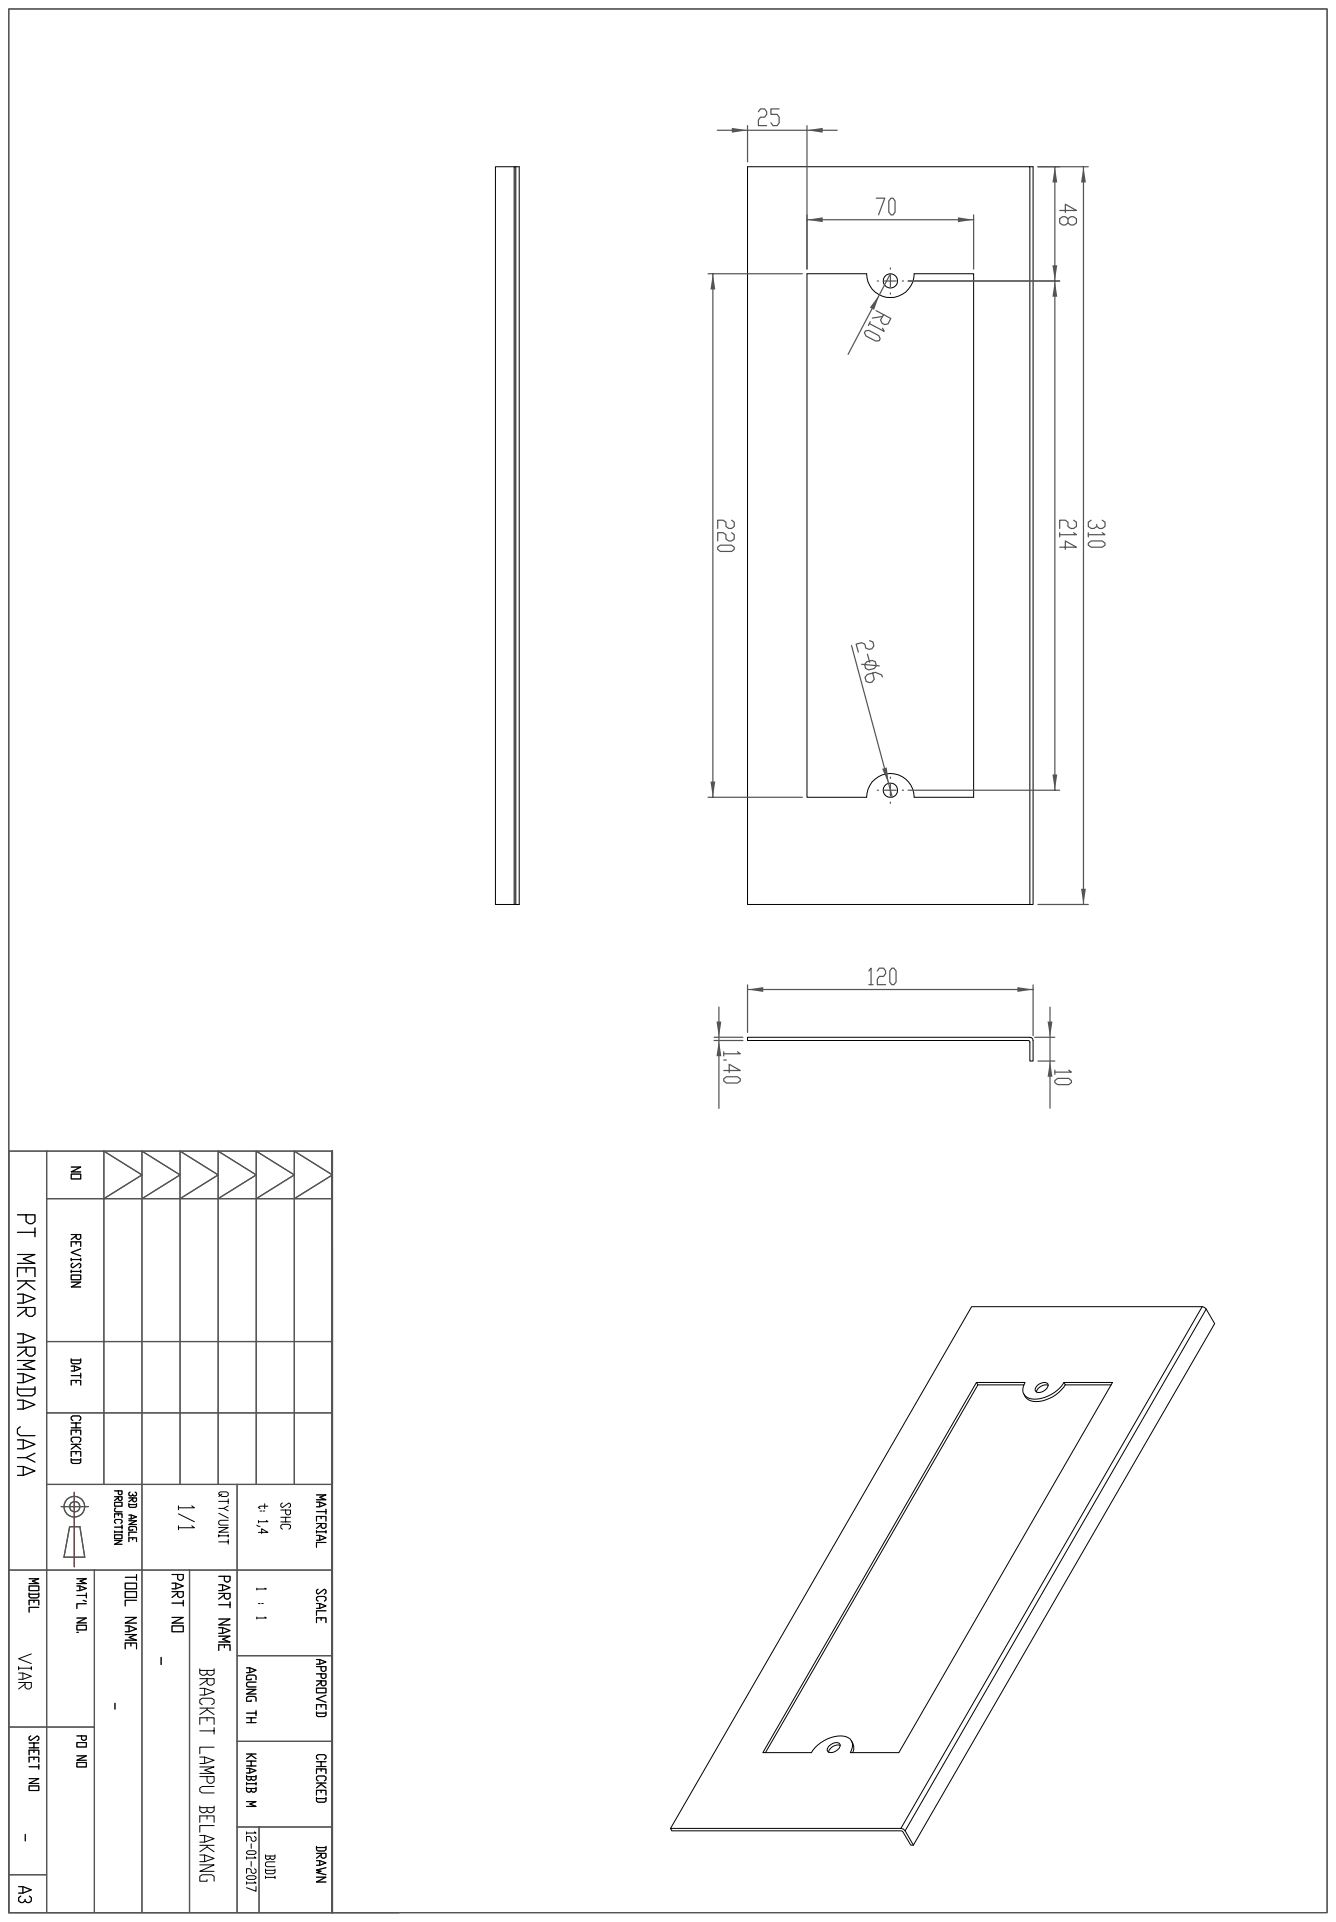
[picture p168: page 1]
