AlfonsusGiovanni/Welding-Arm-Manipulator/Referensi/DRAWING BAK VIAR PDF/bracket lampu depan.pdf

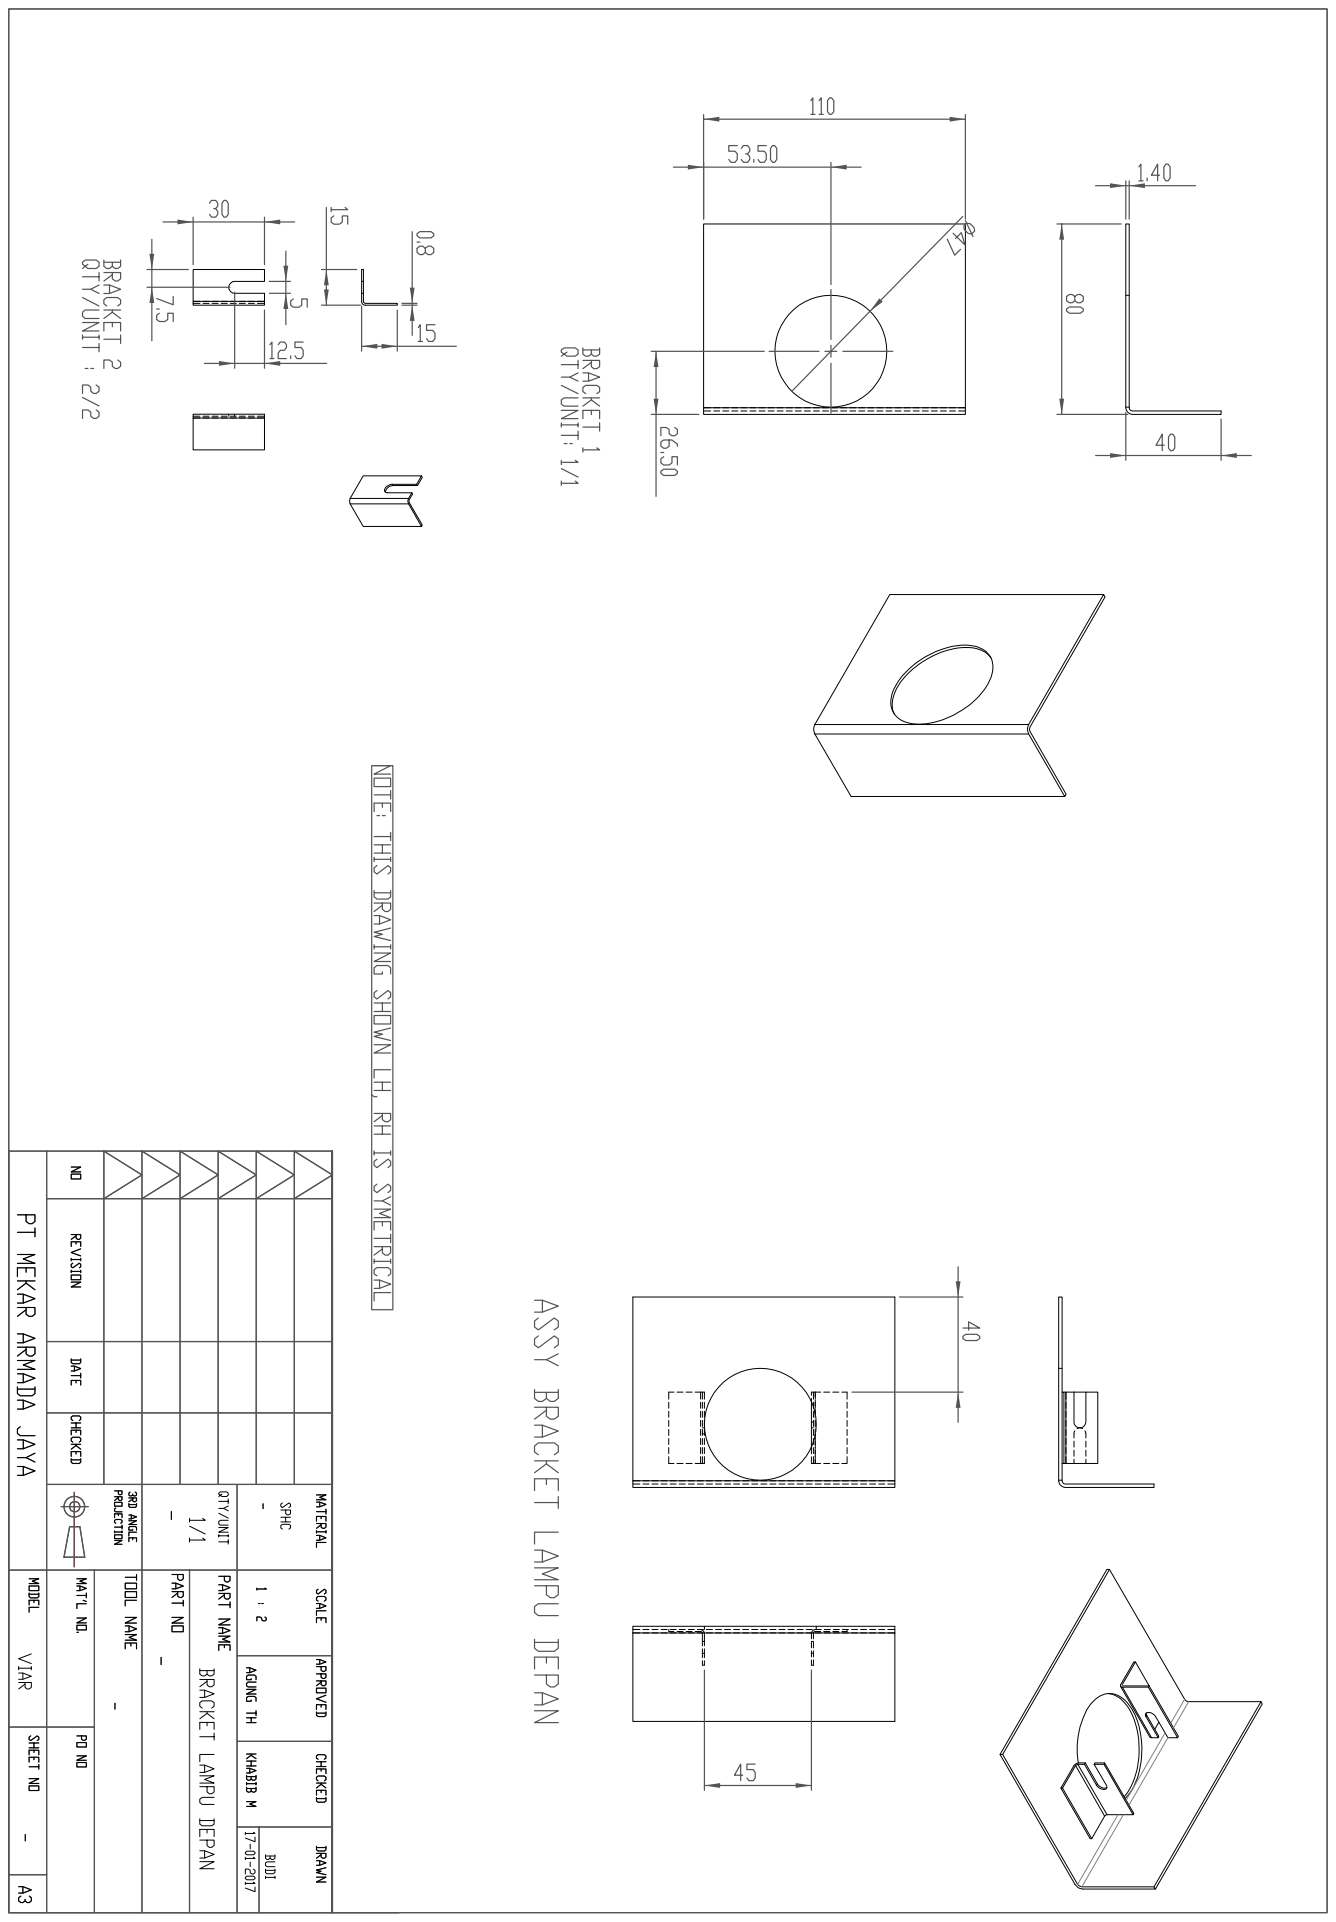
[picture p169: page 1]
