AlfonsusGiovanni/Welding-Arm-Manipulator/Referensi/DRAWING BAK VIAR PDF/Bracket Spakbor 1.pdf

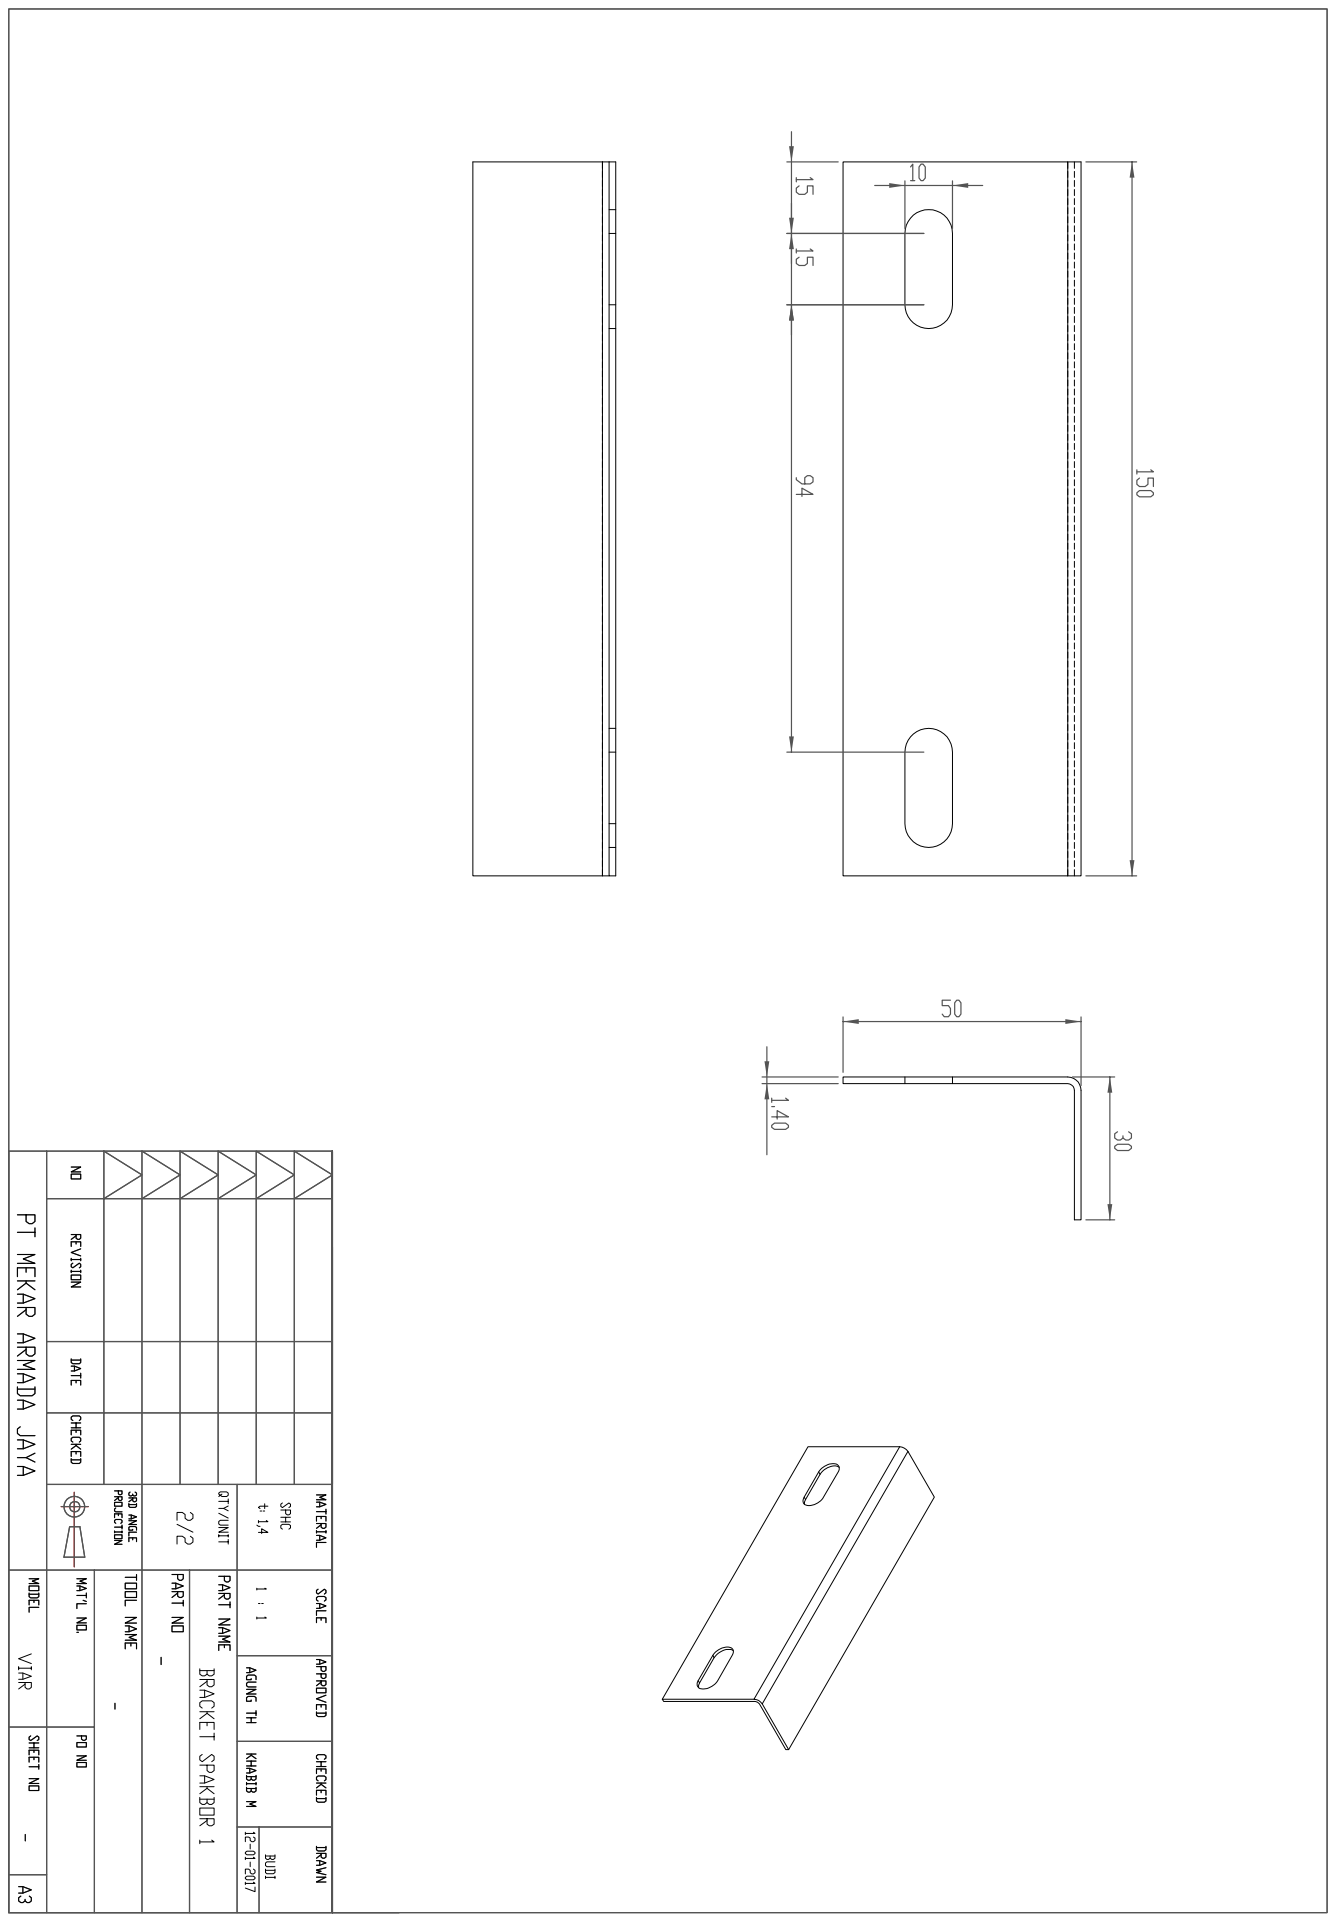
[picture p170: page 1]
