AlfonsusGiovanni/Welding-Arm-Manipulator/Referensi/DRAWING BAK VIAR PDF/Bracket Spakbor 2.pdf

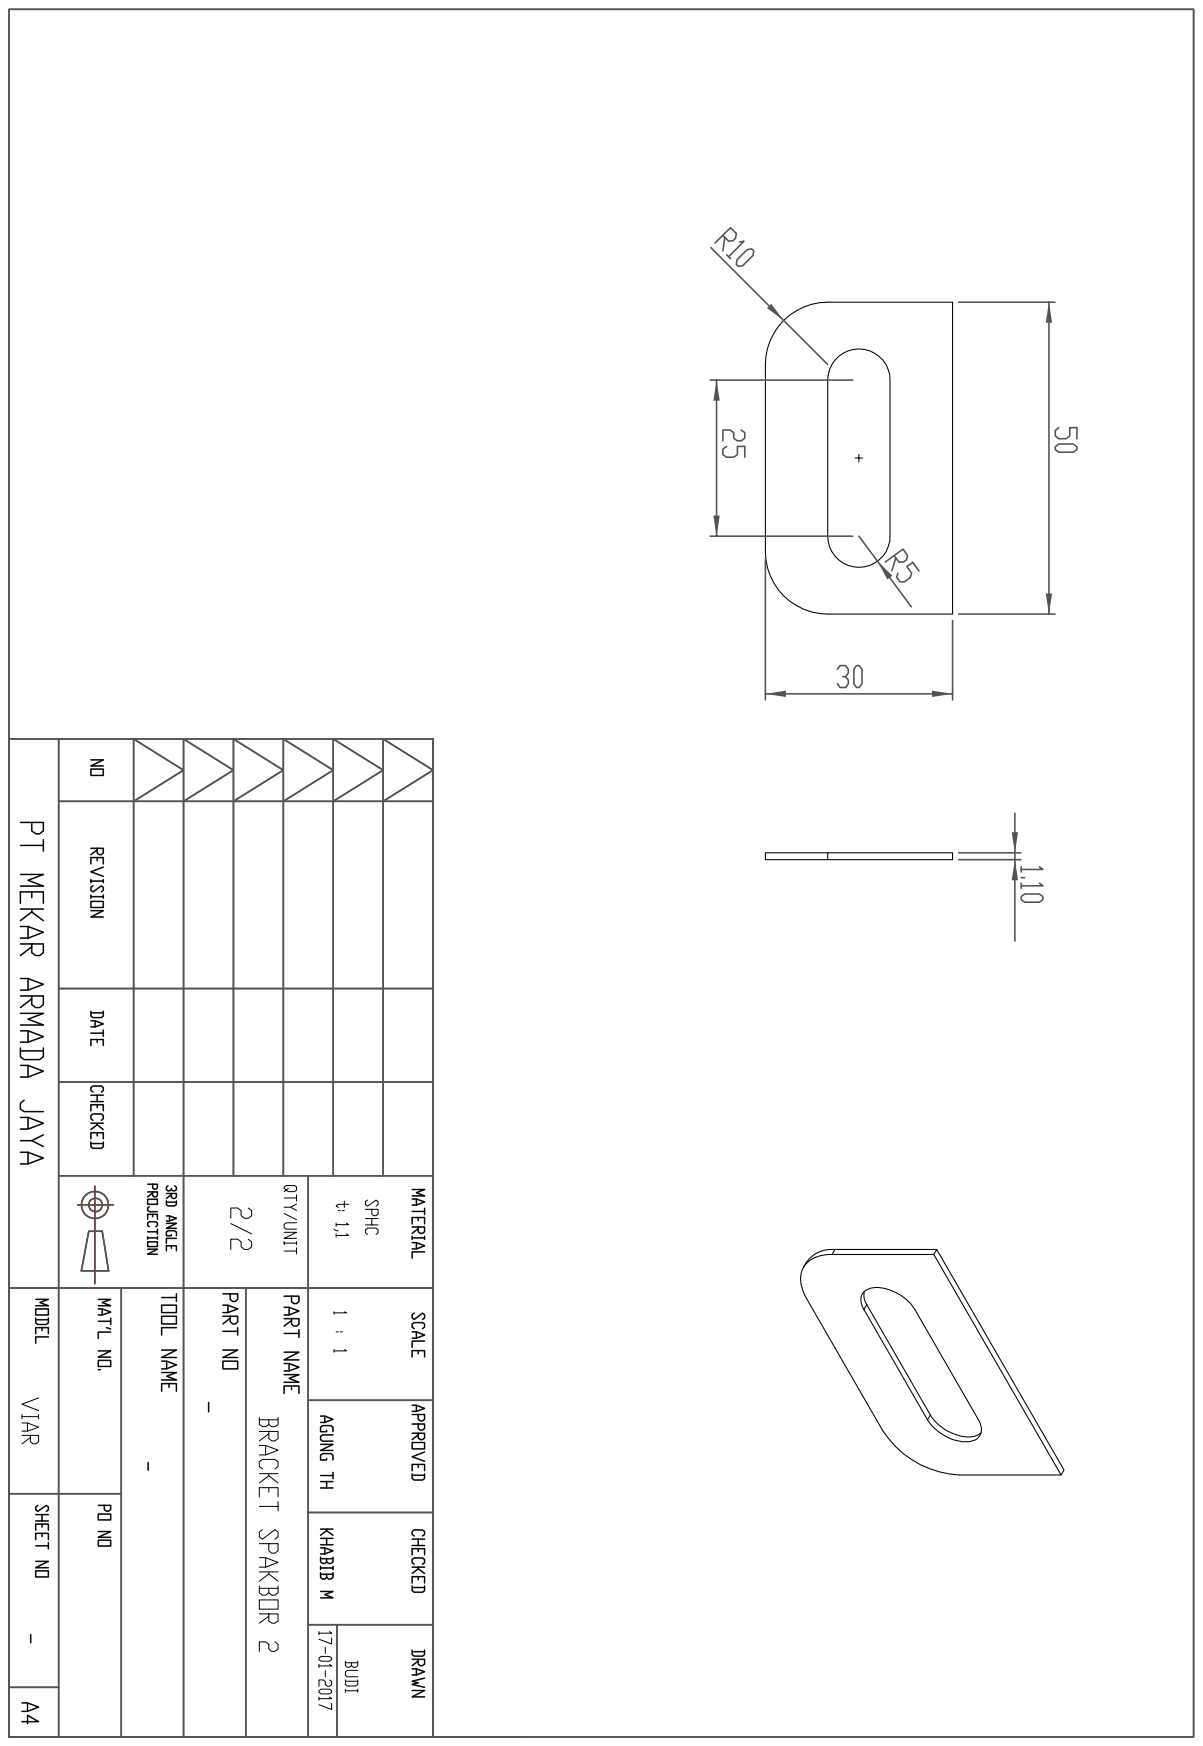
[picture p171: page 1]
