AlfonsusGiovanni/Welding-Arm-Manipulator/Referensi/DRAWING BAK VIAR PDF/Bracket Tempat Duduk Samping.pdf

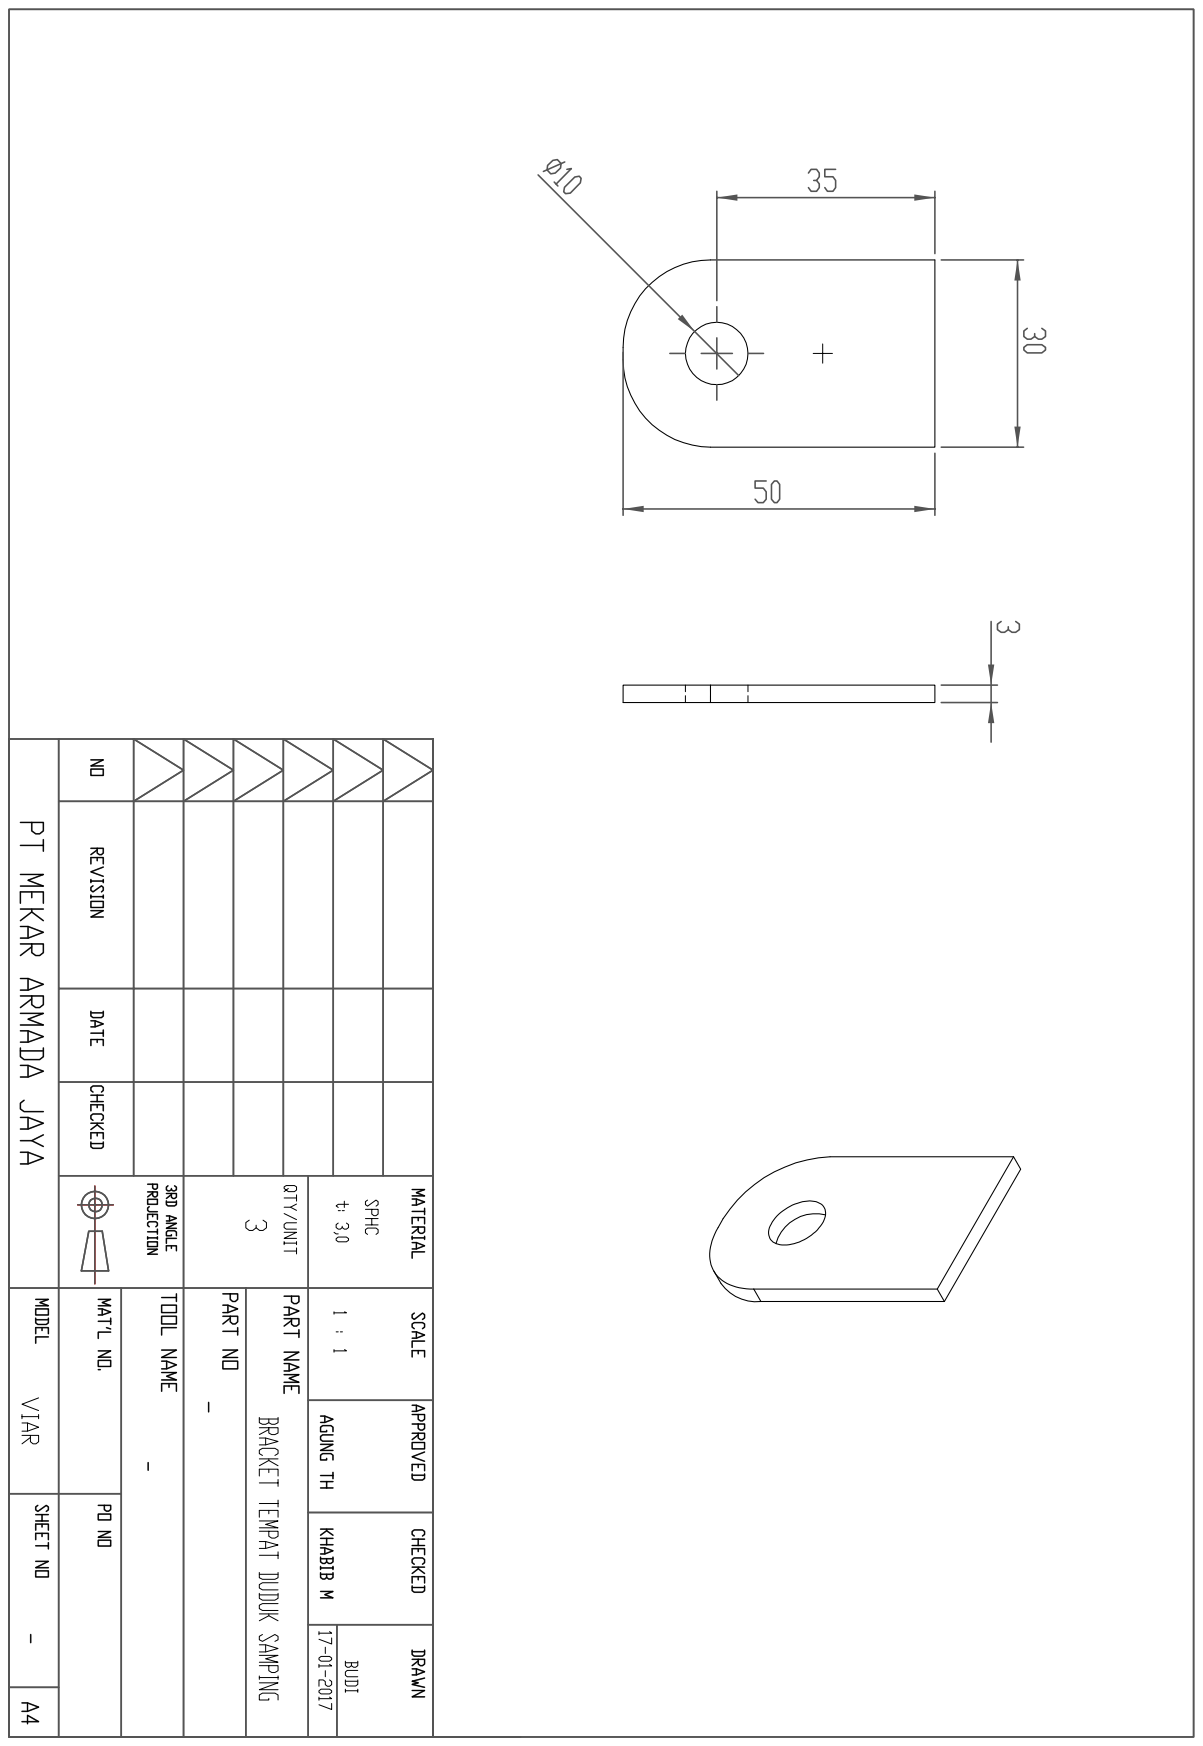
[picture p172: page 1]
