AlfonsusGiovanni/Welding-Arm-Manipulator/Referensi/DRAWING BAK VIAR PDF/detail pemasangan bracket spakbor.pdf

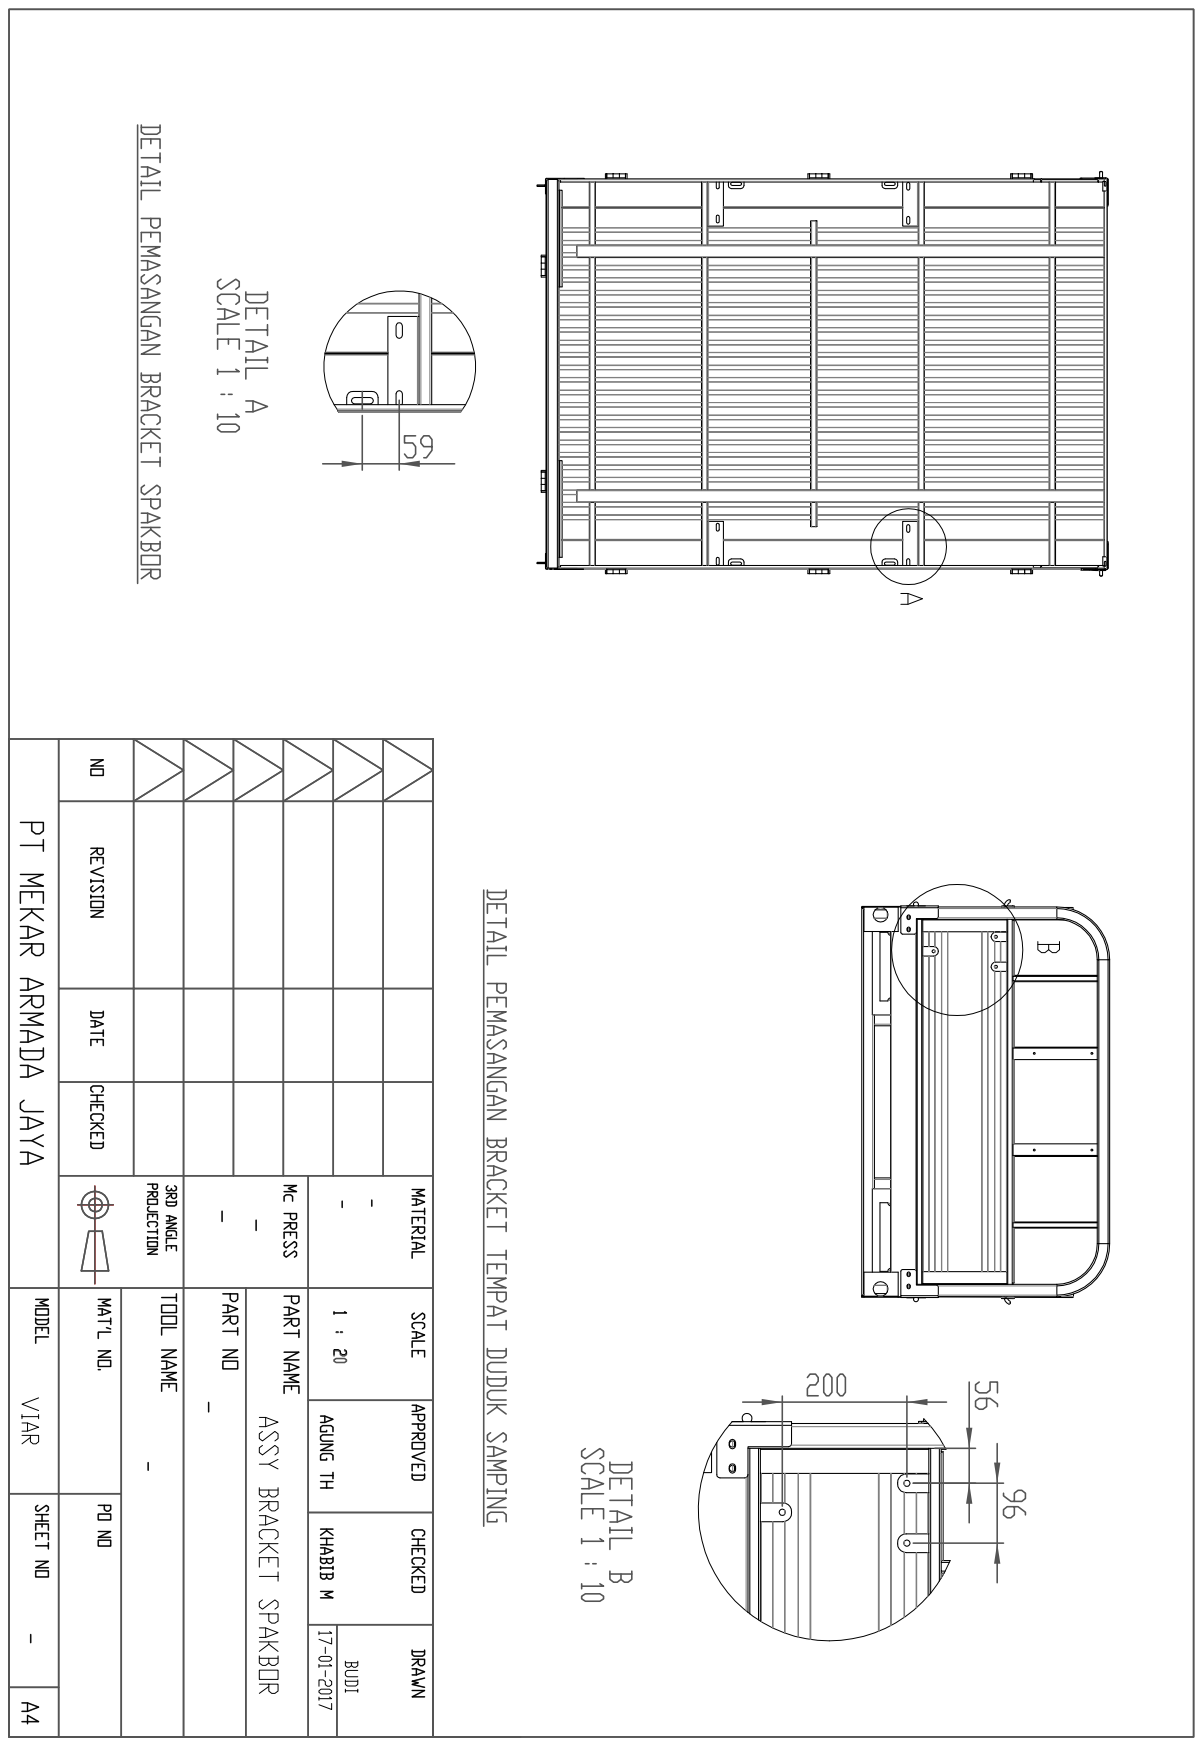
[picture p173: page 1]
