AlfonsusGiovanni/Welding-Arm-Manipulator/Referensi/DRAWING BAK VIAR PDF/Dinding dek belakang.pdf

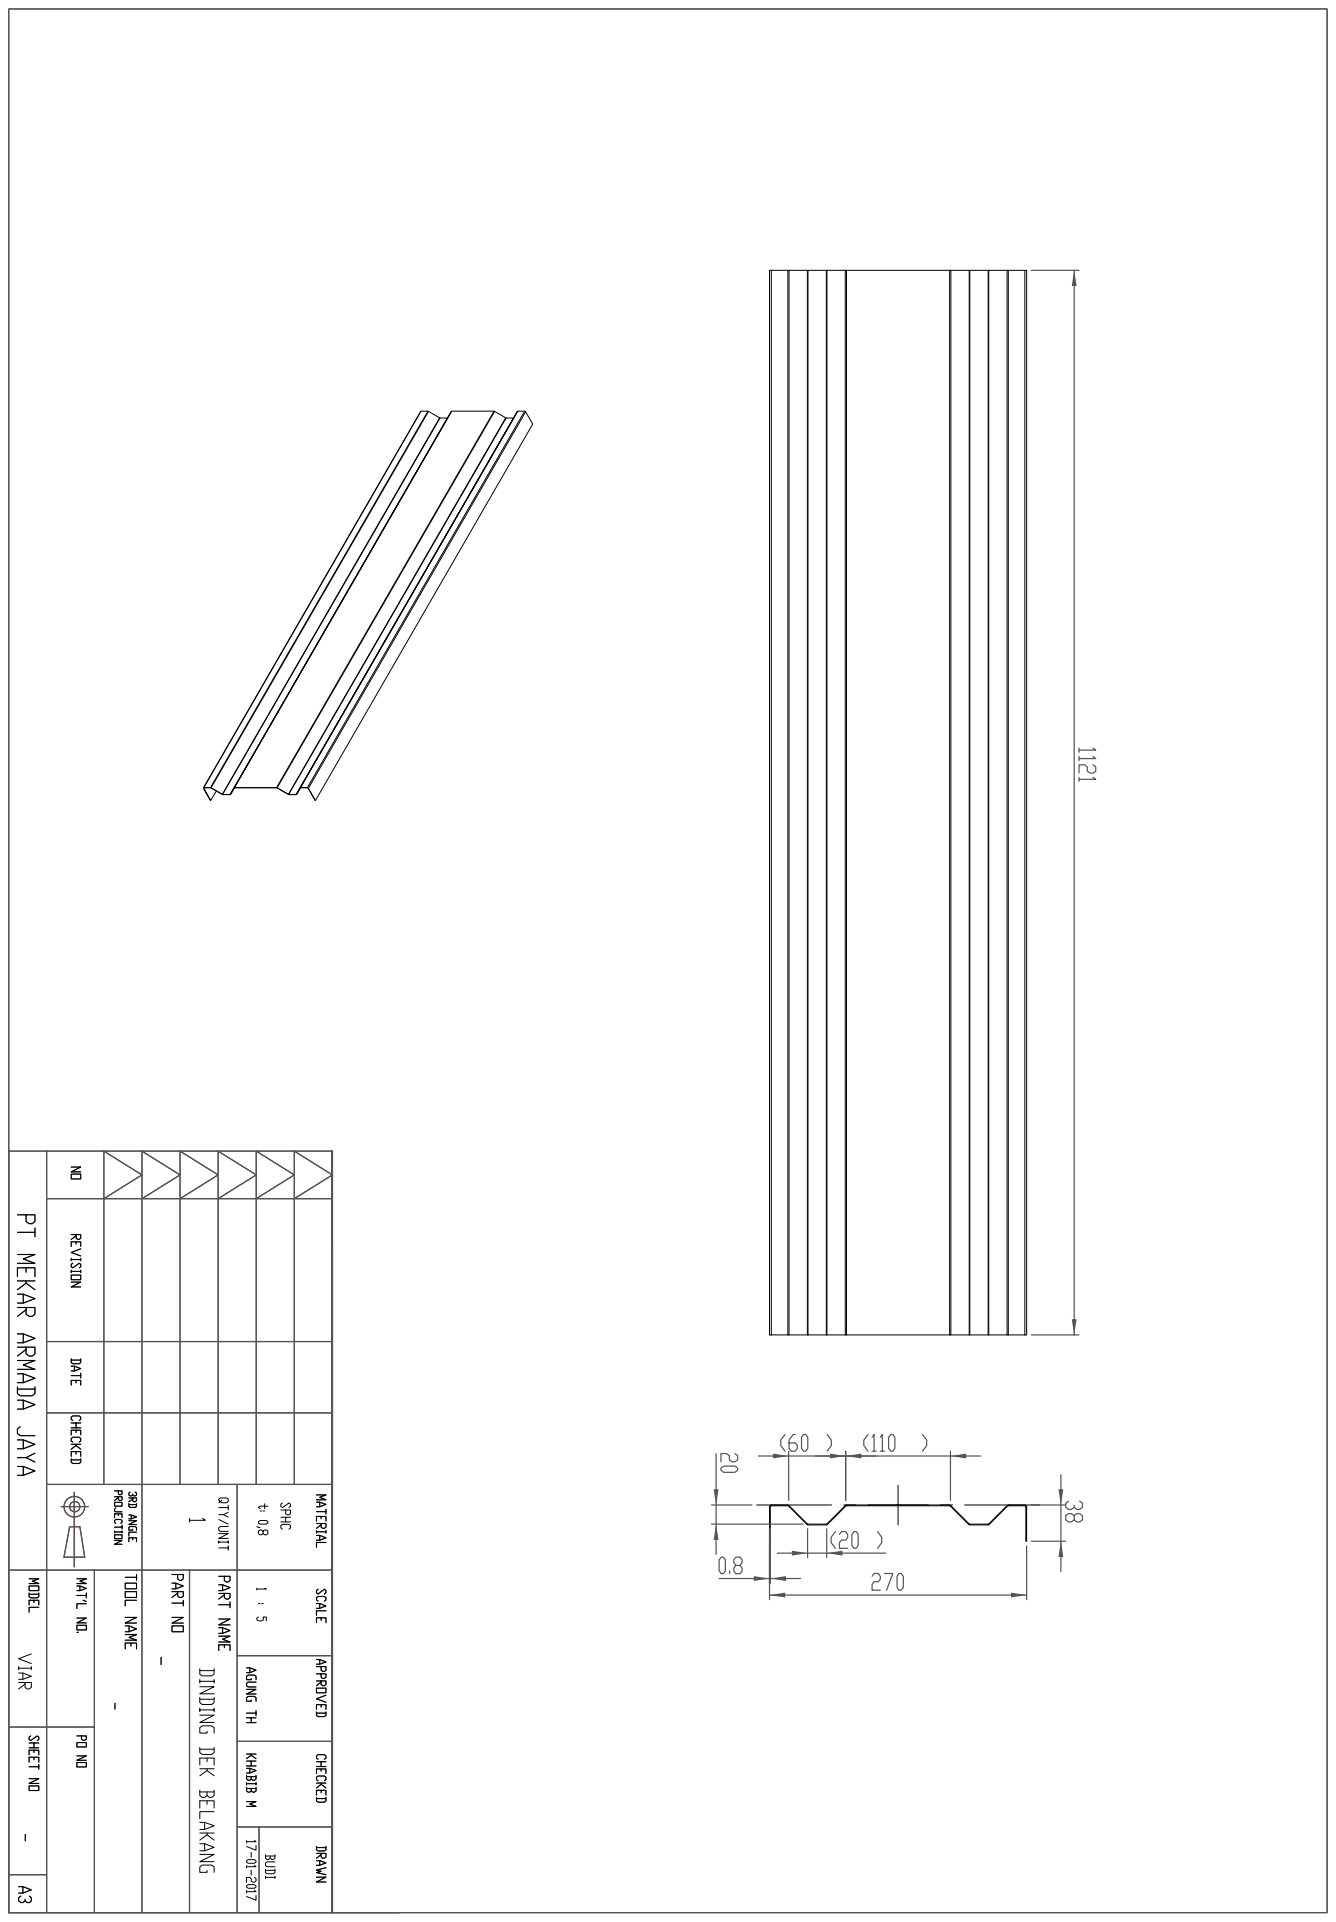
[picture p174: page 1]
