AlfonsusGiovanni/Welding-Arm-Manipulator/Referensi/DRAWING BAK VIAR PDF/Dinding dek depan.pdf

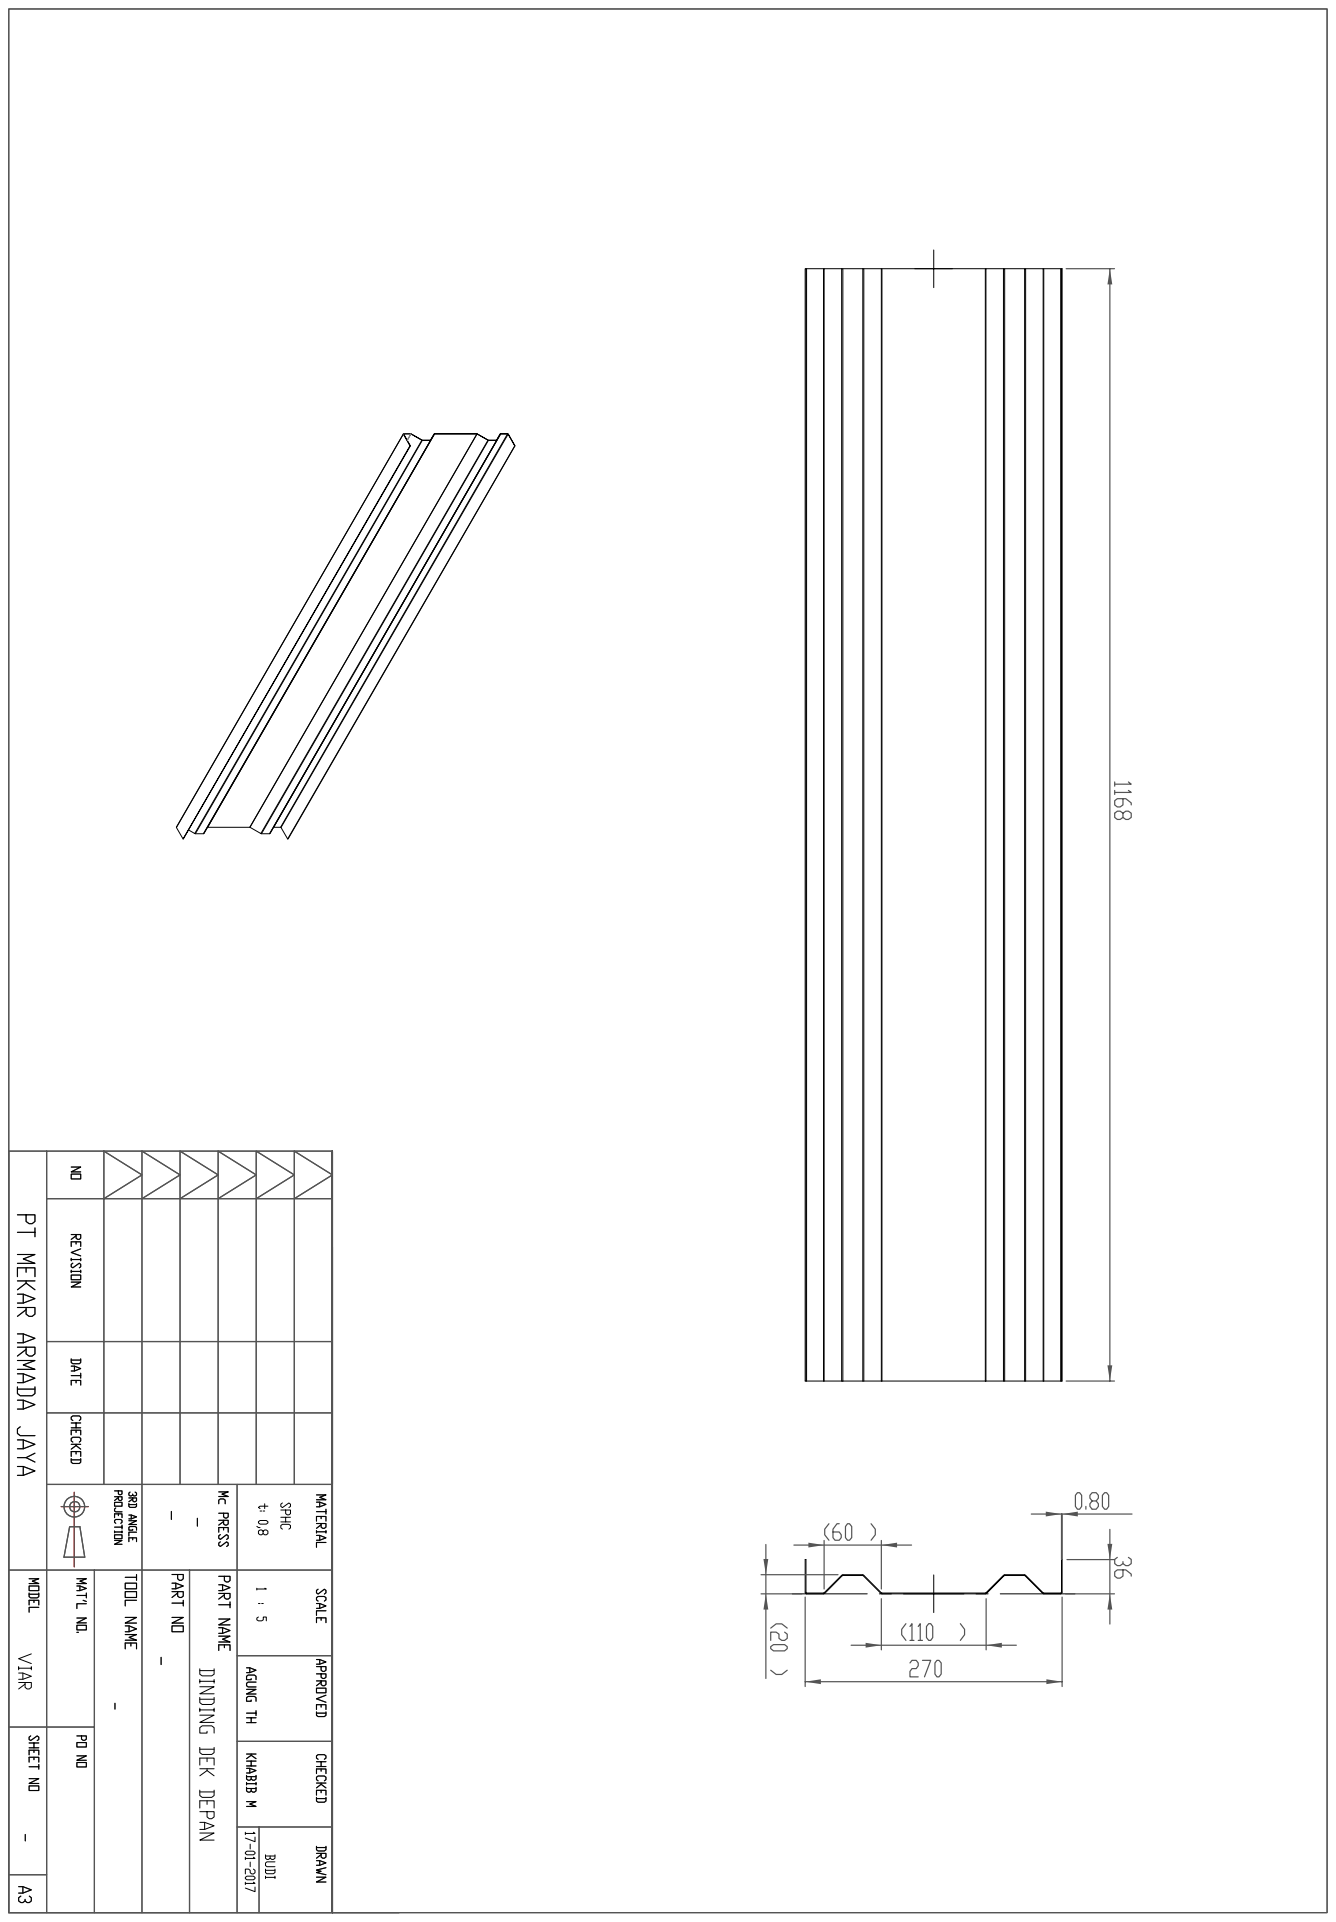
[picture p175: page 1]
