AlfonsusGiovanni/Welding-Arm-Manipulator/Referensi/DRAWING BAK VIAR PDF/Dinding dek samping RL.pdf

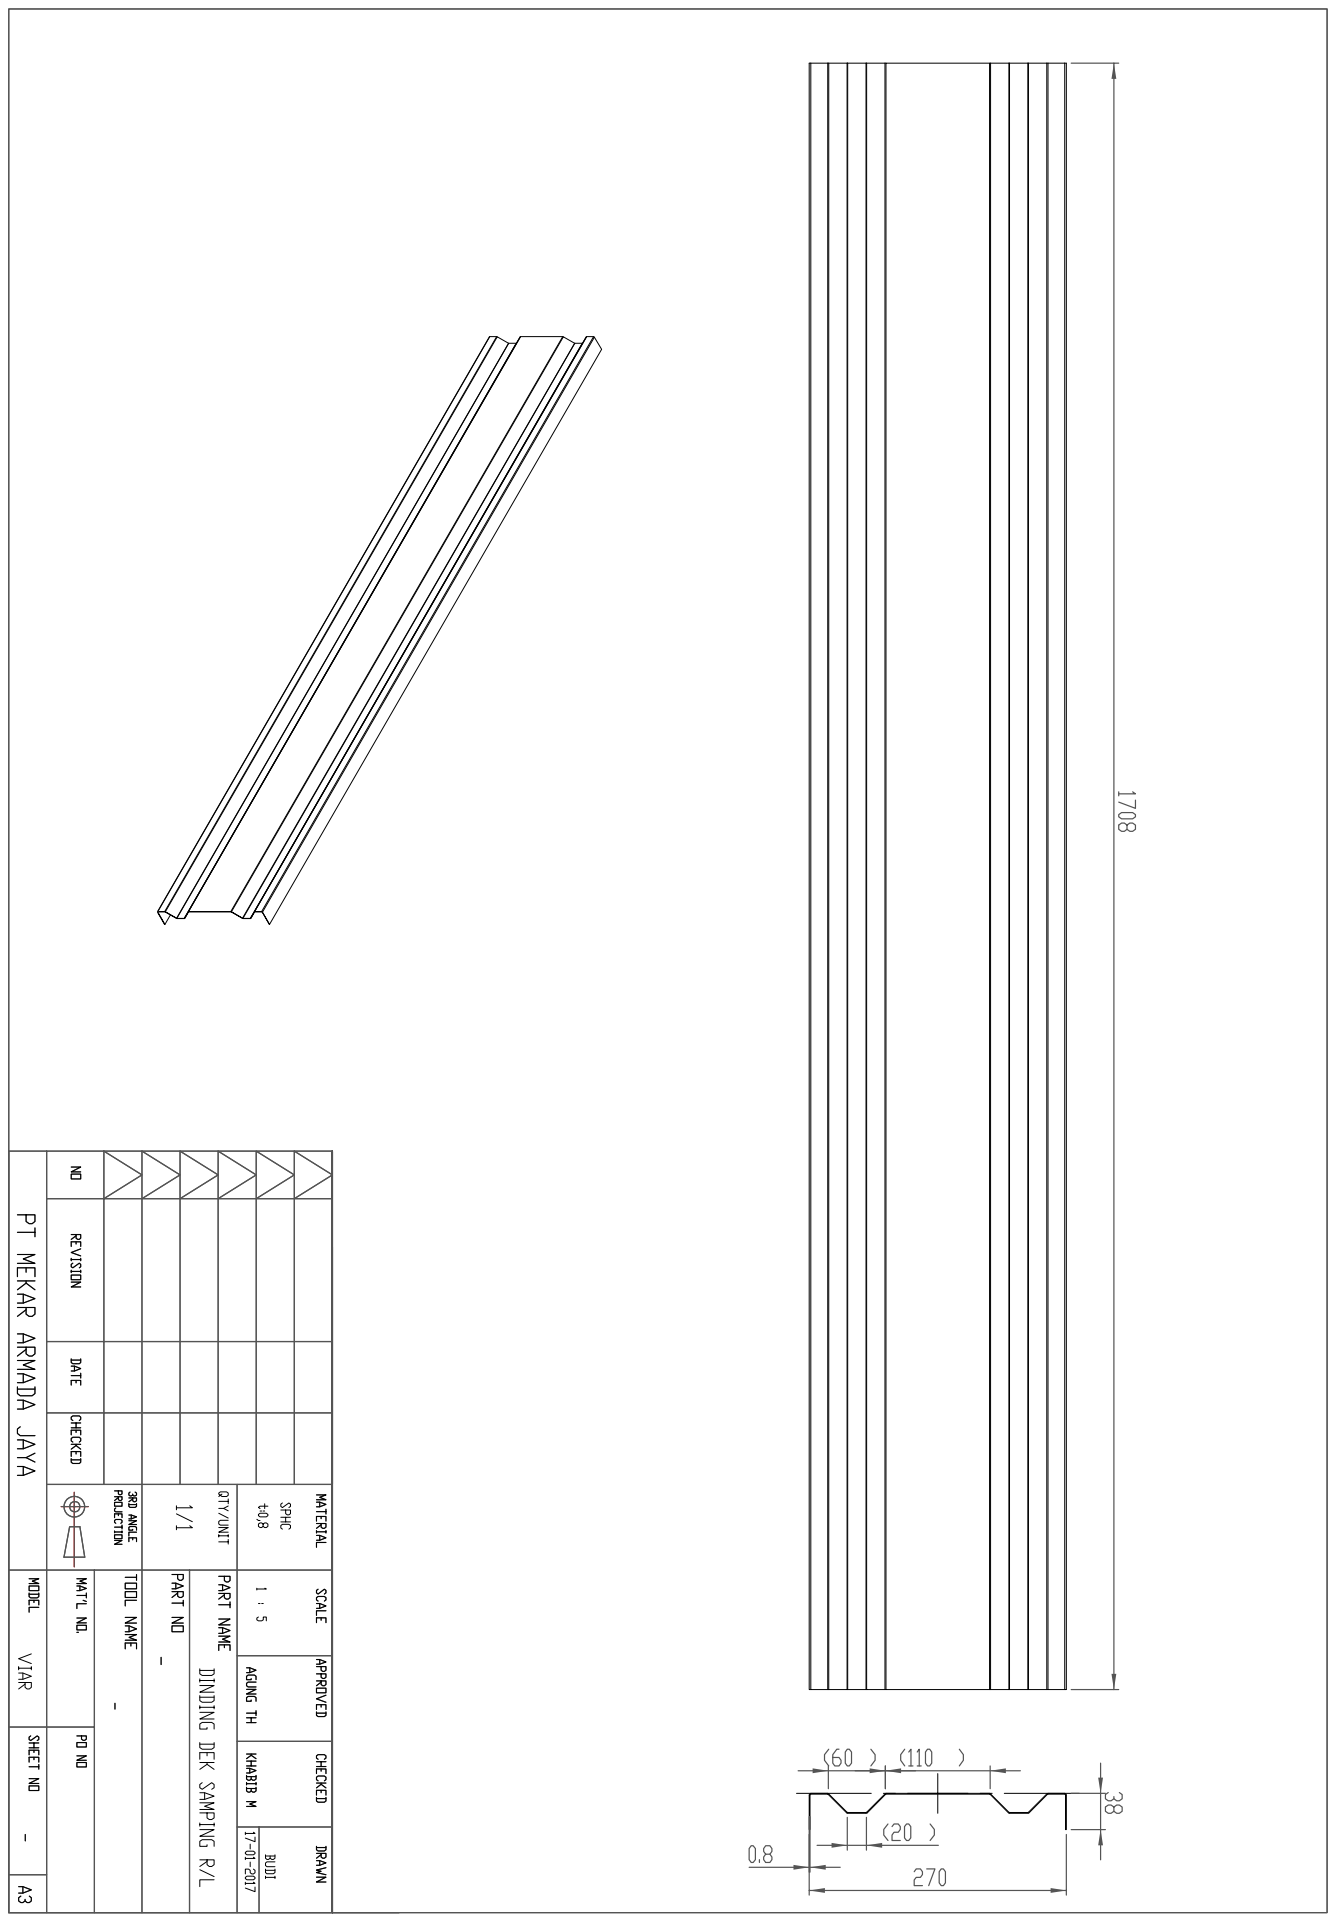
[picture p176: page 1]
