AlfonsusGiovanni/Welding-Arm-Manipulator/Referensi/DRAWING BAK VIAR PDF/List Belakang.pdf

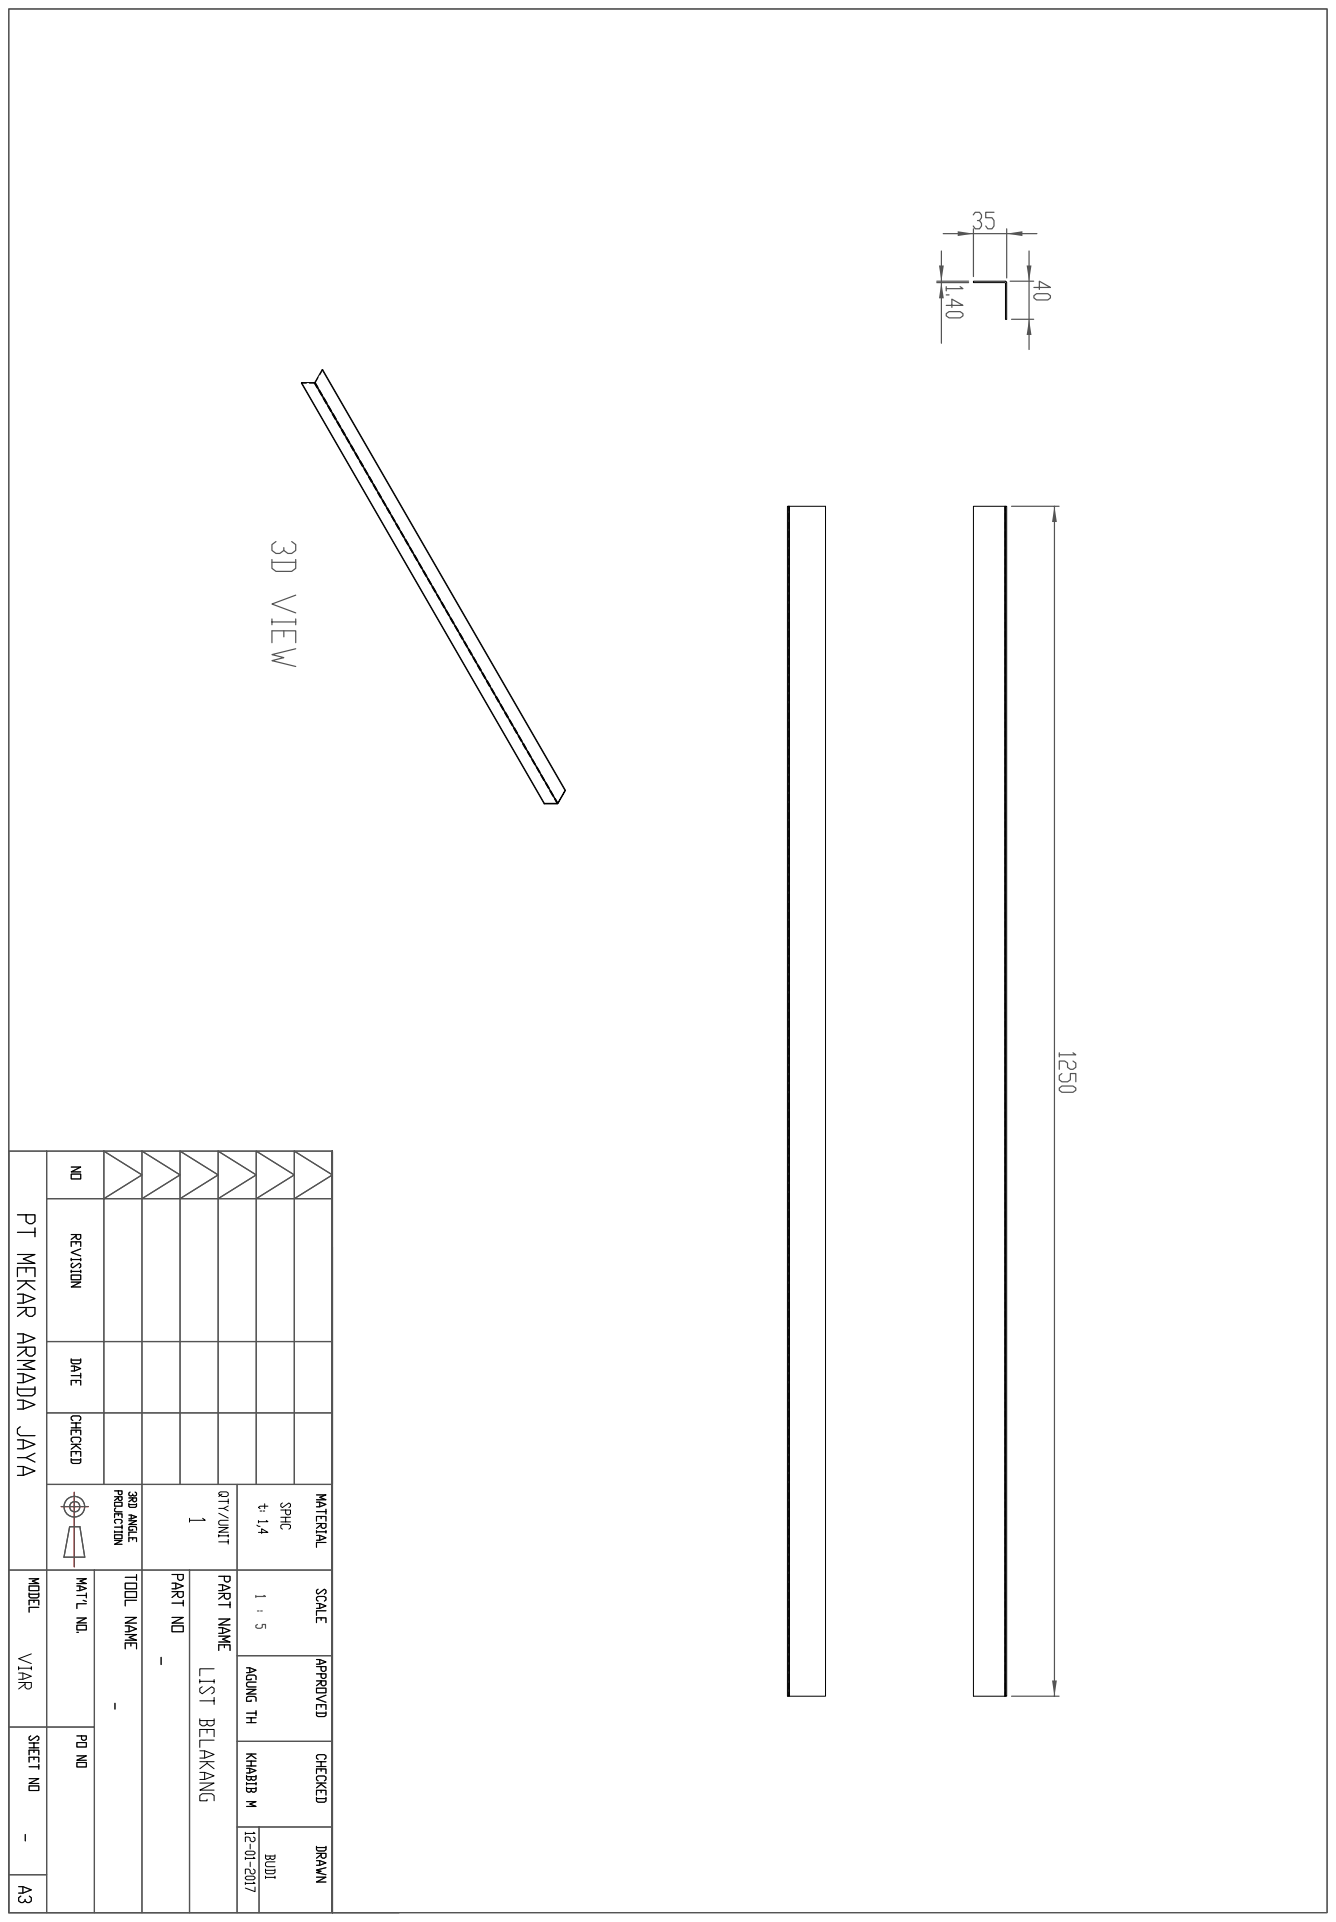
[picture p177: page 1]
