AlfonsusGiovanni/Welding-Arm-Manipulator/Referensi/DRAWING BAK VIAR PDF/List Depan.pdf

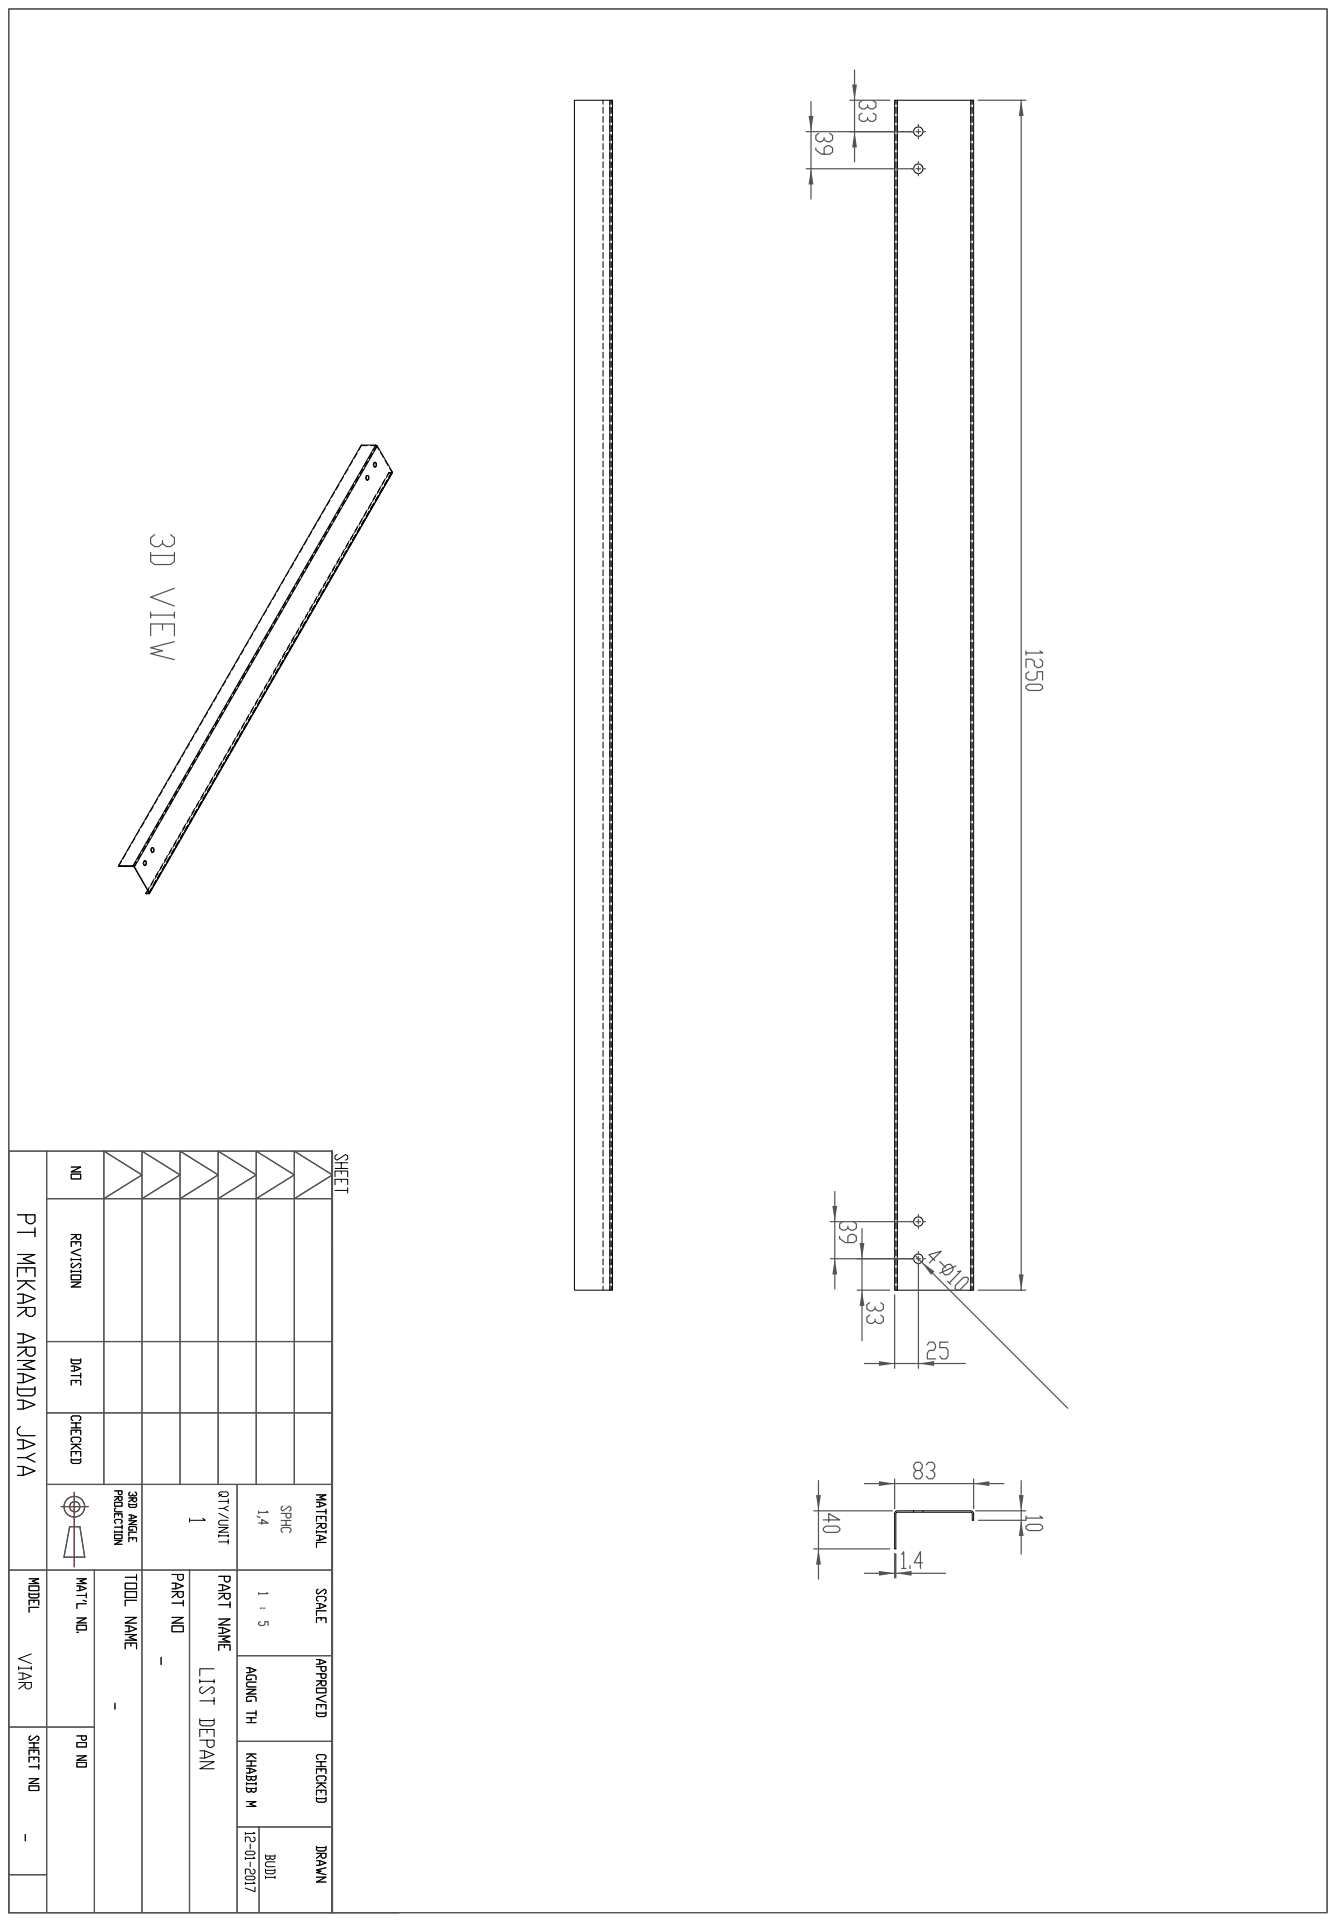
[picture p178: page 1]
