AlfonsusGiovanni/Welding-Arm-Manipulator/Referensi/DRAWING BAK VIAR PDF/List Samping.pdf

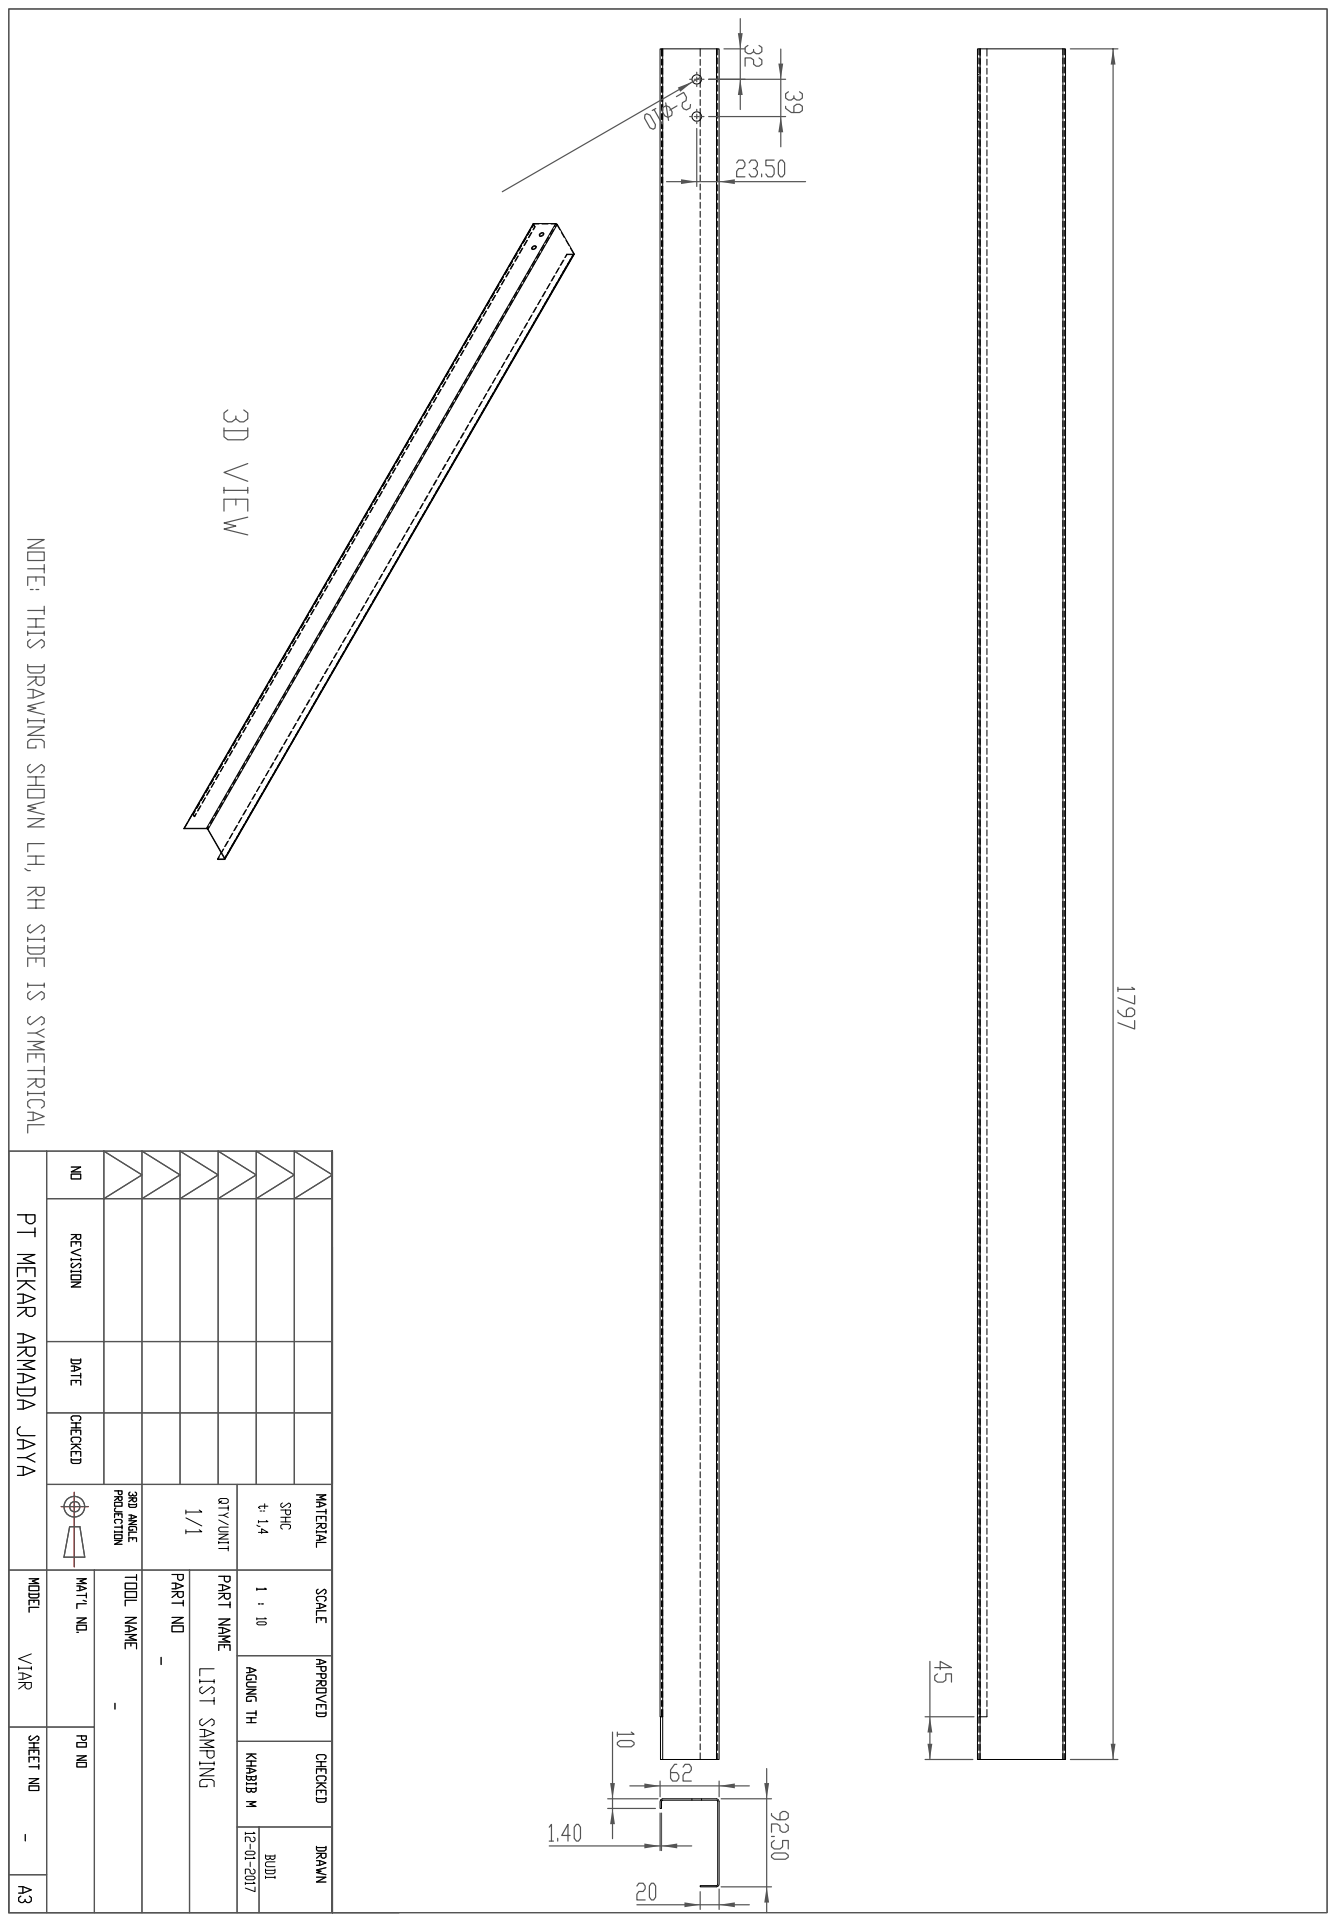
[picture p179: page 1]
