AlfonsusGiovanni/Welding-Arm-Manipulator/Referensi/DRAWING BAK VIAR PDF/Plat Lantai Modif.pdf

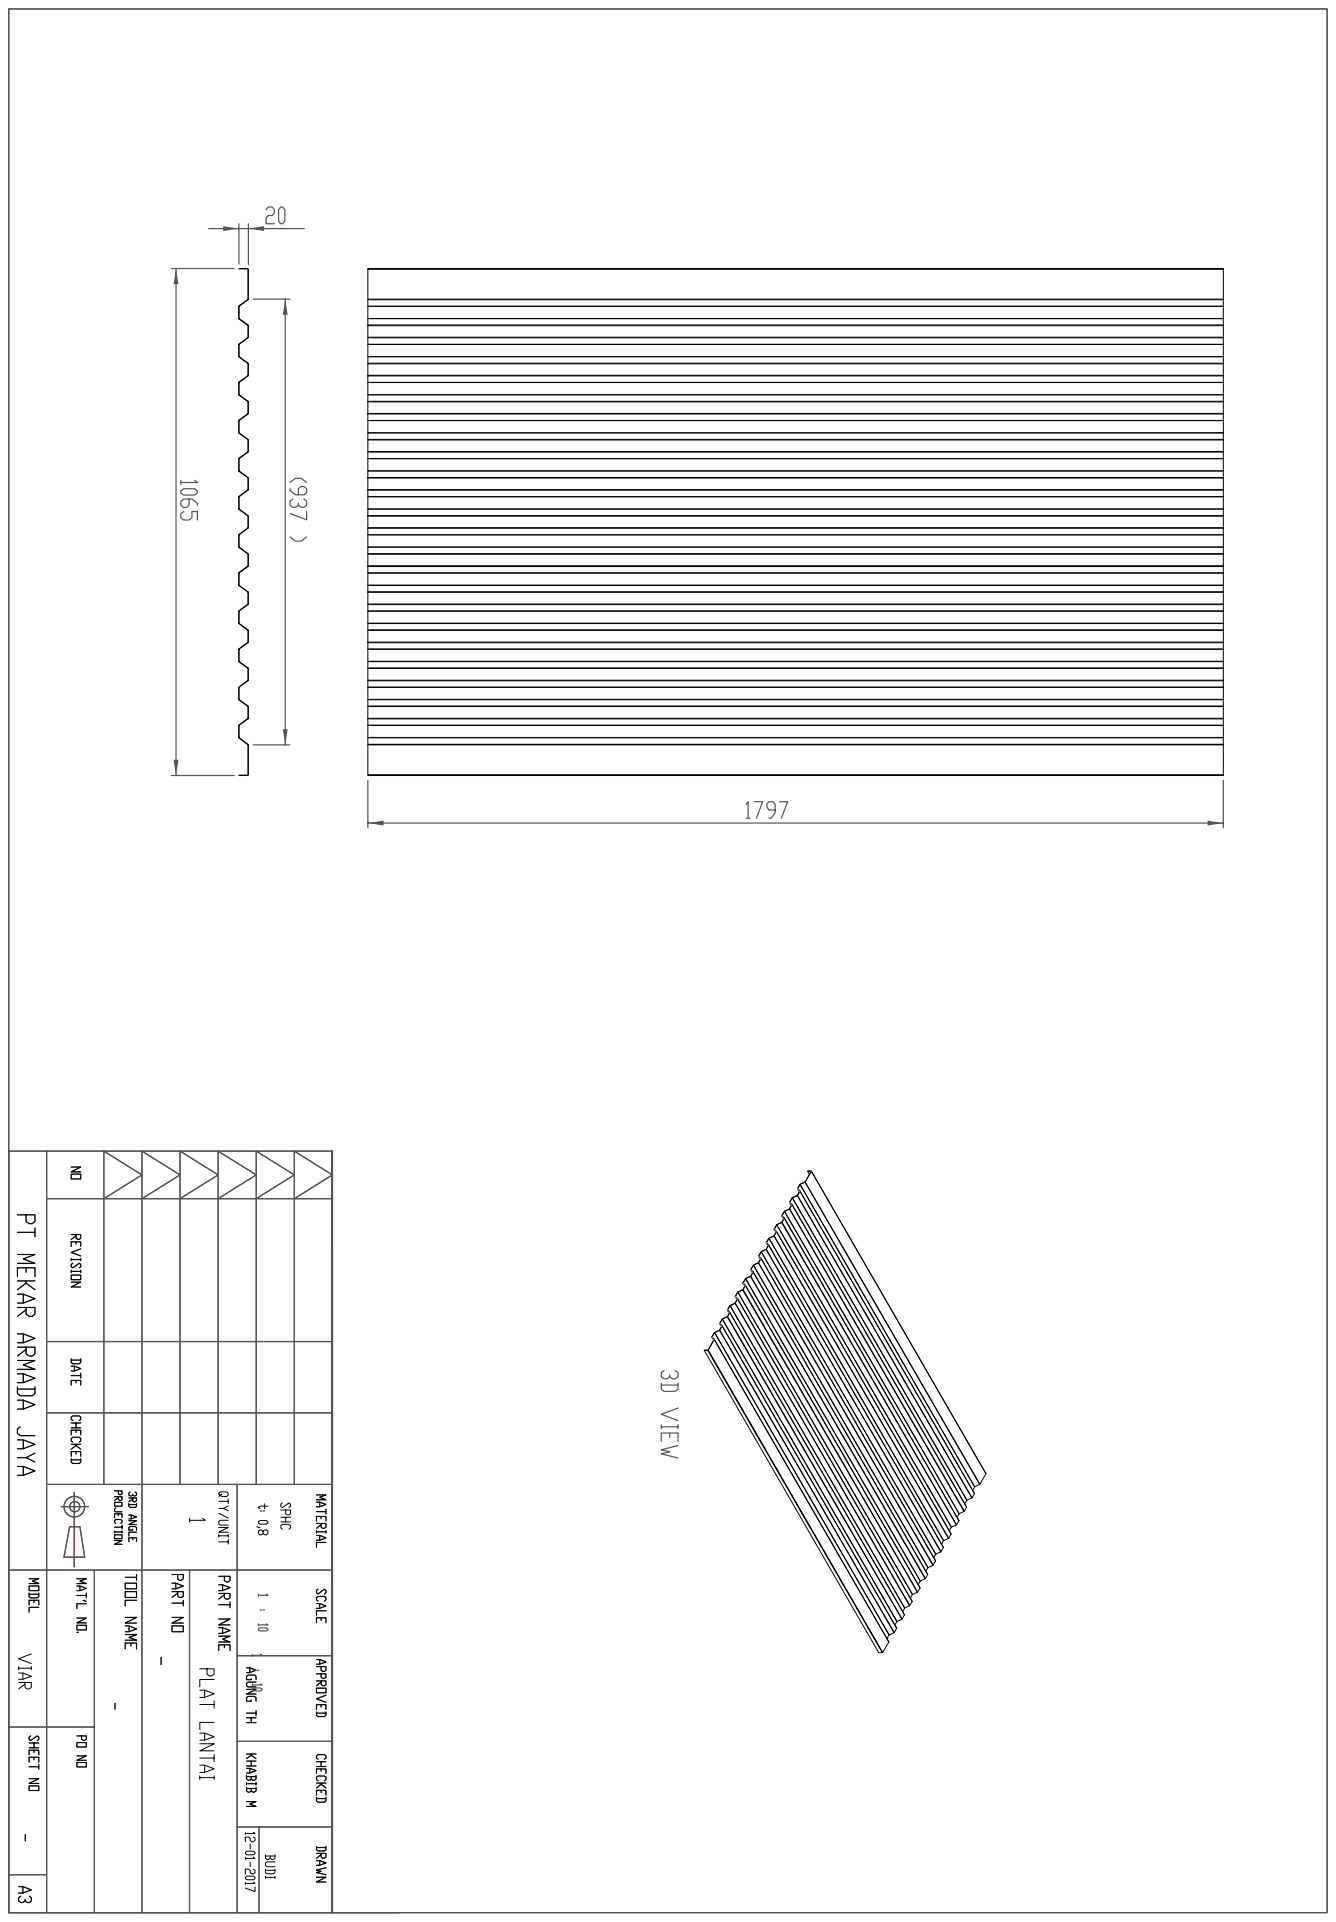
[picture p181: page 1]
