AlfonsusGiovanni/Welding-Arm-Manipulator/Referensi/DRAWING BAK VIAR PDF/Plat Penguat Samping.pdf

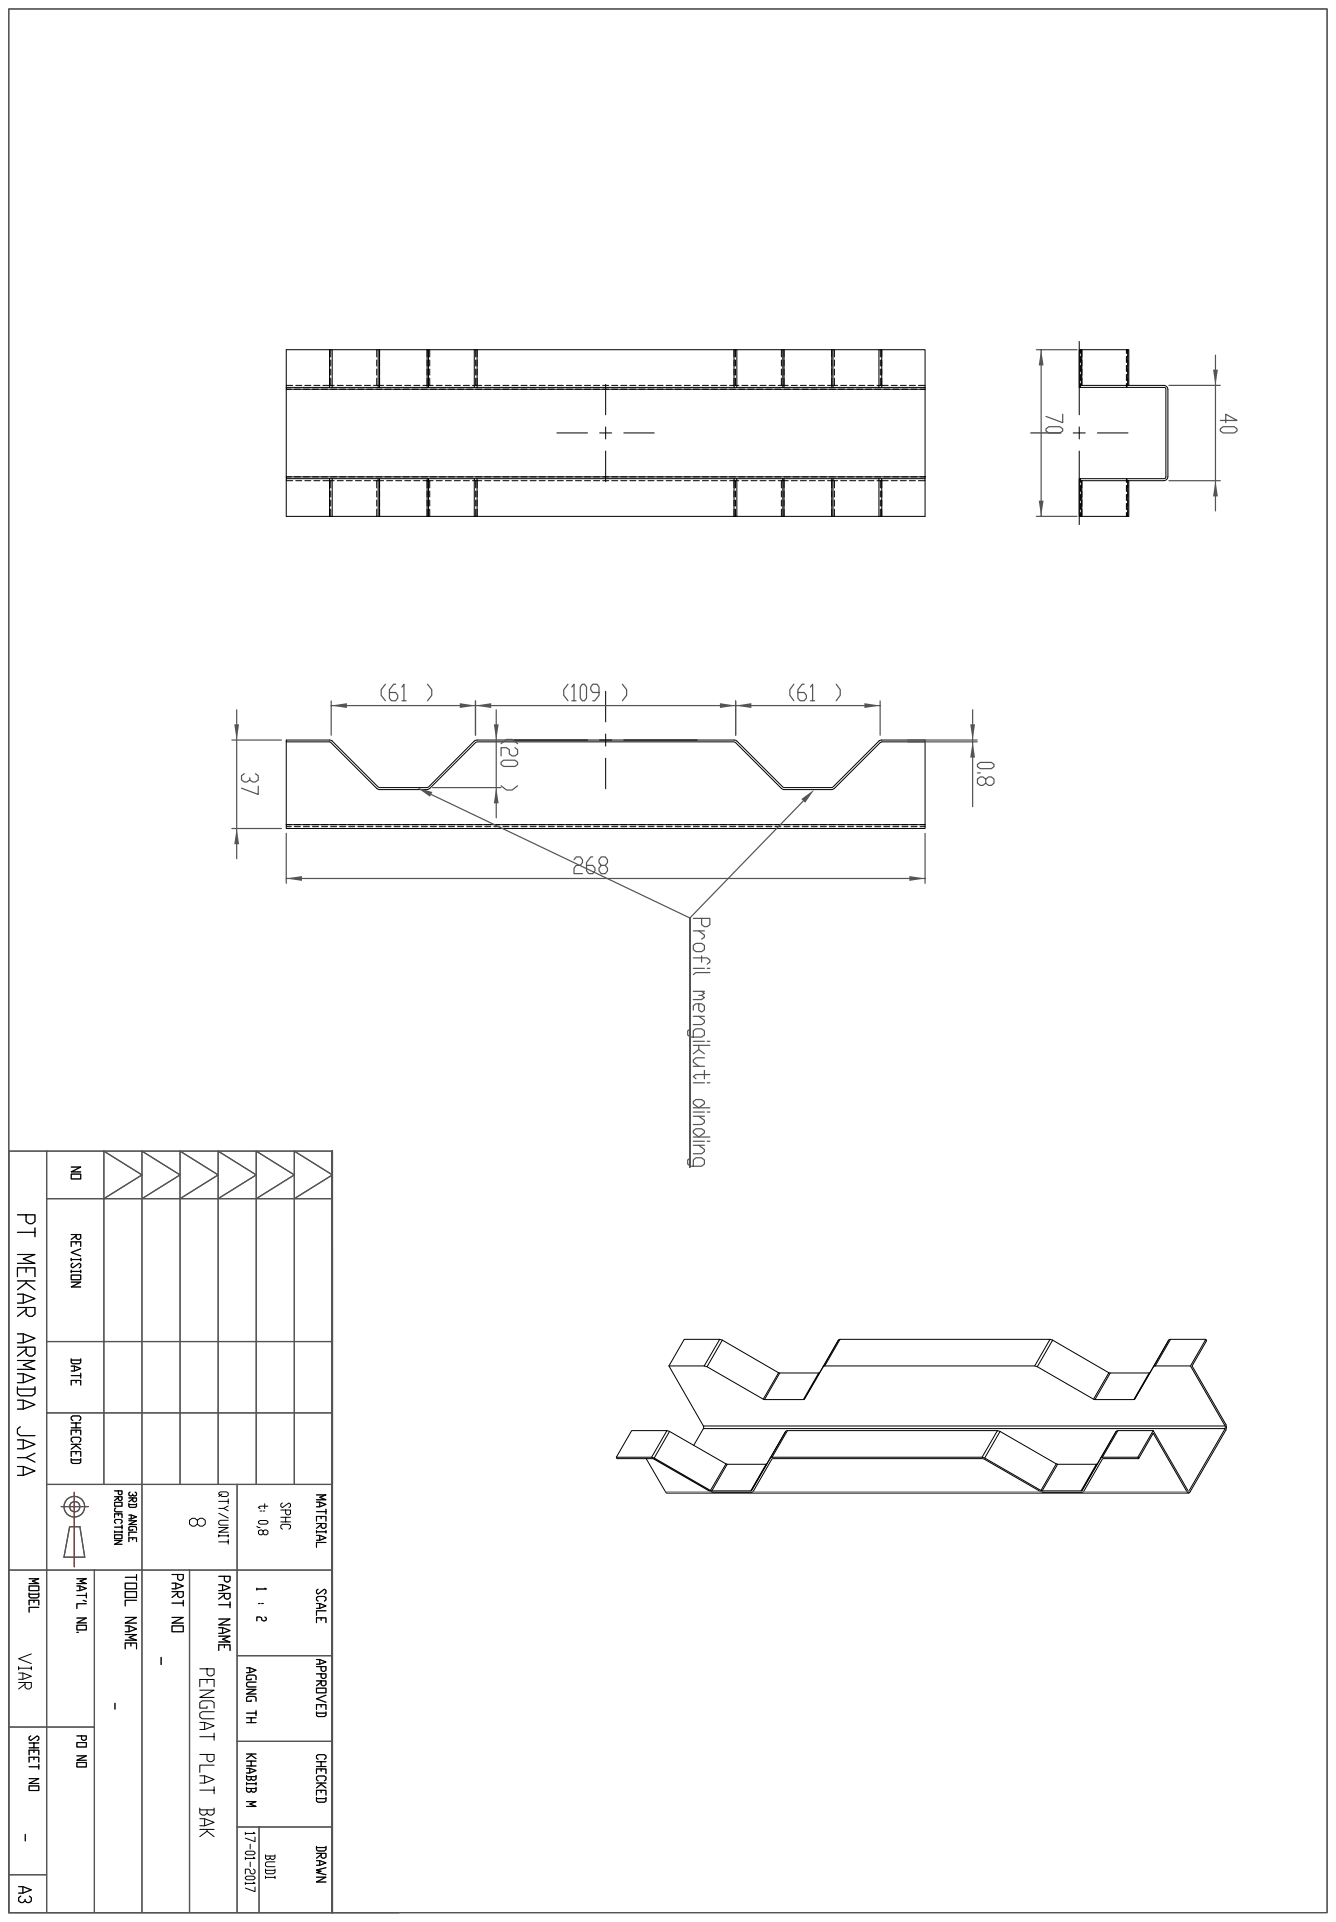
[picture p182: page 1]
