AlfonsusGiovanni/Welding-Arm-Manipulator/Referensi/DRAWING BAK VIAR PDF/Plat Pengunci.pdf

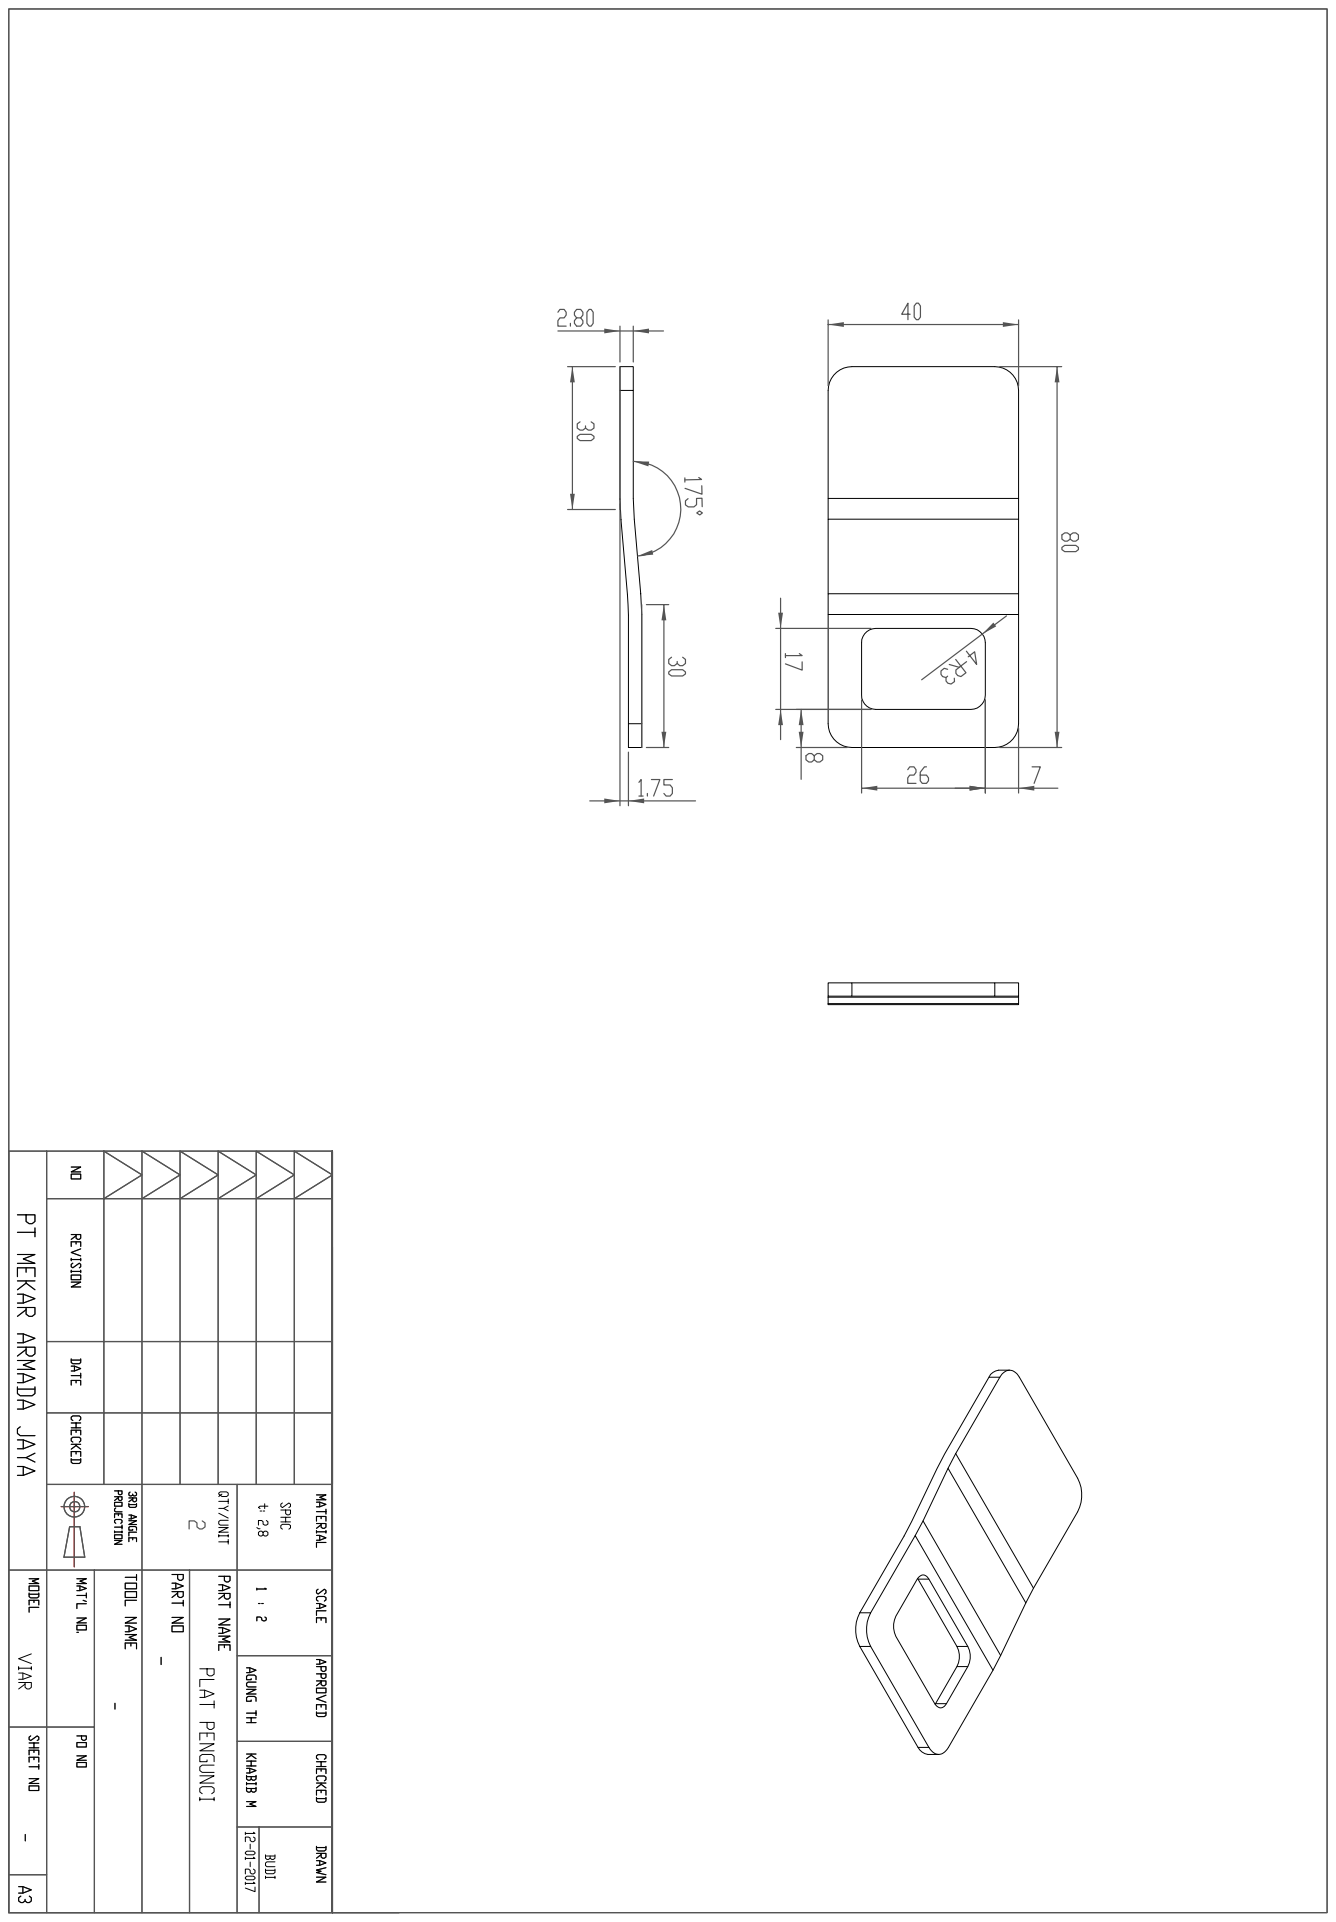
[picture p183: page 1]
