AlfonsusGiovanni/Welding-Arm-Manipulator/Referensi/DRAWING BAK VIAR PDF/Rangka Belakang.pdf

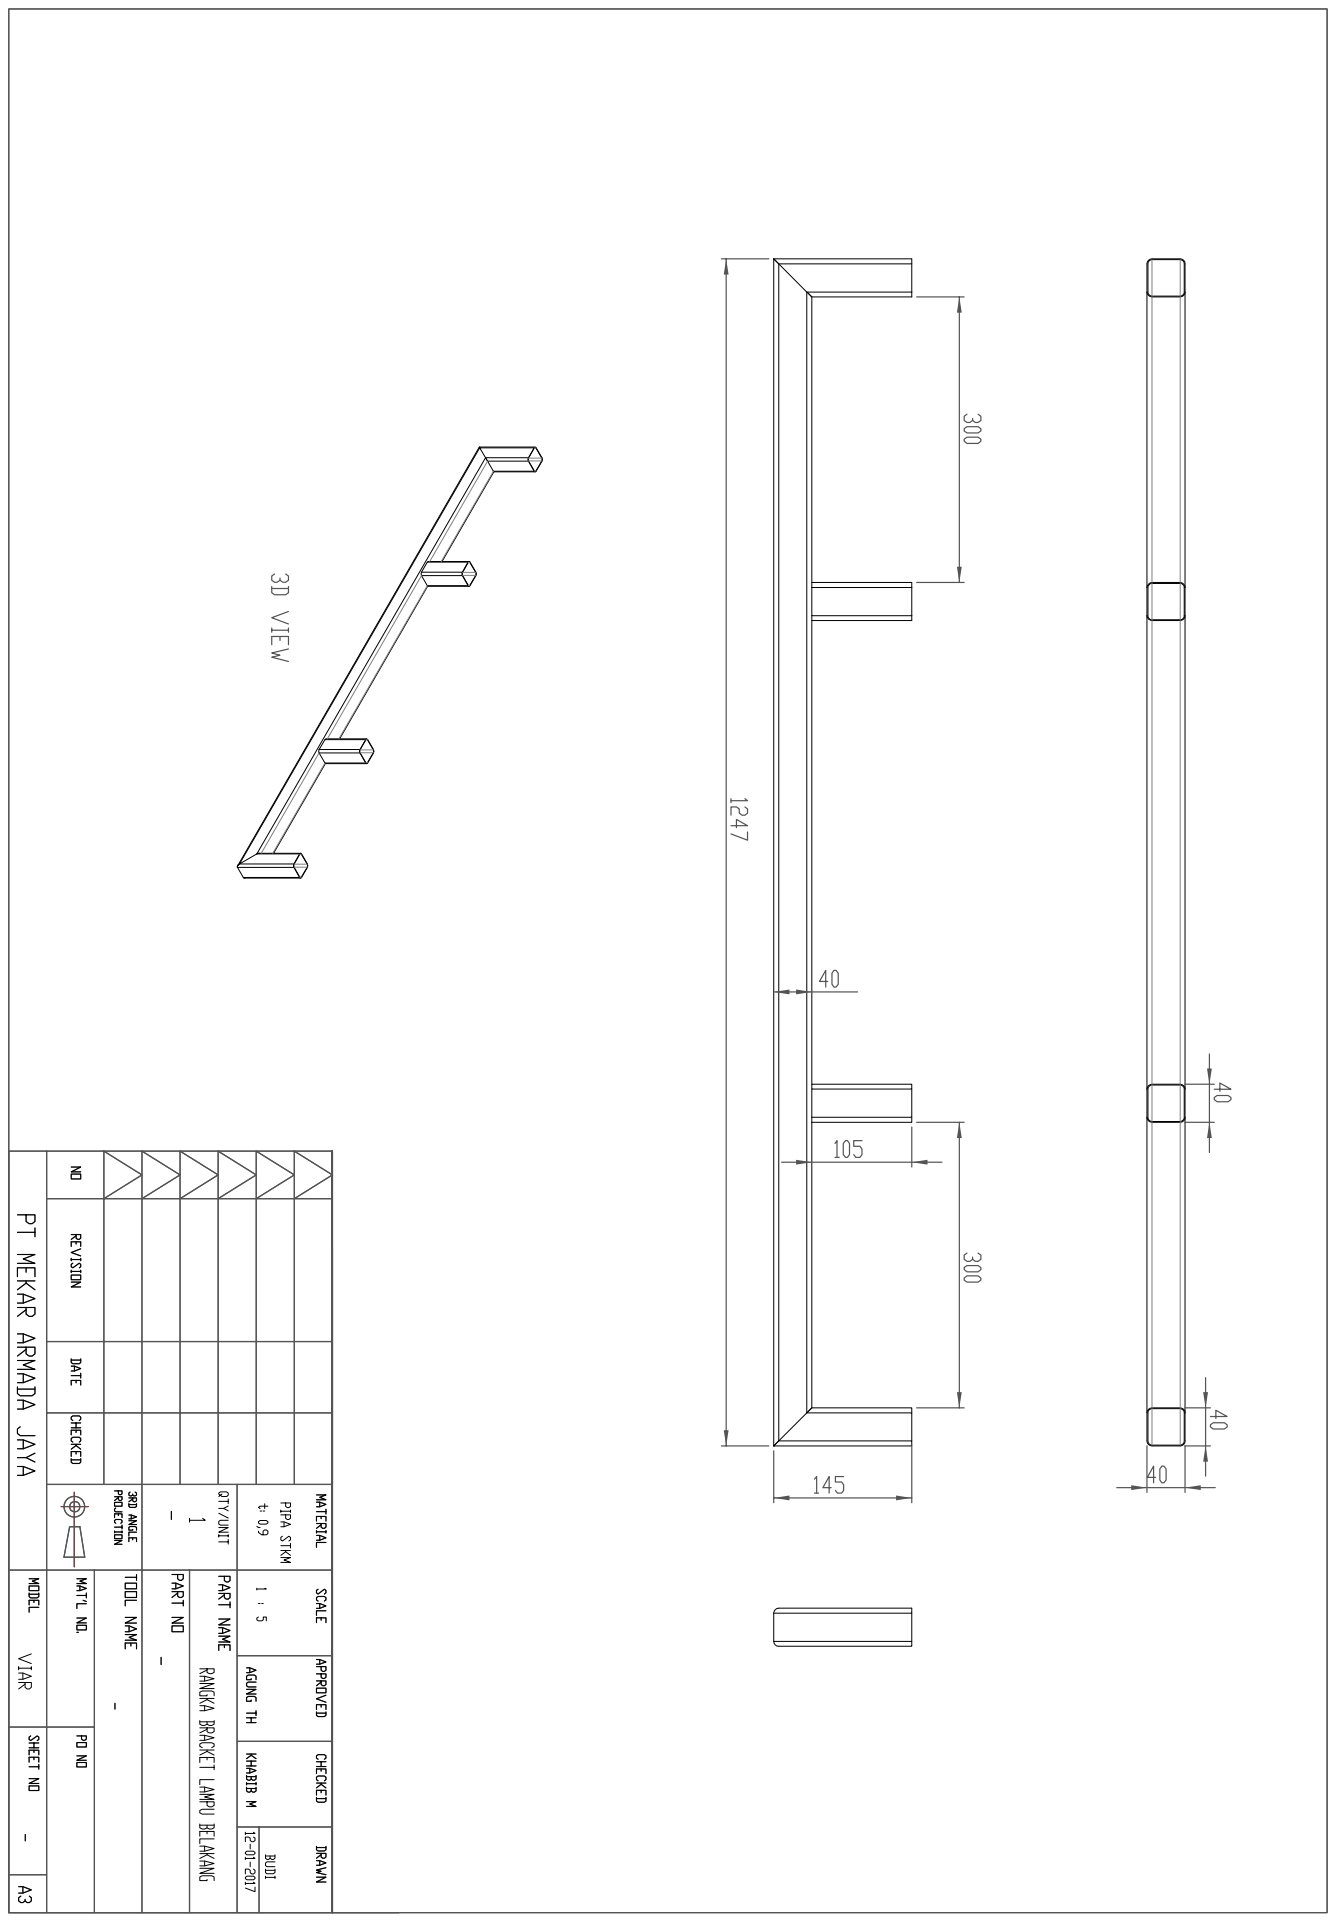
[picture p184: page 1]
