AlfonsusGiovanni/Welding-Arm-Manipulator/Referensi/DRAWING BAK VIAR PDF/rangka dek depan.pdf

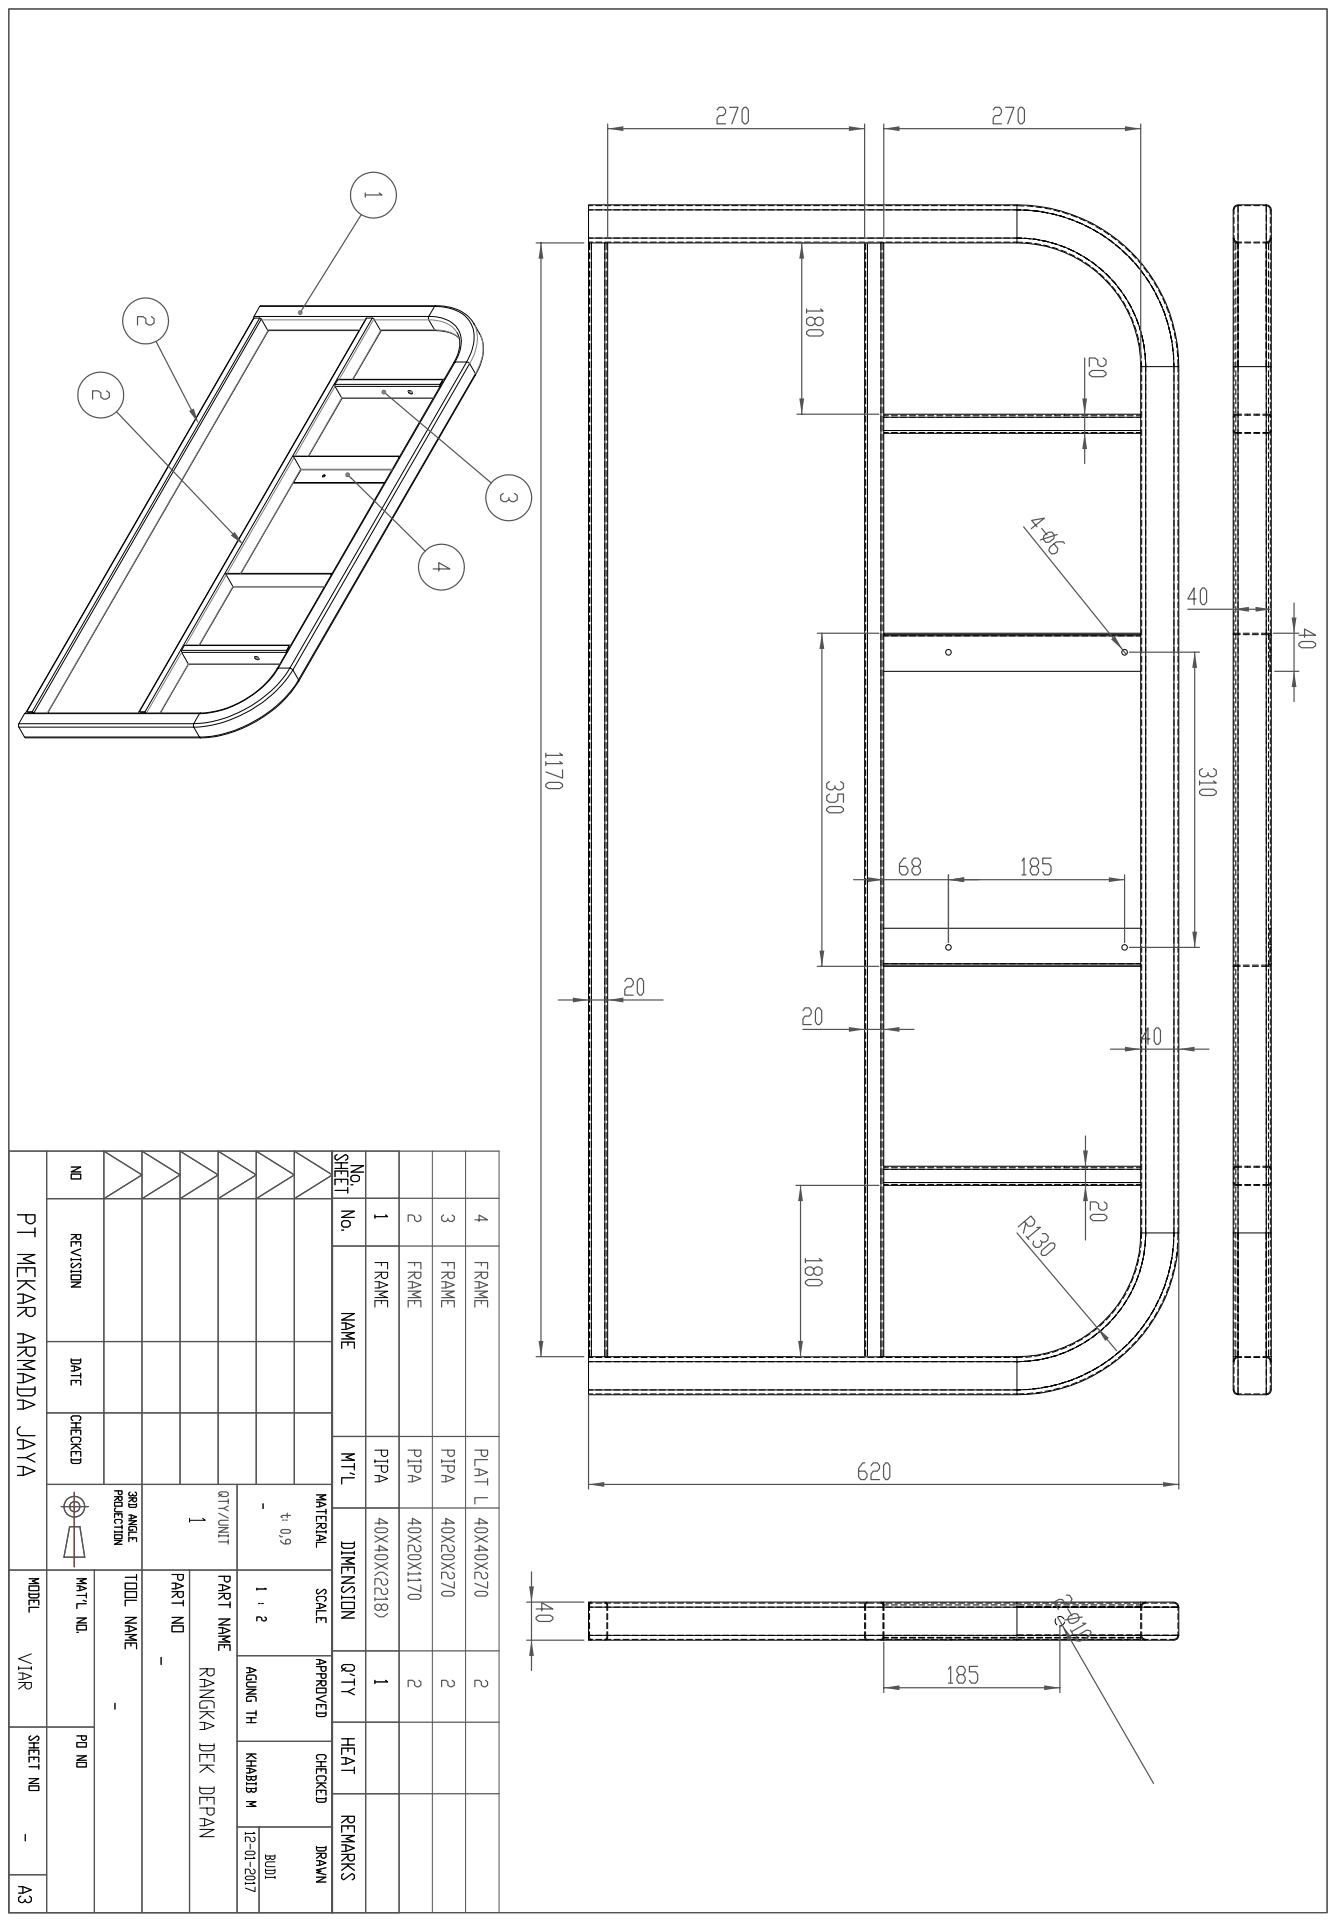
[picture p185: page 1]
