AlfonsusGiovanni/Welding-Arm-Manipulator/Referensi/DRAWING BAK VIAR PDF/Rangka Pintu Belakang II.pdf

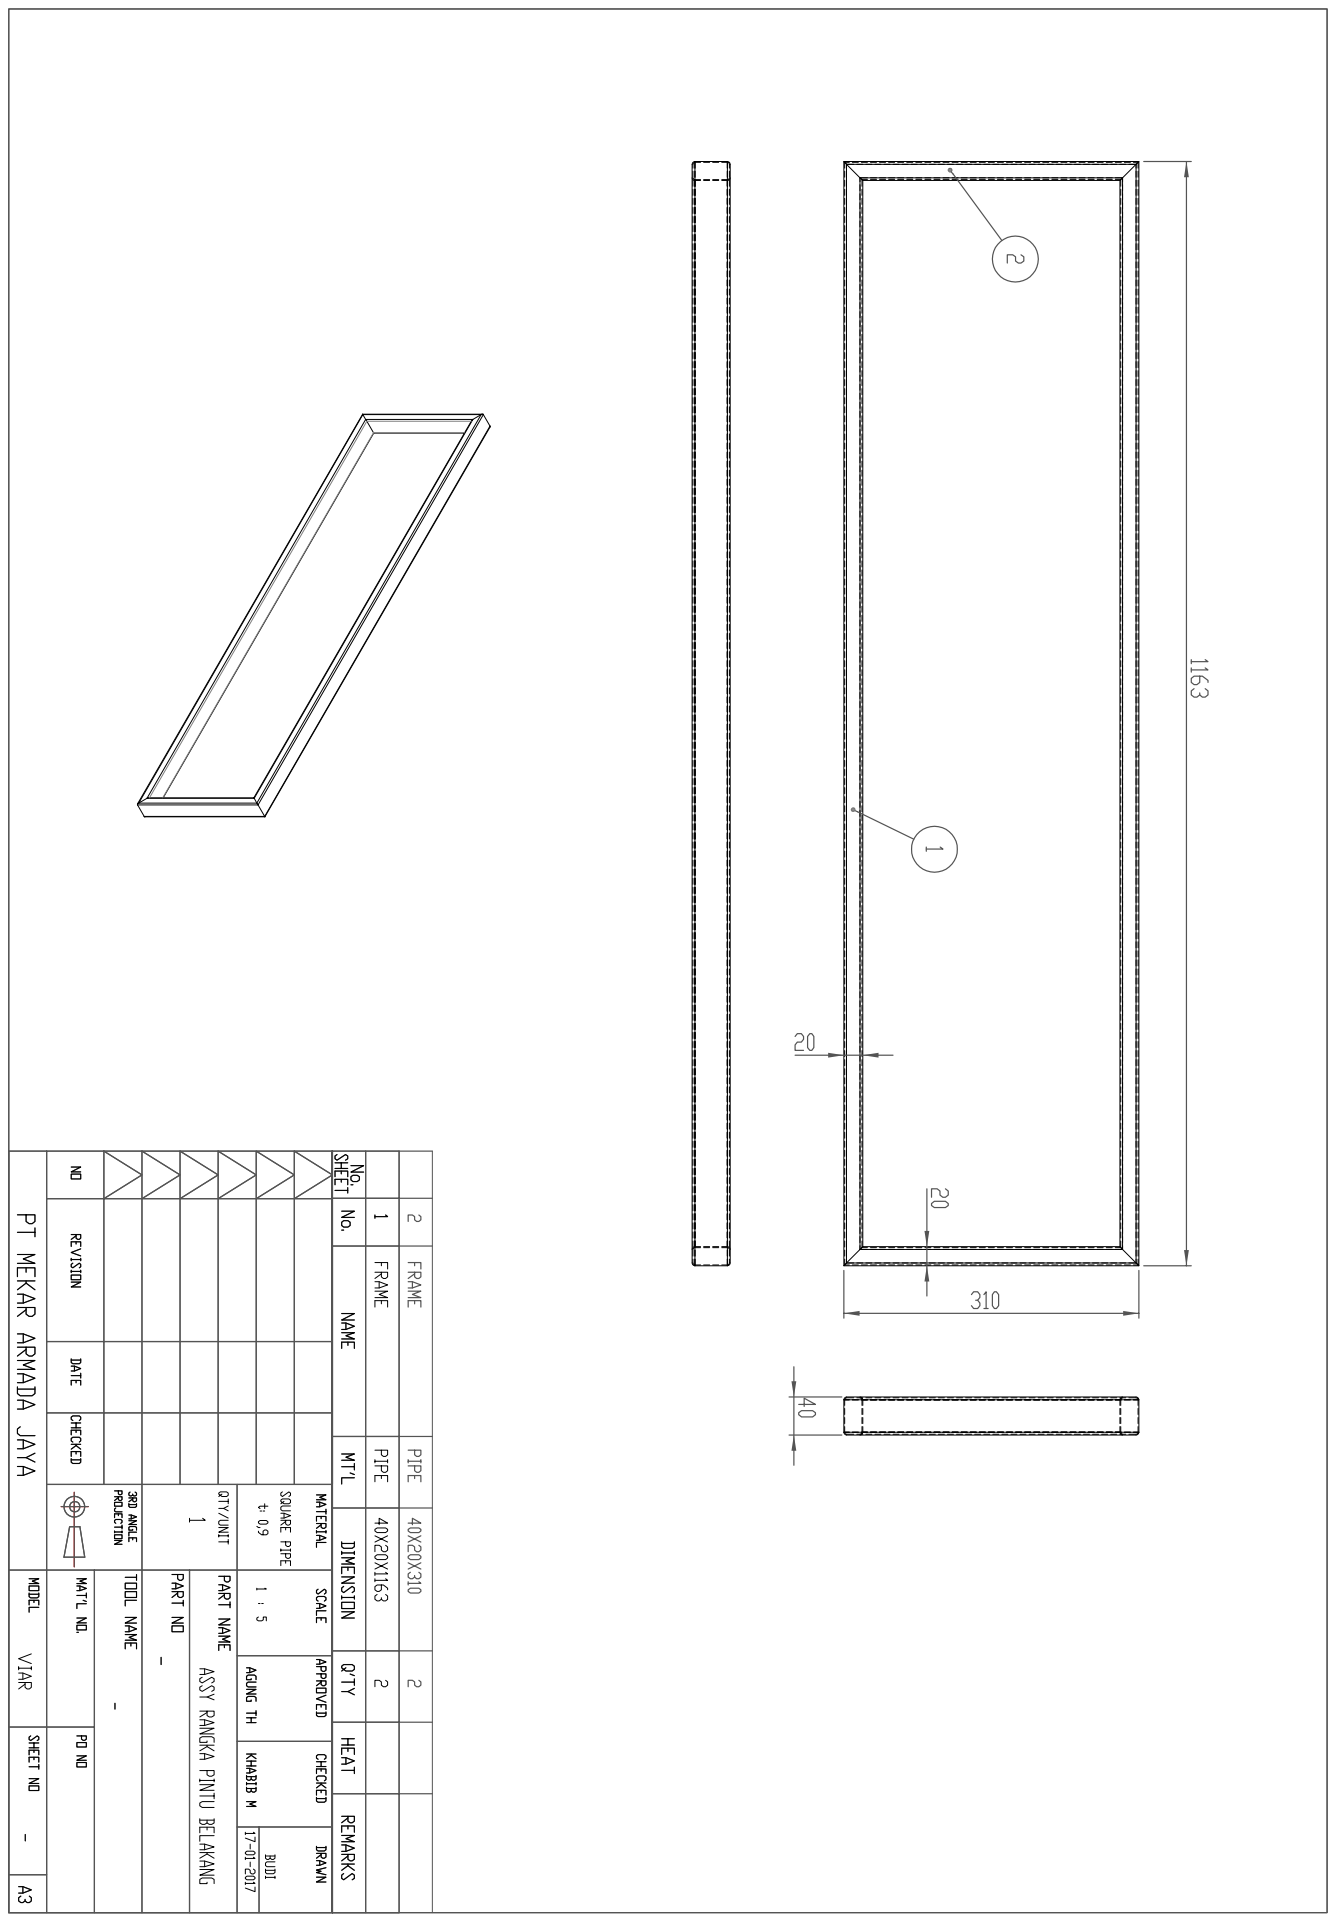
[picture p186: page 1]
