AlfonsusGiovanni/Welding-Arm-Manipulator/Referensi/DRAWING BAK VIAR PDF/Rangka Pintu Samping - II.pdf

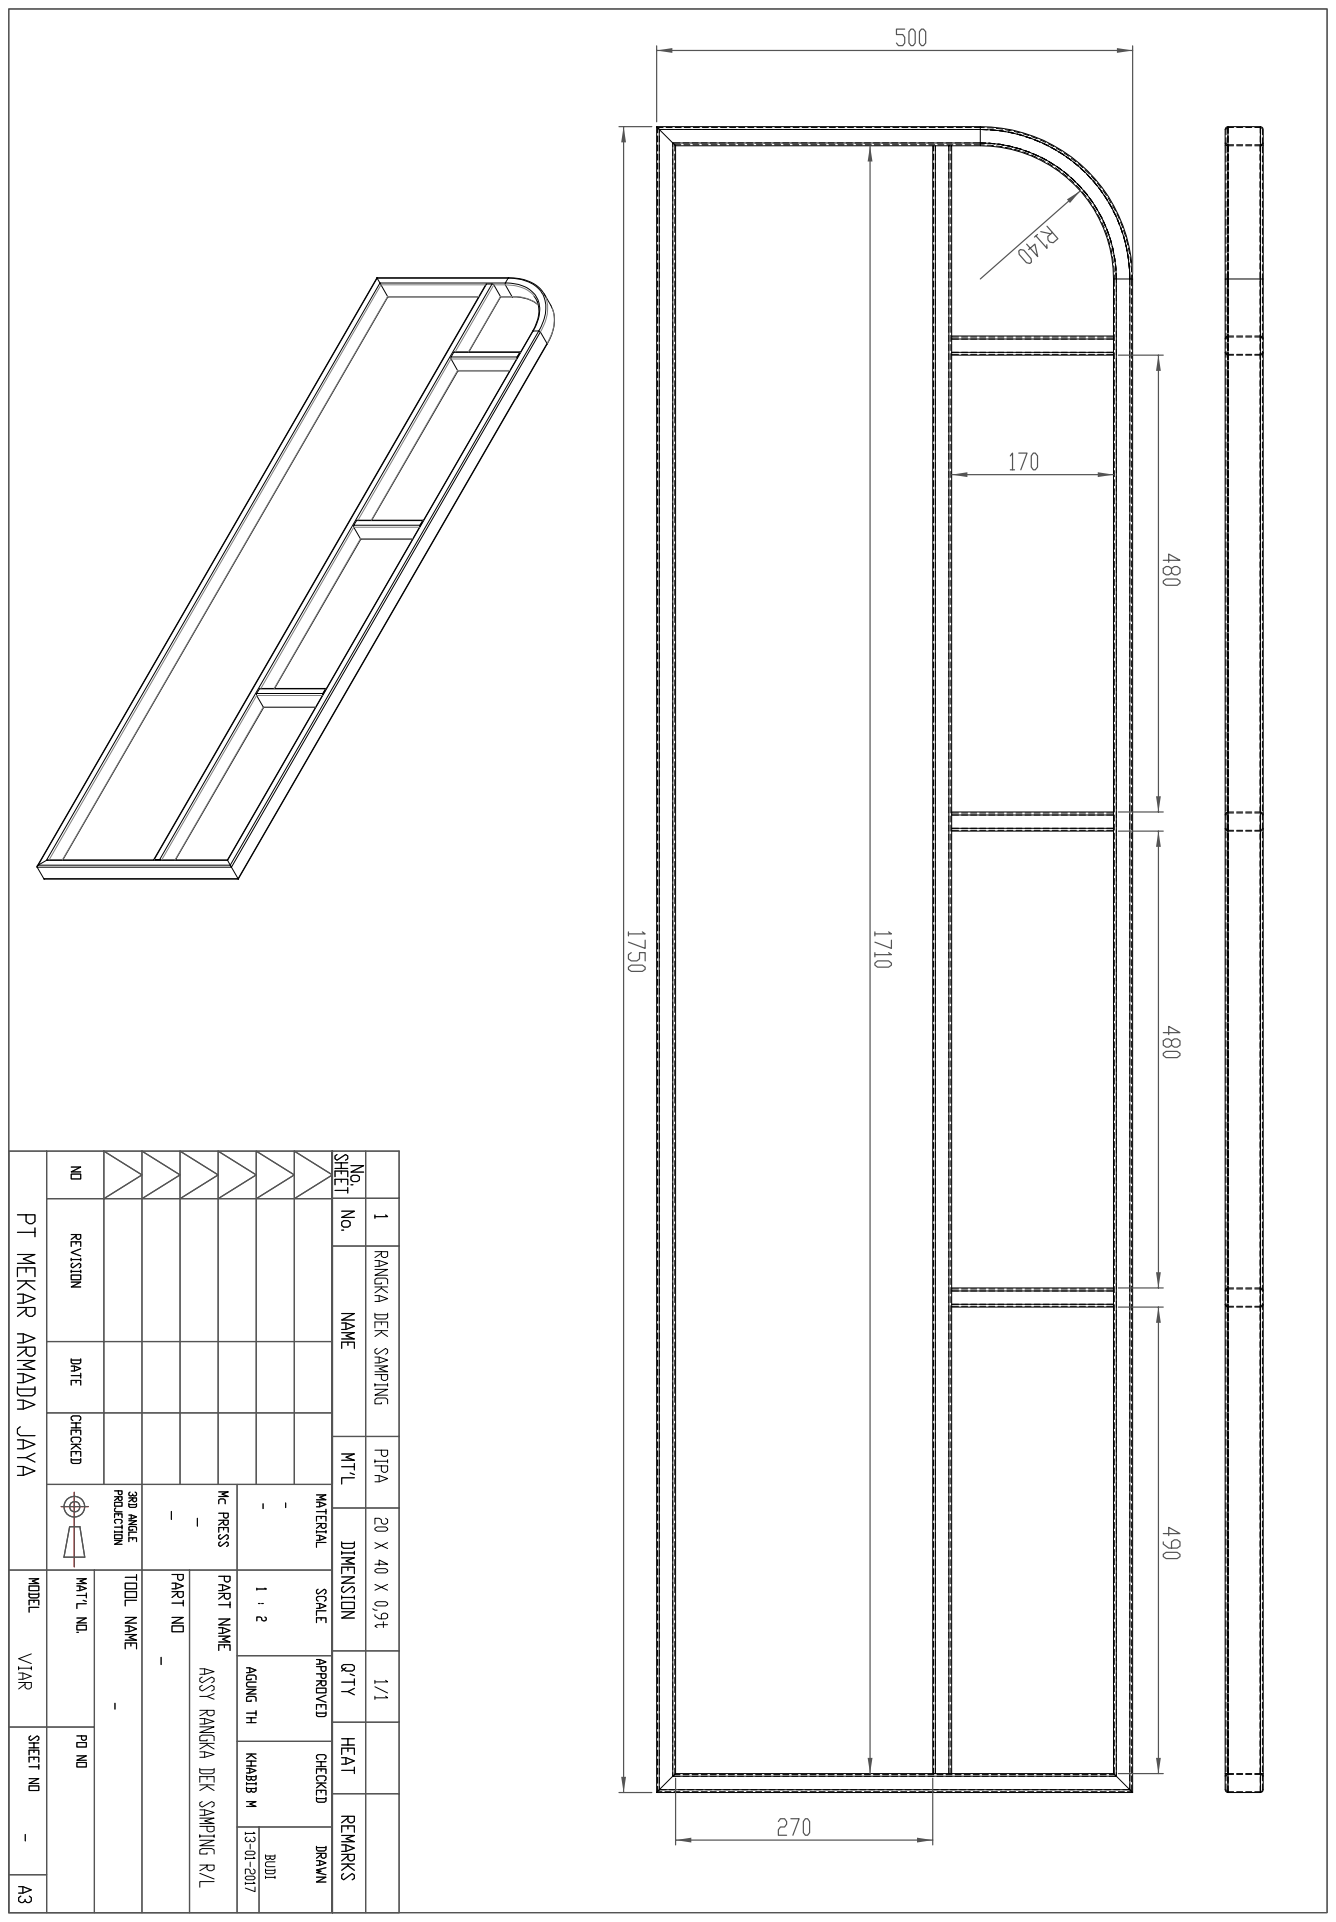
[picture p187: page 1]
