AlfonsusGiovanni/Welding-Arm-Manipulator/Referensi/DRAWING BAK VIAR PDF/Rangka Utama.pdf

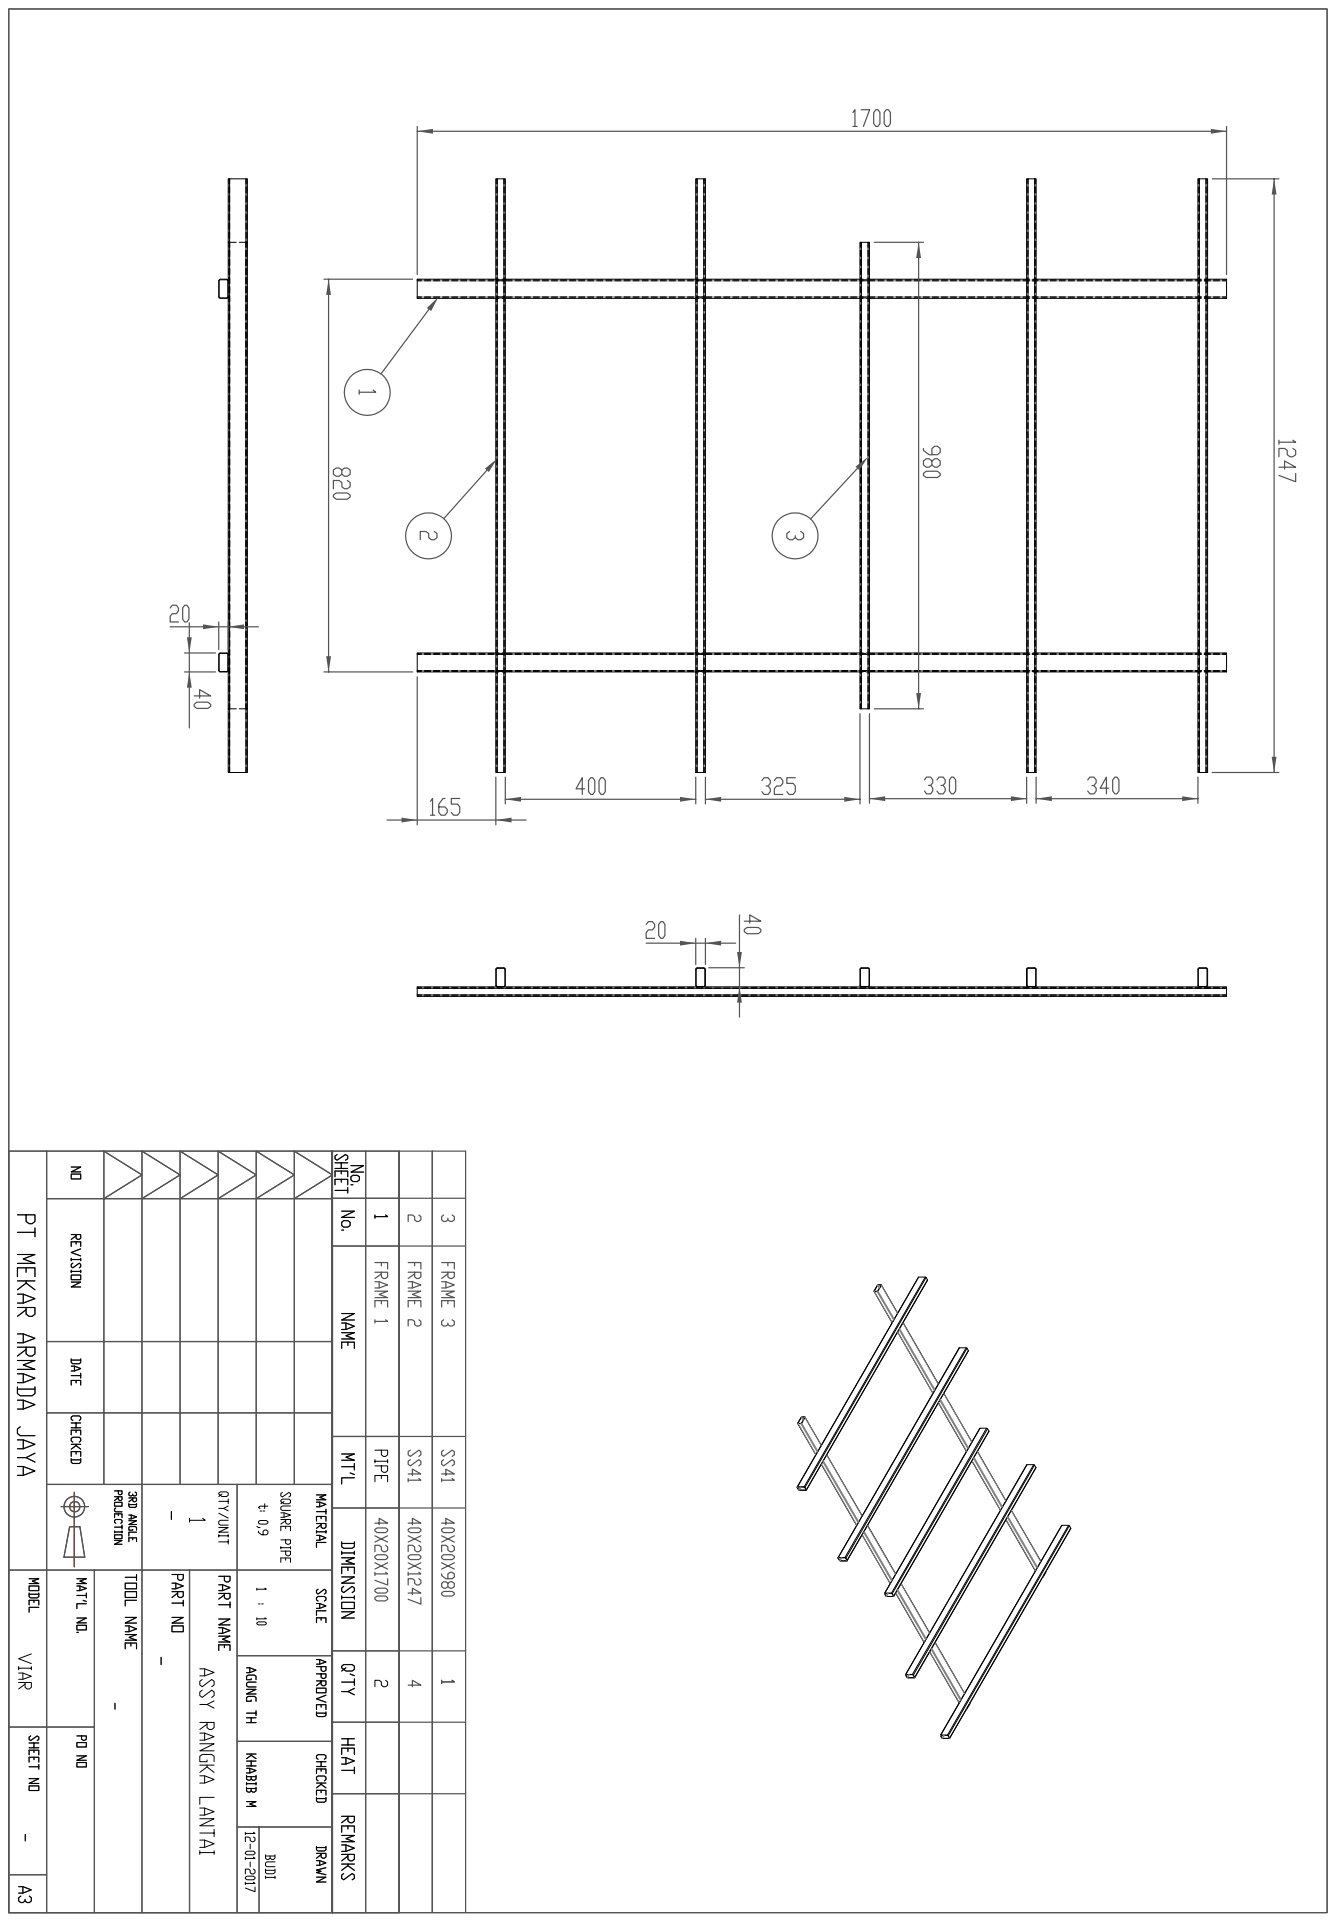
[picture p188: page 1]
