AlfonsusGiovanni/Welding-Arm-Manipulator/Referensi/DRAWING BAK VIAR PDF/Reinforce Belakang.pdf

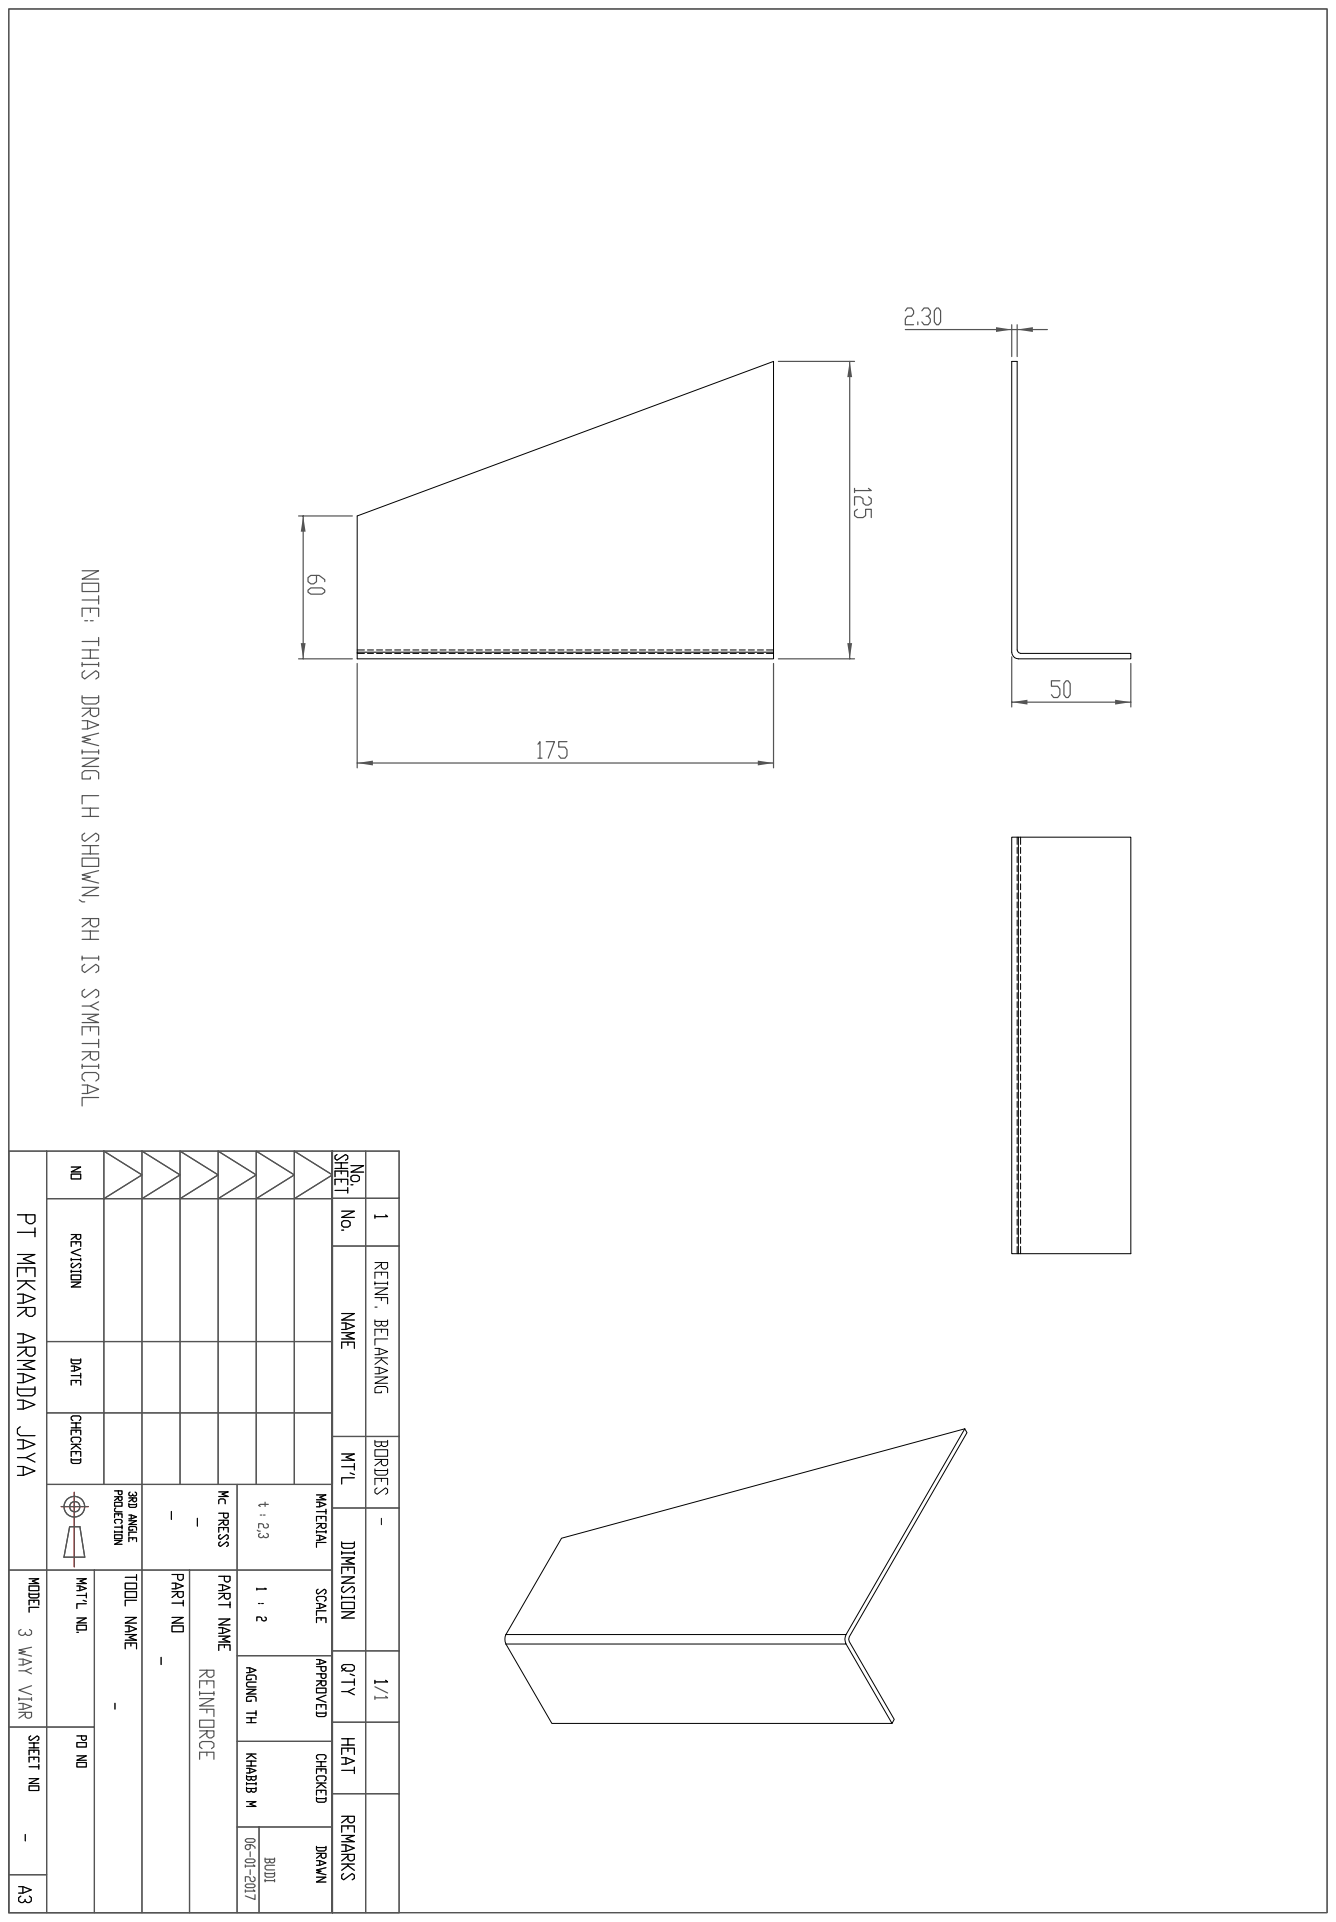
[picture p189: page 1]
