AlfonsusGiovanni/Welding-Arm-Manipulator/Referensi/DRAWING BAK VIAR PDF/reinforce deck.pdf

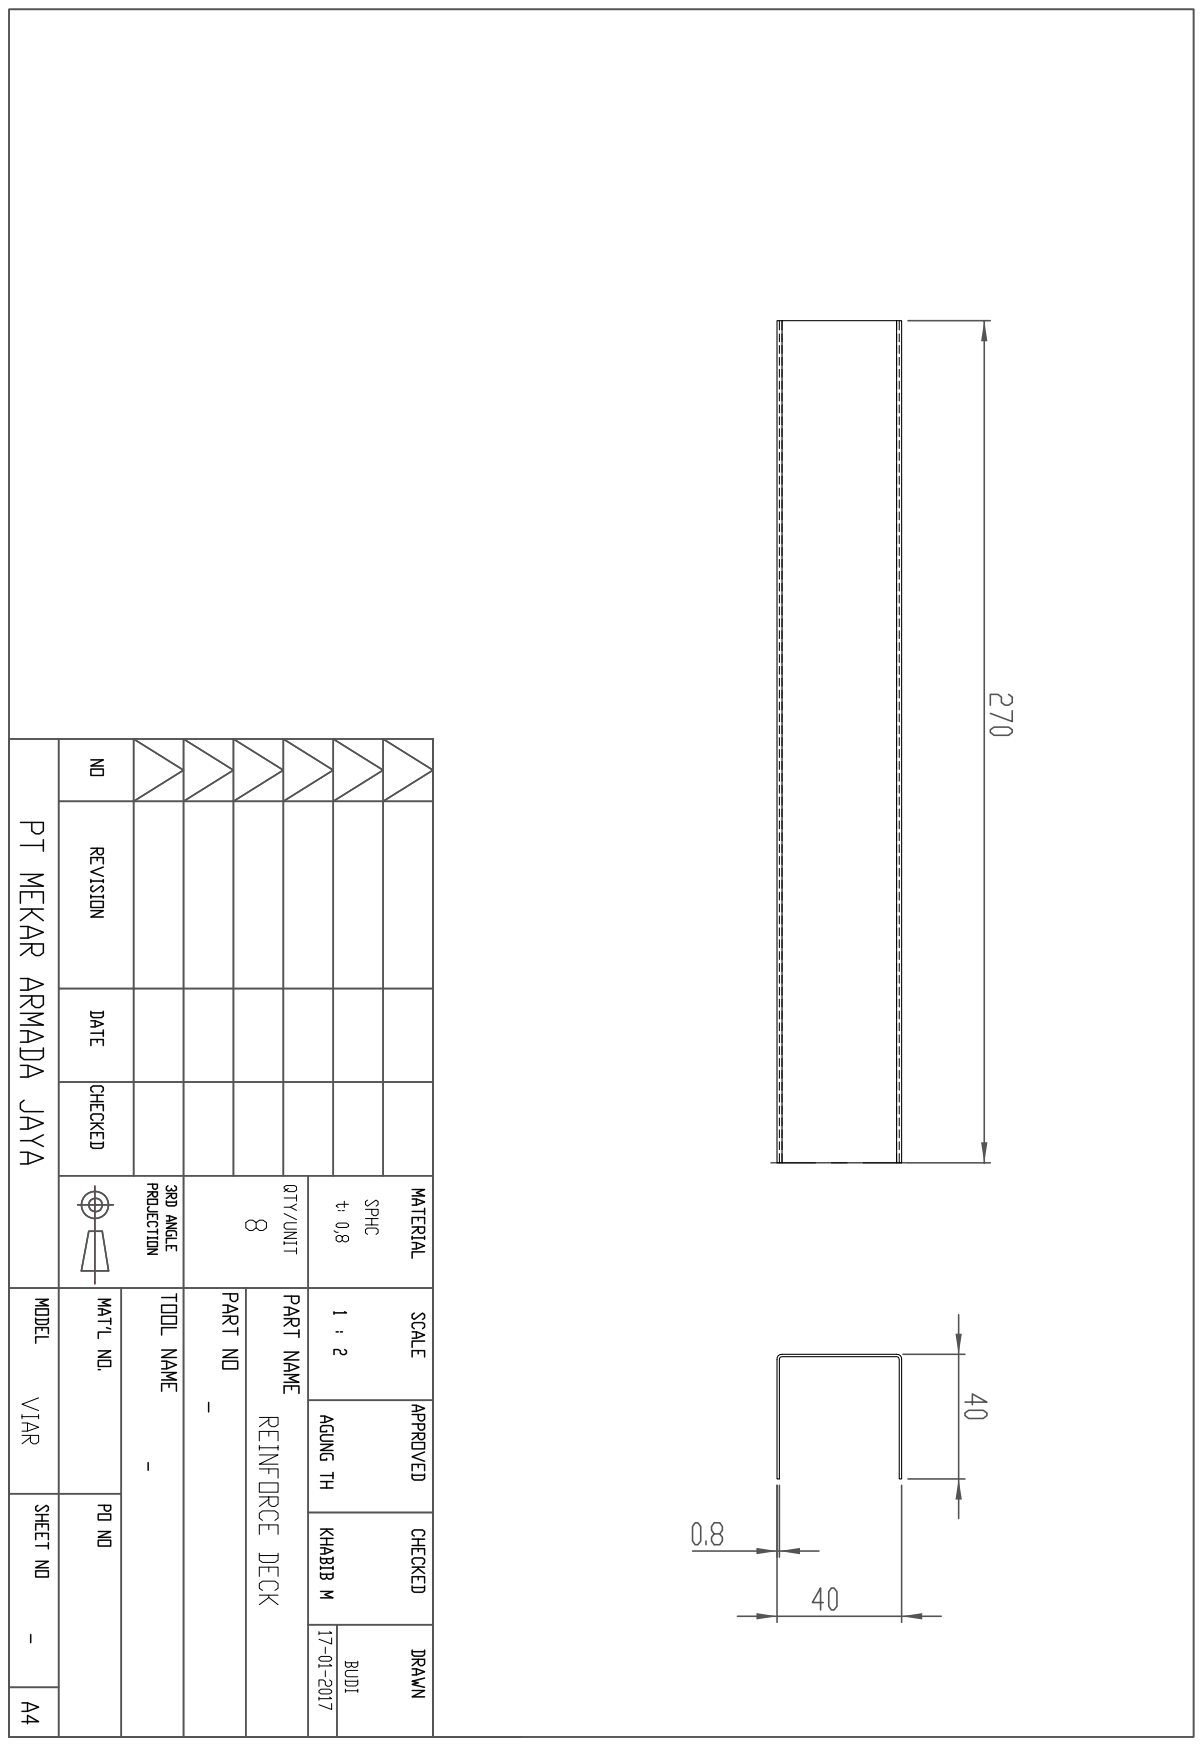
[picture p190: page 1]
