AlfonsusGiovanni/Welding-Arm-Manipulator/Program/STM32 Arm Manipulator H7 Version/STM32 Arm Manipulator H7 Version.ioc

Mcu.UserName=STM32H743VITx
PA0.GPIO_Label=ENC6A
PA0.Signal=S_TIM5_CH1
PA1.GPIO_Label=ENC6B
PA1.Signal=GPIO_Output
PA11.Signal=UART4_RX
PA12.Signal=UART4_TX
PA2.GPIO_Label=DIR6
PA2.Signal=GPIO_Output
PA4.GPIO_Label=PUL6
PA4.Signal=GPIO_Output
PA5.GPIO_Label=ENC3A
PA5.Signal=S_TIM2_CH1_ETR
PA6.GPIO_Label=ENC5A
PA6.Signal=S_TIM3_CH1
PA7.GPIO_Label=ENC5B
PA7.Signal=GPIO_Output
PB0.GPIO_Label=PUL5
PB0.Signal=GPIO_Output
PB10.GPIO_Label=PUL2
PB10.Signal=GPIO_Output
PB12.GPIO_Label=DIR1
PB12.Signal=GPIO_Output
PB14.GPIO_Label=PUL1
PB14.Signal=GPIO_Output
PB2.GPIO_Label=DIR4
PB2.Signal=GPIO_Output
PB6.GPIO_Label=I2C_SCL
PB6.Signal=I2C1_SCL
PB7.GPIO_Label=I2C_SDA
PB7.Signal=I2C1_SDA
PC0.GPIO_Label=ENABLE1
PC0.Signal=GPIO_Output
PC1.GPIO_Label=ENABLE2
PC1.Signal=GPIO_Output
PC10.Signal=SDMMC1_D2
PC11.Signal=SDMMC1_D3
PC12.Signal=SDMMC1_CK
PC13.GPIO_Label=LIMIT6
PC13.Signal=GPXTI13
PC4.GPIO_Label=DIR5
PC4.Signal=GPIO_Output
PC6.GPIO_Label=ENC2A
PC6.Signal=S_TIM8_CH1
PC7.GPIO_Label=ENC2B
PC7.Signal=GPIO_Output
PC8.Signal=SDMMC1_D0
PC9.Signal=SDMMC1_D1
PD12.GPIO_Label=ENC1A
PD12.Signal=S_TIM4_CH1
PD13.GPIO_Label=ENC1B
PD13.Signal=GPIO_Output
PD2.Signal=SDMMC1_CMD
PD8.GPIO_Label=MIG_SW_IN
PD8.Signal=GPIO_Output
PE10.GPIO_Label=DIR3
PE10.Signal=GPIO_Output
PE11.GPIO_Label=ENC4B
PE11.Signal=GPIO_Output
PE12.GPIO_Label=PUL3
PE12.Signal=GPIO_Output
PE14.GPIO_Label=DIR2
PE14.Signal=GPIO_Output
PE2.GPIO_Label=LIMIT1
PE2.Signal=GPXTI2
PE3.GPIO_Label=LIMIT2
PE3.Signal=GPXTI3
PE4.GPIO_Label=LIMIT3
PE4.Signal=GPXTI4
PE5.GPIO_Label=LIMIT4
PE5.Signal=GPXTI5
PE6.GPIO_Label=LIMIT5
PE6.Signal=GPXTI6
PE8.GPIO_Label=PUL4
PE8.Signal=GPIO_Output
PE9.GPIO_Label=ENC4A
PE9.Signal=S_TIM1_CH1
