AlfonsusGiovanni/Welding-Arm-Manipulator/Program/STM32 Arm Manipulator/Core/Src/main.c

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
/* Includes ------------------------------------------------------------------*/
#include "main.h"
#include "fatfs.h"

/* USER CODE BEGIN Includes */
#include "TB6600_Driver.h"
#include "EEPROM_lib.h"
#include "RS232_Driver.h"

#include "fatfs_sd.h"
#include "string.h"

#include "fonts.h"
#include "ssd1306.h"

#include "stdio.h"
#include "stdlib.h"

#include "math.h"
/* USER CODE END Includes */

/* USER CODE BEGIN PTD */

// EEPROM TYPEDEF
EEPROM_t eeprom1;
EEPROM_t eeprom2;

// RS232 TYPEDEF
Data_Get_t command;

// DRIVER STEPPER TYPEDEF
Driver_t Stepper_Driver1;
Driver_t Stepper_Driver2;
Driver_t Stepper_Driver3;
Driver_t Stepper_Driver4;
Driver_t Stepper_Driver5;
Driver_t Stepper_Driver6;

// OLED MENU TYPEDEF
typedef enum{
	MENU1,	// RS-232 Communication Status
	MENU2,	// EEPROM Available Memory
}Oled_Menu_t;


/* USER CODE END PTD */

/* USER CODE BEGIN PD */

/*SYSTEM CONFIGURATION*/
//----------------------
//#define USE_EEPROM
//#define USE_RS232
//#define USE_OLED
//#define USE_STEPPER
//#define USE_SDCARD
//#define USE_ENCODER
//----------------------


/*EEPROM ADDRESS SET*/
//-----------------------------------
#define EEPROM1_ADDRESS					0xA0	// PRIMARY EEPROM ADDRESS
#define EEPROM2_ADDRESS					0xA1	// SECONDARY EEPROM ADDRESS

#define SP_POS_BYTE_ADDR				0x00	// START POINT POSITION ADDR
#define EP_POS_BYTE_ADDR				0x18	// END POINT POSITION ADDR
#define SP_ANG_BYTE_ADDR				0x30	// START POINT ANGLE ADDR
#define EP_ANG_BYTE_ADDR				0x48	// END POINT ANGLE ADDR
#define PATTERN_BYTE_ADDR				0x60	// PATTERN ADDR
//-----------------------------------


/*EEPROM PATTERN SET*/
//-----------------------------------
#define LINEAR_PATTERN					0x01
#define CIRCULAR_PATTERN				0x02
#define ZIGZAG_PATTERN					0x03
//-----------------------------------


/*ROBOT TEST SET*/
//-------------------
//#define EEPROM_TEST
#define RS232_TEST
//#define STEPPER_TEST
//#define SDCARD_TEST
//#define ENCODER_TEST
//#define OLED_TEST
//-------------------

/* USER CODE END PD */

I2C_HandleTypeDef hi2c1;

SPI_HandleTypeDef hspi1;

TIM_HandleTypeDef htim2;
TIM_HandleTypeDef htim3;

UART_HandleTypeDef huart1;
DMA_HandleTypeDef hdma_usart1_rx;

/* USER CODE BEGIN PV */

/*EEPROM VARIABLE*/
////////////////////////////////////////
double 
array_pos_start[3],
array_pos_end[3],
array_ang_start[6],
array_ang_end[6];

uint8_t
page_data_byte[128],

saved_pos[24], read_saved_pos[24],
read_saved_posX[8],
read_saved_posY[8],
read_saved_posZ[8],

saved_angle[48], read_saved_angle[48],
read_saved_angle1[8],
read_saved_angle2[8],
read_saved_angle3[8],
read_saved_angle4[8],
read_saved_angle5[8],
read_saved_angle6[8],

welding_pattern,
read_saved_pattern[1];
////////////////////////////////////////


/*MOVE VARIABLE*/
///////////////////
double
current_position[3],
move_position[3],
prev_position[3],
delta_move_pos[3],

current_angle[6],
move_angle[6], 
delta_move_ang[6],
prev_angle[6];

uint8_t
current_point,
current_speed;
///////////////////


/*RS232 VARIABLE*/
///////////////////
uint8_t
rx_savepoint,
rx_patterntype[200],
rx_pointtype,
rx_rotate_mode,
rx_rotate_value[8];
///////////////////

/*OLED VARIABLE*/
/////////////////////////
uint8_t selected_menu;

char 
title[] = "WELDING ARM V1";
/////////////////////////

/* USER CODE END PV */

void SystemClock_Config(void);
static void MX_GPIO_Init(void);
static void MX_DMA_Init(void);
static void MX_USART1_UART_Init(void);
static void MX_I2C1_Init(void);
static void MX_SPI1_Init(void);
static void MX_TIM2_Init(void);
static void MX_TIM3_Init(void);
/* USER CODE BEGIN PFP */

/*EEPROM CUSTOM FUNCTION*/
//----------------------------------------------------------------------------------------------------------
void Save_WeldingPoint_Position(uint16_t welding_point, uint8_t start_addr, double* pos_data, size_t size);
void Read_WeldingPoint_Position(uint16_t welding_point, uint8_t start_addr, double* stored_data, size_t size);

void Save_WeldingPoint_Angle(uint16_t welding_point, uint8_t start_addr, double* angle_data, size_t size);
void Read_WeldingPoint_Angle(uint16_t welding_point, uint8_t start_addr, double* stored_data, size_t size);

void Save_WeldingPoint_Pattern(uint16_t welding_point, uint8_t select_pattern);
void Read_WeldingPoint_Pattern(uint16_t welding_point, uint8_t store_pattern);

void Read_All_WeldingDataBuyte(uint16_t welding_point);

uint16_t Check_Free_WeldingPoint(void);

void Show_Menu(Oled_Menu_t sel_menu);
//----------------------------------------------------------------------------------------------------------

/* USER CODE END PFP */

/* USER CODE BEGIN 0 */

/*OLED MENU CONFIGURATION*/
//------------------------------------------------------------
void HAL_TIM_PeriodElapsedCallback(TIM_HandleTypeDef *htim){
	if(htim->Instance == TIM3) Show_Menu(selected_menu);
}
//------------------------------------------------------------

/*RS232 CONFIGURATION*/
//------------------------------------------------------
uint32_t RS232_state, RS232_err_status;
uint8_t dummy_byte[100];
void HAL_UART_RxCpltCallback(UART_HandleTypeDef *huart){
	Get_command(&command);
	RS232_state = check_state();
	RS232_err_status = check_error();
}
//------------------------------------------------------

/* USER CODE END 0 */

/**
  * @brief  The application entry point.
  * @retval int
  */
int main(void)
{
  /* USER CODE BEGIN 1 */
	
	#ifdef USE_STEPPER
	/*--- COFIGURATION FOR STEPPER DRIVER 1 ---*/
	//-------------------------------------------------
	Stepper_Driver1.DIR_PORT = DIR_1_GPIO_Port;
	Stepper_Driver1.DIR_PIN = DIR_1_Pin;
	Stepper_Driver1.PULSE_PORT = PULSE_1_GPIO_Port;
	Stepper_Driver1.PULSE_PIN = PULSE_1_Pin;
	Stepper_Driver1.ENA_PORT = ENABLE_GPIO_Port;
	Stepper_Driver1.ENA_PIN = ENABLE_Pin;
	Stepper_Driver1.driver_step = 800;
	Driver_set_power(&Stepper_Driver1, DRIVER_ENABLE); 
	//-------------------------------------------------
	
	
	/*--- COFIGURATION FOR STEPPER DRIVER 2 ---*/
	//-------------------------------------------------
	Stepper_Driver2.DIR_PORT = DIR_2_GPIO_Port;
	Stepper_Driver2.DIR_PIN = DIR_2_Pin;
	Stepper_Driver2.PULSE_PORT = PULSE_2_GPIO_Port;
	Stepper_Driver2.PULSE_PIN = PULSE_2_Pin;
	Stepper_Driver2.ENA_PORT = ENABLE_GPIO_Port;
	Stepper_Driver2.ENA_PIN = ENABLE_Pin;
	Stepper_Driver2.driver_step = 800;
	Driver_set_power(&Stepper_Driver2, DRIVER_ENABLE);
	//-------------------------------------------------
	
	
	/*--- COFIGURATION FOR STEPPER DRIVER 3 ---*/
	//-------------------------------------------------
	Stepper_Driver3.DIR_PORT = DIR_3_GPIO_Port;
	Stepper_Driver3.DIR_PIN = DIR_3_Pin;
	Stepper_Driver3.PULSE_PORT = PULSE_3_GPIO_Port;
	Stepper_Driver3.PULSE_PIN = PULSE_3_Pin;
	Stepper_Driver3.ENA_PORT = ENABLE_GPIO_Port;
	Stepper_Driver3.ENA_PIN = ENABLE_Pin;
	Stepper_Driver3.driver_step = 800;
	Driver_set_power(&Stepper_Driver3, DRIVER_ENABLE);
	//-------------------------------------------------
	
	
	/*--- COFIGURATION FOR STEPPER DRIVER 4 ---*/
	//-------------------------------------------------
	Stepper_Driver4.DIR_PORT = DIR_4_GPIO_Port;
	Stepper_Driver4.DIR_PIN = DIR_4_Pin;
	Stepper_Driver4.PULSE_PORT = PULSE_4_GPIO_Port;
	Stepper_Driver4.PULSE_PIN = PULSE_4_Pin;
	Stepper_Driver4.ENA_PORT = ENABLE_GPIO_Port;
	Stepper_Driver4.ENA_PIN = ENABLE_Pin;
	Stepper_Driver4.driver_step = 800;
	Driver_set_power(&Stepper_Driver4, DRIVER_ENABLE);
	//-------------------------------------------------
	
	
	/*--- COFIGURATION FOR STEPPER DRIVER 5 ---*/
	//-------------------------------------------------
	Stepper_Driver5.DIR_PORT = DIR_5_GPIO_Port;
	Stepper_Driver5.DIR_PIN = DIR_5_Pin;
	Stepper_Driver5.PULSE_PORT = PULSE_5_GPIO_Port;
	Stepper_Driver5.PULSE_PIN = PULSE_5_Pin;
	Stepper_Driver5.ENA_PORT = ENABLE_GPIO_Port;
	Stepper_Driver5.ENA_PIN = ENABLE_Pin;
	Stepper_Driver5.driver_step = 800;
	Driver_set_power(&Stepper_Driver5, DRIVER_ENABLE);
	//-------------------------------------------------
	
	
	/*--- COFIGURATION FOR STEPPER DRIVER 6 ---*/
	//-------------------------------------------------
	Stepper_Driver6.DIR_PORT = DIR_6_GPIO_Port;
	Stepper_Driver6.DIR_PIN = DIR_6_Pin;
	Stepper_Driver6.PULSE_PORT = PULSE_6_GPIO_Port;
	Stepper_Driver6.PULSE_PIN = PULSE_6_Pin;
	Stepper_Driver6.ENA_PORT = ENABLE_GPIO_Port;
	Stepper_Driver6.ENA_PIN = ENABLE_Pin;
	Stepper_Driver6.driver_step = 800;
	Driver_set_power(&Stepper_Driver6, DRIVER_ENABLE);
	//-------------------------------------------------
	#endif
	
  /* USER CODE END 1 */

  /* MCU Configuration--------------------------------------------------------*/

  /* Reset of all peripherals, Initializes the Flash interface and the Systick. */
  HAL_Init();

  /* Configure the system clock */
  SystemClock_Config();

  /* Initialize all configured peripherals */
  MX_GPIO_Init();
  MX_DMA_Init();
  MX_USART1_UART_Init();
  MX_I2C1_Init();
  MX_SPI1_Init();
  MX_FATFS_Init();
  MX_TIM2_Init();
  MX_TIM3_Init();
  /* USER CODE BEGIN 2 */
	
	/*EEPROM CONFIGURATION*/
	#ifdef USE_EEPROM
	EEPROM_Init(&hi2c1, &eeprom1, MEM_SIZE_512Kb, EEPROM1_ADDRESS);
	EEPROM_Init(&hi2c1, &eeprom2, MEM_SIZE_512Kb, EEPROM2_ADDRESS);
	#endif
	
	
	/*RS232 COM CONFIGURATION*/
	#ifdef USE_RS232
	RS232_Init(&huart1);
	Start_get_command();
	#endif
	
	
	/*OLED CONFIGURATION*/
	#ifdef USE_OLED
	SSD1306_Init ();
	HAL_TIM_Base_Start_IT(&htim3);
	#endif
	
	
	/*ENCODER CONFIGURATION*/
	#ifdef USE_ENCODER
	
	#endif
	
	
	/*EEPROM TEST*/
	#ifdef EEPROM_TEST
//	for(int i=0; i<512; i++){
//		EEPROM_PageReset(&eeprom1, i);
//		HAL_Delay(50);
//	}
	
	double 
	test_pos_start[3] = {-40.96, 12.15, -37.42},
	test_pos_end[3] = {-20.96, 2.15, -37.42},
	test_angle_start[6] = {70.55, -45.5, 90.58, 150.45, 55.17, 178.77},
	test_angle_end[6] = {60, -20, 70.25, 115.62, 66.18, 122.76};
	
	Save_WeldingPoint_Position(0x00, SP_POS_BYTE_ADDR, test_pos_start, sizeof(test_pos_start));
	Save_WeldingPoint_Position(0x00, EP_POS_BYTE_ADDR, test_pos_end, sizeof(test_pos_end));
	Save_WeldingPoint_Angle(0x00, SP_ANG_BYTE_ADDR, test_angle_start, sizeof(test_angle_start));
	Save_WeldingPoint_Angle(0x00, EP_ANG_BYTE_ADDR, test_angle_end, sizeof(test_angle_end));
	Save_WeldingPoint_Pattern(0x00, LINEAR_PATTERN);
	HAL_Delay(500);
	Read_WeldingPoint_Position(0x00, SP_POS_BYTE_ADDR, array_pos_start, sizeof(array_pos_start));
	Read_WeldingPoint_Position(0x00, EP_POS_BYTE_ADDR, array_pos_end, sizeof(array_pos_end));
	Read_WeldingPoint_Angle(0x00, SP_ANG_BYTE_ADDR, array_ang_start, sizeof(array_ang_start));
	Read_WeldingPoint_Angle(0x00, EP_ANG_BYTE_ADDR, array_ang_end, sizeof(array_ang_end));
	Read_WeldingPoint_Pattern(0x00, welding_pattern);
	HAL_Delay(500);
	Read_All_WeldingDataBuyte(0x00);
  #endif
  /* USER CODE END 2 */

  /* Infinite loop */
  /* USER CODE BEGIN WHILE */
  while (1)
  {
		#ifdef RS232_TEST
//		for(int i=0; i<6; i++){
//			if(i<3) current_position[i] = test_pos_start[i] + move_position[i];
//			current_angle[i]  = test_angle_start[i] + move_angle[i];
//		}
		
		if(command.type == AUTO_HOME){
			HAL_GPIO_WritePin(LED_GPIO_Port, LED_Pin, GPIO_PIN_SET);
		}
		
		else if(command.type == MAPPING){
			
		}
		
		else if(command.type == PREVIEW){
			
		}
		
		else if(command.type == MOVE){
			if(command.control_mode == CARTESIAN_CTRL){
				move_position[command.move_variable-1] = command.move_value;
			}
			
			else if(command.control_mode == JOINT_CTRL){
				move_angle[command.move_variable-4] = command.move_value;
			}
		}
		
		else if(command.type == RUN){
		}
		
		else if(command.type == REQ_DATA){
			HAL_GPIO_WritePin(LED_GPIO_Port, LED_Pin, GPIO_PIN_SET);
			Send_requested_data(current_position, current_angle, current_point, NOT_SET, current_speed); 
		}
		
		else if(command.type == SEND_REQ){
		}
		
		else if(command.type == MOTOR_STATE){
		}
		
		else if(command.type == WELDER_STATE){
		}
		
		else if(command.type == FEEDBACK){
		}
		
		else if(command.type == NONE){
		}
		
		else HAL_GPIO_WritePin(LED_GPIO_Port, LED_Pin, GPIO_PIN_RESET);
		#endif
		
		#ifdef OLED_TEST
		selected_menu = MENU1;
		#endif
    /* USER CODE END WHILE */

    /* USER CODE BEGIN 3 */
  }
  /* USER CODE END 3 */
}

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
/* USER CODE BEGIN 4 */

/*--- SAVE WELDING POINT POSITION VALUE ---*/
//---------------------------------------------------------------------------------------------------------------------------------------------------------------------------------
void Save_WeldingPoint_Position(uint16_t welding_point, uint8_t start_addr, double* pos_data, size_t size){
	for(int i=0; i<24; i++) saved_pos[i] = 0;
	for(size_t i=0; i<size; i++) memcpy(&saved_pos[i*8], &pos_data[i], sizeof(double));
	
	EEPROM_PageWrite(&eeprom1, welding_point, start_addr, saved_pos, sizeof(saved_pos));
	HAL_Delay(10);
}
//---------------------------------------------------------------------------------------------------------------------------------------------------------------------------------


/*--- READ WELDING POINT POSITION VALUE ---*/
//---------------------------------------------------------------------------------------------------------------------------------------------------------------------------------
void Read_WeldingPoint_Position(uint16_t welding_point, uint8_t start_addr, double* stored_data, size_t size){
	for(int i=0; i<24; i++) read_saved_pos[i] = 0;
	for(size_t i=0; i<size; i++) stored_data[i] = 0;
	
	EEPROM_PageRead(&eeprom1, welding_point, start_addr, read_saved_pos, sizeof(read_saved_pos));
	
	for(int i=0; i<8; i++){
		read_saved_posX[i] = read_saved_pos[i];
		read_saved_posY[i] = read_saved_pos[i+8];
		read_saved_posZ[i] = read_saved_pos[i+16];
	}
	
	memcpy(&stored_data[0], read_saved_posX, sizeof(double));
	memcpy(&stored_data[1], read_saved_posY, sizeof(double));
	memcpy(&stored_data[2], read_saved_posZ, sizeof(double));
	HAL_Delay(10);
}
//---------------------------------------------------------------------------------------------------------------------------------------------------------------------------------


/*--- SAVE WELDING POINT ANGLE VALUE ---*/
//---------------------------------------------------------------------------------------------------------------------------------------------------------------------------------
void Save_WeldingPoint_Angle(uint16_t welding_point, uint8_t start_addr, double* angle_data, size_t size){
	for(int i=0; i<48; i++) saved_angle[i] = 0;
	for(size_t i=0; i<size; i++) memcpy(&saved_angle[i*8], &angle_data[i], sizeof(double));
	
	EEPROM_PageWrite(&eeprom1, welding_point, start_addr, saved_angle, sizeof(saved_angle));
	HAL_Delay(10);
}
//---------------------------------------------------------------------------------------------------------------------------------------------------------------------------------


/*--- SAVE WELDING POINT ANGLE VALUE ---*/
//---------------------------------------------------------------------------------------------------------------------------------------------------------------------------------
void Read_WeldingPoint_Angle(uint16_t welding_point, uint8_t start_addr, double* stored_data, size_t size){
	for(int i=0; i<48; i++) read_saved_angle[i] = 0;
	for(size_t i=0; i<size; i++) stored_data[i] = 0;
	
	EEPROM_PageRead(&eeprom1, welding_point, start_addr, read_saved_angle, sizeof(read_saved_angle));
	
	for(int i=0; i<8; i++){
		read_saved_angle1[i] = read_saved_angle[i];
		read_saved_angle2[i] = read_saved_angle[i+8];
		read_saved_angle3[i] = read_saved_angle[i+16];
		read_saved_angle4[i] = read_saved_angle[i+24];
		read_saved_angle5[i] = read_saved_angle[i+32];
		read_saved_angle6[i] = read_saved_angle[i+40];
	}
	
	memcpy(&stored_data[0], read_saved_angle1, sizeof(double));
	memcpy(&stored_data[1], read_saved_angle2, sizeof(double));
	memcpy(&stored_data[2], read_saved_angle3, sizeof(double));
	memcpy(&stored_data[3], read_saved_angle4, sizeof(double));
	memcpy(&stored_data[4], read_saved_angle5, sizeof(double));
	memcpy(&stored_data[5], read_saved_angle6, sizeof(double));
	HAL_Delay(10);
}
//---------------------------------------------------------------------------------------------------------------------------------------------------------------------------------


/*--- SAVE WELDING POINT PATTERN ---*/
//---------------------------------------------------------------------------------------------------------------------------------------------------------------------------------
void Save_WeldingPoint_Pattern(uint16_t welding_point, uint8_t select_pattern){
	EEPROM_ByteWrite(&eeprom1, welding_point, PATTERN_BYTE_ADDR, select_pattern, sizeof(select_pattern));
}
//---------------------------------------------------------------------------------------------------------------------------------------------------------------------------------


/*--- READ WELDING POINT PATTERN ---*/
//---------------------------------------------------------------------------------------------------------------------------------------------------------------------------------
void Read_WeldingPoint_Pattern(uint16_t welding_point, uint8_t store_pattern){
	EEPROM_ByteRead(&eeprom1, welding_point, PATTERN_BYTE_ADDR, read_saved_pattern, sizeof(store_pattern));
	welding_pattern = read_saved_pattern[0]; 
}
//---------------------------------------------------------------------------------------------------------------------------------------------------------------------------------


/*--- READ ALL WELDING POINT DATA IN BYTE ---*/
//---------------------------------------------------------------------------------------------------------------------------------------------------------------------------------
void Read_All_WeldingDataBuyte(uint16_t welding_point){
	EEPROM_PageRead(&eeprom1, welding_point, 0x00, page_data_byte, sizeof(page_data_byte));
}
//---------------------------------------------------------------------------------------------------------------------------------------------------------------------------------


/*--- CHECK EEPROM FREE WLEDING POINT ---*/
//---------------------------------------------------------------------------------------------------------------------------------------------------------------------------------
uint16_t Check_Free_WeldingPoint(void){
	return 0;
}
//---------------------------------------------------------------------------------------------------------------------------------------------------------------------------------


/*--- SHOW OLED MENU FUNCTION*/
//---------------------------------------------------------------------------------------------------------------------------------------------------------------------------------
void Show_Menu(Oled_Menu_t sel_menu){
	if(sel_menu == MENU1){
		SSD1306_GotoXY(18,10);
		SSD1306_Puts (title, &Font_7x10, SSD1306_COLOR_WHITE);
		
		SSD1306_GotoXY(48,25);
		SSD1306_Puts("RS232", &Font_7x10, SSD1306_COLOR_WHITE);
		
		SSD1306_GotoXY(0,50);
		SSD1306_Puts("State:", &Font_7x10, SSD1306_COLOR_WHITE);
		
		SSD1306_GotoXY(45,50);
		if(RS232_state == 0x00) SSD1306_Puts("reset", &Font_7x10, SSD1306_COLOR_WHITE);
		else if(RS232_state == 0x20) SSD1306_Puts("ready", &Font_7x10, SSD1306_COLOR_WHITE);
		else if(RS232_state == 0x24) SSD1306_Puts("busy", &Font_7x10, SSD1306_COLOR_WHITE);
		else if(RS232_state == 0x21) SSD1306_Puts("busy tx", &Font_7x10, SSD1306_COLOR_WHITE);
		else if(RS232_state == 0x22) SSD1306_Puts("busy rx", &Font_7x10, SSD1306_COLOR_WHITE);
		else if(RS232_state == 0x23) SSD1306_Puts("busy all", &Font_7x10, SSD1306_COLOR_WHITE);
		else if(RS232_state == 0xA0) SSD1306_Puts("timeout", &Font_7x10, SSD1306_COLOR_WHITE);
		else if(RS232_state == 0xE0) SSD1306_Puts("error", &Font_7x10, SSD1306_COLOR_WHITE);
		
		SSD1306_UpdateScreen();
	}
}
//---------------------------------------------------------------------------------------------------------------------------------------------------------------------------------

/* USER CODE END 4 */
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
