AlfonsusGiovanni/Welding-Arm-Manipulator/Referensi/AR4 6DOF Manipulator/AR4_teensy41_sketch_v4.4/AR4_teensy41_sketch_v4.4.ino

//VERSION 4.4

/*  AR4 - Stepper motor robot control software
    Copyright (c) 2023, Chris Annin
    All rights reserved.

    You are free to share, copy and redistribute in any medium
    or format.  You are free to remix, transform and build upon
    this material.

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
    THIS SOFTWARE IS PROVIDED BY THE COPYRIGHT HOLDERS AND CONTRIBUTORS "AS IS" AND
    ANY EXPRESS OR IMPLIED WARRANTIES, INCLUDING, BUT NOT LIMITED TO, THE IMPLIED
    WARRANTIES OF MERCHANTABILITY AND FITNESS FOR A PARTICULAR PURPOSE ARE
    DISCLAIMED. IN NO EVENT SHALL CHRIS ANNIN BE LIABLE FOR ANY
    DIRECT, INDIRECT, INCIDENTAL, SPECIAL, EXEMPLARY, OR CONSEQUENTIAL DAMAGES
    (INCLUDING, BUT NOT LIMITED TO, PROCUREMENT OF SUBSTITUTE GOODS OR SERVICES;
    LOSS OF USE, DATA, OR PROFITS; OR BUSINESS INTERRUPTION) HOWEVER CAUSED AND
    ON ANY THEORY OF LIABILITY, WHETHER IN CONTRACT, STRICT LIABILITY, OR TORT
    (INCLUDING NEGLIGENCE OR OTHERWISE) ARISING IN ANY WAY OUT OF THE USE OF THIS
    SOFTWARE, EVEN IF ADVISED OF THE POSSIBILITY OF SUCH DAMAGE.

    chris.annin@gmail.com

*/


// VERSION LOG
// 1.0 - 2/6/21 - initial release
// 1.1 - 2/20/21 - bug fix, calibration offset on negative axis calibration direction axis 2,4,5
// 2.0 - 10/1/22 - added lookahead and spline functionality
// 2.2 - 11/6/22 - added Move V for open cv integrated vision
// 3.0 - 2/3/23 - open loop bypass moved to teensy board / add external axis 8 & 9 / bug fix live jog drift
// 3.1 - 5/10/23 - gcode initial
// 3.2 - 5/12/23 - remove RoboDK kinematics
// 3.3 - 6/4/23 - update geometric kinematics
// 4.0 - 11/5/23 - .txt .ar4 extension, gcode tab, kinematics tab. Initial MK2 release.
// 4.1 - 11/23/23 - bug fix added - R06_neg_matrix[2][3] = -DHparams[5][2]; added to UPdate CMD & GCC diagnostic
// 4.2 - 1/12/24 - bug fix - step direction delay
// 4.3 - 1/21/24 - Gcode to SD card.  Estop button interrupt.
// 4.3.1 - 2/1/24 bug fix - vision snap and find drop down
// 4.4

#include <math.h>
#include <limits>
#include <avr/pgmspace.h>
#include <Encoder.h>
#include <SPI.h>
#include <SD.h>
#include <stdexcept>
#pragma GCC diagnostic ignored "-Warray-bounds"
#pragma GCC diagnostic ignored "-Wunused-variable"
#pragma GCC diagnostic ignored "-Wsequence-point"
#pragma GCC diagnostic ignored "-Wunused-value"
#pragma GCC diagnostic ignored "-Wunused-but-set-variable"
#pragma GCC diagnostic ignored "-Wmaybe-uninitialized"
#pragma GCC diagnostic ignored "-Waddress"

String cmdBuffer1;
String cmdBuffer2;
String cmdBuffer3;
String inData;
String recData;
String checkData;
String function;
volatile byte state = LOW;

bool containsNullByte(float value) {
  const unsigned char* bytes = reinterpret_cast<const unsigned char*>(&value);
  for (size_t i = 0; i < sizeof(float); ++i) {
    if (bytes[i] == 0x00) {
      return true;
    }
  }
  return false;
}

bool isValidResult(float value) {
  // Check for NaN or Inf, which are typical results of invalid operations
  return !std::isnan(value) && !std::isinf(value);
}

const int J1stepPin = 0;
const int J1dirPin = 1;
const int J2stepPin = 2;
const int J2dirPin = 3;
const int J3stepPin = 4;
const int J3dirPin = 5;
const int J4stepPin = 6;
const int J4dirPin = 7;
const int J5stepPin = 8;
const int J5dirPin = 9;
const int J6stepPin = 10;
const int J6dirPin = 11;
const int J7stepPin = 12;
const int J7dirPin = 13;
const int J8stepPin = 32;
const int J8dirPin = 33;
const int J9stepPin = 34;
const int J9dirPin = 35;

const int J1calPin = 26;
const int J2calPin = 27;
const int J3calPin = 28;
const int J4calPin = 29;
const int J5calPin = 30;
const int J6calPin = 31;
const int J7calPin = 36;
const int J8calPin = 37;
const int J9calPin = 38;

const int EstopPin = 39;

const int Output40 = 40;
const int Output41 = 41;


//set encoder multiplier
float J1encMult = 10;
float J2encMult = 10;
float J3encMult = 10;
float J4encMult = 10;
float J5encMult = 5;
float J6encMult = 10;

//set encoder pins
Encoder J1encPos(14, 15);
Encoder J2encPos(17, 16);
Encoder J3encPos(19, 18);
Encoder J4encPos(20, 21);
Encoder J5encPos(23, 22);
Encoder J6encPos(24, 25);

// GLOBAL VARS //

//define axis limits in degrees
float J1axisLimPos = 170;
float J1axisLimNeg = 170;
float J2axisLimPos = 90;
float J2axisLimNeg = 42;
float J3axisLimPos = 52;
float J3axisLimNeg = 89;
float J4axisLimPos = 165;
float J4axisLimNeg = 165;
float J5axisLimPos = 105;
float J5axisLimNeg = 105;
float J6axisLimPos = 155;
float J6axisLimNeg = 155;
float J7axisLimPos = 3450;
float J7axisLimNeg = 0;
float J8axisLimPos = 3450;
float J8axisLimNeg = 0;
float J9axisLimPos = 3450;
float J9axisLimNeg = 0;

int J1MotDir = 0;
int J2MotDir = 1;
int J3MotDir = 1;
int J4MotDir = 1;
int J5MotDir = 1;
int J6MotDir = 1;
int J7MotDir = 1;
int J8MotDir = 1;
int J9MotDir = 1;

int J1CalDir = 1;
int J2CalDir = 0;
int J3CalDir = 1;
int J4CalDir = 0;
int J5CalDir = 0;
int J6CalDir = 1;
int J7CalDir = 0;
int J8CalDir = 0;
int J9CalDir = 0;

//define total axis travel
float J1axisLim = J1axisLimPos + J1axisLimNeg;
float J2axisLim = J2axisLimPos + J2axisLimNeg;
float J3axisLim = J3axisLimPos + J3axisLimNeg;
float J4axisLim = J4axisLimPos + J4axisLimNeg;
float J5axisLim = J5axisLimPos + J5axisLimNeg;
float J6axisLim = J6axisLimPos + J6axisLimNeg;
float J7axisLim = J7axisLimPos + J7axisLimNeg;
float J8axisLim = J8axisLimPos + J8axisLimNeg;
float J9axisLim = J9axisLimPos + J9axisLimNeg;

//motor steps per degree
float J1StepDeg = 44.4444;
float J2StepDeg = 55.5555;
float J3StepDeg = 55.5555;
float J4StepDeg = 49.7777;
float J5StepDeg = 21.8602;
float J6StepDeg = 22.2222;
float J7StepDeg = 14.2857;
float J8StepDeg = 14.2857;
float J9StepDeg = 14.2857;

//steps full movement of each axis
int J1StepLim = J1axisLim * J1StepDeg;
int J2StepLim = J2axisLim * J2StepDeg;
int J3StepLim = J3axisLim * J3StepDeg;
int J4StepLim = J4axisLim * J4StepDeg;
int J5StepLim = J5axisLim * J5StepDeg;
int J6StepLim = J6axisLim * J6StepDeg;
int J7StepLim = J7axisLim * J7StepDeg;
int J8StepLim = J8axisLim * J8StepDeg;
int J9StepLim = J9axisLim * J9StepDeg;

//step and axis zero
int J1zeroStep = J1axisLimNeg * J1StepDeg;
int J2zeroStep = J2axisLimNeg * J2StepDeg;
int J3zeroStep = J3axisLimNeg * J3StepDeg;
int J4zeroStep = J4axisLimNeg * J4StepDeg;
int J5zeroStep = J5axisLimNeg * J5StepDeg;
int J6zeroStep = J6axisLimNeg * J6StepDeg;
int J7zeroStep = J7axisLimNeg * J7StepDeg;
int J8zeroStep = J8axisLimNeg * J8StepDeg;
int J9zeroStep = J9axisLimNeg * J9StepDeg;

//start master step count at Jzerostep
int J1StepM = J1zeroStep;
int J2StepM = J2zeroStep;
int J3StepM = J3zeroStep;
int J4StepM = J4zeroStep;
int J5StepM = J5zeroStep;
int J6StepM = J6zeroStep;
int J7StepM = J7zeroStep;
int J8StepM = J8zeroStep;
int J9StepM = J9zeroStep;



//degrees from limit switch to offset calibration
float J1calBaseOff = -1;
float J2calBaseOff = 1.5;
float J3calBaseOff = 4.1;
float J4calBaseOff = -2;
float J5calBaseOff = 3.1;
float J6calBaseOff = -.5;
float J7calBaseOff = 0;
float J8calBaseOff = 0;
float J9calBaseOff = 0;

//reset collision indicators
int J1collisionTrue = 0;
int J2collisionTrue = 0;
int J3collisionTrue = 0;
int J4collisionTrue = 0;
int J5collisionTrue = 0;
int J6collisionTrue = 0;
int TotalCollision = 0;
int KinematicError = 0;

float J7length;
float J7rot;
float J7steps;

float J8length;
float J8rot;
float J8steps;

float J9length;
float J9rot;
float J9steps;

float lineDist;

String WristCon;
int Quadrant;

unsigned long J1DebounceTime = 0;
unsigned long J2DebounceTime = 0;
unsigned long J3DebounceTime = 0;
unsigned long J4DebounceTime = 0;
unsigned long J5DebounceTime = 0;
unsigned long J6DebounceTime = 0;
unsigned long debounceDelay = 50;

String Alarm = "0";
String speedViolation = "0";
float minSpeedDelay = 500;
float maxMMperSec = 192;
float linWayDistSP = 1;
String debug = "";
String flag = "";
const int TRACKrotdir = 0;
float JogStepInc = .5;

int J1EncSteps;
int J2EncSteps;
int J3EncSteps;
int J4EncSteps;
int J5EncSteps;
int J6EncSteps;

int J1LoopMode;
int J2LoopMode;
int J3LoopMode;
int J4LoopMode;
int J5LoopMode;
int J6LoopMode;

#define ROBOT_nDOFs 6

//declare in out vars
float xyzuvw_Out[ROBOT_nDOFs];
float xyzuvw_In[ROBOT_nDOFs];
float xyzuvw_Temp[ROBOT_nDOFs];

float JangleOut[ROBOT_nDOFs];
float JangleIn[ROBOT_nDOFs];

//external axis
float J7_pos;
float J8_pos;
float J9_pos;

float J7_In;
float J8_In;
float J9_In;

#define Table_Size 6
typedef float Matrix4x4[16];
typedef float tRobot[66];

float pose[16];

String moveSequence;

//define rounding vars
float rndArcStart[6];
float rndArcMid[6];
float rndArcEnd[6];
float rndCalcCen[6];
String rndData;
bool rndTrue;
float rndSpeed;
bool splineTrue;
bool splineEndReceived;
bool estopActive;

float Xtool = 0;
float Ytool = 0;
float Ztool = 0;
float RZtool = 0;
float RYtool = 0;
float RXtool = 0;



//DENAVIT HARTENBERG PARAMETERS

float DHparams[6][4] = {
  { 0, -90, 169.77, 64.2 },
  { -90, 0, 0, 305 },
  { 180, 90, 0, -.0001 },
  { 0, -90, 222.63, 0 },
  { 0, 90, 0, 0 },
  { 0, 0, 36.25, 0 }
};


//DECLARE TOOL FRAME
float toolFrame[4][4];
float toolFrameRev[4][4];


//DECLARE R06 NEG FRAME

float R06_neg_matrix[4][4] = {
  { 1, 0, 0, 0 },
  { 0, 1, 0, 0 },
  { 0, 0, 1, -DHparams[5][2] },
  { 0, 0, 0, 1 }
};


//DECLARE JOINT MATRICES

float J1matrix[4][4];
float J2matrix[4][4];
float J3matrix[4][4];
float J4matrix[4][4];
float J5matrix[4][4];
float J6matrix[4][4];

float J1matrix_rev[4][4];
float J2matrix_rev[4][4];
float J3matrix_rev[4][4];

float R02matrix[4][4];
float R03matrix[4][4];
float R04matrix[4][4];
float R05matrix[4][4];
float R06matrix[4][4];
float R0Tmatrix[4][4];

float R02matrix_rev[4][4];
float R03matrix_rev[4][4];

float R0T_rev_matrix[4][4];
float InvtoolFrame[4][4];
float R06_rev_matrix[4][4];
float R05_rev_matrix[4][4];
float InvR03matrix_rev[4][4];
float R03_6matrix[4][4];


float blank[4][4];

/////////////////////////////////////////////////////////////////////////////////////////////////////////////////////////////////////////////////////////////////////////////////////////////
//CONSTRUCT TOOL MATRIX
/////////////////////////////////////////////////////////////////////////////////////////////////////////////////////////////////////////////////////////////////////////////////////////////

void Tool_Matrix(float Xval, float Yval, float Zval, float RZval, float RYval, float RXval) {
  toolFrame[0][0] = cos(radians(RZval)) * cos(radians(RYval));
  toolFrame[0][1] = cos(radians(RZval)) * sin(radians(RYval)) * sin(radians(RXval)) - sin(radians(RZval)) * cos(radians(RXval));
  toolFrame[0][2] = cos(radians(RZval)) * sin(radians(RYval)) * cos(radians(RXval)) + sin(radians(RZval)) * sin(radians(RXval));
  toolFrame[0][3] = (Xval);
  toolFrame[1][0] = sin(radians(RZval)) * cos(radians(RYval));
  toolFrame[1][1] = sin(radians(RZval)) * sin(radians(RYval)) * sin(radians(RXval)) + cos(radians(RZval)) * cos(radians(RXval));
  toolFrame[1][2] = sin(radians(RZval)) * sin(radians(RYval)) * cos(radians(RXval)) - cos(radians(RZval)) * sin(radians(RXval));
  toolFrame[1][3] = (Yval);
  toolFrame[2][0] = -sin(radians(RYval));
  toolFrame[2][1] = cos(radians(RYval)) * sin(radians(RXval));
  toolFrame[2][2] = cos(radians(RYval)) * cos(radians(RXval));
  toolFrame[2][3] = (Zval);
  toolFrame[3][0] = 0;
  toolFrame[3][1] = 0;
  toolFrame[3][2] = 0;
  toolFrame[3][3] = 1;
}

void Tool_MatrixRev(float Xval, float Yval, float Zval, float RZval, float RYval, float RXval) {
  toolFrameRev[0][0] = cos(radians(RZval)) * cos(radians(RYval));
  toolFrameRev[0][1] = cos(radians(RZval)) * sin(radians(RYval)) * sin(radians(RXval)) - sin(radians(RZval)) * cos(radians(RXval));
  toolFrameRev[0][2] = cos(radians(RZval)) * sin(radians(RYval)) * cos(radians(RXval)) + sin(radians(RZval)) * sin(radians(RXval));
  toolFrameRev[0][3] = -(Xval);
  toolFrameRev[1][0] = sin(radians(RZval)) * cos(radians(RYval));
  toolFrameRev[1][1] = sin(radians(RZval)) * sin(radians(RYval)) * sin(radians(RXval)) + cos(radians(RZval)) * cos(radians(RXval));
  toolFrameRev[1][2] = sin(radians(RZval)) * sin(radians(RYval)) * cos(radians(RXval)) - cos(radians(RZval)) * sin(radians(RXval));
  toolFrameRev[1][3] = -(Yval);
  toolFrameRev[2][0] = -sin(radians(RYval));
  toolFrameRev[2][1] = cos(radians(RYval)) * sin(radians(RXval));
  toolFrameRev[2][2] = cos(radians(RYval)) * cos(radians(RXval));
  toolFrameRev[2][3] = -(Zval);
  toolFrameRev[3][0] = 0;
  toolFrameRev[3][1] = 0;
  toolFrameRev[3][2] = 0;
  toolFrameRev[3][3] = 1;
}


/////////////////////////////////////////////////////////////////////////////////////////////////////////////////////////////////////////////////////////////////////////////////////////////
//CONSTRUCT DH MATRICES FORWARD KINEMATICS
/////////////////////////////////////////////////////////////////////////////////////////////////////////////////////////////////////////////////////////////////////////////////////////////


void DH_Matrices() {

  if (JangleIn[0] == 0) {
    JangleIn[0] = .0001;
  }
  if (JangleIn[1] == 0) {
    JangleIn[1] = .0001;
  }
  if (JangleIn[2] == 0) {
    JangleIn[2] = .0001;
  }
  if (JangleIn[3] == 0) {
    JangleIn[3] = .0001;
  }
  if (JangleIn[4] == 0) {
    JangleIn[4] = .0001;
  }
  if (JangleIn[5] == 0) {
    JangleIn[5] = .0001;
  }

  J1matrix[0][0] = cos(radians(JangleIn[0] + DHparams[0][0]));
  J1matrix[0][1] = -sin(radians(JangleIn[0] + DHparams[0][0])) * cos(radians(DHparams[0][1]));
  J1matrix[0][2] = sin(radians(JangleIn[0] + DHparams[0][0])) * sin(radians(DHparams[0][1]));
  J1matrix[0][3] = DHparams[0][3] * cos(radians(JangleIn[0] + DHparams[0][0]));
  J1matrix[1][0] = sin(radians(JangleIn[0] + DHparams[0][0]));
  J1matrix[1][1] = cos(radians(JangleIn[0] + DHparams[0][0])) * cos(radians(DHparams[0][1]));
  J1matrix[1][2] = -cos(radians(JangleIn[0] + DHparams[0][0])) * sin(radians(DHparams[0][1]));
  J1matrix[1][3] = DHparams[0][3] * sin(radians(JangleIn[0] + DHparams[0][0]));
  J1matrix[2][0] = 0;
  J1matrix[2][1] = sin(radians(DHparams[0][1]));
  J1matrix[2][2] = cos(radians(DHparams[0][1]));
  J1matrix[2][3] = DHparams[0][2];
  J1matrix[3][0] = 0;
  J1matrix[3][1] = 0;
  J1matrix[3][2] = 0;
  J1matrix[3][3] = 1;

  J2matrix[0][0] = cos(radians(JangleIn[1] + DHparams[1][0]));
  J2matrix[0][1] = -sin(radians(JangleIn[1] + DHparams[1][0])) * cos(radians(DHparams[1][1]));
  J2matrix[0][2] = sin(radians(JangleIn[1] + DHparams[1][0])) * sin(radians(DHparams[1][1]));
  J2matrix[0][3] = DHparams[1][3] * cos(radians(JangleIn[1] + DHparams[1][0]));
  J2matrix[1][0] = sin(radians(JangleIn[1] + DHparams[1][0]));
  J2matrix[1][1] = cos(radians(JangleIn[1] + DHparams[1][0])) * cos(radians(DHparams[1][1]));
  J2matrix[1][2] = -cos(radians(JangleIn[1] + DHparams[1][0])) * sin(radians(DHparams[1][1]));
  J2matrix[1][3] = DHparams[1][3] * sin(radians(JangleIn[1] + DHparams[1][0]));
  J2matrix[2][0] = 0;
  J2matrix[2][1] = sin(radians(DHparams[1][1]));
  J2matrix[2][2] = cos(radians(DHparams[1][1]));
  J2matrix[2][3] = DHparams[1][2];
  J2matrix[3][0] = 0;
  J2matrix[3][1] = 0;
  J2matrix[3][2] = 0;
  J2matrix[3][3] = 1;

  J3matrix[0][0] = cos(radians(JangleIn[2] + DHparams[2][0]));
  J3matrix[0][1] = -sin(radians(JangleIn[2] + DHparams[2][0])) * cos(radians(DHparams[2][1]));
  J3matrix[0][2] = sin(radians(JangleIn[2] + DHparams[2][0])) * sin(radians(DHparams[2][1]));
  J3matrix[0][3] = DHparams[2][3] * cos(radians(JangleIn[2] + DHparams[2][0]));
  J3matrix[1][0] = sin(radians(JangleIn[2] + DHparams[2][0]));
  J3matrix[1][1] = cos(radians(JangleIn[2] + DHparams[2][0])) * cos(radians(DHparams[2][1]));
  J3matrix[1][2] = -cos(radians(JangleIn[2] + DHparams[2][0])) * sin(radians(DHparams[2][1]));
  J3matrix[1][3] = DHparams[2][3] * sin(radians(JangleIn[2] + DHparams[2][0]));
  J3matrix[2][0] = 0;
  J3matrix[2][1] = sin(radians(DHparams[2][1]));
  J3matrix[2][2] = cos(radians(DHparams[2][1]));
  J3matrix[2][3] = DHparams[2][2];
  J3matrix[3][0] = 0;
  J3matrix[3][1] = 0;
  J3matrix[3][2] = 0;
  J3matrix[3][3] = 1;

  J4matrix[0][0] = cos(radians(JangleIn[3] + DHparams[3][0]));
  J4matrix[0][1] = -sin(radians(JangleIn[3] + DHparams[3][0])) * cos(radians(DHparams[3][1]));
  J4matrix[0][2] = sin(radians(JangleIn[3] + DHparams[3][0])) * sin(radians(DHparams[3][1]));
  J4matrix[0][3] = DHparams[3][3] * cos(radians(JangleIn[3] + DHparams[3][0]));
  J4matrix[1][0] = sin(radians(JangleIn[3] + DHparams[3][0]));
  J4matrix[1][1] = cos(radians(JangleIn[3] + DHparams[3][0])) * cos(radians(DHparams[3][1]));
  J4matrix[1][2] = -cos(radians(JangleIn[3] + DHparams[3][0])) * sin(radians(DHparams[3][1]));
  J4matrix[1][3] = DHparams[3][3] * sin(radians(JangleIn[3] + DHparams[3][0]));
  J4matrix[2][0] = 0;
  J4matrix[2][1] = sin(radians(DHparams[3][1]));
  J4matrix[2][2] = cos(radians(DHparams[3][1]));
  J4matrix[2][3] = DHparams[3][2];
  J4matrix[3][0] = 0;
  J4matrix[3][1] = 0;
  J4matrix[3][2] = 0;
  J4matrix[3][3] = 1;

  J5matrix[0][0] = cos(radians(JangleIn[4] + DHparams[4][0]));
  J5matrix[0][1] = -sin(radians(JangleIn[4] + DHparams[4][0])) * cos(radians(DHparams[4][1]));
  J5matrix[0][2] = sin(radians(JangleIn[4] + DHparams[4][0])) * sin(radians(DHparams[4][1]));
  J5matrix[0][3] = DHparams[4][3] * cos(radians(JangleIn[4] + DHparams[4][0]));
  J5matrix[1][0] = sin(radians(JangleIn[4] + DHparams[4][0]));
  J5matrix[1][1] = cos(radians(JangleIn[4] + DHparams[4][0])) * cos(radians(DHparams[4][1]));
  J5matrix[1][2] = -cos(radians(JangleIn[4] + DHparams[4][0])) * sin(radians(DHparams[4][1]));
  J5matrix[1][3] = DHparams[4][3] * sin(radians(JangleIn[4] + DHparams[4][0]));
  J5matrix[2][0] = 0;
  J5matrix[2][1] = sin(radians(DHparams[4][1]));
  J5matrix[2][2] = cos(radians(DHparams[4][1]));
  J5matrix[2][3] = DHparams[4][2];
  J5matrix[3][0] = 0;
  J5matrix[3][1] = 0;
  J5matrix[3][2] = 0;
  J5matrix[3][3] = 1;

  J6matrix[0][0] = cos(radians(JangleIn[5] + DHparams[5][0]));
  J6matrix[0][1] = -sin(radians(JangleIn[5] + DHparams[5][0])) * cos(radians(DHparams[5][1]));
  J6matrix[0][2] = sin(radians(JangleIn[5] + DHparams[5][0])) * sin(radians(DHparams[5][1]));
  J6matrix[0][3] = DHparams[5][3] * cos(radians(JangleIn[5] + DHparams[5][0]));
  J6matrix[1][0] = sin(radians(JangleIn[5] + DHparams[5][0]));
  J6matrix[1][1] = cos(radians(JangleIn[5] + DHparams[5][0])) * cos(radians(DHparams[5][1]));
  J6matrix[1][2] = -cos(radians(JangleIn[5] + DHparams[5][0])) * sin(radians(DHparams[5][1]));
  J6matrix[1][3] = DHparams[5][3] * sin(radians(JangleIn[5] + DHparams[5][0]));
  J6matrix[2][0] = 0;
  J6matrix[2][1] = sin(radians(DHparams[5][1]));
  J6matrix[2][2] = cos(radians(DHparams[5][1]));
  J6matrix[2][3] = DHparams[5][2];
  J6matrix[3][0] = 0;
  J6matrix[3][1] = 0;
  J6matrix[3][2] = 0;
  J6matrix[3][3] = 1;
}


/////////////////////////////////////////////////////////////////////////////////////////////////////////////////////////////////////////////////////////////////////////////////////////////
//CONSTRUCT ROTATION MATRICES FORWARD KINEMATICS
/////////////////////////////////////////////////////////////////////////////////////////////////////////////////////////////////////////////////////////////////////////////////////////////

void FwdMatrices() {

  int i, j, k = 0;

  for (int j = 0; j < 4; j++) {
    for (int i = 0; i < 4; i++) {
      R02matrix[j][i] = 0;
    }
  }
  for (int j = 0; j < 4; j++) {
    for (int i = 0; i < 4; i++) {
      R03matrix[j][i] = 0;
    }
  }
  for (int j = 0; j < 4; j++) {
    for (int i = 0; i < 4; i++) {
      R04matrix[j][i] = 0;
    }
  }
  for (int j = 0; j < 4; j++) {
    for (int i = 0; i < 4; i++) {
      R05matrix[j][i] = 0;
    }
  }
  for (int j = 0; j < 4; j++) {
    for (int i = 0; i < 4; i++) {
      R06matrix[j][i] = 0;
    }
  }
  for (int j = 0; j < 4; j++) {
    for (int i = 0; i < 4; i++) {
      R0Tmatrix[j][i] = 0;
    }
  }

  for (int k = 0; k < 4; k++) {
    for (int i = 0; i < 4; i++) {
      for (int j = 0; j < 4; j++) {
        R02matrix[k][i] = R02matrix[k][i] + (J1matrix[k][j] * J2matrix[j][i]);
      }
    }
  }
  for (int k = 0; k < 4; k++) {
    for (int i = 0; i < 4; i++) {
      for (int j = 0; j < 4; j++) {
        R03matrix[k][i] = R03matrix[k][i] + (R02matrix[k][j] * J3matrix[j][i]);
      }
    }
  }
  for (int k = 0; k < 4; k++) {
    for (int i = 0; i < 4; i++) {
      for (int j = 0; j < 4; j++) {
        R04matrix[k][i] = R04matrix[k][i] + (R03matrix[k][j] * J4matrix[j][i]);
      }
    }
  }
  for (int k = 0; k < 4; k++) {
    for (int i = 0; i < 4; i++) {
      for (int j = 0; j < 4; j++) {
        R05matrix[k][i] = R05matrix[k][i] + (R04matrix[k][j] * J5matrix[j][i]);
      }
    }
  }
  for (int k = 0; k < 4; k++) {
    for (int i = 0; i < 4; i++) {
      for (int j = 0; j < 4; j++) {
        R06matrix[k][i] = R06matrix[k][i] + (R05matrix[k][j] * J6matrix[j][i]);
      }
    }
  }
  for (int k = 0; k < 4; k++) {
    for (int i = 0; i < 4; i++) {
      for (int j = 0; j < 4; j++) {
        R0Tmatrix[k][i] = R0Tmatrix[k][i] + (R06matrix[k][j] * toolFrame[j][i]);
      }
    }
  }
}



void SolveFowardKinematic() {
  DH_Matrices();
  FwdMatrices();
  xyzuvw_Out[0] = R0Tmatrix[0][3];
  xyzuvw_Out[1] = R0Tmatrix[1][3];
  xyzuvw_Out[2] = R0Tmatrix[2][3];
  xyzuvw_Out[4] = atan2(-R0Tmatrix[2][0], pow((pow(R0Tmatrix[2][1], 2) + pow(R0Tmatrix[2][2], 2)), 0.5));
  xyzuvw_Out[3] = degrees(atan2(R0Tmatrix[1][0] / cos(xyzuvw_Out[4]), R0Tmatrix[0][0] / cos(xyzuvw_Out[4])));
  xyzuvw_Out[5] = degrees(atan2(R0Tmatrix[2][1] / cos(xyzuvw_Out[4]), R0Tmatrix[2][2] / cos(xyzuvw_Out[4])));
  xyzuvw_Out[4] = degrees(xyzuvw_Out[4]);
}





/////////////////////////////////////////////////////////////////////////////////////////////////////////////////////////////////////////////////////////////////////////////////////////////
//REVERSE KINEMATICS
/////////////////////////////////////////////////////////////////////////////////////////////////////////////////////////////////////////////////////////////////////////////////////////////

void SolveInverseKinematic() {

  float pX;
  float pY;
  float pX_a1_fwd;
  float pX_a1_mid;
  float pa2H_fwd;
  float pa2H_mid;
  float pa3H;
  float thetaA_fwd;
  float thetaA_mid;
  float thetaB_fwd;
  float thetaB_mid;
  float thetaC_fwd;
  float thetaC_mid;
  float thetaD;
  float thetaE;

  float XatJ1zero;
  float YatJ1zero;
  float Length_1;
  float Length_2;
  float Length_3;
  float Length_4;
  float Theta_A;
  float Theta_B;
  float Theta_C;
  float Theta_D;
  float Theta_E;


  int i, j, k = 0;
  KinematicError = 0;

  //generate matrices for center of spherical wrist location

  R0T_rev_matrix[0][0] = cos(radians(xyzuvw_In[3])) * cos(radians(xyzuvw_In[4]));
  R0T_rev_matrix[0][1] = cos(radians(xyzuvw_In[3])) * sin(radians(xyzuvw_In[4])) * sin(radians(xyzuvw_In[5])) - sin(radians(xyzuvw_In[3])) * cos(radians(xyzuvw_In[5]));
  R0T_rev_matrix[0][2] = cos(radians(xyzuvw_In[3])) * sin(radians(xyzuvw_In[4])) * cos(radians(xyzuvw_In[5])) + sin(radians(xyzuvw_In[3])) * sin(radians(xyzuvw_In[5]));
  R0T_rev_matrix[0][3] = xyzuvw_In[0];
  R0T_rev_matrix[1][0] = sin(radians(xyzuvw_In[3])) * cos(radians(xyzuvw_In[4]));
  R0T_rev_matrix[1][1] = sin(radians(xyzuvw_In[3])) * sin(radians(xyzuvw_In[4])) * sin(radians(xyzuvw_In[5])) + cos(radians(xyzuvw_In[3])) * cos(radians(xyzuvw_In[5]));
  R0T_rev_matrix[1][2] = sin(radians(xyzuvw_In[3])) * sin(radians(xyzuvw_In[4])) * cos(radians(xyzuvw_In[5])) - cos(radians(xyzuvw_In[3])) * sin(radians(xyzuvw_In[5]));
  R0T_rev_matrix[1][3] = xyzuvw_In[1];
  R0T_rev_matrix[2][0] = -sin(radians(xyzuvw_In[4]));
  R0T_rev_matrix[2][1] = cos(radians(xyzuvw_In[4])) * sin(radians(xyzuvw_In[5]));
  R0T_rev_matrix[2][2] = cos(radians(xyzuvw_In[4])) * cos(radians(xyzuvw_In[5]));
  R0T_rev_matrix[2][3] = xyzuvw_In[2];
  R0T_rev_matrix[3][0] = 0;
  R0T_rev_matrix[3][1] = 0;
  R0T_rev_matrix[3][2] = 0;
  R0T_rev_matrix[3][3] = 1;

  InvtoolFrame[0][0] = toolFrameRev[0][0];
  InvtoolFrame[0][1] = toolFrameRev[1][0];
  InvtoolFrame[0][2] = toolFrameRev[2][0];
  InvtoolFrame[0][3] = (InvtoolFrame[0][0] * toolFrameRev[0][3]) + (InvtoolFrame[0][1] * toolFrameRev[1][3]) + (InvtoolFrame[0][2] * toolFrameRev[2][3]);
  InvtoolFrame[1][0] = toolFrameRev[0][1];
  InvtoolFrame[1][1] = toolFrameRev[1][1];
  InvtoolFrame[1][2] = toolFrameRev[2][1];
  InvtoolFrame[1][3] = (InvtoolFrame[1][0] * toolFrameRev[0][3]) + (InvtoolFrame[1][1] * toolFrameRev[1][3]) + (InvtoolFrame[1][2] * toolFrameRev[2][3]);
  InvtoolFrame[2][0] = toolFrameRev[0][2];
  InvtoolFrame[2][1] = toolFrameRev[1][2];
  InvtoolFrame[2][2] = toolFrameRev[2][2];
  InvtoolFrame[2][3] = (InvtoolFrame[2][0] * toolFrameRev[0][3]) + (InvtoolFrame[2][1] * toolFrameRev[1][3]) + (InvtoolFrame[2][2] * toolFrameRev[2][3]);
  InvtoolFrame[3][0] = 0;
  InvtoolFrame[3][1] = 0;
  InvtoolFrame[3][2] = 0;
  InvtoolFrame[3][3] = 1;

  for (int j = 0; j < 4; j++) {
    for (int i = 0; i < 4; i++) {
      R06_rev_matrix[j][i] = 0;
    }
  }

  for (int j = 0; j < 4; j++) {
    for (int i = 0; i < 4; i++) {
      R05_rev_matrix[j][i] = 0;
    }
  }

  for (int j = 0; j < 4; j++) {
    for (int i = 0; i < 4; i++) {
      R02matrix_rev[j][i] = 0;
    }
  }

  for (int j = 0; j < 4; j++) {
    for (int i = 0; i < 4; i++) {
      R03matrix_rev[j][i] = 0;
    }
  }

  for (int j = 0; j < 4; j++) {
    for (int i = 0; i < 4; i++) {
      R03_6matrix[j][i] = 0;
    }
  }

  for (int k = 0; k < 4; k++) {
    for (int i = 0; i < 4; i++) {
      for (int j = 0; j < 4; j++) {
        R06_rev_matrix[k][i] = R06_rev_matrix[k][i] + (R0T_rev_matrix[k][j] * InvtoolFrame[j][i]);
      }
    }
  }

  for (int k = 0; k < 4; k++) {
    for (int i = 0; i < 4; i++) {
      for (int j = 0; j < 4; j++) {
        R05_rev_matrix[k][i] = R05_rev_matrix[k][i] + (R06_rev_matrix[k][j] * R06_neg_matrix[j][i]);
      }
    }
  }

  //calc J1 angle

  if (R05_rev_matrix[0][3] >= 0 and R05_rev_matrix[1][3] > 0) {
    JangleOut[0] = degrees(atan(R05_rev_matrix[1][3] / R05_rev_matrix[0][3]));
  } else if (R05_rev_matrix[0][3] >= 0 and R05_rev_matrix[1][3] < 0) {
    JangleOut[0] = degrees(atan(R05_rev_matrix[1][3] / R05_rev_matrix[0][3]));
  } else if (R05_rev_matrix[0][3] < 0 and R05_rev_matrix[1][3] <= 0) {
    JangleOut[0] = -180 + degrees(atan(R05_rev_matrix[1][3] / R05_rev_matrix[0][3]));
  } else if (R05_rev_matrix[0][3] <= 0 and R05_rev_matrix[1][3] > 0) {
    JangleOut[0] = 180 + degrees(atan(R05_rev_matrix[1][3] / R05_rev_matrix[0][3]));
  }

  //calculate J2 & J3 geometry

  XatJ1zero = (R05_rev_matrix[0][3] * cos(radians(-JangleOut[0]))) - (R05_rev_matrix[1][3] * sin(radians(-JangleOut[0])));
  YatJ1zero = 0;

  Length_1 = abs(XatJ1zero - DHparams[0][3]);
  Length_2 = sqrt(pow((XatJ1zero - DHparams[0][3]), 2) + pow((YatJ1zero - YatJ1zero), 2) + pow((R05_rev_matrix[2][3] - DHparams[0][2]), 2));
  Length_3 = sqrt(pow(DHparams[3][2], 2) + pow(DHparams[2][3], 2));
  Length_4 = R05_rev_matrix[2][3] - DHparams[0][2];
  Theta_B = degrees(atan(Length_1 / Length_4));
  Theta_C = degrees(acos((pow(DHparams[1][3], 2) + pow(Length_2, 2) - pow(Length_3, 2)) / (2 * DHparams[1][3] * Length_2)));
  if (!isValidResult(Theta_C)) {
    KinematicError = 1;
  }
  Theta_D = degrees(acos((pow(Length_3, 2) + pow(DHparams[1][3], 2) - pow(Length_2, 2)) / (2 * Length_3 * DHparams[1][3])));
  if (!isValidResult(Theta_D)) {
    KinematicError = 1;
  }
  Theta_E = degrees(atan(DHparams[2][3] / DHparams[3][2]));

  // calc J2 angle

  if (XatJ1zero > DHparams[0][3]) {
    if (Length_4 > 0) {
      JangleOut[1] = Theta_B - Theta_C;
    } else {
      JangleOut[1] = Theta_B - Theta_C + 180;
    }
  } else {
    JangleOut[1] = -(Theta_B + Theta_C);
  }

  // calc J3 angle

  JangleOut[2] = -(Theta_D + Theta_E) + 90;


  // generate reverse matrices for wrist orientaion

  J1matrix_rev[0][0] = cos(radians(JangleOut[0] + DHparams[0][0]));
  J1matrix_rev[0][1] = -sin(radians(JangleOut[0] + DHparams[0][0])) * cos(radians(DHparams[0][1]));
  J1matrix_rev[0][2] = sin(radians(JangleOut[0] + DHparams[0][0])) * sin(radians(DHparams[0][1]));
  J1matrix_rev[0][3] = DHparams[0][3] * cos(radians(JangleOut[0] + DHparams[0][0]));
  J1matrix_rev[1][0] = sin(radians(JangleOut[0] + DHparams[0][0]));
  J1matrix_rev[1][1] = cos(radians(JangleOut[0] + DHparams[0][0])) * cos(radians(DHparams[0][1]));
  J1matrix_rev[1][2] = -cos(radians(JangleOut[0] + DHparams[0][0])) * sin(radians(DHparams[0][1]));
  J1matrix_rev[1][3] = DHparams[0][3] * sin(radians(JangleOut[0] + DHparams[0][0]));
  J1matrix_rev[2][0] = 0;
  J1matrix_rev[2][1] = sin(radians(DHparams[0][1]));
  J1matrix_rev[2][2] = cos(radians(DHparams[0][1]));
  J1matrix_rev[2][3] = DHparams[0][2];
  J1matrix_rev[3][0] = 0;
  J1matrix_rev[3][1] = 0;
  J1matrix_rev[3][2] = 0;
  J1matrix_rev[3][3] = 1;

  J2matrix_rev[0][0] = cos(radians(JangleOut[1] + DHparams[1][0]));
  J2matrix_rev[0][1] = -sin(radians(JangleOut[1] + DHparams[1][0])) * cos(radians(DHparams[1][1]));
  J2matrix_rev[0][2] = sin(radians(JangleOut[1] + DHparams[1][0])) * sin(radians(DHparams[1][1]));
  J2matrix_rev[0][3] = DHparams[1][3] * cos(radians(JangleOut[1] + DHparams[1][0]));
  J2matrix_rev[1][0] = sin(radians(JangleOut[1] + DHparams[1][0]));
  J2matrix_rev[1][1] = cos(radians(JangleOut[1] + DHparams[1][0])) * cos(radians(DHparams[1][1]));
  J2matrix_rev[1][2] = -cos(radians(JangleOut[1] + DHparams[1][0])) * sin(radians(DHparams[1][1]));
  J2matrix_rev[1][3] = DHparams[1][3] * sin(radians(JangleOut[1] + DHparams[1][0]));
  J2matrix_rev[2][0] = 0;
  J2matrix_rev[2][1] = sin(radians(DHparams[1][1]));
  J2matrix_rev[2][2] = cos(radians(DHparams[1][1]));
  J2matrix_rev[2][3] = DHparams[1][2];
  J2matrix_rev[3][0] = 0;
  J2matrix_rev[3][1] = 0;
  J2matrix_rev[3][2] = 0;
  J2matrix_rev[3][3] = 1;

  J3matrix_rev[0][0] = cos(radians(JangleOut[2] + DHparams[2][0]));
  J3matrix_rev[0][1] = -sin(radians(JangleOut[2] + DHparams[2][0])) * cos(radians(DHparams[2][1]));
  J3matrix_rev[0][2] = sin(radians(JangleOut[2] + DHparams[2][0])) * sin(radians(DHparams[2][1]));
  J3matrix_rev[0][3] = DHparams[2][3] * cos(radians(JangleOut[2] + DHparams[2][0]));
  J3matrix_rev[1][0] = sin(radians(JangleOut[2] + DHparams[2][0]));
  J3matrix_rev[1][1] = cos(radians(JangleOut[2] + DHparams[2][0])) * cos(radians(DHparams[2][1]));
  J3matrix_rev[1][2] = -cos(radians(JangleOut[2] + DHparams[2][0])) * sin(radians(DHparams[2][1]));
  J3matrix_rev[1][3] = DHparams[2][3] * sin(radians(JangleOut[2] + DHparams[2][0]));
  J3matrix_rev[2][0] = 0;
  J3matrix_rev[2][1] = sin(radians(DHparams[2][1]));
  J3matrix_rev[2][2] = cos(radians(DHparams[2][1]));
  J3matrix_rev[2][3] = DHparams[2][2];
  J3matrix_rev[3][0] = 0;
  J3matrix_rev[3][1] = 0;
  J3matrix_rev[3][2] = 0;
  J3matrix_rev[3][3] = 1;

  for (int k = 0; k < 4; k++) {
    for (int i = 0; i < 4; i++) {
      for (int j = 0; j < 4; j++) {
        R02matrix_rev[k][i] = R02matrix_rev[k][i] + (J1matrix_rev[k][j] * J2matrix_rev[j][i]);
      }
    }
  }
  for (int k = 0; k < 4; k++) {
    for (int i = 0; i < 4; i++) {
      for (int j = 0; j < 4; j++) {
        R03matrix_rev[k][i] = R03matrix_rev[k][i] + (R02matrix_rev[k][j] * J3matrix_rev[j][i]);
      }
    }
  }

  InvR03matrix_rev[0][0] = R03matrix_rev[0][0];
  InvR03matrix_rev[0][1] = R03matrix_rev[1][0];
  InvR03matrix_rev[0][2] = R03matrix_rev[2][0];
  InvR03matrix_rev[1][0] = R03matrix_rev[0][1];
  InvR03matrix_rev[1][1] = R03matrix_rev[1][1];
  InvR03matrix_rev[1][2] = R03matrix_rev[2][1];
  InvR03matrix_rev[2][0] = R03matrix_rev[0][2];
  InvR03matrix_rev[2][1] = R03matrix_rev[1][2];
  InvR03matrix_rev[2][2] = R03matrix_rev[2][2];

  for (int k = 0; k < 4; k++) {
    for (int i = 0; i < 4; i++) {
      for (int j = 0; j < 4; j++) {
        R03_6matrix[k][i] = R03_6matrix[k][i] + (InvR03matrix_rev[k][j] * R05_rev_matrix[j][i]);
      }
    }
  }

  //calculate J5 angle

  if (WristCon == "F") {
    JangleOut[4] = degrees(atan2(sqrt(1 - pow(R03_6matrix[2][2], 2)), R03_6matrix[2][2]));
  } else {
    JangleOut[4] = degrees(atan2(-sqrt(1 - pow(R03_6matrix[2][2], 2)), R03_6matrix[2][2]));
  }

  //calculate J4 angle

  if (JangleOut[4] < 0) {
    JangleOut[3] = -degrees(atan2(R03_6matrix[1][2], -R03_6matrix[0][2]));
  } else {
    JangleOut[3] = -degrees(atan2(-R03_6matrix[1][2], R03_6matrix[0][2]));
  }

  //calculate J6 angle

  if (JangleOut[4] < 0) {
    JangleOut[5] = degrees(atan2(-R03_6matrix[2][1], R03_6matrix[2][0]));
  } else {
    JangleOut[5] = degrees(atan2(R03_6matrix[2][1], -R03_6matrix[2][0]));
  }
}






/////////////////////////////////////////////////////////////////////////////////////////////////////////////////////////////////////////////////////////////////////////////////////////////
//CALCULATE POSITIONS
/////////////////////////////////////////////////////////////////////////////////////////////////////////////////////////////////////////////////////////////////////////////////////////////

void sendRobotPos() {

  updatePos();

  String sendPos = "A" + String(JangleIn[0], 3) + "B" + String(JangleIn[1], 3) + "C" + String(JangleIn[2], 3) + "D" + String(JangleIn[3], 3) + "E" + String(JangleIn[4], 3) + "F" + String(JangleIn[5], 3) + "G" + String(xyzuvw_Out[0], 3) + "H" + String(xyzuvw_Out[1], 3) + "I" + String(xyzuvw_Out[2], 3) + "J" + String(xyzuvw_Out[3], 3) + "K" + String(xyzuvw_Out[4], 3) + "L" + String(xyzuvw_Out[5], 3) + "M" + speedViolation + "N" + debug + "O" + flag + "P" + J7_pos + "Q" + J8_pos + "R" + J9_pos;
  delay(5);
  Serial.println(sendPos);
  speedViolation = "0";
  flag = "";
}

void sendRobotPosSpline() {

  updatePos();

  String sendPos = "A" + String(JangleIn[0], 3) + "B" + String(JangleIn[1], 3) + "C" + String(JangleIn[2], 3) + "D" + String(JangleIn[3], 3) + "E" + String(JangleIn[4], 3) + "F" + String(JangleIn[5], 3) + "G" + String(xyzuvw_Out[0], 3) + "H" + String(xyzuvw_Out[1], 3) + "I" + String(xyzuvw_Out[2], 3) + "J" + String(xyzuvw_Out[3], 3) + "K" + String(xyzuvw_Out[4], 3) + "L" + String(xyzuvw_Out[5], 3) + "M" + speedViolation + "N" + debug + "O" + flag + "P" + J7_pos + "Q" + J8_pos + "R" + J9_pos;
  delay(5);
  Serial.println(sendPos);
  speedViolation = "0";
}

void updatePos() {

  JangleIn[0] = (J1StepM - J1zeroStep) / J1StepDeg;
  JangleIn[1] = (J2StepM - J2zeroStep) / J2StepDeg;
  JangleIn[2] = (J3StepM - J3zeroStep) / J3StepDeg;
  JangleIn[3] = (J4StepM - J4zeroStep) / J4StepDeg;
  JangleIn[4] = (J5StepM - J5zeroStep) / J5StepDeg;
  JangleIn[5] = (J6StepM - J6zeroStep) / J6StepDeg;

  J7_pos = (J7StepM - J7zeroStep) / J7StepDeg;
  J8_pos = (J8StepM - J8zeroStep) / J8StepDeg;
  J9_pos = (J9StepM - J9zeroStep) / J9StepDeg;

  SolveFowardKinematic();
}



void correctRobotPos() {

  J1StepM = J1encPos.read() / J1encMult;
  J2StepM = J2encPos.read() / J2encMult;
  J3StepM = J3encPos.read() / J3encMult;
  J4StepM = J4encPos.read() / J4encMult;
  J5StepM = J5encPos.read() / J5encMult;
  J6StepM = J6encPos.read() / J6encMult;

  JangleIn[0] = (J1StepM - J1zeroStep) / J1StepDeg;
  JangleIn[1] = (J2StepM - J2zeroStep) / J2StepDeg;
  JangleIn[2] = (J3StepM - J3zeroStep) / J3StepDeg;
  JangleIn[3] = (J4StepM - J4zeroStep) / J4StepDeg;
  JangleIn[4] = (J5StepM - J5zeroStep) / J5StepDeg;
  JangleIn[5] = (J6StepM - J6zeroStep) / J6StepDeg;


  SolveFowardKinematic();

  String sendPos = "A" + String(JangleIn[0], 3) + "B" + String(JangleIn[1], 3) + "C" + String(JangleIn[2], 3) + "D" + String(JangleIn[3], 3) + "E" + String(JangleIn[4], 3) + "F" + String(JangleIn[5], 3) + "G" + String(xyzuvw_Out[0], 3) + "H" + String(xyzuvw_Out[1], 3) + "I" + String(xyzuvw_Out[2], 3) + "J" + String(xyzuvw_Out[3], 3) + "K" + String(xyzuvw_Out[4], 3) + "L" + String(xyzuvw_Out[5], 3) + "M" + speedViolation + "N" + debug + "O" + flag + "P" + J7_pos + "Q" + J8_pos + "R" + J9_pos;
  delay(5);
  Serial.println(sendPos);
  speedViolation = "0";
  flag = "";
}

/////////////////////////////////////////////////////////////////////////////////////////////////////////////////////////////////////////////////////////////////////////////////////////////
//SD CARD
/////////////////////////////////////////////////////////////////////////////////////////////////////////////////////////////////////////////////////////////////////////////////////////////

void writeSD(String filename, String info) {
  SD.begin(BUILTIN_SDCARD);
  const char* fn = filename.c_str();
  File gcFile = SD.open(fn, FILE_WRITE);
  if (gcFile) {
    //Serial.print("Writing to test.txt...");
    gcFile.println(info);
    gcFile.close();
    //Serial.println("done.");
  } else {
    // if the file didn't open, print an error:
    Serial.println("EG");
  }
}

void deleteSD(String filename) {
  SD.begin(BUILTIN_SDCARD);
  const char* fn = filename.c_str();
  SD.remove(fn);
}

void printDirectory(File dir, int numTabs) {
  String filesSD;
  while (true) {

    File entry = dir.openNextFile();
    if (!entry) {
      // no more files
      Serial.println(filesSD);
      break;
    }
    if (entry.name() != "System Volume Information") {
      filesSD += entry.name();
      filesSD += ",";
    }
    entry.close();
  }
}




/////////////////////////////////////////////////////////////////////////////////////////////////////////////////////////////////////////////////////////////////////////////////////////////
//DRIVE LIMIT
/////////////////////////////////////////////////////////////////////////////////////////////////////////////////////////////////////////////////////////////////////////////////////////////

void driveLimit(int J1Step, int J2Step, int J3Step, int J4Step, int J5Step, int J6Step, int J7Step, int J8Step, int J9Step, float SpeedVal) {

  //RESET COUNTERS
  int J1done = 0;
  int J2done = 0;
  int J3done = 0;
  int J4done = 0;
  int J5done = 0;
  int J6done = 0;
  int J7done = 0;
  int J8done = 0;
  int J9done = 0;

  int J1complete = 0;
  int J2complete = 0;
  int J3complete = 0;
  int J4complete = 0;
  int J5complete = 0;
  int J6complete = 0;
  int J7complete = 0;
  int J8complete = 0;
  int J9complete = 0;

  int calcStepGap = minSpeedDelay / (SpeedVal / 100);

  //SET DIRECTIONS
  /// J1 ///
  if (J1CalDir == 1 && J1MotDir == 1) {
    digitalWrite(J1dirPin, HIGH);
  }
  if (J1CalDir == 1 && J1MotDir == 0) {
    digitalWrite(J1dirPin, LOW);
  }
  if (J1CalDir == 0 && J1MotDir == 1) {
    digitalWrite(J1dirPin, LOW);
  }
  if (J1CalDir == 0 && J1MotDir == 0) {
    digitalWrite(J1dirPin, HIGH);
  }
  /// J2 ///
  if (J2CalDir == 1 && J2MotDir == 1) {
    digitalWrite(J2dirPin, HIGH);
  }
  if (J2CalDir == 1 && J2MotDir == 0) {
    digitalWrite(J2dirPin, LOW);
  }
  if (J2CalDir == 0 && J2MotDir == 1) {
    digitalWrite(J2dirPin, LOW);
  }
  if (J2CalDir == 0 && J2MotDir == 0) {
    digitalWrite(J2dirPin, HIGH);
  }
  /// J3 ///
  if (J3CalDir == 1 && J3MotDir == 1) {
    digitalWrite(J3dirPin, HIGH);
  }
  if (J3CalDir == 1 && J3MotDir == 0) {
    digitalWrite(J3dirPin, LOW);
  }
  if (J3CalDir == 0 && J3MotDir == 1) {
    digitalWrite(J3dirPin, LOW);
  }
  if (J3CalDir == 0 && J3MotDir == 0) {
    digitalWrite(J3dirPin, HIGH);
  }
  /// J4 ///
  if (J4CalDir == 1 && J4MotDir == 1) {
    digitalWrite(J4dirPin, HIGH);
  }
  if (J4CalDir == 1 && J4MotDir == 0) {
    digitalWrite(J4dirPin, LOW);
  }
  if (J4CalDir == 0 && J4MotDir == 1) {
    digitalWrite(J4dirPin, LOW);
  }
  if (J4CalDir == 0 && J4MotDir == 0) {
    digitalWrite(J4dirPin, HIGH);
  }
  /// J5 ///
  if (J5CalDir == 1 && J5MotDir == 1) {
    digitalWrite(J5dirPin, HIGH);
  }
  if (J5CalDir == 1 && J5MotDir == 0) {
    digitalWrite(J5dirPin, LOW);
  }
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
    digitalWrite(J8dirPin, LOW);
  }
  if (J8dir == 0 && J8MotDir == 0) {
    digitalWrite(J8dirPin, HIGH);
  }
  /// J9 ///
  if (J9dir == 1 && J9MotDir == 1) {
    digitalWrite(J9dirPin, HIGH);
  }
  if (J9dir == 1 && J9MotDir == 0) {
    digitalWrite(J9dirPin, LOW);
  }
  if (J9dir == 0 && J9MotDir == 1) {
    digitalWrite(J9dirPin, LOW);
  }
  if (J9dir == 0 && J9MotDir == 0) {
    digitalWrite(J9dirPin, HIGH);
  }

  delayMicroseconds(15);

  /////CALC SPEEDS//////
  float calcStepGap;

  //determine steps
  float ACCStep = HighStep * (ACCspd / 100);
  float NORStep = HighStep * ((100 - ACCspd - DCCspd) / 100);
  float DCCStep = HighStep * (DCCspd / 100);

  //set speed for seconds or mm per sec
  if (SpeedType == "s") {
    speedSP = (SpeedVal * 1000000) * 1.2;
  } else if (SpeedType == "m") {
    lineDist = pow((pow((xyzuvw_In[0] - xyzuvw_Out[0]), 2) + pow((xyzuvw_In[1] - xyzuvw_Out[1]), 2) + pow((xyzuvw_In[2] - xyzuvw_Out[2]), 2)), .5);
    speedSP = ((lineDist / SpeedVal) * 1000000) * 1.2;
  }

  //calc step gap for seconds or mm per sec
  if (SpeedType == "s" or SpeedType == "m") {
    float zeroStepGap = speedSP / HighStep;
    float zeroACCstepInc = (zeroStepGap * (100 / ACCramp)) / ACCStep;
    float zeroACCtime = ((ACCStep)*zeroStepGap) + ((ACCStep - 9) * (((ACCStep) * (zeroACCstepInc / 2))));
    float zeroNORtime = NORStep * zeroStepGap;
    float zeroDCCstepInc = (zeroStepGap * (100 / ACCramp)) / DCCStep;
    float zeroDCCtime = ((DCCStep)*zeroStepGap) + ((DCCStep - 9) * (((DCCStep) * (zeroDCCstepInc / 2))));
    float zeroTOTtime = zeroACCtime + zeroNORtime + zeroDCCtime;
    float overclockPerc = speedSP / zeroTOTtime;
    calcStepGap = zeroStepGap * overclockPerc;
    if (calcStepGap <= minSpeedDelay) {
      calcStepGap = minSpeedDelay;
      speedViolation = "1";
    }
  }

  //calc step gap for percentage
  else if (SpeedType == "p") {
    //calcStepGap = (maxSpeedDelay - ((SpeedVal / 100) * (maxSpeedDelay - calcStepGap =)));
    calcStepGap = minSpeedDelay / (SpeedVal / 100);
  }

  //calculate final step increments
  float calcACCstepInc = (calcStepGap * (100 / ACCramp)) / ACCStep;
  float calcDCCstepInc = (calcStepGap * (100 / ACCramp)) / DCCStep;
  float calcACCstartDel = (calcACCstepInc * ACCStep) * 2;

  //set starting delay
  if (rndTrue == true) {
    curDelay = rndSpeed;
    rndTrue = false;
  } else {
    curDelay = calcACCstartDel;
  }

  ///// DRIVE MOTORS /////
  while ((J1cur < J1step || J2cur < J2step || J3cur < J3step || J4cur < J4step || J5cur < J5step || J6cur < J6step || J7cur < J7step || J8cur < J8step || J9cur < J9step) && estopActive == false) {

    ////DELAY CALC/////
    if (highStepCur <= ACCStep) {
      curDelay = curDelay - (calcACCstepInc);
    } else if (highStepCur >= (HighStep - DCCStep)) {
      curDelay = curDelay + (calcDCCstepInc);
    } else {
      curDelay = calcStepGap;
    }



    float distDelay = 60;
    float disDelayCur = 0;


    /////// J1 ////////////////////////////////
    ///find pulse every
    if (J1cur < J1step) {
      J1_PE = (HighStep / J1step);
      ///find left over 1
      J1_LO_1 = (HighStep - (J1step * J1_PE));
      ///find skip 1
      if (J1_LO_1 > 0) {
        J1_SE_1 = (HighStep / J1_LO_1);
      } else {
        J1_SE_1 = 0;
      }
      ///find left over 2
      if (J1_SE_1 > 0) {
        J1_LO_2 = HighStep - ((J1step * J1_PE) + ((J1step * J1_PE) / J1_SE_1));
      } else {
        J1_LO_2 = 0;
      }
      ///find skip 2
      if (J1_LO_2 > 0) {
        J1_SE_2 = (HighStep / J1_LO_2);
      } else {
        J1_SE_2 = 0;
      }
      /////////  J1  ///////////////
      if (J1_SE_2 == 0) {
        J1_SE_2cur = (J1_SE_2 + 1);
      }
      if (J1_SE_2cur != J1_SE_2) {
        J1_SE_2cur = ++J1_SE_2cur;
        if (J1_SE_1 == 0) {
          J1_SE_1cur = (J1_SE_1 + 1);
        }
        if (J1_SE_1cur != J1_SE_1) {
          J1_SE_1cur = ++J1_SE_1cur;
          J1_PEcur = ++J1_PEcur;
          if (J1_PEcur == J1_PE) {
            J1cur = ++J1cur;
            J1_PEcur = 0;
            digitalWrite(J1stepPin, LOW);
            delayMicroseconds(distDelay);
            disDelayCur = disDelayCur + distDelay;
            if (J1dir == 0) {
              J1StepM == --J1StepM;
            } else {
              J1StepM == ++J1StepM;
            }
          }
        } else {
          J1_SE_1cur = 0;
        }
      } else {
        J1_SE_2cur = 0;
      }
    }


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
            if (J8dir == 0) {
              J8StepM == --J8StepM;
            } else {
              J8StepM == ++J8StepM;
            }
          }
        } else {
          J8_SE_1cur = 0;
        }
      } else {
        J8_SE_2cur = 0;
      }
    }


    /////// J9 ////////////////////////////////
    ///find pulse every
    if (J9cur < J9step) {
      J9_PE = (HighStep / J9step);
      ///find left over 1
      J9_LO_1 = (HighStep - (J9step * J9_PE));
      ///find skip 1
      if (J9_LO_1 > 0) {
        J9_SE_1 = (HighStep / J9_LO_1);
      } else {
        J9_SE_1 = 0;
      }
      ///find left over 2
      if (J9_SE_1 > 0) {
        J9_LO_2 = HighStep - ((J9step * J9_PE) + ((J9step * J9_PE) / J9_SE_1));
      } else {
        J9_LO_2 = 0;
      }
      ///find skip 2
      if (J9_LO_2 > 0) {
        J9_SE_2 = (HighStep / J9_LO_2);
      } else {
        J9_SE_2 = 0;
      }
      /////////  J9  ///////////////
      if (J9_SE_2 == 0) {
        J9_SE_2cur = (J9_SE_2 + 1);
      }
      if (J9_SE_2cur != J9_SE_2) {
        J9_SE_2cur = ++J9_SE_2cur;
        if (J9_SE_1 == 0) {
          J9_SE_1cur = (J9_SE_1 + 1);
        }
        if (J9_SE_1cur != J9_SE_1) {
          J9_SE_1cur = ++J9_SE_1cur;
          J9_PEcur = ++J9_PEcur;
          if (J9_PEcur == J9_PE) {
            J9cur = ++J9cur;
            J9_PEcur = 0;
            digitalWrite(J9stepPin, LOW);
            delayMicroseconds(distDelay);
            disDelayCur = disDelayCur + distDelay;
            if (J9dir == 0) {
              J9StepM == --J9StepM;
            } else {
              J9StepM == ++J9StepM;
            }
          }
        } else {
          J9_SE_1cur = 0;
        }
      } else {
        J9_SE_2cur = 0;
      }
    }


    // inc cur step
    highStepCur = ++highStepCur;
    digitalWrite(J1stepPin, HIGH);
    digitalWrite(J2stepPin, HIGH);
    digitalWrite(J3stepPin, HIGH);
    digitalWrite(J4stepPin, HIGH);
    digitalWrite(J5stepPin, HIGH);
    digitalWrite(J6stepPin, HIGH);
    digitalWrite(J7stepPin, HIGH);
    digitalWrite(J8stepPin, HIGH);
    digitalWrite(J9stepPin, HIGH);
    delayMicroseconds(curDelay - disDelayCur);
  }
  //set rounding speed to last move speed
  rndSpeed = curDelay;
}




/////////////////////////////////////////////////////////////////////////////////////////////////////////////////////////////////////////////////////////////////////////////////////////////
//DRIVE MOTORS G
/////////////////////////////////////////////////////////////////////////////////////////////////////////////////////////////////////////////////////////////////////////////////////////////

void driveMotorsG(int J1step, int J2step, int J3step, int J4step, int J5step, int J6step, int J7step, int J8step, int J9step, int J1dir, int J2dir, int J3dir, int J4dir, int J5dir, int J6dir, int J7dir, int J8dir, int J9dir, String SpeedType, float SpeedVal, float ACCspd, float DCCspd, float ACCramp) {

  //FIND HIGHEST STEP
  int HighStep = J1step;
  if (J2step > HighStep) {
    HighStep = J2step;
  }
  if (J3step > HighStep) {
    HighStep = J3step;
  }
  if (J4step > HighStep) {
    HighStep = J4step;
  }
  if (J5step > HighStep) {
    HighStep = J5step;
  }
  if (J6step > HighStep) {
    HighStep = J6step;
  }
  if (J7step > HighStep) {
    HighStep = J7step;
  }
  if (J8step > HighStep) {
    HighStep = J8step;
  }
  if (J9step > HighStep) {
    HighStep = J9step;
  }

  //FIND ACTIVE JOINTS
  int J1active = 0;
  int J2active = 0;
  int J3active = 0;
  int J4active = 0;
  int J5active = 0;
  int J6active = 0;
  int J7active = 0;
  int J8active = 0;
  int J9active = 0;
  int Jactive = 0;

  if (J1step >= 1) {
    J1active = 1;
  }
  if (J2step >= 1) {
    J2active = 1;
  }
  if (J3step >= 1) {
    J3active = 1;
  }
  if (J4step >= 1) {
    J4active = 1;
  }
  if (J5step >= 1) {
    J5active = 1;
  }
  if (J6step >= 1) {
    J6active = 1;
  }
  if (J7step >= 1) {
    J7active = 1;
  }
  if (J8step >= 1) {
    J8active = 1;
  }
  if (J9step >= 1) {
    J9active = 1;
  }
  Jactive = (J1active + J2active + J3active + J4active + J5active + J6active + J7active + J8active + J9active);

  int J1_PE = 0;
  int J2_PE = 0;
  int J3_PE = 0;
  int J4_PE = 0;
  int J5_PE = 0;
  int J6_PE = 0;
  int J7_PE = 0;
  int J8_PE = 0;
  int J9_PE = 0;

  int J1_SE_1 = 0;
  int J2_SE_1 = 0;
  int J3_SE_1 = 0;
  int J4_SE_1 = 0;
  int J5_SE_1 = 0;
  int J6_SE_1 = 0;
  int J7_SE_1 = 0;
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
  if (J9dir == 1 && J9MotDir == 0) {
    digitalWrite(J9dirPin, LOW);
  }
  if (J9dir == 0 && J9MotDir == 1) {
    digitalWrite(J9dirPin, LOW);
  }
  if (J9dir == 0 && J9MotDir == 0) {
    digitalWrite(J9dirPin, HIGH);
  }

  delayMicroseconds(15);

  /////CALC SPEEDS//////
  float calcStepGap;

  //set speed for seconds
  if (SpeedType == "s") {
    speedSP = (SpeedVal * 1000000) * 1.2;
    calcStepGap = speedSP / HighStep;
    if (calcStepGap <= minSpeedDelay) {
      calcStepGap = minSpeedDelay;
      speedViolation = "1";
    }

    //set speed for mm per sec
  } else if (SpeedType == "m") {
    if (SpeedVal >= maxMMperSec) {
      SpeedVal = maxMMperSec;
      speedViolation = "1";
    }
    SpeedVal = ((SpeedVal / maxMMperSec) * 100);
    calcStepGap = minSpeedDelay / (SpeedVal / 100);
    if (calcStepGap <= minSpeedDelay) {
      calcStepGap = minSpeedDelay;
      speedViolation = "1";
    }
  }

  //calc step gap for percentage
  else if (SpeedType == "p") {
    calcStepGap = minSpeedDelay / (SpeedVal / 100);
    if (calcStepGap <= minSpeedDelay) {
      calcStepGap = minSpeedDelay;
      speedViolation = "1";
    }
  }


  ///// DRIVE MOTORS /////
  while ((J1cur != J1step || J2cur != J2step || J3cur != J3step || J4cur != J4step || J5cur != J5step || J6cur != J6step || J7cur != J7step || J8cur != J8step || J9cur != J9step) && estopActive == false) {

    curDelay = calcStepGap;

    float distDelay = 50;
    float disDelayCur = 0;


    /////// J1 ////////////////////////////////
    ///find pulse every
    if (J1cur < J1step) {
      J1_PE = (HighStep / J1step);
      ///find left over 1
      J1_LO_1 = (HighStep - (J1step * J1_PE));
      ///find skip 1
      if (J1_LO_1 > 0) {
        J1_SE_1 = (HighStep / J1_LO_1);
      } else {
        J1_SE_1 = 0;
      }
      ///find left over 2
      if (J1_SE_1 > 0) {
        J1_LO_2 = HighStep - ((J1step * J1_PE) + ((J1step * J1_PE) / J1_SE_1));
      } else {
        J1_LO_2 = 0;
      }
      ///find skip 2
      if (J1_LO_2 > 0) {
        J1_SE_2 = (HighStep / J1_LO_2);
      } else {
        J1_SE_2 = 0;
      }
      /////////  J1  ///////////////
      if (J1_SE_2 == 0) {
        J1_SE_2cur = (J1_SE_2 + 1);
      }
      if (J1_SE_2cur != J1_SE_2) {
        J1_SE_2cur = ++J1_SE_2cur;
        if (J1_SE_1 == 0) {
          J1_SE_1cur = (J1_SE_1 + 1);
        }
        if (J1_SE_1cur != J1_SE_1) {
          J1_SE_1cur = ++J1_SE_1cur;
          J1_PEcur = ++J1_PEcur;
          if (J1_PEcur == J1_PE) {
            J1cur = ++J1cur;
            J1_PEcur = 0;
            digitalWrite(J1stepPin, LOW);
            delayMicroseconds(distDelay);
            disDelayCur = disDelayCur + distDelay;
            if (J1dir == 0) {
              J1StepM == --J1StepM;
            } else {
              J1StepM == ++J1StepM;
            }
          }
        } else {
          J1_SE_1cur = 0;
        }
      } else {
        J1_SE_2cur = 0;
      }
    }


    /////// J2 ////////////////////////////////
    ///find pulse every
    if (J2cur < J2step) {
      J2_PE = (HighStep / J2step);
      ///find left over 1
      J2_LO_1 = (HighStep - (J2step * J2_PE));
      ///find skip 1
      if (J2_LO_1 > 0) {
        J2_SE_1 = (HighStep / J2_LO_1);
      } else {
        J2_SE_1 = 0;
      }
      ///find left over 2
      if (J2_SE_1 > 0) {
        J2_LO_2 = HighStep - ((J2step * J2_PE) + ((J2step * J2_PE) / J2_SE_1));
      } else {
        J2_LO_2 = 0;
      }
      ///find skip 2
      if (J2_LO_2 > 0) {
        J2_SE_2 = (HighStep / J2_LO_2);
      } else {
        J2_SE_2 = 0;
      }
      /////////  J2  ///////////////
      if (J2_SE_2 == 0) {
        J2_SE_2cur = (J2_SE_2 + 1);
      }
      if (J2_SE_2cur != J2_SE_2) {
        J2_SE_2cur = ++J2_SE_2cur;
        if (J2_SE_1 == 0) {
          J2_SE_1cur = (J2_SE_1 + 1);
        }
        if (J2_SE_1cur != J2_SE_1) {
          J2_SE_1cur = ++J2_SE_1cur;
          J2_PEcur = ++J2_PEcur;
          if (J2_PEcur == J2_PE) {
            J2cur = ++J2cur;
            J2_PEcur = 0;
            digitalWrite(J2stepPin, LOW);
            delayMicroseconds(distDelay);
            disDelayCur = disDelayCur + distDelay;
            if (J2dir == 0) {
              J2StepM == --J2StepM;
            } else {
              J2StepM == ++J2StepM;
            }
          }
        } else {
          J2_SE_1cur = 0;
        }
      } else {
        J2_SE_2cur = 0;
      }
    }

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
            if (J8dir == 0) {
              J8StepM == --J8StepM;
            } else {
              J8StepM == ++J8StepM;
            }
          }
        } else {
          J8_SE_1cur = 0;
        }
      } else {
        J8_SE_2cur = 0;
      }
    }


    /////// J9 ////////////////////////////////
    ///find pulse every
    if (J9cur < J9step) {
      J9_PE = (HighStep / J9step);
      ///find left over 1
      J9_LO_1 = (HighStep - (J9step * J9_PE));
      ///find skip 1
      if (J9_LO_1 > 0) {
        J9_SE_1 = (HighStep / J9_LO_1);
      } else {
        J9_SE_1 = 0;
      }
      ///find left over 2
      if (J9_SE_1 > 0) {
        J9_LO_2 = HighStep - ((J9step * J9_PE) + ((J9step * J9_PE) / J9_SE_1));
      } else {
        J9_LO_2 = 0;
      }
      ///find skip 2
      if (J9_LO_2 > 0) {
        J9_SE_2 = (HighStep / J9_LO_2);
      } else {
        J9_SE_2 = 0;
      }
      /////////  J9  ///////////////
      if (J9_SE_2 == 0) {
        J9_SE_2cur = (J9_SE_2 + 1);
      }
      if (J9_SE_2cur != J9_SE_2) {
        J9_SE_2cur = ++J9_SE_2cur;
        if (J9_SE_1 == 0) {
          J9_SE_1cur = (J9_SE_1 + 1);
        }
        if (J9_SE_1cur != J9_SE_1) {
          J9_SE_1cur = ++J9_SE_1cur;
          J9_PEcur = ++J9_PEcur;
          if (J9_PEcur == J9_PE) {
            J9cur = ++J9cur;
            J9_PEcur = 0;
            digitalWrite(J9stepPin, LOW);
            delayMicroseconds(distDelay);
            disDelayCur = disDelayCur + distDelay;
            if (J9dir == 0) {
              J9StepM == --J9StepM;
            } else {
              J9StepM == ++J9StepM;
            }
          }
        } else {
          J9_SE_1cur = 0;
        }
      } else {
        J9_SE_2cur = 0;
      }
    }




    // inc cur step
    highStepCur = ++highStepCur;
    digitalWrite(J1stepPin, HIGH);
    digitalWrite(J2stepPin, HIGH);
    digitalWrite(J3stepPin, HIGH);
    digitalWrite(J4stepPin, HIGH);
    digitalWrite(J5stepPin, HIGH);
    digitalWrite(J6stepPin, HIGH);
    digitalWrite(J7stepPin, HIGH);
    digitalWrite(J8stepPin, HIGH);
    digitalWrite(J9stepPin, HIGH);
    delayMicroseconds(curDelay - disDelayCur);
  }
}


/////////////////////////////////////////////////////////////////////////////////////////////////////////////////////////////////////////////////////////////////////////////////////////////
//MOVE J
/////////////////////////////////////////////////////////////////////////////////////////////////////////////////////////////////////////////////////////////////////////////////////////////
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
