AlfonsusGiovanni/Welding-Arm-Manipulator/Program/STM32 Arm Manipulator Pendant RTOS/MDK-ARM/FlashMem_Driver.c

#include "FlashMem_Driver.h"

uint32_t Flash_Write_Data (uint32_t StartPageAddress, uint32_t *Data, uint16_t numberofwords){

}

void Flash_Read_Data (uint32_t StartPageAddress, uint32_t *RxBuf, uint16_t numberofwords){
	
}
