AlfonsusGiovanni/Welding-Arm-Manipulator/(commit log)

2024-06-12 new update
    [Assem1.SLDASM, Frame PLC.SLDPRT, Single-Line-Power.dxf]
2024-07-10 Library Update
    [6-DOF Inverse Kinematics.dwg, Assem Secondary PCB Case.SLDASM, Bottom Part Pendant.SLDPRT, Frame PLC.SLDPRT, Pendant Case Assem.SLDASM, Secondary PCB Case.SLDPRT, Secondary+PCB+Manipulator.SLDASM, Top Part Pendant.SLDPRT]
2024-07-15 Added Home Menu
    [Top Part Pendant.DXF, Top Part Pendant.SLDPRT, Top Part Pendant.dwg]
2024-07-16 Update home menu & added RS232 handler
    [Top Part Pendant.dwg]
2024-07-20 RS232 library update
    [Bottom Part Pendant.SLDPRT, Pendant Body.SLDPRT, Pendant Case Assem.SLDASM, RS-232+Pendant.SLDASM, Top Part Pendant.SLDPRT]
2024-07-30 Rev: RS232,Menu,EEPROM Added: H7 Version
    [AR4-MK3 kinematic model (standard DH).xlsm, AR4-MK3 motor step calculations.xlsx, Arm Manipulator Base Assem.SLDASM, Assem Secondary PCB Case.SLDASM, Base Manipulator New.SLDPRT, Base Manipulator.SLDPRT, IRB1520ID_WorkRange_rev02_1.DWG, IRB1520ID_rev02_1.DWG]
2024-07-31 Improve Menu Handler
    [Top Part Pendant.dwg]
2024-08-04 Update RS232 & UI Handler
    [Top Part Pendant.dwg]
2024-10-28 Unblocking Serial Handler
    [Analisa Step Terhadap RPM Maksimal.xlsx, Bottom Part Pendant V2 - Back.DXF, Bottom Part Pendant V2 - Front.DXF, Bottom Part Pendant V2 - Isometric.DXF, Bottom Part Pendant V2 -Top.DXF, Bottom Part Pendant V2.SLDPRT, Din Rail-TOL.DXF, MAIN CASE TOP.dxf]
2024-11-13 Update EEPROM Handler
    [Bottom Part Pendant V2.STL, Top Part Pendant V2.SLDPRT, Top Part Pendant V2.STL]
2024-12-29 Latest Update
    [AR4-MK3 kinematic model (standard DH).xlsm, AR4-MK3 motor step calculations.xlsx, Arm1.SLDPRT, Arm2.SLDPRT, Arm3.SLDPRT, Bottom Bracket Part.SLDPRT, Bottom Bracket Part.STL, Dummy Assem.SLDASM]
2025-02-22 Added Angle Distance Control
    [Assembly of Manipulator SV - Front View.DXF, Assembly of Manipulator SV - Isometric View.DXF, Assembly of Manipulator SV - Right View.DXF, Assembly of Manipulator SV - Top View.DXF]
2025-02-22 Fix Angle Move Dir
    [Arm Manipulator.dwg]
2025-02-24 Improve Encoder Handler
    [AR4-MK3 kinematic model (standard DH).xlsm, Arm Manipulator.dwg]
2025-03-10 Kinematics Update
    [AR4-MK3 kinematic model (standard DH).xlsm, Arm Info.xlsx, Arm Manipulator.dwg, Assembly of Arm Manipulator SV UNDIP - Front View.DXF, Assembly of Arm Manipulator SV UNDIP - Isometric View.DXF, Assembly of Arm Manipulator SV UNDIP - Left View.DXF, Assembly of Arm Manipulator SV UNDIP - Top View.DXF, Assembly of Manipulator SV - Front View.DXF]
2025-03-13 Major Update
    [Arm Info.xlsx, Arm Manipulator.dwg, Box Panel TA.dwg]
