AlfonsusGiovanni/Welding-Arm-Manipulator/(notices)

Notices in the files:
Program/STM32 Arm Manipulator/Core/Src/main.c:
Copyright (c) 2024 STMicroelectronics.
All rights reserved.
This software is licensed under terms that can be found in the LICENSE file
Program/STM32 Arm Manipulator H7 RTOS/Core/Inc/main.h:
Copyright (c) 2025 STMicroelectronics.
